KiCad/kicad-library/template/1593K_Enclosure/meta/1593K3B.jpg

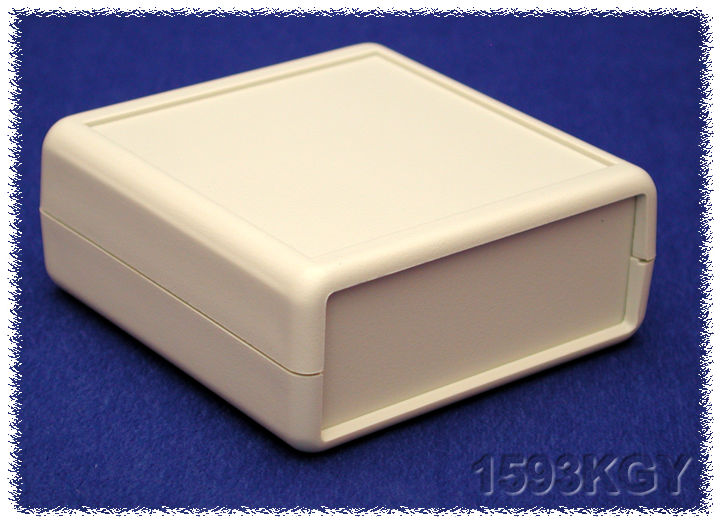
template/1593K_Enclosure/meta/1593K3B.jpg
