KiCad/kicad-library/template/raspberrrypi_hat/meta/brd.png

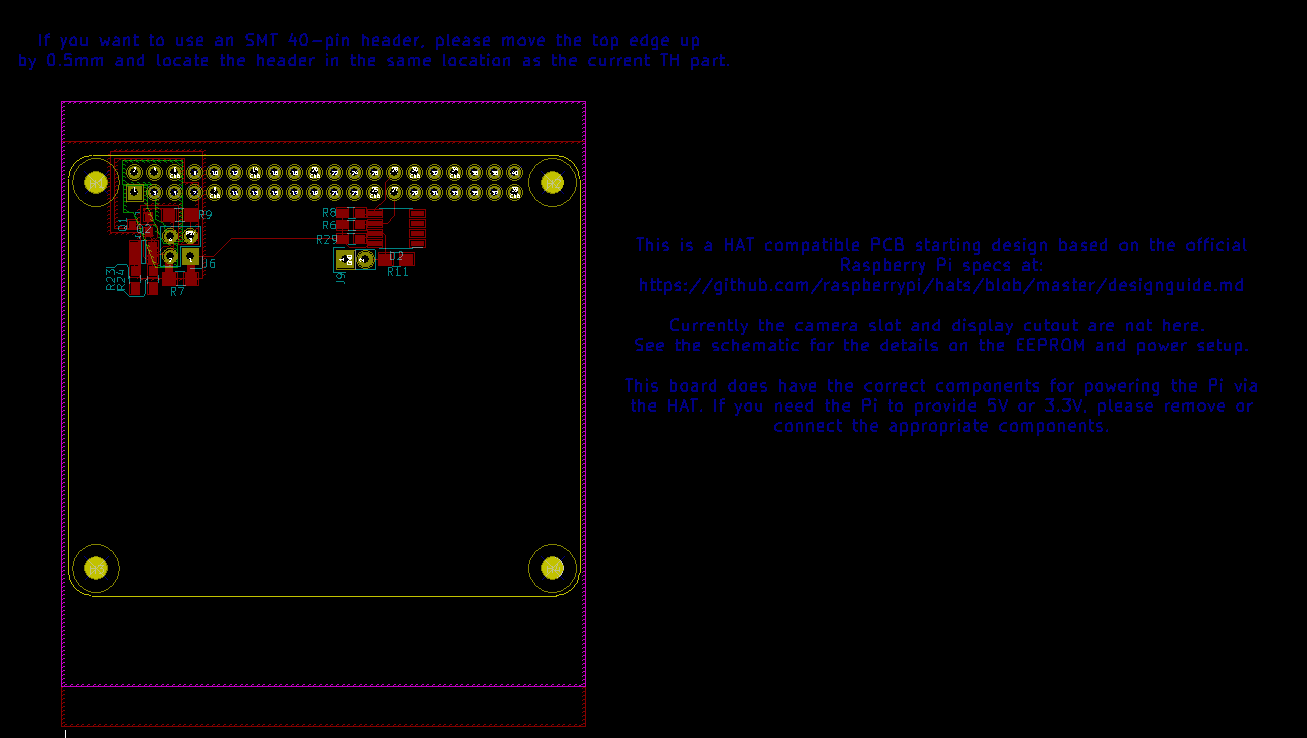
template/raspberrrypi_hat/meta/brd.png
