KiCad/kicad-library/(threads)

Thread 97 (2015-01-10):

Swap CP and CP2 symbol in device.lib

samdolt, 2015-01-10:
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
Currently, default symbol for polarized capacitor is the first symbol on the picture.

- This symbol don't have a "plus" sign and can mislead users.
- IEC60617 standard use the last symbol.

If accepted, I can make the change

reportingsjr, 2015-01-11:
I definitely agree that the first one "CP" should be swapped or even removed. I haven't ever seen that symbol for a polarized capacitor except in KiCad. I have definitely seen the second two quite a lot.

nickoe, 2015-01-11:
Indeed the CP one has always been strange to me, but who cares the others are there.

But in regard to these two pin symbols, they are way too big I think, not to forget that resistors and capacitors are not he same size. Resistors are 500 mil, whilst caps and diodes are 400 mil.

I did make some smaller ones that I used on some project, I can try to dig them up as examples.

samdolt, 2015-01-11:
Is someone uses the first version? If not, maybe it would be better to remove it.

And we can add smaller versions of common symbols such as Rsmall, Csmall, CPsmall.

michal777, 2015-01-11:
If I understood correctly rules 3.1, 3.2 and 3.3 minimum length of capacitor symbol is 400 mils !!!
So big symbols are useless :-(

nickoe, 2015-01-11:
Mmm, where do you see that? Maybe I am looing on the wrong wiki page, but I don't see the bullets numbered with the dot seperator.

https://github.com/KiCad/kicad-library/wiki/Kicad-Library-Convention

michal777, 2015-01-11:
https://github.com/KiCad/kicad-library/blob/master/KiCad_Library_Convention.txt
(3) General Rules for Symbols: 1, 2, 3.

nickoe, 2015-01-11:
Carl, can you comment on this? Could it be time to add an exception for "small" components?

reportingsjr, 2015-01-12:
I will have to say that I have my own library of capacitors, resistors, etc that are far smaller. The default ones are absolutely massive. I would like to hear Carl's opinion on this as well.

CarlPoirier, 2015-01-12:
I too would vote for removing CP.

As for the size of symbols, they indeed can't be smaller than 400mils if we follow the rules, as Michal found out. Maybe we could specify that some rule applies only to black-box components, and have another rule for discrete components?

michal777, 2015-01-12:
I totally agree. The rules 3.1 and 3.2 are good for most of integred circuits, but for resistors, capacitors, transistors etc 50 mil grid is much better.

nickoe, 2015-01-12:
Indeed, the question should then be what size. One should also consider
transistors and double diodes.
Den 12/01/2015 19.24 skrev "CarlPoirier" <notifications@github.com>:

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

samdolt, 2015-01-12:
I think 200 mils for resistances, capacitors and diode would be nice.

@nickoe and @reportingsjr  : What size do you use in your library?

@CarlPoirier : What the rules to ensure compatibility with old design? Can we just resize and commit the symbol with the same name?

CarlPoirier, 2015-01-12:
There is a cache created for the project, containing the parts used. There
is no obligation about resizing.

I like the size of csmall. I'll think about some rule formulation for it.

On Mon, Jan 12, 2015 at 2:14 PM, Samuel Dolt <notifications@github.com>
wrote:

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

CarlPoirier, 2015-01-13:
Here is my suggestion. (Taking care of #101 as well)

3.2. For black-box symbols, pins have a length of 100mil. Large pin numbers can be accomodated by incrementing the width in steps of 50mil.

This way, components with a distinctive shape are not included and might have various pin lengths, but they still have to follow rule 3.1. Resistors and capacitors can thus be 200mil long, such as "csmall".

samdolt, 2015-01-13:
I have made a pull request with some small symbole: https://github.com/KiCad/kicad-library/pull/104

inkblotter, 2015-01-16:
In the real world of kicad schematics parts are whatever size they need to be within that schematic, which may include schematics that have dozens of pages.   Depending on how ones setting for the schematic are, I have used capacitors as small as 40 mils.  Therefore it is silly to create libraries for any of these two pin devices.   A parts wizard should meadiate between those parts that can easily be generated and those fixed size parts that get pulled from libraries, standard or custom.   Ideally, kicad schematics and parts would be in svg and with adaptive pin pitches.  As for the immeadiate issue,  I would never use CP, as it looks like a charge pump to me.  Like others, I have seen CP1 and CP2  used frequently. I would depricate CP and remove it by and by.  I have a slight preference for CP1, being in the US. I associate CP2 with European usage. But either form should be in the 'standard' library, not withstanding my previous comments.

shaneburrell, 2015-03-05:
CP1 is likely the most used, at least in the US. I have only ever seen CP in KICAD and its been a long term annoyance.  CP2 is understandable as well but not what I've seen typically.

CarlPoirier, 2015-03-07:
CP has been eradicated now. Pick whichever of the two symbols left you prefer for your schematics!

Closed 2015-03-07.

Thread 109 (2015-01-24):

move 3d model from unused to relay through hole

andres53016, 2015-01-24:
This 3d models are in the folder unused_3d:
./Relay_ThroughHole_Packages.relay_Finder_34Point51Point7.wings
./Relay_ThroughHole_Packages.Relay_SPDS_OMRON-G6E.wrl
./Relay_ThroughHole_Packages.RELAY_SANYOU_SRD_Series_Form_C.wings
./Relay_ThroughHole_Packages.relay_Finder_34Point51.wrl
./Relay_ThroughHole_Packages.RELAY_SANYOU_SRD_Series_Form_C.wrl
./Relay_ThroughHole_Packages.Relay_SPDS_OMRON-G6E.wings
./Relay_ThroughHole_Packages.relay_Finder_34Point51.wings
./Relay_ThroughHole_Packages.relay_Finder_34Point51Point7.wrl
and the respective footprint are in https://github.com/KiCad/Relays_ThroughHole.pretty, how I can fix this.

michal777, 2015-01-24:
There was some broken links, eg. Relay_SANYOU_SRD_Series_Form_C.kicad_mod lost its 3d model with commit: https://github.com/KiCad/Relays_ThroughHole.pretty/commit/25d6fb88be865b4e6ba77ea21eaaa3cbeeb7eb7f

If you want to fix it, please move the 3d models to kicad-library/modules/packages3d/Relays_ThroughHole/ then rename these .wings/.wrl files to match names of footprints and add relative links to footprints in footprint editor (set proper scale, offset, rotation if necessary).

Before renaming 3d models it would be good to rename footprints (name and reference):
Relays->Relay; Relais->Relay; bistabil->bistable

andres53016, 2015-01-28:
thanks, I create the pull requests

CarlPoirier, 2015-02-15:
Corresponding pull request is #110

CarlPoirier, 2015-02-23:
This got fixed.

Closed 2015-02-23.

Thread 115 (2015-02-03):

3D Module Scaling Errors

stambaughw, 2015-02-03:
The following 3D models require scaling to fit properly on the board:

SMD_Packages/SOT-23-6.wrl
SMD_Packages/SOT-23-5.wrl
SMD_Packages/SOIC-14_N.wrl
Diodes_SMD/Diode-SMA_Standard.wrl

I'm sure there are others as well.  I think it's important for our user's that they not have to rescale the 3D models to fit their boards.

Thanks,

Wayne

CarlPoirier, 2015-02-03:
There is a similar issue on Github. I flagge these as well. No one had
gotten to it, but I'll try soon.

On Tue, Feb 3, 2015 at 5:00 PM, Wayne Stambaugh <notifications@github.com>
wrote:

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

stambaughw, 2015-02-03:
No hurry.  I just would like to have this cleaned up by the next stable
release which hopefully will be around the June/July time frame.

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

CarlPoirier, 2015-02-23:
Can someone double check SMD_Packages/SOIC-14_N and Diodes_SMD/Diode-SMA_Standard? Both seem fine on my end. I did fix the SOT-23*.

stambaughw, 2015-02-24:
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
Attached are screen shots of the attached 3d model.  One is scaled to
1/2.54cm and on is unscaled (1).  Both are incorrect AFAICT.  I just did
a git pull and reinstall yesterday unless I did something wrong.

keruseykaryu, 2015-02-24:
I didn't check that recently, but does this issue is still up to date for SOIC-14_N?
https://github.com/KiCad/kicad-library/issues/49

CarlPoirier, 2015-02-25:
I'm sorry Wayne but everything seems fine here. Github plugin activated, kicad-library on master. I don't see your screenshots, so let me upload one.

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

SOIC-14_N is alright as well.

stambaughw, 2015-02-25:
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
I just did a fresh clone using:

git clone https://github.com/KiCad/kicad-library.git

Then I changed the 3D package absolute path to point directly at
SMD_Packages/SOIC-14_N.wrl rather than using CMake to install and I
still get the same thing.  You haven't done a local checkout on your
branch and forgot to merge the changes into the master branch have you?
 Please send me a copy of your SOIC-14_N.wrl file so I can do a diff.

CarlPoirier, 2015-02-26:
No, I did a fresh clone as well! I don't understand either what's
happening. I'll send you the ,wrl and .kicad_mod files for the SOIC-14_N on
your personal email.

On Wed, Feb 25, 2015 at 11:58 AM, Wayne Stambaugh <notifications@github.com>
wrote:

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

CarlPoirier, 2015-03-02:
The issue has been confirmed to not exist anymore with the most recent revision of kicad-library and the latest footprints.

Closed 2015-03-02.

Thread 128 (2015-02-24):

Housing_DFN_QFN silkscreen looks strange

madworm, 2015-02-24:
Were these footprints machine created?

Especially with the smaller devices (e.g. DFN-10), the silkscreen looks really strange, pretty ugly, asymmetric...

madworm, 2015-02-24:
Wrong repo --> invalid.

Closed 2015-02-24.

Thread 135 (2015-03-05):

Author agrees to use his work

timofonic, 2015-03-05:
Hello.

I'm not sure if this is the best way to point to this, probably not.

The author of these libraries agreed to be merged to the official ones if there's license compatibility.

http://smisioto.no-ip.org/elettronica/kicad/kicad-en.htm

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

There's lots of KiCad libraries, but they are on different firms. I would love that KiCad can have a very complete library, but I know managing a big library and make people to merge can be a very difficult task.

Regards.

shaneburrell, 2015-03-05:
Is this going to happen? Anyone working on it?

michal777, 2015-03-05:
Some of the libraries are in official KiCad libraries (but 3d models could be upgraded), some of them can be added and others may conflict with our libraries (we don't want duplicates). It's a lot of work to add this content without creating much bigger mess than we have. If somebody will work on it probably the libraries or their parts will be added one by one, not all. Then they will require some corrections according to kicad library convention and to link 3d models properly.
I don't know if there is somebody working on it, probably not.

SchrodingersGat, 2015-11-09:
I have adapted a few of the footprints and models from his website to match KLC and such.

Terminal Blocks
A number of the terminal blocks have been added here:
https://github.com/KiCad/Terminal_Blocks.pretty
Pheonix PT
Pheonix MPT
Pheonix MKDS

Socket strips:
The 2.00mm pitch socket strips have been added to the Socket_Strips.pretty repo (pull request currently open)
https://github.com/KiCad/Socket_Strips.pretty/pull/4

Pin Headers:
Same as above:
https://github.com/KiCad/Pin_Headers.pretty/pull/10

Hirose DF13 connectors
https://github.com/SchrodingersGat/Connectors_Hirose.pretty
Note: This is at the moment just in my personal repo. I am happy for this to be used by github.com/KiCad/ freely

SchrodingersGat, 2015-11-09:
Oh and also, my JST library

https://github.com/SchrodingersGat/Connectors_JST.pretty

Same as above. Very happy for this to be integrated into master repo. Also happy to assist with KLC compliance as required.

pointhi, 2015-11-24:
For JST I want to say there is already a pull request for all JST PH and JST SH connectors, made by me: #296

SchrodingersGat, 2016-12-06:
Closing due to inactivity

Closed 2016-12-06.

Thread 155 (2015-03-18):

Diodes symbols

ricardocrudo, 2015-03-18:
I started to working in changing the diode symbols, as it was said here: https://github.com/KiCad/Diodes_SMD.pretty/pull/6
Now I have a doubt about the D_Schottky_x2_KCom and D_Schottky_x2_Serial diodes.
The current pinout for those symbols are, respectively:
A1,K,A2 <-> 1,2,3
A,AK,K <-> 1,2,3
But, I've used parts which have the following pinout:
A1,K,A2 <-> 1,3,2
A,AK,K <-> 1,3,2
My question is how to manage this, create new symbols with this alternative pinout? If so, how to name them?

Now talking about all diodes, i.e. regular diode, schottky, zener..., would be better use letters in the pin number field instead of numbers? In this way I think is possible to solve the pinout variations and prevent possible mistakes.

michal777, 2015-03-18:
Letters in pin numbers would break rule 6.8. AFAIK for general symbols there should be more symbols with different pin numbering. Look at transistors in device.lib ("Q_..."). 3-pin packages have their standard pin numbering so don't care about schematic symbols for them. 2-pin diodes should have pin 1 assigned to cathode. Then they will match standard numbering of DO-... packages and two pin TO-... packages (it seems that most of / all manufacturers use pin 1 of these packages as cathode).

CarlPoirier, 2015-03-22:
Exactly.

CarlPoirier, 2015-04-24:
Everything has been merged. @keruseykaryu, can you announce the change on the users group?

keruseykaryu, 2015-04-24:
Done.
https://groups.yahoo.com/neo/groups/kicad-users/conversations/messages/19990

CarlPoirier, 2015-04-24:
Thanks! I'm closing this issue now.

Closed 2015-04-24.

Thread 162 (2015-03-25):

Move 3D packages into .pretty repos

alexforencich, 2015-03-25:
Having the 3D packages and footprints in separate repos is a recipe for Bad Things.  It would be much easier to manage footprints and 3D packages if the footprints and corresponding packages are managed in the same repo.  Note that this will require modifications to how Kicad locates 3D packages - it must me modified to also search for the 3D package relative to the footprint file first.  This will also enable 'self-contained' footprint libraries with 3d packages to be used without being forced to use absolute paths or install them with the system kicad library.

CarlPoirier, 2015-03-26:
Hi,

There was a conversation about this subject a while ago. Have a read here:

https://lists.launchpad.net/kicad-developers/msg14793.html

Fat-Zer, 2015-05-17:
What about moving it out from the kicad-library repo?
IMO It doesn't make a lot of sense to store them nearby the schematic...

Bitbored, 2016-01-05:
I agree with this. I think it makes some sense to keep footprints and 3d packages together, since they are related most of the time (apart from some strange parts with a common footprint but a weird 3D shape).

I understand there might be good reasons to keep the 3D files and foortprints separate, but having the 3D files and symbols together in the same repo doesn't make a lot of sense.

Can we continue this discussion here, or is the mailing list or launchpad the preferred channel?

alexforencich, 2016-01-05:
There are a whole bunch of architectural issues in kicad that need to be fixed, and this is one of them.  Or at least related to it.  There is no search path for 3D packages right now, or at least the last time I checked.  Kicad only looks in one spot for the packages, this needs to be extended so that several locations are tried (e.g. same folder as the footprint in question).  Until this is fixed, the 3D packages cannot be moved.

reportingsjr, 2016-01-05:
I believe Cirilo Bernardo's work (
https://code.launchpad.net/~cirilo-bernardo/kicad/3d_initial_merge ) should
solve that issue Alex. Hopefully it will be merged in the next month or two.

On Tue, Jan 5, 2016 at 5:51 PM Alex Forencich <notifications@github.com>
wrote:

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

alexforencich, 2016-01-05:
Looking forward to it.  Kicad has a lot of promise, but also a lot of issues.

Shackmeister, 2017-06-13:
@alexforencich Hi Alex, a seperate packages3D repo has now been made and is on it's way to be supported in kicad directly. According to KLC $kisysmod3D is now being added to all footprints.
Can you please close this issue if its not relevant any more?

Shackmeister, 2017-07-01:
@alexforencich ill close this now, please let me know if you think it shouldn't be

seppestas, 2017-07-04:
Mmh, this issue states "move 3D packages into .pretty repos", not "move 3D packages in separate repo", so IMO the discussion is still open...

I understand moving the 3D packages in the .pretty repos requires a big architectural overhaul of KiCad's 3D model system and probably of the footprint system, but I think it still makes sense since the footprints reference the 3D models and typically footprints and 3D models are pretty related.

There are a lot of benefits in having the 3D models in a separate repo though. This could make it easier to override the 3D model for a footprint in different projects.

An example case: I have a design that uses [Neutrik NMJ4HCD2](http://www.neutrik.com/en/audio/plugs-and-jacks/m-series/nmj4hcd2) connectors. This connectors has the same footprint as the [Neutrik NMJ4HFD2](http://www.neutrik.com/en/audio/plugs-and-jacks/m-series/nmj4hfd2) connector but a different 3D model. It would be nice if KiCad would easily allow changing the 3D model without changing the 3D model so I can easily switch to using the NMJ4HFD2.

I have a few ideas on how this use-case could be supported:

- Enumerate compatible 3D files in the footprint and make the project/layout file store wich one should be used. Currently it is possible to list multiple 3D files per footprint, but KiCad combines them instead of giving the option to select one.
- Use a more generic name for the 3D file and change the path(s) to the location of the 3D files on a per-project basis (e.g by using an environmental variable in the 3D file path that can be set in the project). This is where having the 3D models in a separate repo makes sense.

poeschlr, 2017-07-04:
As far as i understand it, in future the number of repos will be reduced drastically. We will (hopefully) move away from the one repo per lib nonesense.
In such a case including the 3d files in the same repo as the footprints only makes sense if we also include the symbols and basically everything else into the same repo. (everything else would confuse users because they do not know how to find stuff.)
My vote would be on: One repo for symbols, one for footprints, one for 3d models, one for templates, ...

Issue https://github.com/KiCad/kicad-library/issues/1360 evolved into discussing exactly that.

seppestas, 2017-07-04:
Personally I prefer the multi-repo approach, I just think it misses some kind of automatic way to download / version pin the repositories. The current implementation of the Github downloader is fairly inconsistent and doesn't really work when using anything but the official KiCad libraries.

Having multiple smaller repo's allows to more easily fork the repo's you want to add custom stuff to while allowing you to keep using the original repos for other footprints.

I don't see why having the symbols in the same repo is a requirement for having the 3D files in the footprint repos. For my personal projects I typically don't even use the symbols anymore thanks to [SKiDL](https://github.com/xesscorp/skidl).

alexforencich, 2017-07-04:
Honestly, I don't really care where the 3D packages go.  It just makes no sense to keep them in the same repo as the symbols when the footprints are in their own repo, considering the 3D packages are referenced by the footprints and not the symbols.

And in terms of version pinning, that should be avoided entirely by switching to an Eagle like library format where the symbols and footprints are physically stored in the same file, eliminating the potential for any discrepancies between the footprints and symbols.

SchrodingersGat, 2017-07-04:
> And in terms of version pinning, that should be avoided entirely by switching to an Eagle like library format where the symbols and footprints are physically stored in the same file, eliminating the potential for any discrepancies between the footprints and symbols.

Whether or not this would be a good idea, this is not the way that the KiCad libraries work now or will work in the future. I don't think there's much sense trying to debate this in a post here.

> Mmh, this issue states "move 3D packages into .pretty repos", not "move 3D packages in separate repo", so IMO the discussion is still open...

The 3D models will only (in future) be located in the `packages3d` repository. This issue is definitely closed :)

poeschlr, 2017-07-05:
@seppestas wrote:
> Personally I prefer the multi-repo approach, I just think it misses some kind of automatic way to download / version pin the repositories.

Be a librarian for a week and tell us if you still like it ;)

shaise, 2017-07-29:
I really think seppestas request is extremely useful and reasonable. As others, I maintain a library of my own with footprints not available in the default library. Having the 3D models inside the pretty folder, makes it much easier when I want to share my library with others, or when I edit my project on a different PC.

Closed 2017-07-04.

Thread 163 (2015-03-25):

Library arduino

pouic13, 2015-03-25:
Hello evryone,<br> I made a library who contain most popular arduino board. It's contain .mod, .pretty, 3D views and shematics. It must be corrected but it exit.<br>You can download the full library on kicad forum URL: https://forum.kicad.info/t/library-for-shield-arduino/482 <br> Or on my blog URL: http://meta-blog.eklablog.com/kicad-librairie-arduino-pretty-p930786 <br> On my blog you have a prewiew that contain the library.<br>This is the first time i use github and i don't understan how it workd and to cap it all i'm french. So be indulgent :)

michal777, 2015-03-25:
In this thread:
https://forum.kicad.info/t/library-for-shield-arduino/482/8
I suggested creating issue because I don't know much about arduino and templates in kicad but I guess that it would be better to make templates based on this library and it should be discussed here.

keruseykaryu, 2015-03-26:
> (...) it would be better to make templates based on this library (...)
Exactly. Templates were designed just for that.
KiCad Manager manual gives the guidelines how to prepare complete template.

pouic13, 2015-03-26:
ok i'will watch how to creat a template.

keruseykaryu, 2015-03-26:
> But where i found " KiCad Manager manual " ?

Open KiCad and call Help -> Contents. Page 6.

pouic13, 2015-03-26:
I don't have file in Help. I use arch linux and i install paquet kicad-bzr and kicad-library-bzr. But in /usr/share/kicad/ i have only /demos, /library, /modules, /template and not /help or looks like help directory. Can I find it at an another place?

nickoe, 2015-03-26:
http://www.kicad-pcb.org/display/KICAD/KiCad+Documentation

pouic13, 2015-03-26:
Thank nickoe. <br>But just to be sure, i do made one template per one shield ?<br> so for my library: 7 for shield with no contour + 7 for shield with contour ?

michal777, 2015-03-26:
I'd suggest to create 7 templates, one for each shield. Contour should be drawn on Edge.Cuts layer as it is in template of shield for raspberry.

pouic13, 2015-03-26:
ok rooo f**k (sorry)

pouic13, 2015-03-30:
Hello, i start to redraw my library and i want to know, how i do orginise my project for summit a pullrequest? My lybrairie Template have got this structure: in file Template you have 7 directorys who each contain 1 complete board. i create a directory for modules who i use in template and i have an other directory for 3D view in relation whith modules. I keep this structure? or do I place directory "module" and "3D" in directory of "Template of each board" ?  An other question what size "edge.cuts" an "Dwgs.user" do have?

michal777, 2015-03-30:
> An other question what size "edge.cuts" an "Dwgs.user" do have?
There are no rules but I think 0.15 mm will be ok (the same as silkscreen).

You don't need to attach *.pretty footprints because they can be extracted from *.kicad_pcb (board).
You don't need to attach schematic library but there should be correct -cache.lib in project directory.
It's possible to use ${KIPRJMOD} to use 3d models existing in project directory. Example of path in *.kicad_pcb file:
```
    (model ${KIPRJMOD}/Socket_Arduino.3dshapes/Socket_header_Arduino_1x08.wrl

pouic13, 2015-03-30:
Thank micha777 it's work great for 3D views.
I place anyway *.pretty. I think it's good to keep a directory in template where you can change/place other footprint if they are propose do not correspond.
Ok know my first board is ready! i have correct edge cuts and meta are ok i'will try to summit a pull request...

CarlPoirier, 2015-04-24:
The templates for the Arduino boards made by @pouic13 have been merged.

giogziro95, 2017-05-25:
Hi, everyone.

Which library has this been added to? I can't find one. It's not available in my KiCad install either.

@jonathan-iap Thanks for your awesome work.

giogziro95, 2017-05-25:
Oh, [here they are](https://github.com/KiCad/kicad-library/tree/master/template).

Closed 2015-04-24.

Thread 169 (2015-04-01):

Missing SMD diode footprints

cb88, 2015-04-01:
Currently 1206, 1210, 805, 603, parts etc... are missing. Currently on my boards I just use a resistor footprint however this lacks polarity indication for manufacturing.

samdolt, 2015-04-01:
In SMD_Packages.pretty, you can find
* SMD-1206_Pol.kicad_mod
* SMD-1210_Pol.kicad_mod
* SMD-2010_Pol.kicad_mod
* SMD-2112_Pol.kicad_mod
* SMD-2512_Pol.kicad_mod
* SMD-4032.kicad_mod

0403, 0805 and 0603 seems to be missing.

samdolt, 2015-04-01:
@keruseykaryu I propose to delete these file and to put a copy in to Diodes_SMD and Capacitors_SMD with CP_* and D_* name. I think footprint filter in device.lib should be already correct, but it's better to verify.

I can handle that later this week if you're ok.

keruseykaryu, 2015-04-03:
> I propose to delete these file and to put a copy in to Diodes_SMD and Capacitors_SMD with CP_* and D_* name.

I think you should ask Carl or Michal. Footprint libraries isn't my major interest here.

samdolt, 2015-04-03:
@CarlPoirier What do you think?

michal777, 2015-04-03:
The SMD-****_Pol.kicad_mod can be moved if these polarised diodes and capacitors really exist.
Polarised tantalum capacitors are in separate library and they have different naming standard.
Diodes in this kind of packages are not popular (I found in some shop: 0603, 0805 and 1206, bigger diodes are usually SOD..., DO..., SM* etc).
What's more, they should be improved to meet kicad library convention and IPC-7351C.

cb88, 2015-04-03:
Diodes like this are useful for small boards and are always polar... Think Arduíno nano etc.....

Also on my boards I just standardized on 805 and 603 partes where i could as these are about as small of a discret component as I care to solder.

All my caps this size are ceramic so wouldn't matter.

michal777, 2015-04-03:
Are you sure the diodes aren't minimelf, micromelf or SOD...?

cb88, 2015-04-03:
Sure .... But that doesn't mean you can't get them in standard sizes. Plenty non melf or sod parts on digikey or Newark etc...

CarlPoirier, 2015-04-08:
A quick look on Digikey reveals zener diodes in 402, 503, 603, 805, 1005, 1206.

The packages can be moved and eliminated from SMD_Packages.pretty. One step closer to remove this to vague library!

Shackmeister, 2017-06-12:
@cb88 I believe this has been solved since, could you close this issue if you agree?

cb88, 2017-06-12:
Yes it appears that it has been resolved thought I am currently using a resistor + silkscreen polarity indication manually (tisk tisk) . As the standard sized SMD components now exist in Diodes_SMD.

Closed 2017-06-12.

Thread 172 (2015-04-09):

Part 74LS51 in 74xx.lib has wrong symbol and wrong pin assignment

onitake, 2015-04-09:
The circuit library 74xx.lib shipped with KiCAD contains an entry for the 74LS51 logic gate part. According to the respective data sheet, this part is wrong. Neither the gate symbol nor the pin assignment reflect the actual part.

74xx.lib shows the part as a dual 2x2 input AND/OR combined gate, while the 74LS51 contains one 3x2 and one 2x2 gate. Only the 7451 and 74S51 parts do not have the additional inputs. Also, the output pin of part B is number 8, not 9 as in the library.

Strictly speaking, part A and part B also swapped, but this has no functional relevance.

Texas Instruments offers a data sheet for this part here: http://www.ti.com/lit/ds/symlink/sn74ls51.pdf

I'm attaching a new version I just made for myself. Copyright notice: Anyone may use it under the same terms as the KiCAD libraries. Credit is not required. See the gist here: https://gist.github.com/onitake/a9a597a250e2ec580945

onitake, 2015-04-09:
EESchema-LIBRARY Version 2.3  Date: Thu 09 Apr 2015 02:01:50 CEST
#encoding utf-8
#
# 74LS51
#
DEF 74LS51 U 0 10 Y Y 2 F N
F0 "U" 200 250 60 H V C CNN
F1 "74LS51" 300 -250 60 H V C CNN
F2 "~" 0 0 60 H V C CNN
F3 "~" 0 0 60 H V C CNN
$FPLIST
 DIP-14*
$ENDFPLIST
DRAW
X GND 7 -50 -275 0 U 60 60 0 0 W N
X VCC 14 -50 275 0 D 60 60 0 0 W N
A -50 -150 125 -899 899 0 1 0 N -50 -275 -50 -25
A -50 150 125 -899 899 0 1 0 N -50 25 -50 275
A 75 0 146 -590 590 0 1 0 N 150 -125 150 125
A 170 -148 274 941 327 0 1 0 N 150 125 400 0
A 170 148 274 -941 -327 0 1 0 N 150 -125 400 0
P 4 0 1 0  -50 -25  -150 -25  -150 -275  -50 -275 N
P 4 0 1 0  -50 25  -150 25  -150 275  -50 275 N
P 4 0 1 0  75 -150  125 -150  125 -75  200 -75 N
P 4 0 1 0  75 150  125 150  125 75  200 75 N
X ~ 1 -450 250 300 R 50 50 1 1 I
X ~ 8 700 0 300 L 60 60 1 1 O I
X ~ 9 -450 -50 300 R 60 60 1 1 I
X ~ 10 -450 -150 300 R 60 60 1 1 I
X ~ 11 -450 -250 300 R 60 60 1 1 I
X ~ 12 -450 150 300 R 60 60 1 1 I
X ~ 13 -450 50 300 R 60 60 1 1 I
X ~ 2 -450 250 300 R 50 50 2 1 I
X ~ 3 -450 50 300 R 60 60 2 1 I
X ~ 4 -450 -50 300 R 60 60 2 1 I
X ~ 5 -450 -250 300 R 60 60 2 1 I
X ~ 6 700 0 300 L 60 60 2 1 O I
ENDDRAW
ENDDEF
#
#End Library

ricardocrudo, 2015-04-29:
@onitake I just commit a fix using your symbol plus small adjusts. Thanks for reporting.

The symbol is violating the KLC but I did commit because it's bug.

onitake, 2015-04-30:
I did not know about the [KLC](https://github.com/KiCad/kicad-library/wiki/Kicad-Library-Convention).

Thanks for pointing that out, I will try to follow it in the future.

felipesanches, 2016-06-28:
I also noticed this bug when looking for the 74LS50 which is missing in KiCAD. Should I report an issue about it separately?

Also, I'm using the stable debian kicad package in Trisquel GNU/Linux. In order to make my work easily accessible to users, I'm not willing to make my schematics only viewable with a git build of Kicad. To acchieve that, should I add the missing symbol as a custom library in my project's git repo?

felipesanches, 2016-06-28:
oh! I just noticed that the part I need is actually the 7451 instead of the 74LS51. The difference is that the 7451 does not have the third AND-input in the first combination of gates. The 7451 is still lacking in kicad libraries.

felipesanches, 2016-06-28:
My drawing of the 7451 is available at: https://gitlab.com/fsanches/PatinhoFeio_KICAD/tree/master/libs

diggit, 2016-07-06:
>Also, I'm using the stable debian kicad package in Trisquel GNU/Linux. In order to make my work easily accessible to users, I'm not willing to make my schematics only viewable with a git build of Kicad. To acchieve that, should I add the missing symbol as a custom library in my project's git repo?

Hi @felipesanches, once you add symbol to schematic, symbol is saved in cache. When symbol from source library becomes unavailable, KiCad tells you about it and switches to cached par AFAIKt. You can ship source library with project too...

Closed 2015-04-29.

Thread 173 (2015-04-09):

wrong 3d model

andres53016, 2015-04-09:
The 3d models Diode_LED_3mm_round_vertical and Diode_LED_5mm_round_vertical In kicad-library/modules/packages3d/Diodes_ThroughHole.3dshapes/ are DO-35 and the LED have own directory.
Can I delete this?
And replace the current 3d model for the mentioned in issue #135

CarlPoirier, 2015-04-19:
The 3d model path should be placed in a folder named the same as the pretty library. What do you mean by "the LED have own directory" ?

michal777, 2015-04-19:
@CarlPoirier
The 3d models assigned to the footprints are wrong (DO-35 instead of 5mm led) and the LEDs in Diodes_ThroughHole.pretty are duplicates of the leds that are in LEDs.pretty.
So I think it's good idea to remove the duplicates with wrong models.

CarlPoirier, 2015-04-19:
Aah I wasn't sure what he meant with the directory issue. Indeed, @andres53016, go ahead and we'll approve your pull request.

andres53016, 2015-04-20:
Hi I created #178 https://github.com/KiCad/LEDs.pretty/pull/4 https://github.com/KiCad/Diodes_ThroughHole.pretty/pull/7

CarlPoirier, 2015-05-02:
This issue is fixed. Thanks @andres53016.

Closed 2015-05-02.

Thread 176 (2015-04-15):

Discret:TO92DGS has pins ordered SGD

strykeroz, 2015-04-15:
Hi,

Please correct me if I'm wrong, but this appears to have D & S pins swapped.
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

Geoff

ricardocrudo, 2015-04-15:
Where does this footprint come from? Which .pretty directory?

strykeroz, 2015-04-15:
According to my library table, ${KIGITHUB}/Discret.pretty should be the source.
This is from a recent launchpad build, 2015-04-09 BZR5589

ricardocrudo, 2015-04-15:
It's named as DGS, since the square pin is the first, it seems right, though, it's violating some KLC rules.

michal777, 2015-04-15:
TO-92 packages that meet KiCad Library Convention rules are in: Housings_TO-92.pretty
This one is going to be removed (when somebody will find some time to sort out Discret.pretty).

strykeroz, 2015-04-15:
The schematic symbol for the BS170 MOSFET in the transistors library has pads D-G-S however all TO-92 packages in Housings_TO-92.pretty currently have pads 1-2-3.  Choosing any of those footprints results in no ratsnest to the BS170 footprint.

michal777, 2015-04-15:
This is because schematic symbol is also bad and should be improved to use standard numbering.

ricardocrudo, 2015-04-15:
The BS170 that I have here, from transistors lib, is numbered from 1 to 3. Did you install your libraries manually or from your distro repo (in the case that you are using linux)?

strykeroz, 2015-04-15:
Interesting.  This was a version made last week using the repo through kicad-winbuilder.  I'll update and report here if it changes.

ricardocrudo, 2015-04-15:
Is that kicad-winbuilder for libraries or the KiCad program?

strykeroz, 2015-04-15:
It downloads everything.  A search for transistors.lib only shows the instances in the source files it has downloaded and the KiCad directory tree it creates.  There are no other copies on this PC.  I will archive the KiCad build I used for the above, and rebuild.

strykeroz, 2015-04-15:
I archived the existing build to a 7z, deleted the directory and rebuilt.  No errors but the version number curiously remains the same.  As does the component in eeschema:
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

strykeroz, 2015-04-15:
Further, as expected, when importing .cmp into Pcbnew, the following errors:
*** Error: Component 'Q1' pad 'D' not found in footprint 'Housings_TO-92:TO-92_Molded_Wide_Oval' ***
*** Error: Component 'Q1' pad 'G' not found in footprint 'Housings_TO-92:TO-92_Molded_Wide_Oval' ***
*** Error: Component 'Q1' pad 'S' not found in footprint 'Housings_TO-92:TO-92_Molded_Wide_Oval' ***

ricardocrudo, 2015-04-15:
That's odd. Could you paste your netlist and cmp files at pastebin?

keruseykaryu, 2015-04-16:
@strykeroz: Please remove project library cache, reopen schematic, recreate netlist and pass through CvPcb again.

strykeroz, 2015-04-16:
@keruseykaryu you are correct.  This is now solved as being my project library cache issue.

Closed 2015-04-16.

Thread 179 (2015-04-22):

SOT-23 footprints in Diodes_SMD appear to have incorrect spacing.

stambaughw, 2015-04-22:
I was reviewing a board layout that I just did and noticed that the spacing between pins 1 and 2 is too narrow for footprints Diode_SOT23 and Diode_SOT23_handsoldering in the Diodes_SMD library.  The current spacing is 1.6mm but every document I could find specifies 1.9mm.  Both footprints should be reviewed for accuracy.

ricardocrudo, 2015-04-22:
Indeed. I can fix this in the pull request: KiCad/Diodes_SMD.pretty#6

ricardocrudo, 2015-04-22:
I just remember that SOT-23 is duplicated in KiCad/Housings_SOT-23_SOT-143_TSOT-6.pretty. This last one contain has the footprint with the correct values.

ricardocrudo, 2015-04-22:
@michal777 @CarlPoirier, which one should be removed?

stambaughw, 2015-04-22:
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

That's fine but we should probably remove the incorrect footprints for
the Diodes_SMD library.

stambaughw, 2015-04-22:
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

Diode_SOT23 and Diode_SOT23_Handsoldering should both be removed from
the Diodes_SMD library.

CarlPoirier, 2015-04-22:
Thanks Wayne for reporting this. Let's remove the footprints from
Diodes_SMD and keep the ones from Housings_SOT-23_SOT-143_TSOT-6.pretty.

On Wed, Apr 22, 2015 at 11:49 AM, Wayne Stambaugh <notifications@github.com>
wrote:

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

CarlPoirier, 2015-04-22:
Creating a _HandSoldering version from the correct footprint would be great
however. Else we lose that footprint.

Ricardo, I will approve your pull requests tonight.

On Wed, Apr 22, 2015 at 12:05 PM, Carl Poirier <carl.poirier.2@gmail.com>
wrote:

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

ricardocrudo, 2015-04-22:
@CarlPoirier Housings_SOT-23_SOT-143_TSOT-6.pretty has a _HandSoldering version to SOT-23 as well.

CarlPoirier, 2015-04-22:
Indeed, haha! All is well, then.

On Wed, Apr 22, 2015 at 12:12 PM, Ricardo Crudo <notifications@github.com>
wrote:

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

CarlPoirier, 2015-04-24:
The duplicates have been removed.

Closed 2015-04-24.

Thread 182 (2015-04-28):

Kicad schematic symbols for Pspice simulation

astroelectronica, 2015-04-28:
Hi team.

It's possible to perform pspice simulations with netlist file exported from Kicad and tools like LTspice for models and subcircuit, and Qucs just for models.

Conditions for simulation:
- Symbol is named like is labeled in simulation model file.

Sometimes label doesn't match with part number of manufacturer.

DI_DFLS230LH: Label in simulation model
DFLS230LH-7: Part number
- Pinout distribution matches with simulation model file.

Sometimes distribution doesn't match with package.

.SUBCKT MCP6001 1 2 3 4 5
               | | | | |
5               | | | | Output
4                | | | Negative Supply
3                | | Positive Supply
2                | Inverting Input
1                Non-inverting Input

MCP6001 (SC70-5, SOT-23-5)
1               | | | | Output
2               | | | Negative Supply
5               | | Positive Supply
4               | Inverting Input
3               Non-inverting Input

MCP6001U (SOT-23-5)
4               | | | | Output
2               | | | Negative Supply
5               | | Positive Supply
3               | Inverting Input
1               Non-inverting Input

Also, electrical parameters can be lost. In example, capacitor model doesn't show capacitance value.
- TDK P/N: C2012JB2A104M125AA (Multilayer Ceramic Chip Capacitor)
- Property: C=100nF
- Size(LxWxT): 2x1.25x1.25mm, 0.079x0.049x0.049inches
- Model Type: Simple Model
- Model Generated on Feb. 28, 2014

.SUBCKT C2012JB2A104M125AA_s 1 2

Other way to include electrical parameters to schematic symbols is writing directly in value field. In example of an inductor, these parameters are compatible with LTspice.

68u IPK=1.82 RSER=0.18318 RPAR=6405.6 CPAR=0 PN="MSS1038-683"

Conclusion:

It's necessary to have two schematic symbols for same part. One of them for simulation and other for pcb. For simulation, symbol name and pinout distribution must match with simulation model file.

Symbol name rules in Kicad Library Convention doesn't allow labeling schematic symbols like indicates simulation model.

Thanks.

Shackmeister, 2017-12-04:
@astroelectronica is this issue still relevant? Especially with the NGspice coming in V5

astroelectronica, 2018-01-09:
Hi.
I think this topic is still relevant because the distribution of pins in the package does not coincide with the distribution in the simulation model.
This is independent of the simulation tool used.
The components that have a subcircuit associated with it as a simulation model (.subckt), in the diagram corresponds the reference U ?.
Thus, all passives and semiconductors with complex models receive the same reference.
This is a problem to generate the bill of materials.
The solution is to create two schematic symbols for the same reference, and use one or the other if you are simulating or designing a PCB.
It could be interessting to make a topic on the forum.kicad.info because I think it's very important issue.
Thanks.

poeschlr, 2018-01-09:
Just a heads up, this repo will soon be declared legacy and it will therefore be archived. (This means all issues will be closed.)

So it might be a good idea to make a detailed writeup of the exact problem over at the new repo: https://github.com/KiCad/kicad-symbols

For me it does not seem like this does describe an issue of the library. So maybe this is more suited for the  documentation repo. Or for the FAQ over at the kicad forum.

astroelectronica, 2018-01-10:
Hi.

The pin distribution of the package does not match that of the simulation model.

Components with complex simulation models (.subckt) must have the U reference. This includes passives and semiconductors.

It is not possible to use the same symbol in a scheme for PCB and in another for simulation.

Take a look at my personal work. Specifically, the following repositories:

https://github.com/astroelectronica/AE003S002
https://github.com/astroelectronica/AE003F002

Thanks.

jkriege2, 2018-01-10:
So you propose to double those symbol with different pin-numberings and values?

Wouldn't it be better to (somehow) check in the models with the symbols, modified so it matches the symbols? Otherwise I fear people will get really confused ...

Also What about the symbols in https://github.com/KiCad/kicad-library/blob/master/library/pspice.lib? Are they more in line with what you want to do?

astroelectronica, 2018-01-10:
Hi.

Personally I do not recommend modifying the simulation models since they have been created and verified by the manufacturer.

The modification of the simulation model is not possible in those that are encrypted by the manufacturer.

If you use a symbol for simulation in a schema for PCB, this will be wrong.

If you use a symbol for PCB in a scheme for simulation, it will generate an error.

If you use a complex model (.sbckt) for a capacitor, in the diagram the capacitor has U as a reference, not C. In the same way as an inductor L, a mosfet Q, ... everything has reference U.

In a PCB a capacitor is C, an inductor is L and a mosfet is Q. In a scheme for simulation, every symbol with complex model or subcircuit (.subckt) has reference U. The list of materials created from this scheme does not It would be correct.

The solution may be to create those components that have discrepancies between the pin distribution in the package and in the simulation model.

Thanks.

poeschlr, 2018-01-10:
One thing is for sure. The symbols intended for pcb creation will keep the pin numbers as used in the manufacturers datasheets! (Or in the case of capacitors, diodes and other simple components: As suggested by IPC.)

I don't care if this means more work for guys who want to also simulate using kicad. But at this point in time the most important usecase for kicad is pcb design not simulation.

I don't have a problem if there is a separate lib just for simulating. But the symbols intended for the simulation stuff should not be mixed in to the other symbols.

astroelectronica, 2018-01-10:
I agree that PCB symbols should not be mixed with symbols for simulation. That is why I emphasize that it is not possible to use the same symbols for both simulation and PCB.

However, a component may have different encapsulations, with different pin distributions. The MCP6001 is a good example of this. A symbol is required for each version, MCP6001, MCP6001R, MCP6001U, .... and one more for simulation, if desired.

I do not think it's a problem to create and verify symbols for simulation schematics. It is necessary to specify that the symbol can not be used in schematics for PCBs.

The simulation allows to dimension the components that will be inserted in the PCB, select encapsulations of passive components, generate a previous list of materials, calculate track widths ...

evanshultz, 2018-01-12:
@astroelectronica
I'm not sure if any of the other librarians are familiar with SPICE, but I am. I've used it for a long time and I know intimately the issue you're bringing up.

However, as @poeschlr rightly points out above, KiCad is focused on PCB design and there is too much work on the PCB libraries right now to focus on this. I'd like to respectfully ask you to delay work on this until after version 5 of KiCad is released. At that time I'm quite interested into digging into this issue as well and finding out a good solution to propose to rest of the KiCad team. Are you OK with that?

pointhi, 2018-01-12:
@evanshultz I agree with delaying that work after release. It would be cool to have the normal symbols with simulation models attached (I don't see much sense in splitting that up). Probably a improvement to the data model needs to be proposed for the symbol file format change for KiCad 6 to support this use-case properly.

antoniovazquezblanco, 2018-01-12:
It would be lovely to have another repo with simulation models linked to symbols in the same way as footprints.
Mapping between physical pins and simulation model pins could be done in files in that repo.

astroelectronica, 2018-01-12:
The comments I have made here are not to immediately modify the library systems already established. But it should be clear that with a large number of components it is not possible to use the same symbol to design PCBs and also for simulation.

pointhi, 2018-01-12:
@astroelectronica I do not understand why both in one symbol should not be possible? There are EDA Packages out there (like [Proteus](https://www.labcenter.com/))which combine pcb and simulation symbol into once. This looks like a logical approach, and is also the type of support which has the lowest barrier for users.

With KiCad 6, the [kicad-symbols](https://github.com/KiCad/kicad-symbols) will be completly converted to a new file format. And I think that's the right time to build a file format which allows symbols with all features we likely need.

evanshultz, 2018-01-12:
@pointhi
Again, let's hold off until after v5. I know what what @astroelectronica is talking about it sounds like nobody else above does.

Briefly, it is because the external nodes of the SPICE model (symbol pins) are given in a fixed order in the SPICE model and cannot be redefined; the symbol may or may not pass the pins (and their nets) to the SPICE model in the required order. Different SPICE models may have a different external node order.

Other tools use their own simulation models or have another layer of abstraction between the symbol itself and the SPICE model. But this issue will best be shown once the librarian work for v5 is done and there's more time for a proper explanation and test case.

astroelectronica, 2018-01-13:
A component has associated one or more footprints, with one or several different distributions for the pins.

The simulation model file can have the same distribution of pins as the footprints or not. The file can have all the pins or not.

It may be that the footprints or the simulation model do not match. In that case, it is not possible to use the same symbol for PCB and for simulation.

poeschlr, 2018-01-13:
We try to limit symbols to only one footprint. (Even if the pin numbers would be the same.) This means we prefer fully specified symbols.

The reason for this is to remove one failure source.
There are exceptions to this rule. But these (generic) symbols will be limited to a few libs (device, connector_*, switch)

astroelectronica, 2018-01-13:
In my case I work directly with the manufacturer's serial number to avoid errors with components with several associated packages. Never with generics. But this is a personal way of working.

poeschlr, 2018-01-20:
I transferred this discussion over to the new repo to be able to archive this repo.
https://github.com/KiCad/kicad-symbols/issues/189

Closed 2018-01-20.

Thread 186 (2015-04-30):

Do you accept 3d model files other than wings and wrl?

hyOzd, 2015-04-30:
Do you accept Freecad or Blender as source format for 3d models? I have a couple models that I would like to contribute.

Also do you accept X3D instead of wrl? Asking this, because blender cannot export to wrl format and it seems kicad works fine with X3D.

michal777, 2015-04-30:
Some .wrl exported from blender can crash KiCad (older builds are less robust) so I think it's safer to import 3ds or obj from blender to wings and export to wrl.

hyOzd, 2015-04-30:
What about freecad? Since freecad is a parametric modeler, it can be useful to have a freecad source file around, I think.

Though, I must add; freecad's exporter features seems to be unstable. A couple days ago, I wasn't able to export a simple cylindrical shape to wrl. Maybe to play it safe, I should contribute Freecad+wings+wrl? But there is no clear path from freecad to wings. Only method I could find atm is this: Freecad export WRL -> Blender import WRL -> Blender export 3DS/OBJ -> Wings import 3DS/OBJ. Maybe I should forget about freecad :)

michal777, 2015-04-30:
Doesn't freecad export 3ds/obj that can be opened in wings? If it doesn't exporting freecad->blender->wing worked ok for me.

hyOzd, 2015-04-30:
Freecad can export OBJ. But color information is lost and some normals are wrong. Not really useful.

cbernardo, 2015-05-01:
Not to mention you may not have colors, and you definitely
won't have colors if you go from FreeCAD to wings then VRML.
There are my old VRML modeling tools which can be scripted:

http://kicad3dmodels.sourceforge.net/

 For very complex models it can take a lot of time to make
a good script, but I think for most models it's much quicker
than Wings3D (and much better) and maybe about the same as
FreeCAD in the time it takes to make a model.

- Cirilo
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

hyOzd, 2015-05-01:
Here is another method I use to move from freecad to wings.

- freecad: Export different colored parts as different mesh files (STL)
- blender: import mesh files
- blender: apply colors to different parts
- blender: export to X3D/3DS
- wings: import from 3DS

I use this method when freecad wrl exporter messes up. I think blender can be skipped if you know how to use wings.

But my original question was if I should add freecad files to repository?

s-light, 2015-05-03:
Thanks for asking this question hyOzd!
i also do most of my part-3D modells in Blender and or FreeCad.
i have written down a [workflow at the kicad.info forum] (https://forum.kicad.info/t/my-1st-3d-model-for-kicad/547/2?u=s_light) - this was written some time ago - so eventually with newer KiCad / FreeCad / Blender Versions things can be different...

i would like to see other source files in the KiCad repository..

hyOzd, 2015-05-03:
I think best part of using freecad is to be able to create parametric/scripted parts very easily.

[Here](https://dl.dropboxusercontent.com/u/62663835/smd_pin_header.fcstd) I have created a SMD Pin header model. And I have created a very simple macro-python script to change the number of pins. As you can see below; script will find array objects that I have labeled with a specific keyword and update the "repeat number". That's it. It's just a couple more lines to be able to generate whole range of 1-40 pin headers.

```python
import FreeCAD

doc = FreeCAD.activeDocument()

arrays = [a for a in doc.Objects if "paramX" in a.Label]

# change paramater
pX = 12

for a in arrays:
    a.NumberX = pX

# finalize
doc.recompute()
```

This version of the script should be run when FreeCAD document is open, from the macro dialog. It's also possible to code this as a standalone script, that will open the document, make the changes then save or export to a mesh format. But this may limit some functionality, such as accessing the color/material information of the object. Also there are some other non-destructive problems, such as object colors are not displayed correctly and visibility status of some the objects changes.

Currently I'm trying to figure out a way to reliably export FreeCAD objects to X3D. FreeCAD's VRML export is really messed up. It's exporting same shape multiple times including edges and points as separate objects. Don't know why.

s-light, 2015-05-04:
>  It's exporting same shape multiple times including edges and points as separate objects. Don't know why.

i noticed this behavior when i imported the FreeCad-exported files in blender..
if i remember correctly it consists of:
for every object:
--> as 'PointCloud'
--> as 'EdgeCloud'
--> as 'Surface'
and all three variants two times... (with no visible differences in Blender)
i have asked in the FreeCAD forum about this: http://forum.freecadweb.org/viewtopic.php?f=3&t=10815 next would be to ask also in the blender forum but i think one thing after the other..

Fat-Zer, 2015-05-17:
> Currently I'm trying to figure out a way to reliably export FreeCAD objects to X3D. FreeCAD's VRML export is really messed up. It's exporting same shape multiple times including edges and points as separate objects. Don't know why.

I've also run into that just yesterday making a [led display model](https://github.com/Fat-Zer/kicad-library/raw/CX56-12-3d/modules/packages3d/Displays_7-Segment.3dshapes/Cx56-12.fcstd) and advice on the FreeCAD forum seems to work: then copying everything to another document you get the clean wrl which is being read and displayed fine by the recent bzr kicad build.

CarlPoirier, 2015-05-17:
Would any of you volunteer for writing a simple step by step tutorial about
the process? We could put in in the wiki on Github.

On Sun, May 17, 2015 at 5:38 AM, Golubev Alexander <notifications@github.com
> wrote:

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

Fat-Zer, 2015-05-17:
They just commited a fix to FreeCAD vrml export module so now it works more straight forward... So now it seems it's enough just to export to wrl.

I've tried to produce some broken output that kicad won't handle correctly but I couldn't =) ...
On the other hand I'm not a vrml guru so I can't evaluate how much the output confirms to standards (or the kicad implementation either)...

CarlPoirier, 2015-05-25:
Woah that's nice to know!

michal777, 2015-06-03:
I don't know if wrl from freecad can be accepted, I think it will be better to ask developers
https://answers.launchpad.net/kicad

easyw, 2015-07-15:
Hi to all,

I've seen you model your 3D components in FreeCAD... That's great! :)
With the new daily build version of kicad it is possible to use directly VRML modules generated by FreeCAD and that would be available also in the up-coming new stable release.
I have done a script that takes the FreeCAD ability to export VRML and STEP formats to build a STEP version of the board with models, perfectly identical in displaying in kicad 3d-viewer and in FreeCAD or MCAD software. This should make enclosure design easier...
I called the script 'kicad StepUp' and it is available at sourceforge.net and launchpad.
Here it is possible to see the script in action:
http://youtu.be/Ukd47VXYzQU
a demo board with some models is also downloadable
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

I would like to make a repository of models created in FreeCAD with the corresponding STEP and VRML model...
If you would like to share your models, I'll be happy to add these to the 3D repo!!! :)

thank you for any suggestion and feedback,
Maurice

ricardocrudo, 2015-08-02:
Quote from @easyw

> Hi, would be possible to add also the STEP model exported from FreeCAD file Cx56-12.fcstd?
https://github.com/easyw/kicad-3d-models-in-freecad/raw/master/misc/Cx56-12.step
the STEP model is useful to be used with kicad stepup script
This script is aimed to give kicad the ability to have an identical view of board and modules in kicad 3d-viewer and in FreeCAD or MCAD software
it can be found from http://www.kicad-pcb.org/display/KICAD/External+Tools, kicadstepup
https://sourceforge.net/projects/kicadstepup/

Does someone comment on this? Maybe @CarlPoirier

easyw, 2015-08-03:
@ricardocrudo  thank you for posting it
@CarlPoirier
just few words to explain why I've done the kicad stepup script and why I'm asking to add FreeCAD model to the repo:
When you need to give your 3d artwork to MCAD people you have to use step as interchange format.
Any other format would not be accepted.
Before the script the only way I know to export the pcb with models was to export vrml and then convert it to step; but any model converted from vrml would be very un-optimal and not very useful for mechanical design... the conversion, using whatever sw you find, will generate a bunch of triangles.
If you search in the mailing list the problem is quite heavily discussed.
That's why I developed the script; you can design your pcb and check everything in kicad 3d-viewer and then export the model in step to use and share your mechanical design with the same appearance/dimensions in both environments.
To test the script in real world, I used hackrf-one board and I generated all 3d vrml modules to be used in kicad, directly from step modules downloaded from the manufacturers or from 3dcontent central library. All the modules were converted to wrl with freecad and displayed in kicad without any error or crash; so I would say that FreeCAD could be used as second source to model 3D object to kicad, side by side with wings3d. Moreover FreeCAD can create parametric model, with real dimensions as per the physical objects.
here there is a part of the discussion at the developers mailing list where the script has been posted:
http://www.mail-archive.com/kicad-developers@lists.launchpad.net/msg14131.html
the screenshots of the hackrf-one have been included at the kicad home page
http://www.kicad-pcb.org/display/KICAD/KiCad+EDA+Software+Suite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
http://www.kicad-pcb.org/display/KICAD/KiCad+EDA+Software+Suite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
Adding FreeCAD models (and eventually also STEP models) to the repo will help users to make enclosure design easier.
Regards
Maurice

CarlPoirier, 2015-08-04:
Hi,

This is very interesting. Would there be a way (some script?) to migrate all existing 3D models from KiCad to STEP automatically? I haven't played around with 3D modeling and KiCad so I'm not sure what is doable.

easyw, 2015-08-05:
Hi Carl,
unfortunately it is not possible to convert from Vrml to STEP nor from wings3D to STEP to obtain a usable MCAD model.
I know there is a huge amount of 3d models done with wings3d, but I would suggest to accept also model done in FreeCAD.
FreeCAD can export to VRML in a fully compatible format to be read by kicad.
FreeCAD can import STEP models and export to VRML.
FreeCAD can create parametric MCAD models to be fully aligned to the component datasheet

thank you
Maurice

CarlPoirier, 2015-08-05:
Do you think we can populate at least most component 3D models easily by hand?

cbernardo, 2015-08-06:
I think 3D models will remain a challenge; no doubt there are manypetabytes of models out there. There are many companies who willsell you access to their collection. However, more recently a numberof manufacturers have been providing 3D models in a number offormats which almost always include IGES and STEP.
Due to the huge number of models I think individual users should beresponsible for their own IGES or STEP models. We can provide a fewof the more common models though such as a variety of SMT resistors,SOT-xx DPAK-xx SOIC, QFN, DFN, TQFP. Since FreeCAD has fixed itsVRML export enough to be useful to KiCad, I think Maurice's sugestionto create VRML models from STEP or FreeCAD models is a good idea.
- Cirilo

      From: CarlPoirier <notifications@github.com>
 To: KiCad/kicad-library <kicad-library@noreply.github.com>
Cc: cbernardo <cirilo_bernardo@yahoo.com>
 Sent: Thursday, August 6, 2015 9:35 AM
 Subject: Re: [kicad-library] Do you accept 3d model files other than wings and wrl? (#186)

Do you think we can populate at least most component 3D models easily by hand?—
Reply to this email directly or view it on GitHub.

easyw, 2015-08-06:
@CarlPoirier
Hi, I'm not very used to FreeCAD, but I think that modeling 3D components in kicad would be easier than in Wings3D. I see there is sketcher, extruder, chamfer, fillet etc...
Moreover I see that @hyOzd has done some script to create parametric/scripted parts
here there is one of his models
https://dl.dropboxusercontent.com/u/62663835/smd_pin_header.fcstd
may be if he could be involved in the process, we could have a scripted/parametric library of 3D models.
I think that parametric way to produce models would be the answer to have a fully populated lib in short time...
Maybe if @hyOzd would model e.g. a SOIC8 model, with a parametric script it could be possible to have all the SOIC SSOP QFP SOT (Gullwings in general) 3D models in a flash!
That process would be replicated for Chip resistors, Chip capacitors, QFN, Tantalum capacitors etc.
Thank you
Maurice

hyOzd, 2015-08-06:
@easyw I was going to talk about this soon. Thanks for calling me out :)

Creating parametric files in FreeCAD, at least the way I did has some problems. First let me describe you my method:

1. I draw a part using FreeCAD, I use parametric features as much as possible. Such as 'array' tool from "Draft" workbench
2. I label some of those features (such as array tool) with a special syntax
3. Using a small script, I change the parameters of those specifically labelled features to my needs. For example I draw a 4 pin header leveraging the array tool, then I use a script to change all '4's to '8', and now I have a 8 pin header.

What's the problem? Well, FreeCAD is not smart enough. For example if I try to apply fillet to the top face of a cube, after I updated the size of cube, fillet may be broken. When the shape changes, FreeCAD cannot determine the correct face to apply the fillet. It doesn't have all the features to be a truly parametric modeller.

I see a couple solutions to this;

1. use only the tools that can be altered without side effects, avoid tools such as fillet
2. use FreeCAD's Python API to draw the shape from scratch. Can be hard to design a model this way, and it's harder to maintain
3. do the first option first, draw without problematic tools, then use pyhon APIs to add extra detail. I just don't like this idea. It's too complicated.

----

But I would like to present to you another alternative: [cadquery](https://github.com/dcowden/cadquery/)

> CadQuery is an intuitive, easy-to-use python based language for building parametric 3D CAD models

If you have heard of OpenSCAD, this is a similar tool. It's just that this one is a python library and has a syntax inspired by jQuery. At the moment, cadquery uses FreeCAD as its underlying 3D modelling engine. "In theory" it can do anything that FreeCAD is capable of.

I must say, designing a detailed part using cadquery is not very easy compared to a visual tool. But if you compare it to FreeCAD's python API it's a much saner option.

[Here](https://bitbucket.org/hyOzd/freecad-macros/src/e85defa66322bad7f2ef5df6fac17b5e94268eb8/make_pinheaders.py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) is a cadquery script that I have created to model all the pin headers ranging from 1 to 40 pins. You want 80 pins? No problem. It even uses parallel processes to reduce build time. Note that my script generates X3D mesh files. Cadquery supports STEP export, but I haven't tried that yet. I will try that as soon as possible.

I have more examples; [a qfp part generator](https://bitbucket.org/hyOzd/freecad-macros/src/e85defa66322bad7f2ef5df6fac17b5e94268eb8/make_qfp.py?at=master), [a DIP part generator](https://bitbucket.org/hyOzd/freecad-macros/src/e85defa66322bad7f2ef5df6fac17b5e94268eb8/make_dip.py?at=master) .

If you want to see the end results of these scripts right now, you can look at these blender files. Note that some of them are modified by hand just a little bit;

* [pinheaders.blend](https://bitbucket.org/hyOzd/pcb2blender-models/src/6f11d961ec0006f09d925a60d02bbf74aeb5093a/pinheaders.blend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)
* [dip.blend](https://bitbucket.org/hyOzd/pcb2blender-models/src/6f11d961ec0006f09d925a60d02bbf74aeb5093a/dip.blend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)
* [qfp.blend](https://bitbucket.org/hyOzd/pcb2blender-models/src/6f11d961ec0006f09d925a60d02bbf74aeb5093a/qfp.blend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)

Some notes/disclaimers:
* Although creating cadquery scripts can be hard at first, reuse rate can be really high. Especially in the case of plastic IC packages. For example the code that I've used to draw the plastic part of the DIP and QFP models is almost the same. It's not the same, just because I was lazy.
* cadquery is an experimental/under development software. It uses FreeCAD as its engine which is also under heavy development itself. But then again, KiCAD is not very stable either :)
* I haven't tested the STEP export. I'm not sure if it can handle multicolored parts.
* Cadquery doesn't have capability to export X3D. I use [my own X3D export script](https://bitbucket.org/hyOzd/freecad-macros/src/e85defa66322bad7f2ef5df6fac17b5e94268eb8/export_x3d.py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). This scripts generates a very pure output but it's not accepted by KiCAD although its valid X3D file. Can be easily fixed though.

I'm already on my way to creating more generator scripts. But I could use some help. Gathering the parameters for different variations, testing and making sure that all works without problems takes most of the time. I could use some help in that regards.

easyw, 2015-08-06:
@hyOzd Hi!
I see the problem in parametric modeling starting from a Draft manually made...

I think use FreeCAD's Python API to draw the shape from scratch would be very promising ...
adding parametric values to the script will build all the models
I know that could be quite complex at the begin, but it has strong potentials...
and also to see the macro in action, building the model should be nice :)
May be starting with chip capacitors would be the easiest...

I consider very promising also the cadquery option, providing you can export your model in STEP with colors...
then the model can be fused in single part and converted by FC to vrml, to be used in kicad, just with a simple external script
Unfortunately any other model (X3D or VRML) would not be useful for our mechanical purposes

Please let me know when you have exported some model to STEP, I will be happy to test them with the script
thank you
Maurice

easyw, 2015-08-06:
@hyOzd Hi again...
I've tried some scripting with cadquery and I think it would be the right choice...
If you can model e.g. chip capacitors (and I don't doubt as I've seen your qfp cadquery script) there are no problem in adding some trick to color parts and export them to STEP and to VRML (after scaling)

I've done a little cadquery script to test it ...
I modeled just a chip with body (no pins) following cadquery example and I add some code to add color and export the result in STEP and VRML
here the script
https://github.com/easyw/kicad-3d-models-in-freecad/raw/master/cadquery/cq-ex2.FCMacro
FreeCAD 0.15 and 'cadquery-freecad-module' v0.18 is required
(https://github.com/jmwright/cadquery-freecad-module/archive/v0.1.8.zip)
to run the script in Linux:
freecad cq-ex2.FCMacro
in windows:
C:\FreeCAD\bin\freecad cq-ex2.FCMacro
the 3D models obtained are aligned correctly to be used with the kicad stepup script, so to be used for MCAD exchange format / modeling and in kicad 3d-viewer
thank you
Maurice

easyw, 2015-08-09:
Hi @hyOzd @cbernardo @CarlPoirier
when I have been able to test the parametric script done by hyOzd, I see that the generating and conversion to STEP was just a step ahead ... :)
I discovered that to test the script I had to download also the CadQuery fork from hyOzd
Then I realized that the models where already generated with colors...
So I developed a script to fuse with colors, convert to STEP and scale and convert to VRML so to be ready to be used in kicad and with kicad StepUp script...
Now we have a start ... a repository of all QFP chips, generated with a parametric script!
Please have a try at:
https://github.com/easyw/kicad-3d-models-in-freecad/tree/master/cadquery/FCAD_script_generator
and at the first model generated:
https://github.com/easyw/kicad-3d-models-in-freecad/blob/master/cadquery/FCAD_script_generator/generated_qfp/qfp64_10x10_p05.step
https://github.com/easyw/kicad-3d-models-in-freecad/blob/master/cadquery/FCAD_script_generator/generated_qfp/qfp64_10x10_p05.wrl
https://github.com/easyw/kicad-3d-models-in-freecad/blob/master/cadquery/FCAD_script_generator/generated_qfp/qfp64_10x10_p05.FCStd

thank you a lot @hyOzd for your great work!
Maurice

easyw, 2015-08-11:
Hi @hyOzd again! :)
I've worked a bit on the qfp script and now it is possible to generate all Gull Wings ICs by the parametric script!
Your qfp script was done so well that adding the SSOP, TSSOP, SOIC etc models has been easy ...
I'm still using my libs to export to STEP wth colors and to VRML for kicad, but I'll keep an eye on your cadquery work, to switch to fully cadquery philosophy.
I adapted also the DIP an pinheader scripts to obtain all the models in STEP with colors.
I had to change slightly something with some models to avoiding malformed geometries generated sometimes by FC fusion ...
I would suggest you to add yourself (if you are not already) to the kicad developers mailing list
https://lists.launchpad.net/kicad-developers/
https://launchpad.net/~kicad-developers
you can get the edge of kicad trends from there ...
I'm going to post these comments also there, to ask if they may consider to add FreeCAD wrl models to the official repo.
Anyway, I would say that CadQuery is a GREAT tool for modeling 3D objects for kicad!
Thanx again and keep in touch
Maurice
here a TSSOP model recently generated
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

easyw, 2015-11-29:
@CarlPoirier @ricardocrudo
I have done a first 'STEP' in building a **3D MCAD repo** for kicad
The repo will contain 3D models designed preferably in FreeCAD, with STEP 1:1 and VRML 1:1/2.54  many of them will come from the parametric generator for FreeCAD that @hyOzd and me have done.
**Contributors are very welcome!**
The first 3D models are
       *Capacitors_Tantalum_SMD.3dshapes*
those **models have been done and named to be fully compatible with the kicad module library**
       *Capacitors_Tantalum_SMD.pretty*
I'm going to add more 3D models to help kicad users with a MCAD library to be able to export pcb and parts to mechanical environment, for ECAD/MCAD collaboration and enclosure design.
see the topic in the forum
https://forum.kicad.info/t/3d-new-library-for-mechanical-cad-exporting-and-enclosure-design/1763/
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

hyOzd, 2017-06-24:
I see that freecad files are accepted in this repository: https://github.com/KiCad/packages3D-source .

Closed 2017-06-24.

Thread 194 (2015-05-04):

DO-214AB 3D model scaling and orientation issue.

stambaughw, 2015-05-04:
The 3D model Diodes_SMD.3dshapes/Diode-DO-214AB.wrl is not scaled or oriented correctly (see image).  The scaling is off by 1/2.54 and the cathode band is rotated 80 degrees.

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

ricardocrudo, 2015-05-05:
It's ok to me.
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

stambaughw, 2015-05-05:
Do you have the 3D model scaling set to 1 in the footprint 3D model
settings?  I had to set it to 1/2.54 and rotate the Z axis 180 degrees
to get the model to fit the footprint.  I just did a git pull yesterday
so I'm assuming I have the latest version of the 3D model.

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

ricardocrudo, 2015-05-05:
No. scale set to 0.39 and z zaxis set to 180. Like here: https://github.com/KiCad/Diodes_SMD.pretty/blob/master/Diode-DO-214AB.kicad_mod

stambaughw, 2015-05-05:
I guess this is OK in the short term.  My preference is to have our
models scaled and oriented to our footprints.  I'm sure there are other
users with legacy DO-214AB footprints who will get surprised like I did.

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

michal777, 2015-05-05:
There are much more 3d models drawn in mm and scaled in kicad_mod file and it's not easy to scale all the wings and wrl.

stambaughw, 2015-05-05:
It would be nice if all of the 3D models had the proper scaling and
orientation but I guess we can live with it as long as the footprint 3D
settings are correct.

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

cbernardo, 2015-05-05:
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

In those cases there's a simple tool in my 3D model toolkit that can scale
a VRML model. However, the tool may need to be updated to handle VRML1.0
models which are still the most common VRML format created by MCADs. The
tool is also very primitive and designed to work with models accepted by
KiCad's VRML engine ~2 years ago, so it will work with Wings3D output but
it hasn't been tested with many models from other sources. Of course there
is the nuisance that the model maintainers have to set up another tool
and run a script to adjust some models.

- Cirilo

michal777, 2015-05-05:
Approximate scale of the problem (libraries sorted by number of footprints with "scale (xyz 0.39"):

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

michal777, 2015-05-05:
BTW why do we use inches? Will the scaling 0.1mils/unit stay forever?

cbernardo, 2015-05-05:
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

This is just history, but unfortunately changing this will break
everything. The real problem is that VRML has a "unit" and officially
it is meant to be 1m. What really happens is that different people/
software use data ranges convenient for their specific application -
this means that models in the wild have many scale factors and (a)
we have no control of this and (b) there is nothing in the VRML
specification which can tell us what scale is used. Even the VRML
exporter will produce output in 3 different scales and unfortunately
I didn't include a scale equal to the scale used by KiCad. (This
is not a problem though - I can eliminate the '1m' scale and use
'0.1in' instead.)

Anyway, I think 100mil/unit will indeed stay forever. These are just
numbers after all and as I said we need to scale models differently
depending on their source, so there is no good technical reason to
change so much code and change all existing VRML models just to
change the model unit.

- Cirilo

Shackmeister, 2017-06-12:
@stambaughw a properly scaled and aligned wrl file (with material properties) has been added in the repo, could you please consider closing this issue?

Shackmeister, 2017-07-01:
In case anybody is interested you can find the new model (step and WRL 2.0) PR here https://github.com/KiCad/packages3D/pull/49
Ill close this issue now, let me know if it should be reopened

Closed 2017-07-01.

Thread 196 (2015-05-08):

Resitor and capacitor symbols changed?

ondra6ak, 2015-05-08:
I've opend KiCad after a while of not using it and i've discovered, that symbols for resistor and capacitor are 1.27 mm shorter, therefore my schematic is borken...
Is there any explanation to that?

keruseykaryu, 2015-05-08:
=> https://github.com/KiCad/kicad-library/pull/104

ondra6ak, 2015-05-12:
OK
Why are there shorted symbols (compared to the rest of regular sized symbols) for resistor and unpolarized capacitor and at the same time R_small and C_small?

CarlPoirier, 2015-05-16:
Can you be more clear? Which parts are you talking about?

On Tue, May 12, 2015 at 3:29 PM, Ondra Sestak <notifications@github.com>
wrote:

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

ondra6ak, 2015-05-20:
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

This screenshot shows it clearly, i think.
C11 is shorter then the rest of regular sized symbols.
It is the same with regular R symbol.

samdolt, 2015-05-20:
Currently, we have two set of basic symbol, with two different length:

- Normal size ( R / CP / C / D )

- Small size ( R_Small / CP_Small / C_Small / D_Small )

This was a choice made in https://github.com/KiCad/kicad-library/pull/104 <https://github.com/KiCad/kicad-library/pull/104>

I think it’s useful to have this two size, because if you start a small project, bigger looks better. But in a project with
a lot of symbol in one sheet, smaller could be better.

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

ondra6ak, 2015-05-23:
Oh, it's problem with KiCad loading symbols from cache.
I agree that the symbols are now better.
Thank you.

CarlPoirier, 2015-05-25:
Glad to know you found the issue.

On Sat, May 23, 2015 at 4:40 AM, Ondra Sestak <notifications@github.com>
wrote:

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

Fat-Zer, 2015-05-26:
By the word, potentiometer symbol is left unchanged...

CarlPoirier, 2015-06-06:
Indeed! I do think it could be made to match the normal size resistor.

Closed 2015-07-25.

Thread 200 (2015-05-14):

Some common schematics for OpAmps

Fat-Zer, 2015-05-14:
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

Now the library contains a handful of different OpAmps images, some of them are not conform to current conventions. I understand that most of them exist by historical reasons, but IMHO now it looks like a huge mess...

I don't know what will be the best solution, but the most straightforward way I can think of is the slightly update the library format, some my ideas on it was listed [on the maillist on january](https://lists.launchpad.net/kicad-developers/msg16325.html). On the other hand this is the most tough way and it can break compatibility of older versions of kicad with newer libraries.

So I at least propose a minimum solution: to choose a "best" OpAmp image that conforms to the current conventions (may be include it as some generic device) and recommend to use it for new devices and may be update some older devices to new image.

How does it sounds for you?

ricardocrudo, 2015-05-14:
I think would be great have, always that possible, the same shape. But, I like of the idea to make it at once, and to minimize the troubles that this could raise, make an announcement to the users, as was done to diodes A/K change, could be a way. In this, any symbol that someone pick to start a new OpAmp would be OK. In short, I'm in favor to make the KiCad library KLC compliant as fast as possible.

CarlPoirier, 2015-05-16:
I vote for uniforming this as well.

On Thu, May 14, 2015 at 6:09 AM, Ricardo Crudo <notifications@github.com>
wrote:

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

Fat-Zer, 2015-05-21:
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
Here is schematic I propose. can be vied here: https://github.com/Fat-Zer/kicad-opAmp-test
Please review it before I start convert the library (unless there will be some other volunteers).
 - OpAmp — a general OpAmp. (pin numbers are random)
 - Comp — a single power only OpAmp with V- as Gnd.
 - OpAmp-x2 — a dual opAmp
 - OpAmp-x2-v2 — a second variant of dual OpAmp, I like it more. if there will be no objections I'll use it.
 - LM158 — a preview of real schematic of a dual OpAmp (nothing special in that case)
 - CA3130 ­— a preview of another real opAmp with additional outputs.
 - CA3130-v2 ­— the second version of the same. pros: have place for output names. cons: looks a bit worser IMO.

So... I'm looking forward to hear your opinion at least on the complicated opAmps schematic...

ricardocrudo, 2015-06-14:
I like them, except CA3130-v2.

tahiro86j, 2016-01-02:
So, it looks like I'm asking the (essentially) same question at #354 with hesitations of being a beginner in GitHub.

I would vote for this be done.

Now, most modern OpAmps/Dual-OpAmps/Quad-OpAmps indeed have near-identical pin-layouts, but I feel that the common-symbol to be created should mention "which type it follows". I cannot really name the very first OpAmp to have pin-layout of, say NE5532, but that product indeed was the rule-setter for this (I think it was one of the Raytheon products).

Like mentioned, avoiding confusions could be a challenge, I agree.

tahiro86j, 2016-01-02:
The commonly-known layout for dual-OpAmp in DIP-8 seems to have been introduced by Raytheon's RC4558 in 1970s'. Successors just copied the same pin-layout. (see: http://www.electronics.dit.ie/staff/mtully/741%20tutorial/741%20Op-Amp%20Tutorial.htm)
So, why not name it something like RC4558-style?

tahiro86j, 2016-01-03:
Also, to be addressed is the treatment of power-input pins for multi-OpAmp ICs. This, I am saying on behalf of this user who felt the same about this issue.
(Expressed and translated in https://twitter.com/tahiro86j/status/683504602059177984 ).

I once tried to use "TL072" in Eeschema and there I placed both A-unit and B-unit on the schematic. Because I didn't know they both had to be connected to the same power-line (instead of marking one of them as NC), there was no way but for me to also strongly feel that this should be fixed someday.

Could this also be considered. please?

CarlPoirier, 2016-01-17:
@Fat-Zer How is this going? Are you still planning on finishing this?

Fat-Zer, 2016-02-20:
Sorry, I haven't showed up for a while it reveals that most of work was done a while ago by Oliver Walters long time ago. Great thanks to him. =)
Currently there are only four slightly different images: CA3130, AD620, LM733CH and LM386.
Others got some smaller variations too like text field positions and outline width.

I'd like to fix the four currently different now... Don't know if I should touch others.

Closed 2017-09-15.

Thread 204 (2015-05-15):

Problem with pin name and numbers in some components of regul library

Calu85, 2015-05-15:
Using component 78L05 from regul library and footprint Housings_TO-92:TO-92_Inline_Narrow_Oval produces an error when pcbnew reads netlist. The error message is:

```
Error: Component 'U1' pad 'GND' not found in footprint 'Housings_TO-92:TO-92 Inline Narrow Oval
Error: Component 'U1' pad 'VI' not found in footprint 'Housings_TO-92:TO-92 Inline Narrow Oval
Error: Component 'U1' pad 'VO' not found in footprint 'Housings_TO-92:TO-92 Inline Narrow Oval
```

I think the problem is in the schematic component. For example, pin table of 78L05 shows both number and name fields have the same value, namely [VI, VI], [VO,VO] ,[GND,GND], instead of [1,VO],[2,GND],[3,VI].
I modified the schematic component to have number 1,2,3 in the numbers fields and it solved the problem.
Is this a problem in the library? I have searched a little and I have found some people with the same problem in older versions of kicad.
I could fix it and make a pull request, but first I'd prefer to be sure that this is a problem and not something I am doing wrong in pcbnew.
Many thanks.

keruseykaryu, 2015-05-15:
Yes, this is an issue that should be fixed. However I see the two different ways to solve this issue:

1. We fix the pin numbers for generic symbols of these linear regulators and leave them in `regul` library for _quite backward compatibility_. Of course this will not be the full compatibility, because we need to apply __KiCad Lib Convention__ (KLC) rules. So pin endings might/will be not at the same positions anymore.
2. We remove all these generic symbols, because we have many counterparts of 78L05 series regulators in this library: LM78L05ACZ, MC78L05AACP, which have correct pinning, link to datasheet, housing and are correct in terms of KLC, and might be used as template symbols for others.

I'm rather for this __second option__, even if this smash a few schematics (_We did already worse things_ :) ).

That is my position on this issue. Now I'm waiting for Yours, and other key librarians: Carl, Ricardo, Michał (_Sorry if I skipped someone_).

CarlPoirier, 2015-05-16:
I'd go for deleting them as well.

On Fri, May 15, 2015 at 11:08 AM, Kerusey Karyu <notifications@github.com>
wrote:

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

keruseykaryu, 2015-06-25:
The pins names issues will be fixed when https://github.com/KiCad/kicad-library/pull/223 pull request will be merged. The question about remove generic symbols still remains...

ricardocrudo, 2015-06-25:
I can take advantage and remove this symbols too. They are: 7805, 78L05, 7805MS, 7905, 79L05.
Any other else?

Removing them I'll have to convert some LM7*** alias to real symbols.

Shackmeister, 2017-07-01:
@Calu85 Hi can you please consider closing this issue if its not relevant any more?

Calu85, 2017-07-02:
OK. I hadn't noticed it was still opened.

gechxx, 2017-09-19:
Hi so what the resolution.Im still getting stuck on check not accepting the 7805

poeschlr, 2017-09-19:
You might want to give more details here. I have no clue what you are talking about.

jkriege2, 2017-09-20:
Please also note that regul.lib received a complete workover (see  https://github.com/KiCad/kicad-library/pull/948) Maybe that fixes your problems (i.e. update your libs and try to exchange your symbols for new ones ...)

Best,
JAN

Closed 2017-07-02.

Thread 206 (2015-05-17):

Encoder

Fat-Zer, 2015-05-17:
I want to add encoder to the component library. And I have some questions:
- What image to use?
  I've prepared some variants in the test project: https://github.com/Fat-Zer/kicad-encoder-test
  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
  Notes about the variants:
  5 — from walter's library, see #135. Got some problems: pins are placed on 50mil and have uncommon sizes
  3 — an attempt to fix 5 according to the KLC
  4 — have pins ends placed on a 50mil grid nodes along X axis.
- What should be the pin order? ABC or ACB?
  The ABC is more straightforward in the schematic sense, but most of real encoders have ACB pin order.

Watching forward to hear your opinion on this issue...

ricardocrudo, 2015-05-17:
These days I did an encoder too. This one: https://www.bourns.com/data/global/pdfs/PEC11R.pdf
I did the version with switch, it looks like this:
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

ricardocrudo, 2015-05-19:
> What should be the pin order? ABC or ACB?
The C stands for common and it is the pin 2 in the encoders devices, thus the right is ACB.

ricardocrudo, 2015-05-19:
Taking advantage of this question, which library sounds better to save the this rotary encoders? sensors? And what about the pretty repo, I think there aren't one which fits good to them. What do you think?

Fat-Zer, 2015-05-19:
>The C stands for common and it is the pin 2 in the encoders devices, thus the right is ACB.

Mostly but not always. e.g. [PEC16 encoder](http://www.bourns.com/data/global/pdfs/pec16.pdf) have ABC pin layout. So as a generic device I think we should have both variants in the schematic lib (as for transistors) and pins in footprints should be numbered as usual...

>Taking advantage of this question, which library sounds better to save the this rotary encoders? sensors? And what about the pretty repo, I think there aren't one which fits good to them. What do you think?
I was gonna to add schematic to device library as a quite generic input device... I'm not sure what footprint lib to use... If we could create at least 5 footprints on staging level it make sense to create a separate library.

ricardocrudo, 2015-05-20:
> Mostly but not always. e.g. PEC16 encoder have ABC pin layout. So as a generic device I think we should have both variants in the schematic lib (as for transistors) and pins in footprints should be numbered as usual...

hmm, I see, so, yes, the variants sounds a good way.

@Fat-Zer will you create symbols to encoders with switch as well? If so, how would you represent it in your symbols? I think would be great if we had an unique style, avoiding mutations as happened with OpAmps (#200).

Fat-Zer, 2015-05-21:
>@Fat-Zer will you create symbols to encoders with switch as well?
Sure... but I want to determine what will be the general schematic first, to not draw a key for every variant that will be dropped anyway.

Also there will be also an option: to draw the key as a separate elements like in multi part component or as a part of an object.

SchrodingersGat, 2016-04-28:
@Fat-Zer did you end up making a symbol for the encoder? I was going to make one but did a quick search and found this discussion. Was there any conclusion here? I really like the symbol that @ricardocrudo  drew as above.

Fat-Zer, 2016-04-28:
nope, I haven't done anything about that since the time of discussion... you may continue this yourself if you wish...

SchrodingersGat, 2016-05-22:
for reference https://github.com/KiCad/kicad-library/pull/541

Fat-Zer, 2016-06-20:
Due to the PR is merged, I suppose the bug may be closed...

SchrodingersGat, 2016-06-20:
Check out https://github.com/KiCad/kicad-library/pull/575

The original PR (now closed ) had some issues so I've opened a new one.

Fat-Zer, 2016-06-20:
By the word, do you have in plans add a footprint for at least one encoder model?
/No pressure/ just wondering...

SchrodingersGat, 2016-06-20:
Just the symbol for the moment.

diggit, 2016-07-09:
#575 merged, only ACB variant with and without switch for now. Anyone can open PR with others.

SchrodingersGat, 2017-01-21:
Closing as this has been addressed.

Closed 2017-01-21.

Thread 219 (2015-06-11):

Issue in Gnd component

GauravSupal, 2015-06-11:
In new kicad version(2014 build), after creating netlist using net numbers, the gnd component is not assigning 0 node, it is considering any random value. Due to this I am facing problem in ngspice simulation. Can you please help me out.

astroelectronica, 2015-06-11:
Hi!

For simulation you must include pspice.lib and use 0 symbol for ground reference.

I think 0 symbol must be removed from pspice.lib and relocated to power.lib, but it just a personal opinion.

Remember to connect 0 line to pwr_flag symbol.

Cheers!

fahim-oscad, 2015-06-12:
Hi,

I think there is change in kicad algorithm for ground component  as earlier ground was automatically taken as 0 but now the ground is taking random number.

Is there any way to fix the ground to 0 in current stable version ?

Shackmeister, 2017-07-19:
@gauravSupal is this still relevant? If not can you please consider closing this issue? :)

Closed 2017-08-23.

Thread 257 (2015-07-26):

pretty repositories reorganization

ricardocrudo, 2015-07-26:
Michal's proposal extension to all pretty repositories, check: KiCad/TO_SOT_Packages_SMD.pretty#1

Check suggestions in this [google doc spreadsheet](https://docs.google.com/spreadsheets/d/1TyG5NIXKp4mAiopfSrS0jej7GOXvJdE5Fq5kQdaQh74/edit?usp=sharing)

michal777, 2015-07-26:
I like it! If everybody agree that it's time to make big changes I'm ready to help. I think that the first thing to do is to remove whatever can be removed.

I've also some suggestions/questions/ideas about the table:

Air_Coils_SML_NEOSID.pretty - ok, alternatively may be moved to Inductors_NEOSID.pretty (if will be left)

Capacitors_Elko_ThroughHole.pretty - action 1 is done, this library can be removed (maybe "universal" footprints should be saved).

All Chokes and Inductors - it may be hard to sort them in a wise way because often the same element may be used as choke or not-choke. Inductors is more general name. "Toroids" may be chokes, inductors or transformers.

All four libraries with crystals and oscillators - I'd suggest creating: Crystals.pretty and Oscillators.pretty (without SMD/THT because there is not much content yet)

Displays LCD and LED - I like it but if somebody will add some different type of display there will be problem to classify them. Graphics/7-segm is also bad. Maybe this needs to be discussed. Simplest solution: Displays.pretty

EuroBoard_Outline.pretty - if nobody can prove it's really useful I'm for removing.

Hall-Effect_Transducers_LEM.pretty and PFF_PSF_PSS_Leadforms.pretty - go to new Hall-Effect_Transducers.pretty, it seems to be the same type of current sensing devices

Resistors_Universal.pretty - as was discussed: rename to Universal.pretty and put here more different universal footprints

Oddities.pretty, Wire_Pads.pretty, Wire_Connections_Bridges.pretty - maybe put them into one library, then remove some of footprints or maybe remove at least one library.

Opto-Devices.pretty - I think it should be left

Sockets_BNC.pretty - rename to RF_Connectors to be more general or maybe even "signal_connectors" (maybe needs better name) to include also audio connectors, or "coaxial_connectors" (quite wide class of "analog" connectors)?

Sockets_PGA.pretty - this footprint is in another library so this one should be deleted

Transistors_SMD.pretty - same as Transistors_TO-220.pretty and others (move to TO_SOT_Packages_*)

Socket_Strips.pretty and Pin_Headers.pretty has different 3d models and (in some cases) different pin numbering. I think they can be left as is or put into one library. I'm not sure if adding _THT is necessary. We haven't even smd footprints of this type.

Transistors_OldSowjetAera.pretty,  - some new library for rarely used, hard to classify footprints would be usefull but I've no idea how to name it.

Power_Packages_* - to be removed if all my pull requests will be merged.

ricardocrudo, 2015-08-08:
I moved the table to google doc to keep easy to update. @michal777 I applied some changes you suggested and left some to solve/to discuss.

They are:

* all choke repos

move all to chokes.pretty or inductors.pretty ?

* Converters_DCDC_ACDC.pretty

left as is?

* Filters_HF_Coils_NEOSID.pretty

move to inductors.pretty?

* Housings_ROHM.pretty

move to ...?

* IR-DirectFETs.pretty

left as is?

* Labels.pretty, Symbols.pretty

left as is or or move to only one repo?

* Measurement_Points.pretty, Measurement_Scales.pretty

left as is or or move to only one repo?

* Socket_Strips.pretty, Sockets.pretty, Sockets_BNC.pretty, Sockets_Mini-Universal.pretty, Sockets_WAGO734.pretty

move all to sockets.pretty ? move to connectors?

* Terminal_Blocks.pretty

move to sockets.pretty ? move to connectors? left as is?

* Transistors_OldSowjetAera.pretty

move to ...?

* Oddities.pretty, Wire_Connections_Bridges.pretty, Wire_Connections_Bridges.pretty

left as is or or move to only one repo? if one, which name?

michal777, 2015-08-15:
Next post to discussion:

- all choke repos
I'd start with creating Inductors_SMD and Inductors_THT and sorting Inductors, Inductors_NEOSID Choke_SMD.pretty;
Choke_Toroid_ThroughHole - there are inductors and transformers inside so should be either renamed or sorted into inductors, chokes (if will exist) and some transformers library;
Choke_Common-Mode_Wurth.pretty - I'd remove _Wurth from name - Wurth is in footprints names
Air_Coils_SML_NEOSID - I'd remove _SML_NEOSID from name - SML and NEOSID are in footprints names
Choke_Axial_ThroughHole, Choke_Radial_ThroughHole, some of Choke_SMD - I've no idea, it's hard to decide which inductors are chokes, it depends of application

- Converters_DCDC_ACDC.pretty
I'd leave it

- Filters_HF_Coils_NEOSID.pretty
filters can't go to inductors, if they all are variable maybe can be renamed to filters_inductors_variable

- Housings_ROHM.pretty
it's in SMD_Packages, waits for removing

- IR-DirectFETs.pretty
I'd leave it or rename to power_mosfets_smd to cover more types of these special high power packages

- Labels.pretty, Symbols.pretty
I'd add Measurement_Scales.pretty and put everything in one repo for the graphics items

- Measurement_Points.pretty, Measurement_Scales.pretty
to other libraries

- Socket_Strips.pretty, Sockets.pretty, Sockets_BNC.pretty, Sockets_Mini-Universal.pretty, Sockets_WAGO734.pretty
If you mix everything the library will be very large;
the Socket_Strips.pretty and Pin_Headers may be together,
Sockets.pretty may be left (maybe renamed) for IC and memory sockets (not cables)
Sockets_BNC.pretty - as I mentioned before - make library for rf or rf+audio connectors

- Terminal_Blocks.pretty
I'd leave it

- Transistors_OldSowjetAera.pretty
some new library for packages that are not easy to classify - I don't know how to name it

- Oddities.pretty, Wire_Connections_Bridges.pretty, Wire_Connections_Bridges.pretty (Wire_Pads?)
I'd add Measurement_Points.pretty and put everything into one repo for pads and bridges

michal777, 2015-08-16:
I've looked into the mess in connectors and sockets. There are following libraries:
- Connect - includes many types of connectors
- Connectors_Molex - two types of connectors (wire to board)
- Mechanical_Sockets - two or three DIN and two non-electrical components
- Socket_Strips - mostly 2.54 mm
- Pin_Headers - mostly 2.54 mm
- Sockets - IC and memory sockets
- Sockets_BNC - only two BNC
- Sockets_Mini-Universal - one type of connectors (wire to board)
- Sockets_MOLEX_KK-System - one type of connectors (wire to board)
- Sockets_WAGO734 - one type of connectors (wire to board)
- Terminal_Blocks - two types of terminal blocks

So maybe:
- Connect -> Connectors - needs cleanup, sockets and terminal blocks to proper libraries
- Connectors_Molex - leave as is
- Mechanical_Sockets - move to Connectors, non-electrical parts should be put somewhere else
- Socket_Strips -> Connectors_Pin_Socket_Strips - allow only these simple 2.54, 2.00 mm
- Pin_Headers - to Connectors_Pin_Socket_Strips, allow only these simple 2.54, 2.00 mm
- Sockets - it's ok, needs small cleanup
- Sockets_BNC - move to Connectors or make library for rf or rf/audio or sth like that
- Sockets_Mini-Universal -> Connectors_Mini-Universal
- Sockets_MOLEX_KK-System -> Connectors_MOLEX_KK-System
- Sockets_WAGO734 - > Connectors_WAGO734
- Terminal_Blocks -> Connectors_Terminal_Blocks

This way all libraries, apart from Sockets, will start with "Connectors_" and will be together on a alphabetically sorted list of footprints.

aewallin, 2015-12-28:
It seems the libraries have been reorganized on github, but the fp-lib-table.for-github file has not been updated!?
This is causing a LOT of confusion as seen now on multiple kicad forums/help-channels. Please could you update fp-lib-table so that it doesn't point to non-existing libraries.
AFAIK this affects the 4.0.0 and 4.0.1 releases and is not a pleasant surprise for non-expert users!
thanks!

michal777, 2015-12-28:
The problem is that bleeding edge users uses fp-lib-table installed with some unstable release instead of their own libraries (off-line or personal github).

ricardocrudo, 2016-01-04:
I'd like to start doing some changes. Renaming the following repositories:

Buttons_Switches_ThroughHole.pretty -> Buttons_Switches_THT.pretty
Capacitors_ThroughHole.pretty -> Capacitors_THT.pretty
Connect.pretty	 -> Connectors.pretty
Diodes_ThroughHole.pretty  ->  Diodes_THT.pretty
Display.pretty -> Displays.pretty
Relays_ThroughHole.pretty -> Relays_THT.pretty
Resistors_ThroughHole.pretty -> Resistors_THT.pretty
Sockets_Mini-Universal.pretty	-> Connectors_Mini-Universal.pretty
Sockets_WAGO734.pretty -> Connectors_WAGO734.pretty
Terminal_Blocks.pretty -> Connectors_Terminal_Blocks.pretty

@michal777 and @CarlPoirier can I do this changes now?

michal777, 2016-01-06:
Because of the f#^&@!* kicad github online libraries, removing libraries will cause error messages which are confusing for beginners who suffer from the github fp-lib-table installed by default with some packages/installers of the kicad.
To avoid the problems the old libraries probably must be kept but they may be filled with some placeholder like footprint with a message: "empty library, please remove it from your fp-lib-table" or something like that.

pointhi, 2016-02-19:
I would link my proposal for connectors cleanup: https://github.com/KiCad/kicad-library/issues/368#issuecomment-185922616

In a nutshell, moving some ```Sockets_xxx.pretty``` to vendor specific ```Connectors_xxx.pretty``` and renaming the footprints in a scheme like ```Manufacture_Series_xxx.kicad_mod```. So we have only one connector library per manufacture, and the connectors are sorted by series inside it.

CarlPoirier, 2016-02-20:
OK so to put it all together:

Buttons_Switches_ThroughHole.pretty -> Buttons_Switches_THT.pretty
Capacitors_ThroughHole.pretty -> Capacitors_THT.pretty
Connect.pretty -> Connectors.pretty
Diodes_ThroughHole.pretty -> Diodes_THT.pretty
Display.pretty -> Displays.pretty
Relays_ThroughHole.pretty -> Relays_THT.pretty
Resistors_ThroughHole.pretty -> Resistors_THT.pretty
Sockets_Mini-Universal.pretty -> Connectors_Mini-Universal.pretty
Terminal_Blocks.pretty -> Connectors_Terminal_Blocks.pretty
Sockets_BNC.pretty -> Connectors_TE-Connectivity.pretty (KiCad/Sockets_BNC.pretty#1)
Sockets_WAGO734.pretty -> Connectors_WAGO.pretty (KiCad/Sockets_WAGO734.pretty#1)
Sockets_MOLEX_KK-System.pretty -> Connectors_Molex.pretty (KiCad/Sockets_MOLEX_KK-System.pretty#1)
part of Terminal_Blocks.pretty -> Connectors_WAGO.pretty (KiCad/Terminal_Blocks.pretty#6)
part of Terminal_Blocks.pretty -> Connectors_Phoenix.pretty (KiCad/Terminal_Blocks.pretty#6)

A copy of the libraries to be renamed need to be kept in their original state as well for people using fp-lib-table.for-github but not knowing how it works.

pointhi, 2016-02-20:
@CarlPoirier

* Terminal_Blocks.pretty -> Connectors_Terminal_Blocks.pretty is not required

CarlPoirier, 2016-02-20:
Indeed, no more Terminal_Blocks. As for the TO-SOT, I don't see any benefit of renaming them. Furthermore they are new libraries. SMD_Packages is meant to disappear but we never got to it completely yet! I'm not sure about Wire_Pads.

anpaza, 2016-05-03:
One more thing to do is to sort out the path to .3dshapes somehow.

Currently the only place where .3dshapes are found is /usr/share/kicad/modules/packages3d.

It would be good to have something like ${KIPRJMOD} (KIPRJ3DMOD?) but for 3D files, so that projects can use their private .3dshape files. Currently I have to make a link to them to /usr/share/... and this is horrible.

And in general, the .wings files should be excluded from the KiCad distribution. They should be available from the kicad-library repo, just like the .kicad_pcb files with footprints. This Wings3D software is cumbersome and there are little people that can use it, so why copy it to every KiCad user's HDD?

SchrodingersGat, 2016-05-22:
@anpaza  et al, I think that the 3D files should each have their own repository (e.g. Housings_SSOP.3dshapes becomes a repository). Each .pretty repo gets a matching .3dshapes repo. I think this is a good solution for a few reasons:

* It does not clutter up the .pretty repositories with mixed file types
* It gets the 3D models out of the schematic library (strange that they were ever there...)
* It allows users to pick-and-choose which 3D models they want. Unlike .lib and .kicad_mod files which are tiny, the 3D shapes repository could grow to be very large, and users may want greater fidelity in deciding which 3D files they download
* The user can download whichever .3dshapes repos they require into a common directory and it would behave just as it would currently.
* This should all be compatible with the ongoing changes to the way that 3D paths are managed.

diggit, 2016-05-24:
@anpaza @SchrodingersGat
There were changes in 3D path management. In older versions, path was defined by KISYS3DMOD environment variable which you could easily change. You can set it in KiCAD in Preferences -> Configure Paths, but you have to undefine it in your environment.

In current build ([since build 6697, patch here](https://lists.launchpad.net/kicad-developers/msg24232.html)), 3D path is defined separately. AFAIK it is accessible only through footprint 3D settings. There is Configure path button, where you define aliases and paths to directories where are \*.3dshapes/ directories located. Then you can use *alias:library.3dshapes/model.wrl* as filename of model. Unfortunately it is global and if you define some non global alias like *${KIPRJMOD}/3D* kicad will inform you about wrong path at projects without 3D subdir.
If you set only 1 alias, it is like substitution of *KISYS3DMOD* and you don't have to use *alias:library.3dshapes/model.wrl*, but just *library.3dshapes/model.wrl* which is current format of all 3d names.

Wings file and even wrl file will be abandoned in future after switching to STEP file format IIRC.

More questions about this topic could be answered through bugreport, here it is OffTopic.

SchrodingersGat, 2016-06-06:
Bumping this thread, specifically relating to the inductor / choke repositories.

I currently have a number of PRs outstanding @ https://github.com/KiCad/Inductors.pretty

@anpaza has a very large PR outstanding @ https://github.com/KiCad/Choke_SMD.pretty

Plus, there are the other choke related repositories:

* https://github.com/KiCad/Choke_Toroid_ThroughHole.pretty
* https://github.com/KiCad/Choke_Radial_ThroughHole.pretty
* https://github.com/KiCad/Choke_Common-Mode_Wurth.pretty
* https://github.com/KiCad/Choke_Axial_ThroughHole.pretty

Before these PRs are addressed, I think some action needs to be taken here.

Personally, I would like to see two libraries:

* Inductors_SMD.pretty
* Inductors_THT.pretty

and the existing footprints can be migrated to there as required.

What do we all think of this? @CarlPoirier as the man with the power to raise and cull repos, I'm hoping you will weigh in :)

SchrodingersGat, 2016-07-13:
If no one has any strong opinions, I would settle for a moderately interested one, even.

What do people think of having two consolidated repositories:

1. Chokes_Inductors_SMD.pretty
2. Chokes_Inductors_THT.pretty

anpaza, 2016-07-14:
That does sound like "oily oil".
I'd say go with "inductors".
The word "inductor" has one and only meaning.
The word "choke" has a completely different primary meaning, and lots of secondary meanings, and it's kind of slang.

wolfgangbremen, 2016-07-15:
I agree with anpaza, that also conforms to michal777.
Another thing that I dislike is the addtion *_.THT to a library name. I assume about 90 % of our elektronic parts are "Through Hole"-parts, so this can be seen as the normal case, whereas SMD-parts are something special. According to michal777: Leave everything not necessary, drop that suspicious THT. Ending up that a library lib1.pretty contains "Through Hole"-parts, and lib1_SMD.pretty is the special one having the analogues parts as SMD-parts.
Above that: Evereyone who knows what kicad is does also know what SMD means, correct? But what is THT? Even an eletronic specialist not knowing kicad will have to guess what that might be. As I work with kicad since years, I know that you mean "Through Hole". But what stands the last "T" for?

diggit, 2016-07-15:
I'd go with Inductors*.lib(s) only. Chokes are special case of inductors.

I made common mistake, it should be _SMT and _THT suffixes.

I agree with @anpaza.

some explanation...
- __SM\*__ - Surface Mount
 - __T__ - technology
 - __D__ - device
- __TH\*__ - Through hole
 - __T__ - technology
 - __D__ - device (never seen used, probably default)

@wolfgangbremen
> I assume about 90 % of our elektronic parts are "Through Hole"-parts, so this can be seen as the normal case, whereas SMD-parts are something special.

Umm, what? I don't know what do you mean by *our*, but eg. 90% of parts on my PCBs are SMD and as THT remains connectors and high power parts only.

SchrodingersGat, 2016-07-16:
SMT is by no means "rare" or "special", agreed.

I think the additional "_SMT" suffix adds specificity at the cost of only
four characters and that's a bargain.

/2c

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

CarlPoirier, 2016-07-16:
Since changes in libraries cause problems to user who don't know how the fp-lib-table works, we have to keep changes to a minimum. I agree for splitting the Inductors in SMD and THT repos while marking the old one as deprecated. Furthermore, chokes being specific a specific use for inductors, I see no problem in them having their own repository. That being said, the existing choke repositories exist for historical reasons (the easy excuse haha) but indeed could be replaced.

All in all, Inductors_SM*.pretty and Chokes_SM*.pretty would fit the bill.

anpaza, 2016-07-17:
If chokes is split into a separate library, I expect appearing people opting for splitting power inductors, high-freq inductors etc into separate libraries.
I'd prefer a single library, with KiCad being added a feature (in perspective) to group components in a library by first part(-s?) of the name (delimited by '-') under a [+] expandable subgroup. Thus, if you have something like "Choke-0402", "Choke-0805", "Choke-1206" in "Inductors", they could be all hidden behind a single [+] and they won't interfere if you don't need them. This should allow to split parts into libraries by families and avoid splitting numerous libraries, often with just a few parts.

CarlPoirier, 2016-07-17:
The difference with chokes is that they are already split. Also, one thing to keep in mind is that the bigger the .pretty is, the longer it takes to load it from Github.

SchrodingersGat, 2016-08-08:
@CarlPoirier have we reached somewhat of an accord on this? If you want to make the appropriate new repositories we can start reassigning parts etc etc :)

pointhi, 2016-10-01:
@CarlPoirier, @SchrodingersGat , ... It would be cool to get to a conclusion and then start reordering the footprints.

CarlPoirier, 2016-10-01:
Hi @pointhi,

That's where we were at. Indeed, lets's go ahead. I'll start by merging the pull requests you have already open later this weekend.

Buttons_Switches_ThroughHole.pretty -> Buttons_Switches_THT.pretty
Capacitors_ThroughHole.pretty -> Capacitors_THT.pretty
Connect.pretty -> Connectors.pretty
Diodes_ThroughHole.pretty -> Diodes_THT.pretty
Display.pretty -> Displays.pretty
Relays_ThroughHole.pretty -> Relays_THT.pretty
Resistors_ThroughHole.pretty -> Resistors_THT.pretty
Sockets_Mini-Universal.pretty -> Connectors_Mini-Universal.pretty
Terminal_Blocks.pretty -> Connectors_Terminal_Blocks.pretty
Sockets_BNC.pretty -> Connectors_TE-Connectivity.pretty (KiCad/Sockets_BNC.pretty#1)
Sockets_WAGO734.pretty -> Connectors_WAGO.pretty (KiCad/Sockets_WAGO734.pretty#1)
Sockets_MOLEX_KK-System.pretty -> Connectors_Molex.pretty (KiCad/Sockets_MOLEX_KK-System.pretty#1)
part of Terminal_Blocks.pretty -> Connectors_WAGO.pretty (KiCad/Terminal_Blocks.pretty#6)
part of Terminal_Blocks.pretty -> Connectors_Phoenix.pretty (KiCad/Terminal_Blocks.pretty#6)

Also all of those into Chokes_SMD.pretty and Chokes_SMT.pretty:
Choke_Common-Mode_Wurth.pretty
Choke_Toroid_ThroughHole.pretty
Choke_SMD.pretty
Choke_Radial_ThroughHole.pretty
Choke_Axial_ThroughHole.pretty

And those into Inductors_SMD.pretty and Inductors_SMT.pretty:
Inductors_NEOSID.pretty
Inductors.pretty

pointhi, 2016-10-01:
For chokes, there are another repositories which also needs to be merged:
* https://github.com/KiCad/Choke_Common-Mode_Wurth.pretty
* https://github.com/KiCad/Air_Coils_SML_NEOSID.pretty

CarlPoirier, 2016-10-01:
Indeed I had not mentioned the Air_Coils_SML_NEOSID.pretty. Also I just noticed that for simple renames, we need not keep the old repo since Github offers repository redirection!

CarlPoirier, 2016-10-02:
I thought the links in the summary were pull requests. You can go ahead and add symbols into the new repos.  I will take care of the renaming.

SchrodingersGat, 2016-10-02:
> And those into Inductors_SMD.pretty and Inductors_SMT.pretty:
> Inductors_NEOSID.pretty
> Inductors.pretty

You mean *Inductors_SMT* and *Inductors_THT*, yes?

CarlPoirier, 2016-10-02:
woops, indeed! I will edit the summary.

CarlPoirier, 2016-10-11:
I completed the simple renames with pull #743.

What is left to do, which all require leaving the old repositories online:

Sockets_MOLEX_KK-System.pretty -> Connectors_Molex.pretty (KiCad/Sockets_MOLEX_KK-System.pretty#1)
part of Terminal_Blocks.pretty -> Connectors_WAGO.pretty (KiCad/Terminal_Blocks.pretty#6)
part of Terminal_Blocks.pretty -> Connectors_Phoenix.pretty (KiCad/Terminal_Blocks.pretty#6)

Also all of those into Chokes_SMT.pretty and Chokes_THT.pretty:
Choke_Common-Mode_Wurth.pretty
Choke_Toroid_ThroughHole.pretty
Choke_SMD.pretty (rename to Chokes_SMT.pretty first and add content into it)
Choke_Radial_ThroughHole.pretty
Choke_Axial_ThroughHole.pretty
Air_Coils_SML_NEOSID.pretty

And those into Inductors_SMT.pretty and Inductors_THT.pretty:
Inductors_NEOSID.pretty
Inductors.pretty

SchrodingersGat, 2017-02-17:
Sweeping changes have now been made addressing most (all?) of these issues. I am going to mark this one as closed

Closed 2017-02-17.

Thread 291 (2015-09-01):

LED pin numbering disagreement

alexforencich, 2015-09-01:
The PCB footprints for LEDs have pin 1 = cathode.  The symbols have pin 1 = anode.  What gives?!?

ricardocrudo, 2015-09-02:
Do you have the last version of kicad-library?

alexforencich, 2015-09-03:
The damage has already been done.  I had to manually rebuild a handful of LED light towers as a workaround as the library was inconsistent when I laid out the boards.

alexforencich, 2015-09-03:
Yes, the library is still inconsistent.

ricardocrudo, 2015-09-03:
@alexforencich please let me know what exactly LED symbol and footprint you are talking about.

alexforencich, 2015-09-03:
Symbols: LED, LED2, LED_Small (library 'device)
Footprints: LED-10MM, LED-3MM, LED-5MM, LED-8MM, LED-0603, LED-0805, LED-1206 (library 'LEDs')

I suggest changing the pin numbers to A and K or A1, K1, A2, K2, etc. for both the symbols and the footprints for LEDs and diodes to remove any ambiguity.

ricardocrudo, 2015-09-09:
> I just updated to the latest git version and the library is still inconsistent.

@alexforencich the led pin out is correct in device's library. pin 1 -> K, pin 2 -> A.

alexforencich, 2015-09-10:
Symbol pin 1 is the anode, not the cathode.  The problem is not that the footprint is incorrect, the problem is that the symbol and the footprint disagree with each other.  If I connect a wire to the anode pin of the symbol, I expect a net to be connected to the anode pin of the footprint when I add it to a board.  This is not the case as symbol pin 1 = anode while footprint pin 1 = cathode.

ricardocrudo, 2015-09-10:
@alexforencich checking here https://github.com/KiCad/kicad-library/blob/master/library/device.lib#L1063 led symbol has cathode on pin 1 and anode on pin 2. Can you point me where are you seeing this issue?

alexforencich, 2015-09-10:
Alright, so it seems that I have stumbled into a serious hole in the kicad library architecture.  It appears you swapped the pins on both the footprints and the symbols in commits https://github.com/KiCad/kicad-library/commit/9372e0c2706f78ecf2b104849f0cb703330b5385 and https://github.com/KiCad/LEDs.pretty/commit/c88801830f7701755de6ca48e3088b451b5ef703 .  This was a very bad idea due to the fact that kicad caches the symbols in the schematic.  It is also a bad idea in the case that somebody made a copy of the symbol library to make some modifications, which appears is what happened to me (I needed a 2 LED stack and a ferrite bead).  A schematic made with the pre-change symbols and then used with the post-change footprint will cause all of the devices to be hooked up backwards, without any sort of error messages or warnings.  The correct fix is an architectural one, moving to integrated footprint and symbol libraries like Eagle.  However, as much as that change should be made, it will unfortunately never be made.  So, the alternative would have to be convention and policy.  Policy would have to be no changes to pin ordering.  Convention would be to not use numbers for pins at all, but to name them with variations of A and C  - A and C; A1, C1, A2, C2; A1, A2, A3, C; etc.  With this change, if there is a version disagreement between the schematic and board, the pins will not be connected at all - i.e. there will be something obviously wrong.  Now, the footprint library may also get polluted with various similar footprints (RGB common anode and RGB common cathode), but without an independent mapping layer (like in eagle) you're either going to have duplicated footprints or duplicated symbols, both of which are less than ideal.

michal777, 2015-09-13:
Developers plan refactoring eeschema after the stable release so that the symbols will be embedded into schematic files.
According to the kicad library convention schematic symbols can be duplicated, footprints not.
Please always verify libraries, these are neither stable nor reliable, useful as starting point for your own. Be careful with kicad-library updates and "online libraries" (it's better to keep libraries on hdd or your own github account).
K=1, A=2 is common standard that we should follow.

alexforencich, 2015-09-13:
Excellent.  If that is on the roadmap, then I will hold off on any kicad library development work (namely the comprehensive Xilinx library that I have been working on) until that feature is implemented in the development version.

Closed 2015-09-13.

Thread 313 (2015-09-30):

Resistor thru-hole vertical 3D model

imarin2, 2015-09-30:
Is there a reason why there is not such a wrl? I am doing one for myself, so I thinking if I should contribute it. Let me know.

cbernardo, 2015-09-30:
You mean like these?
http://sourceforge.net/projects/kicad3dmodels/files/models_v0.5/model_thru_resv_20121126.tar.bz2

      From: imarin2 <notifications@github.com>
 To: KiCad/kicad-library <kicad-library@noreply.github.com>
 Sent: Thursday, October 1, 2015 3:44 AM
 Subject: [kicad-library] Resistor thru-hole vertical 3D model (#313)

Is there a reason why there is not such a wrl? I am doing one for myself, so I thinking if I should contribute it. Let me know.—
Reply to this email directly or view it on GitHub.

imarin2, 2015-10-01:
Yes, precisely. I was not intending to have one model for each value (colour code), but definitely not complaining :). Thanks for pointing me to the source.

The question however still stands: Why are these not included in the repo? Are they being integrated or something like that?

cbernardo, 2015-10-01:
The devs didn't believe the VRML modeling tools belonged with KiCad
so they were never merged. Although old generated models are on SF,
the code is now hosted on github instead. I think the code should
just be packaged (though that would need volunteers) and people who
want to use the tools to generate models can simply install a
package and generate the models. The models aren't in the kicad
libraries on github simply because there are so many of them. Some

models have been put into the kicad libraries though such as the
qfp/qfn/soic models and I think the DIL models.

- Cirilo

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

imarin2, 2015-10-02:
Thank you very much for taking the time to reply.

I now see my problem. I thought this GitHub repository was a space unlimited single source of libraries (symbol, footprint, 3D model) for KiCAD.

KiCAD is a great tool. However a tool is always as great as it takes you to get the job done. Libraries of electronic components (symbol, footprint, 3D model) have been such an important contributing factor in every EDA I have ever used, as they tend to suck an important part of the time one dedicates to a project. It is also a leading reason why a company using EDA A is reticent to switching to EDA B. Having an extensive library support plays quite a role in the switch.

I think that KiCAD, standing for what it is, opensource (and a great one), has an incredible potential in its community to get to an out-of-the-box vast library access (symbol, footprint, 3D model). However, in order to unleash that potential, storage space should not be a limiting factor in such an endeavour.

As many others, I also think WRML is not the most appropriate format for 3D modelling of PCBs as you usually run into problems when you want to integrate the end result into your (mechanical) CAD software (I use FreeCAD myself). I can refer to the tons of efforts in place and for example issue #186. I think that the most accepted format in CAD is STEP and that it should be supported in KiCAD. Unfortunately KiCAD only supports WRML as 3D format.

In any case, if KiCAD is not going to support (there are not short-term plans to support) other format than WRML, then I think it would be great to actually have **a single place** with all the WRML models and clear guides on how to generate them, so that a person needing a non-available component and wanting to make it (e.g. with FreeCAD) could then contribute it to this single place and be used by others (in my dream, electronic component manufacturers contribute libraries for their products to KiCAD, but that is way ahead). I could even agree in uploading a STEP version and the original "CAD" file towards a future STEP support and allow easy modification of the model. I know this is not a new thing, as I am aware that I am repeating what others have said (and even started doing).

The local generation of files, while it has merit and can be a way to go if we **can not** do better, I think it belongs to the "pre-cloud" era. I could imagine doing this in the 80s in my computer when I had no Internet access. Nowadays, it should be enough "cloud-space" to have everything, complete, in one place. **I want to reuse the work of others and that others reuse mine**.

Now that I have explained where I stand. I regret that there is a constraint in space limiting the inclusion of those 3D models left behind. Yes, I think it would be great to have a **single source** where everybody could use and contribute. **Yes, I can help by contributing part of my time to such an effort**.

Please forgive my rather long post and feel free to "tag it" as "usual EDA libraries rant". In any case **I am very grateful for your models** and for all you have done for the community and for everybody using KiCAD out there.

cbernardo, 2015-10-02:
For a few months now you have the option of creating a STEP model of the
PCB using some scripts + FreeCAD (http://sourceforge.net/projects/kicadstepup)
and there has been some work on an IGES exporter for almost 1 year now

(https://github.com/cbernardo/libIGES). Unfortunately I need to do some
refactoring of the KiCad code before I can introduce the IGES exporter
and at the moment I'm guessing I won't have that ready until at least
the end of this year. IGES has been unmaintained since the last approved
specification in 1996 (and officially abandoned in 2006) but it is still a
widely supported format and much simpler to implement than STEP. So there
will be some proper MCAD support within a year. The work currently being
done with KiCad will also make it possible to provide STEP export via OCE
without the use of FreeCAD, but someone has to write that code. My plan
in the long term would be to provide native STEP support as well but since
I only work on code in my free time I estimate that would be a 2-year task;
the only advantage over support via OCE being that the library would not be
500MB since it will not contain specialized routines which are only required
for interactive mechanical design.

Although you can put as many models as you wish on github I just don't
believe it makes sense. Given the tens of millions of common electronic and
mechanical items used to design and manufacture PCB assemblies, you'd need
very specialized software to help you search a repository and not waste
time downloading too many models. Parts also change with time so you need
to verify the dimensions of any MCAD model you use; with a single site for
all models you can easily waste all your time just searching - it's probably
better to just use google to search for existing models and quickly check
that they are what you want. After all the manufacturer websites have a lot
more information on each model they provide - for the current kicad library
there is no record of provenance for the models.

- Cirilo

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

imarin2, 2015-10-02:
I see your point. I will have to wait until all manufacturers agree to provide symbol, footprint and 3d model in a standardized way... :)

As for the IGES/STEP support I can only say: **Thank you.**

Closed 2015-10-02.

Thread 322 (2015-10-26):

Kicad Github Repo Conventions

SchrodingersGat, 2015-10-26:
Hi everyone,

As someone who is trying to contribute to the kicad schematic/footprint/3d libraries, I have some thoughts on the github repository conventions. Maybe these have already been addressed and perhaps they're inappropriate, but here goes!

1. I believe that the .pretty libraries should be tracked in a single repo as with the schematic symbols. Keeping track of multiple repositories is a pain (and each time I want to pull-request a new footprint in a repo that I don't fork, I need to go through that whole process rather than just making a new branch). It would also be easier for general (non-contributing users) who want to keep up to date with the most up-to-date footprints and only have to do a pull on the master branch of ONE repository.

2. 3d model management - I know that this has been discussed both here and in the kicad forums, and there are mixed opinions on whether they should be with the schematic symbols or the footprints. I personally think that these should be in their own repo - it seems messy having them mixed in with the schematic symbols.

This would keep everything nicely separated and easy to manage. The kicad-library repo works well and covers multiple libraries.

What do others think on this? Managing two logically separate libraries in one repo and then having separate small repositories for the .pretty folders seems disjointed.

CarlPoirier, 2015-11-22:
Hi Oliver,

For number 1, we need it because of the way the KiCad Github plugin works. In the library manager, you indicate the library repository. You can even indicate your own repository, that's what we do to verify libraries before approving the merge request.

For number 2, I would personally like to see the 3D models directly in the .pretties but KiCad developers would need to put lots of efforts into that. Furthermore, it's been discussed many times on the mailing list and it did not seem to lead to some consensus if I remember correctly.

Carl

CarlPoirier, 2015-11-22:
Hi Oliver,

The courtyard clearance for connectors should be 0.5mm as per rule 6.7. Besides that, the silkscreen does not allow one to determine the pin one position once the connector has been soldered on it. That would be great to fix as well. Besides that, it looks great!

timofonic, 2015-12-08:
@CarlPoirier

Why not change KiCad GitHub plugin to work differently? And even better, make it compatible with other Git providers (even your own Git server).

This change could be extended to make Git usable for storing storage and schematic projects, making collaboration easier.

keruseykaryu, 2015-12-08:
@timofonic: "This change could be extended to make Git usable for storing storage and schematic projects, making collaboration easier."

I have some bad experiences with Altium's CurcuitMaker, and IMHO "clouding" projects is sucks.
Besides, KiCad has no graphical CVS, which is a minimum to start thinking about that.

Closed 2016-08-19.

Thread 354 (2015-12-30):

Introducing generic component-symbols for common devices?

tahiro86j, 2015-12-30:
As the repetitive process of adding unlisted BJTs to the component-library seems like a never-ending task, introducing some "generic" symbols described as "Type-Footprint-Pinout" (e.g NPN-TO220-BCE, PNP-TO247-BCE) seems like a decent idea.
Pushing this further (but gradually), it'd be great if all models of BJTs except the generic symbol are the aliases of the generic symbol. This way, adding a new model would be far less confusing...
And, well, the very same idea - I imagine - would be applied to some other types of components, too.
Any thoughts?

keruseykaryu, 2015-12-30:
FYI. I have collected so many "repetitive" transistors in `transistors.lib` because I wanted this library was regarded not just as an ordinary source of schematic symbols, but also as a catalog where symbols, footprints, key parameters in fields and PDF links establish a coherent whole.

tahiro86j, 2015-12-31:
Ah, okay. The "transistors.lib" does indeed show traces of your effort, and that should be respected.
Aside from that though, it'd be still useful to leave "independently existing" generic symbols like "NPN-TO220-BCE", "PNP-TO247-BCE" and at the same time, encourage users community to keep adding the PNPs and NPNs not yet listed in "transistors.lib"...how does this sound?
Just saying this because despite the effort you have put into "transistors.lib", those models starting with 2SA, 2SB, 2SC, 2SD (mainly those from Japanese semicon manufacturers) are hardly plentiful in the current status. Of course I'll be doing my best to keep adding as many as I can, but that does not mean all demands would be fulfilled.

keruseykaryu, 2015-12-31:
@tahiro86j: "Ah, okay. The "transistors.lib" does indeed show traces of your effort, and that should be respected."
Considering current situation - I'm not a lib maintainer anymore - I don't care. This was an information "why do so" only.

@tahiro86j: "Just saying this because despite the effort you have put into "transistors.lib", those models starting with 2SA, 2SB, 2SC, 2SD (mainly those from Japanese semicon manufacturers) are hardly plentiful in the current status."
The Japanese ones isn't very popular in Europe, where am I come from. This small set I need to draw schematic for a power amp stage modeled on ROTEL RA-935BX.

tahiro86j, 2016-01-02:
@keruseykaryu First, sorry for the long-response below, and my apologies for any troubles I may be causing to you due to the lack of experience in software development. (I'm an EE student and the this was never the everyday-thing until I decided play with KiCad.)

So, I'm not yet exactly sure of the phrase "coherent whole" you used in the first response to the issue. But what I feared the most now was, there could potentially be multiple symbols with different dimensions defined for different BJTs sharing the same package, pin-layout, and the polarity (NPN,PNP). IMO, this could be quite troublesome because when those using Eeschema attempt to swap a BJT with another type/model, that model simply may not fit into the already-drawn schematic - simply because that model (with the same dimension-physical feature) may have a symbol made by a different person, with a slightly different rule-set, ending up with slightly different dimensions. And I sense that such case is most likely caused by avoiding the use of aliasing across entries of BJTs with the same package, pin-layout, and the polarity (NPN,PNP).

The sole purpose of first opening this issue (well, once closed and then reopened) was so that - at very least - maybe, most BJT-entries to be added in the future could use one of several pre-defined symbols as an alias, peacefully avoiding the above trouble.

Now, I wasn't exactly sure of how aliasing worked when I opened this issue, so I spent the whole afternoon looking at "transistors.dcm" and "transistors.lib" and there I found that aliasing still allows you to specify different descriptions, keywords, datasheet-URL and e.t.c...for each entry defined within "transistors.dcm".
Well, here I was looking at the example of "TIP120" which has;
a.)Two aliases ("TIP121" and  "TIP121") defined in "transistors.lib"
b.)three separate entries for "TIP120", "TIP121" and "TIP122" in "transistors.dcm"

Now, given all above, defining the suggested "generic symbol" (Let's just say in "Footprint_Pinout-Type" this time, for styles like "TO-220_BCE-NPN") now seems like even more of a decent idea.

But even supposing so, I am nowhere near saying "existing entries should also be set to use one of the generic symbols" - no, this is very dangerous and confusing. (The symbol-dimensions should be maintained for already-existing entries, at least for a while.)

Some insightful responses would be quite helpful and very appreciated, since I am now planning on adding to the library, some 30-40 new BJT entries  - those commonly used in Japan and by audiophiles across the globe.

CarlPoirier, 2016-01-02:
Hi Tahiro,

If I understand correctly, you suggest to have all transistors as aliases of generic symbols so that they have more uniform drawings and thus can be more easily swapped in a schematic. Is this right?

tahiro86j, 2016-01-02:
Wow, very nicely summarized!
That indeed is the point!

CarlPoirier, 2016-01-02:
I think it is a great idea but not necessarily all transistors have to work this way at first.

I suggest you start off by creating your generic symbols and have them match the already existing transistors as much as you can. Next, you can create your BJT entries using these. Then, create a pull request and show your work. We'll discuss it further, then.

tahiro86j, 2016-01-02:
@CarlPoirier For existing entries, progress should be made gradually since any quick transition in this kind of situation may cause nothing but confusion and chaos. Thanks for your advice, anyway.

michal777, 2016-01-02:
Some generic transistors symbols are in devices.lib (Q_...)

CarlPoirier, 2016-01-02:
Indeed, but if I am not mistaken we cannot have inter-lib aliases. Putting them in transistors.lib would allow using them. They also seem to nicely match the symbols in transistors.lib, so maybe they could be aliased directly?

tahiro86j, 2016-01-02:
@michal777 @CarlPoirier I shall look into that then!

tahiro86j, 2016-01-02:
@CarlPoirier Alright, #355 should now be ready. Since #355 does not contain any symbols newly added, the real test for me is coming up in coming days when I, as you advised, add those generic symbols and some thirty new entries for Japanese PNPs and NPNs.

tahiro86j, 2016-01-03:
@michal777 @CarlPoirier Alright, made a wrong post here last night. Apologies.
Are there any ways to print the list of symbols within a library file?
I am trying to compare the size of existing symbols for below reasons.
Here, as the base for the generic symbol to be created, I'm thinking of using ones that satisfy;
a.)Symbols for NPN and PNP (Nch, Pch for FETs) are basically identical - except for the position and the angle of arrow.
b.)The outer circle is large enough that it can accommodate the darlington-structure inside.

ricardocrudo, 2016-01-05:
> Are there any ways to print the list of symbols within a library file?

@tahiro86j if you are using linux or mac:

    cat ./library/transistors.lib | grep "DEF " | cut -d' ' -f2

tahiro86j, 2016-01-17:
Well, I was thinking of getting visual images of them, instead of the strings...

CarlPoirier, 2016-01-17:
AFAIK the best you can do is browse for them in KiCad :-(

On Sun, Jan 17, 2016 at 10:29 AM, Tahiro Hashizume <notifications@github.com
> wrote:

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

ricardocrudo, 2016-01-19:
@tahiro86j I wish this feature as well.

tahiro86j, 2016-01-20:
@CarlPoirier As you pointed out, I could browse through symbols just fine, but when trying to compare the actual dimensions of each component, the method you mentioned becomes somewhat useless. Being able to compare them all at once requires symbols be printed on one page (either on screen, or on paper) with unvarying scaling for each entry. The reason I need to do this is described in the 5th post of this thread.

CarlPoirier, 2016-01-31:
Hi @tahiro86j,

The best you can do is place them all on a schematic.

tahiro86j, 2016-02-05:
Ha, why didn't I think of that?

SchrodingersGat, 2017-11-21:
@tahiro86j I am closing this issue due to long period of inactivity. Thanks.

Closed 2017-11-21.

Thread 357 (2016-01-03):

KLC footprint anchor rule problem

g200kg, 2016-01-03:
Hi all,
KLC says footprint anchor should set on pad 1. But I think it had better to allow some exceptions for  mechanical related parts (e.g. potentiometers, switches..).

In these parts, the shaft or button should be placed to accurate position but the pad 1 anchor makes that difficult.For example,

'Button_Switches_ThroughHole' - 'SW_Tactile_SPST_Angled' has pad 1 anchor but the center of the button is not on the grid.

CarlPoirier, 2016-01-16:
Hi,

How is this an issue? Just place your part with an offset of the desired amount. The anchor is set on pad 1 for physical reasons, namely pick and place.

g200kg, 2016-01-17:
Yes, it is possible. But it is so bothering because the correct positions should be calculated part by part mixing mm and inches, also considering part direction.

Though I am not sure which should take priority, this issue or the physical reasons, the pad 1 anchored mechanical parts are cumbersome for me in my experience.

ricardocrudo, 2016-01-19:
@g200kg maybe this could be solved by Graphical Interface, as a feature. Something like yEd software does when moving blocks.

g200kg, 2016-01-20:
I hope so :)
anyway I think that need some mechanical reference point info.

Though I know this is not the best solution, is this KLC compliant?
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

DavidMenting, 2016-02-26:
Obeying this rule is very annoying in board layout. It is also very counter-intuitive to have components rotate all over the place, especially when surface mounted devices behave differently. Being able to rotate pots or switches in order to help routing without them shifting with respect to plunger or shaft is very convenient.

I understand this rule helps pick and place, but in the end KiCAD is an application for use by humans, not by machines, right?

My solution now is to duplicate the part, rotate it, drag it on top of the old part and then delete the old part.

anpaza, 2016-05-03:
I think anchor should be just another property of the footprint.
If it's not defined, let's default to (0,0).
But if it is, in the output files that matters the anchor should be used, if it's defined.
This way, the footprint can be defined and used in most convenient way.
Some SMD footprints, for example, aren't symmetric and are defined in drafts wrt some other axes. For example, MicroSD card slot drafts are defined wrt card symmetry line, but card is slightly shifted om the slot.
The anchor could be displayed as a small cross on the footprint.

jkriege2, 2016-10-27:
I also think that for mechanical parts we need some kind of solution that allows to have axes at easily defineable positions ... For the pic and place ... couldn't that be done automatically on export? Just move each component's origin to a pin numbered 1 when exporting?

Best,
JAN

SchrodingersGat, 2017-11-21:
This is now detailed on the KLC pages:

* http://kicad-pcb.org/libraries/klc/F6.2/
* http://kicad-pcb.org/libraries/klc/F7.2/

Closed 2017-11-21.

Thread 368 (2016-01-09):

JST XH Connectors

BenediktSeidl, 2016-01-09:
I've created footprints and 3d views for JST XH THT connectors: https://github.com/BenediktSeidl/kicad-jst-xh
1. Do you want to include footprints and 3D-Models for JST XH connectors?
2. What do I have to rework? (`check_kicad_mod.py` seems to be satisfied)

Would it be possible to include the scripts? I've already seen that `.wing` files are checked in beside the `.wrl` files. Otherwise it will be pretty time consuming to fix a little bug.

pointhi, 2016-01-16:
kicad_mod gives me a tracepath, but I haven't  figured out yet what causes it. I think some error inside your footprint generator script:

```
Traceback (most recent call last):
  File "./check_kicad_mod.py", line 32, in <module>
    if rule.check():
  File "/home/thomas/Dokumente/Projekte/kicad/kicad-library-utils/pcb/rules/rule6_5.py", line 50, in check
    endComplex=complex(graph['end']['x'],graph['end']['y'])
TypeError: complex() can't take second arg if first is a string
```

There are already JST connectors, made by me ([JST_SH](https://github.com/KiCad/Connectors_JST_SH.pretty), [JST_PH](https://github.com/KiCad/Connectors_JST_PH.pretty)) . Probably we should merge them to 1. Repository, and changing the filenames to something like ```JST_PH_***```. Then you could create a pull-request onto it. I will contact @CarlPoirier to discuss that.

The other way would be adding another new repository, but this could get out of control when adding more and more JST footprints.

About the 3D files, I'm not sure if generated models are allowed yet (without wings3d generating it)

BenediktSeidl, 2016-01-16:
>  I think some error inside your footprint generator script

The problem is that the generated kicad_mod-files contain numbers prefixed with `+`. I could remove them, but kicad seems to allow them, so I've created [pull request #13](https://github.com/KiCad/kicad-library-utils/pull/13) for that. Should have mentioned it, sorry.

Merging all the JST repositories sounds good to me. But I think it would be useful to include the scripts which were used to create the kicad-mod files. Otherwise someone will have to write another script to fix bugs. It took some time to find your scripts for the JST_[SH|PH] connectors.

CarlPoirier, 2016-01-16:
Hi guys,

I also thinkg having one pretty library for all JST connectors would be fine. I'm creating the library.

pointhi, 2016-01-16:
Thx

I think we should think about a generic naming schema of the jst footprins.

I would suggest a prefix like ```JST_PH_02x05_Straight_``` which would help finding the correct footprint while not beeing to long (like the ```Connectors_JST_...```.

For example, a footprint would be named like: ```JST_PH_02x05_Straight_B10B-PH-K.kicad_mod```

I will create the required pull request for SH, and PH in the next days.

BenediktSeidl, 2016-01-17:
Sounds good to me, will also create a pull request for [Connectors_JST](https://github.com/KiCad/Connectors_JST.pretty) in the next days.

[Molex](https://github.com/KiCad/Connectors_Molex.pretty) and the upcoming [Multicomp](https://github.com/KiCad/Connectors_Multicomp.pretty/pull/1) seems to include the whole `Connectors_` prefix so I think we should do the same.

* What about including the scripts to generate the files?
* What about the created 3D files, that are not created by wings3d?

pointhi, 2016-01-17:
Jep, I will change the Multicomp pull request soon, to have more compact names.

Including the scripts would be a good idea, or at least a clear reference where you can find it (In the README.md for example)

The problem is, most people write their own script engines which could result in a big mess of very different scripts.

For example, currently I'm writing a whole new script engine which works similar to a scene tree and should allow very efficient and flexible footprint generators: [pointhi/kicad-footprint-generator](https://github.com/pointhi/kicad-footprint-generator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).

SchrodingersGat, 2016-01-18:
Hi all!

I've been putting together some connector libs too:

https://github.com/SchrodingersGat/Connectors_JST.pretty
https://github.com/SchrodingersGat/Connectors_Hirose.pretty
https://github.com/SchrodingersGat/Connectors_Omnetics.pretty
https://github.com/SchrodingersGat/Connectors_Harwin.pretty

I'll try to incorporate my JST footprints into the new one.

SchrodingersGat, 2016-01-18:
https://github.com/KiCad/Connectors_JST.pretty/pulls

I have made a few pull requests here to start the ball rolling :)

pointhi, 2016-01-18:
Here are my PR:

https://github.com/KiCad/Connectors_JST.pretty/pull/11
https://github.com/KiCad/Connectors_JST.pretty/pull/12

@SchrodingersGat I would recommend you to remove the ```Connectors_``` from the footprint names, because it only extend the name without beein useful.

For example, I named my footprints like ```JST_SH_02x1.00mm_Angled_SM02B-SRSS-TB.kicad_mod``` which contain all important informations on the left side of the name, and the exact footprint name on the right side.

BenediktSeidl, 2016-01-18:
##### `Connectors_` Prefix
[KLC 9.2](https://github.com/KiCad/kicad-library/blob/f41e0370c5dac376f1096984a43f9c70190791e9/KiCad_Library_Convention.txt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) says the footprint name starts with the name of the part. I think we should wait for an official statement of the librarian team.

##### Scripts
I really would like to include the scripts directly into the repository as in some years the links could be invalid or at least have to be maintained. An official librarian has to decide and perhaps add a rule to the KLC.

I will hold off on my pull request until all issues are resolved.

SchrodingersGat, 2016-01-18:
Hi @BenediktSeidl  @pointhi  - some good points here and I agree that we need to establish a single naming convention, both for the Connector_ prefix and for the straight/angled/vertical/etc. I agree we should wait for some clarification on this and I am happy to rename all of my parts accordingly.

ricardocrudo, 2016-01-31:
@BenediktSeidl please pull request your scripts to https://github.com/KiCad/kicad-library-utils. Place them in the directory that better fits them functionality.

As suggested by @pointhi  is preferable to let new footprints without the prefix `Connectors_`.

BTW, the bug fix for support `+` signal is already merged.

CarlPoirier, 2016-01-31:
Hi folks,

There's a catch at removing the Connector_ at the beginning of the footprint name. We won't be able to search for "connector" *by name*. It's true it would be great not to have this repetitive keyword at the start. What I suggest is we start by removing the one in the Molex library and make sure every footprint has the keyword "connector" in its properties instead. We then do the same for the JST and others. Then, we'll be able to search for "connector" *by keyword*. This is when you use the "Add footprints" button in Pcbnew.

As for the orientation, most current footprints use Angled vs. Straight. I say we keep this for a matter of uniformization.

CarlPoirier, 2016-01-31:
As such, the JST pull requests by @pointhi are correct since they have the keyword connector in each of their footprints.

ricardocrudo, 2016-01-31:
@CarlPoirier the new PR's of @pointhi already has tge connector word in the descriptions, so I think is safe remove the prefix.

@CarlPoirier @pointhi  I'm not sure about have the generic naming for specific part number devices. I mean the `02x1.00mm_Angled`. In this case would be the part number enough? Or maybe move generic info to the end of the name, like this: `JST_SH_SM02B-SRSS-TB_02x1.00mm_Angled.kicad_mod` that's because the part number of device would be more immediately to read.

CarlPoirier, 2016-01-31:
I like the generic info at the end such as in the example you gave: JST_SH_SM02B-SRSS-TB_02x1.00mm_Angled.kicad_mod.

pointhi, 2016-01-31:
@ricardocrudo I proposed the generic info at the beginning to allow easy lookup and logical grouping of the connectors (for example: have all connectors with 15 pins in smd as well as tht in succession)

SchrodingersGat, 2016-02-01:
I've updated my pull requests to match these new naming conventions.

SchrodingersGat, 2016-02-03:
In addition to the conventions above, what about SMT/THRU notation for the connectors? Should we add this as another suffic?

e.g.

JST_SH_SM02B-SRSS-TB_02x1.00mm_Angled_SMT.kicad_mod

pointhi, 2016-02-18:
Ok, here is a proposal for connectors cleanup:

* **Sockets_BNC.pretty** -> **Connectors_TE-Connectivity.pretty** (https://github.com/KiCad/Sockets_BNC.pretty/issues/1)
* **Sockets_WAGO734.pretty** -> **Connectors_WAGO.pretty** (https://github.com/KiCad/Sockets_WAGO734.pretty/issues/1)
* **Sockets_MOLEX_KK-System.pretty** -> **Connectors_Molex.pretty** (https://github.com/KiCad/Sockets_MOLEX_KK-System.pretty/issues/1)
* part of **Terminal_Blocks.pretty** -> **Connectors_WAGO.pretty** (https://github.com/KiCad/Terminal_Blocks.pretty/issues/6)
* part of **Terminal_Blocks.pretty** -> **Connectors_Phoenix.pretty** (https://github.com/KiCad/Terminal_Blocks.pretty/issues/6)

Furthermore, I have done the suggested cleanup for the molex connectors: https://github.com/KiCad/Connectors_Molex.pretty/pull/10

@CarlPoirier @ricardocrudo when you say go, I can do the required rework.

CarlPoirier, 2016-02-19:
@SchrodingersGat Are there SMT and PTH versions of the same connectors?

@pointhi This cleanup sounds reasonable to me. Let's wait for @ricardocrudo's input however. Also one thing you have to keep in mind is we have to keep original repositories untouched so that people using old fp-lib-tables.for-github will not get errors. So the way to go is to create the new library, fill it, adjust the fp-lib-table to add the new pretty and remove the old one, but keep the latter's repository online!

This

SchrodingersGat, 2016-02-19:
@CarlPoirier no generally the part number represents whether a connector is PTH or SMT - however my thoughts were it's nice to be able to tell from looking at the footprint name when you're in CvPcb. Open to suggestion on this though. I've been running with a _PTH and _SMT suffix thus far.

ricardocrudo, 2016-02-19:
@pointhi there is a discussion going on about pretty repos reorganization, please check it https://github.com/KiCad/kicad-library/issues/257 and feed it up with your suggestions (some of them is already there). Michal is also participating with his suggestions.

I gonna start to merge JST connectors.

ricardocrudo, 2016-02-19:
@CarlPoirier I guess the  permissions of KiCad/Connectors_JST.pretty repo need to adjusted, I can't merge on it.

CarlPoirier, 2016-02-20:
@ricardocrudo Fixed. As for the other new repositories, we'll see what we do first with the renaming.

anpaza, 2016-05-03:
So, where are the 3dshapes? I can't find them neither in kicad-library nor Connectors_JST.
I'd say scratch the "uniformity of scripts", give some flexibility to people, everyone uses what it's most used to.

Virtex7, 2017-01-16:
Hi!

i've added your JST 3d shapes, they're working nice.
just wanted to say thanks!

CarlPoirier, 2017-01-21:
All pull requests have been merged, I'm closing the issue.

Closed 2017-01-21.

Thread 391 (2016-02-11):

How to include base board for shields/modules?

NerdyProjects, 2016-02-11:
Dear all,

I want to use a Core51822 board (http://www.waveshare.com/core51822.htm) in my design.

In my opinion, it would make sense to have a footprint and **not** a template because there could be multiple of this (or other shields) on one board. But anyway, an arduino shield could theoretically also be stacked additionally on something else.
But how would I create an arduino shield with a Core51822? Stacking two templates would not work.

If I create a footprint for that board, that basically is two 2*9 pin 2.00mm pin header with a specific distance and the outline on silk, would that be accepted?

Thanks!

El3ctr0nic, 2016-02-14:
Hi i have same problem with Nucleo64 board. I created development_boards.lib it is in pull reauest queue now. Pin headers aren't good i think. Will be problem with pin numbers. Two pin headers have same numeration and it will be confusing during shematic drawing. Footprint with board dimension silkscreen should be enough. Evryone can draw board outline, and can create various shield dimensions refer to silkscreen.
Soeey for my poor english ;)

Regards,
Marcin

yaqwsx, 2016-02-14:
I have a related question. I switched (or I'm switching) from Eagle to KiCAD. I've been used to special layer in eagle for component footprints. This layer contained drawing of the package. I find it very useful - it was easy to imagine the orientation of the components, PCB modules shape was there etc. However I haven't found any similar layer in KiCAD. Is there? Or is there just a silkscreen and 3D view?

El3ctr0nic, 2016-02-14:
I'm maybe poor expert but its only silkscreen i think. All footpints have
pin numer one in top left corner on default orientation.
 Pin should be marked in some way (check libs and chose some mark way). f.g
in this way. Read KLC for details
[image: Obraz w treści 1]

[image: Obraz w treści 2]

Ten e-mail został wysłany z komputera wolnego od wirusów chronionego przez
Avast.
www.avast.com <https://www.avast.com/sig-email>
<#DDB4FAA8-2DD7-40BB-A1B8-4E2AA1F9FDF2>

2016-02-14 18:32 GMT+01:00 Jan Mrázek <notifications@github.com>:

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

molavy, 2017-10-08:
i need develop custom arduino sheild, i found lots of libs and guide about eagle but none about kicad,
how can i find  arduino shield libs and guides in kicad

poeschlr, 2017-10-09:
Either make a footprint + symbol or make a template project. (The later has the benefit that you have all connectors documented. The former because it is easy.)

molavy, 2017-10-09:
@poeschlr did you answered me?

poeschlr, 2017-10-09:
Yes @molavy  the above is the short version of how this is done. I would advice you ask over at the [forum](https://forum.kicad.info/) if you need a more detailed descriptions.
(This is the repository for the official library. Issues should target the official lib. They are not here for general questions about how to work with kicad.)

molavy, 2017-10-09:
thanks

SchrodingersGat, 2017-11-21:
Closing, I think this is resolved, @molavy ?

Closed 2017-11-21.

Thread 403 (2016-02-22):

3D model for a 7mm resistor

Fat-Zer, 2016-02-22:
Currently there is no model for a 7mm resistor in the library. IMHO this is a quite major loss...

If nobody is going to fix it in a couple of days, I'm going to pull-request one, but I will make it with FreeCAD rather than wings.

Any comments / any good ready-to-use models / other volunteers?

Fat-Zer, 2016-02-23:
Ok, I've done a model... I was a bit confused what resistor is suitable for the "Resistors_ThroughHole:Resistor_Horizontal_RM7mm" footprint. I've decided to use dimensions for SFR16S from this datasheet: http://www.vishay.com/docs/28722/sfr16s25.pdf.

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

It differs from other resistors, by obvious reasons, but IMHO It looks a bit better.

Shackmeister, 2017-07-01:
@Fat-Zer hi, im case this is not relevant any more could you please consider closing this issue? :)

Fat-Zer, 2017-07-03:
Closing due to outdated as mentioned on https://github.com/KiCad/kicad-library/pull/408.

Closed 2017-07-03.

Thread 409 (2016-02-25):

KLC : Inclusion of Fab layer

CarlPoirier, 2016-02-25:
So let's discuss what to do with this layer.

Quote from J-P Louis on the ML: So to summarize, [Fab] layer should have RefDes (Reference Designator) and an outline of the part.
Quote from @michal777 : The rules to convention may be eg: max line width (smaller if necessary), max text size (smaller if necessary), drawing reflects components dimensions, no graphics inside.

I think this is ready to go into the KLC. Any comments?

michal777, 2016-02-26:
%R can't be plotted if set as invisible regardless of setting "Force plotting of invisible values/references" so shouldn't be hidden (or maybe it's a bug). Then there will be both value and reference on F.Fab and only the value can be disabled (uncheck "Plot footprint values"), %R will always be plotted and it will also be displayed even if References are unchecked (to disable %R all texts or the F.Fab layer must be disabled).
Values are still present on F.Fab. If they can't be plotted without RefDes they can't go to silkscreen (some people may want to print values on PCB), if they will be part of F.Fab as documentation layer they are too big.
Maybe it would be easier if %R were displayed and plotted such as real footprint reference - what about filling a bug report about that (is it really a bug?).

Having components outlines may be helpful for making simplified IDF models (only height is missing).

What about marking a pin 1?

pointhi, 2016-02-26:
> no graphics inside.

To clearify, so something like this is then not allowed:

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

CarlPoirier, 2016-10-01:
KLC 1.1: Fab layer contains value, reference designator and an outline of the part.

Closed 2016-10-01.

Thread 417 (2016-02-28):

wrong pad numbering for SolderWirePad... footprints in modules/Wire_Pads.kicad_pcb

mumme74, 2016-02-28:
There seems to be a error with SolderWirePad footprints where there are multiple pads in the footprint, all pads are number 1, should probably be in sequence like all other footprints

modules/Wire_Pads.kicad_pcb

keruseykaryu, 2016-02-29:
This question was discussed (I couldn't find it now). This kind of numeration is intended by the author.
These footprints are used for soldering multiple wires connected to a single point (net) on the board. This solution is widely used eg. in PC power units.

mumme74, 2016-02-29:
ok I thought it was a error.
No problem, I can choose another footprint

Closed 2016-02-29.

Thread 582 (2016-06-16):

KLC Rule 6.4: Anchor placement clarification

Telemin, 2016-06-16:
Technically a footprint question but asking here as this repo contains KiCad_Library_Convention.txt

> 6.4.  For surface-mount devices, footprint anchor is placed in the middle with respect to device lead ends. (IPC-7351)

I want to clarify what this means.  "Lead ends" makes sense for most parts but can be ambiguous in the case of  parts that don't have symmetry in both X and Y dimensions, for example flex connectors designed to be soldered directly to board, or some (usually side entry) surface mount connectors. (See below for an example of flex lead designed to be soldered and secured via mounting holes)
In this case `check_kicad_mod.py` wants to put the component anchor in the middle of the footprint, but that doesn't feel like a fit with the wording of KLC 6.4,and my initial instinct was to place the anchor at the centre of the pad array.  I'm also not sure how much this actually matters, but it's something that has come up for a couple of footprints I have made recently and intend to submit soon.

tl;dr In cases like this does the anchor go at the centre of the entire footprint, or at the centre of the pad array?

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

SchrodingersGat, 2017-11-21:
See new KLC here - http://kicad-pcb.org/libraries/klc/F6.2/

Sorry that you never received an answer to this.

Closed 2017-11-21.

Thread 605 (2016-07-06):

74xx and 74xgxx forced power pins

diggit, 2016-07-06:
All symbols from 74xx and 74xgxx libraries has power pins connected to GND/VCC and set invisible. This is OK in most cases, but I designed several devices with isolated parts and it was problem.
When there are 74\* chips on both sides of isolation barrier, you have to modify symbols to stay isolated.

Single part symbols are easy to modify (CNT, REG, MUX,...).
Multi part symbols are problem, there is not space, where you could place power pins (AND, OR, INV, NAND,...).

Does anybody else solved this problem?

SchrodingersGat, 2016-07-07:
I'd really like to see this fixed too. The way I see it there are three options:

a) Leave it as it is, people struggle along with invisible pins.
b) Change all the parts and make the Vcc / Gnd pins visible and give them a non-zero length
c) Create a duplicate of each part with visible pins (as in b) above) so that user have "options"

What do you think we should do @diggit ? I am happy to help with this, I can see it taking some time as there are a lot of parts.

At the same time we should try to improve the general quality of these symbols.

diggit, 2016-07-08:
I'd go b) way, but do you have any idea where to place power pins for multipart symbols like AND,OR,.. ?
- Maybe we can leave power pins where they are and set visible. I am surprised, that same pin name with power symbol is enough to connect it to same called power pin (net). Or is it something else? Is there any documentation about this behavior?

Once this is solved, we can discuss what improvements to do and start working on it.

jkriege2, 2016-10-04:
Hi!

yes, that is a huge pain for me too ... and I've seen this is e.g. also done for the NE555 (even worse). I would suggest a third option though, which I've seen in Target3001!:

d) add an additional part to the component, which contains only the power pins and which can be placed somewhere else on the sheet ...
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

Also this way, we can maybe write a script that removes the existing power pins and adds the new part to the component with defined distances and all ...

What do you think?

Best,
JAN

jkriege2, 2016-10-04:
Eagle also does it wioth option d):
http://dangerousprototypes.com/blog/2013/02/12/eagle-tip-gateswap-and-pinswap-tool/

jkriege2, 2016-10-04:
Just to clarify the problem I made a short test:
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

This leads to the following connections:
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

i.e. only if pins are invisble, they are automatically connected (555-GND is not tied to the GND net!

Hope that helps,
JAN

diggit, 2016-10-05:
I like **d)** way, but I thought KiCAD is not capable of drawing different graphics for each part of symbol. It is possible! I can't find how to do it in editor, but after direct editing of library file, I was able to do this.

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
*I tweaked design too, not important for now, resistor for size comparison*

What do you think about **d)** @SchrodingersGat @pointhi  @CarlPoirier

jkriege2, 2016-10-05:
As far as I saw by now, the only way is this: When drawing a multi-component Symbol, you can choose for each elemnt whether it is visible for all components, or only for the current component. THat's available in the properties Dialog for lines, Pins, ... (shortcut E)

cu
JAN

jkriege2, 2016-10-05:
I can try and make a quick test-comp (e.g. 7400+maybe 7490 to have one multi-comp and one single-comp device) in a branch sometime this week (or on the Weekend) and post the branch-link here ;-)

OK?

cu
JAN

jkriege2, 2016-10-05:
OK,
so I tried to do it for the 74LS00 and 74LS90. Here's the result (as I would like to have it):

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

You can look at the lib here:
https://github.com/jkriege2/kicad-library/tree/logic_symbols_with_separate_powercomponent
There is also a test project:
https://github.com/jkriege2/kicad-library/tree/logic_symbols_with_separate_powercomponent/library/doc/test_74xx_separate_power
that demonstrates the parts (then you can easily clone the repo and simply load that .pro-file!)

Doing this I noted several thinks (T), problems (P), KiCAD-problems (KP):
- T1: KiCAD has limited support for different units in one part, i.e. we can draw a different symbol for each unit and have the pins shared or not ... all fine
- T2: The components do not have to be all the same ...
- P1: ... BUT: The REF and Component-NAME are ALWAYS and in all units at the same position. So we either have to make very large parts, so both info fit into the middle (at least with my layout for the power pins), or we need a different layout for power (e.g. as above), or we give up on the requirement that the part is centered (I did it that way for the 74LS90 ... but that's a bit ugly then when moving the parts... all not nice
- P2: KiCAD does not seem to support unit-swapping, right? Otherwise: How can we say that the first 4 can be swapped, but not the last? => IMHO that would mean changes to KiCAD itself, e.g. by allowing us to say all are exchangeable, but Unit E is a Power-Symbol ... and then not exchangeable by default!
- KP1: It's a bit annoying that we cannot set the label-pin-distance for each pin separately, especially since then for clock-pins the text may collide with the clock-Symbol (collision is also for inverted pins and two-digit pin numbers)
- KP2: It would be helpfull, if one could also rotate the pin-label, e.g. for VCC and GND for the power-pin, or at least set the text beside-label/next-to-label property for each label separately. I worked a lot with Target3001! and there you can simply move+rotate the labels freely and while doing so it shows a line connecting the two for reference (like the label/REF on a PCB in KiCAD)
- P3: The whole lib is a mess (really ugly symbols, often not on 100mil grid etc. etc. and don't make me start on KLC
- P4: It would be a hell of a lot of work to go over the whole lib ... does anybody know whether there is a database or something available on the internet that specifies all 74xx/40xx ICs and from which we could generate the lib with minimal manual effort automatically?

Best,
JAN

SchrodingersGat, 2016-10-05:
Jan,

Regarding `P4`, I have considered this before, and perhaps something like [this](https://en.wikipedia.org/wiki/List_of_7400_series_integrated_circuits) would be a good starting point?

SchrodingersGat, 2016-10-05:
@diggit further to what @jkriege2  has said, here's how you specify which sub-part a graphics item is related to:

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

jkriege2, 2016-10-06:
Hhmmmm (about WP-page): Yes that could be a simple start. I searched a bit yesterday, but didn't find anything that could be converted automatedly. So I was thinking about starting with a script for the single gates, as they usually have a default layout (pin-compatibility!!!). The script should do the following:

- Say we want to alter the symbol for 7400, 74HC00, ... (i.e. first input a list of aliases)
- Then search for the record in the lib and replace it by the new record. The new record will be created by a simplified dataset as follows:
    1. name + aliases
    2. description+keywords+PDF-link (can maybe be generated automatically from WP & Texas Instruments ...)
    3. list of gates, e.g. ["NAND2", "NAND2", "NAND2", NAND2"]
    4. pins, either default-layout, e.g. when giving 4 2-input-gates, or giving 6 1-input-gates, or list of gates in a layout like this [I1.1, I1.2, O1.1, I2.1,I2.2,O2.1,...] ->[1,2,3,4,5,6,9,10,8,12,13,11]
    5. VCC+GND pins
- Then the script has hard-coded instructions of how to code the standard-gates (+power symbols) and we can at least generate update the gates.

For the other devices we would need more effort, either do them by hand, or do something like this: Have a file with entries in the format `# PIN NAME TYPE [LRBT]` for the single pins. Then one could have special record --- for a horizontal line and say === for typical separation of the indention form (see e.g. my 7490 between top and bottom half), e.g.:

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

I used `?UNIT` to start a new subunit and `?PWR` to start the power symbol. I'm not yet clear, how one could may the inside `&`-gates ... either we leave them out, ior alter them by hand later, or something like that (the & is a free TEXT that will be place within the innner compartment):
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
The `~~~ TEXT` would start a left inner box with all pins in it, until the next `~~~`. Then one would maybe have `+++` for an inner box from the right...

This way we could at least easily define the parts by hand once and the regenerate the library by only changing the script (i.e. the script defines the style). Also the script would not delete parts that were drawn by hand and for which there is no definition available in the script- ... does this seem good to you? But ... there are still a lot of things to clear up, e.g. where to store the script etc.

Best,
JAN

davidsrsb, 2016-11-23:
Why do we waste effort on the DeMorgan equivalents? I have never seen them used outside a lecture theatre.
I would be more interested in offering the octal parts as both full block and 8 sub-modules

lichau, 2016-11-23:
Jan, thanks for pointing me here.  My previous experience is with option d)--a separate symbol for power and ground.  While I understand the reason for hidden pins, I personally don't like them.  I screw up enough without stuff happening that I didn't do.  Or, do explicitly.
 I typically put the power/gnd blocks on a separate schematic sheet--usually with associated bypass capacitors.  That unclutters the main schematic sheet.

For large parts with many Vcc/GND pins, it seems that either hidden pins or a separate block are about the only way to go.

One of my reasons for considering KiCad is the schematic level error checking.  I really don't mind getting  a bunch of error flags, as long as I can turn them off.  In fact, I like it--makes me affirmatively turn them off.

Thanks for the help.

Rich, the NOOBie

koder68, 2017-01-14:
I was missing some circuits in the 74xx library and wrote a request to update it but now when I have read through this thread I realize things are moving in another direction. This is my opinion:

While I like the hidden power pins alternative d) is very reasonable. But going for a generationation strategy there is no need to choose. And the alternative symbols of library 74xx and ttl_ieee can be done at the same time.
If we create a file that describe the circuits functions it should be possible to create generators that create the libraries we want. One with the kind of symbols used by most parts in 74xx library. An alternative with separate power components, and the libraries with the more complex symbols of ttl_ieee can be generated from the same source file in variants with separate power pins and with hidden ones.

The tricky will be to create the description file so that it does not contain any presentation details while having enough information about function to generate the libraries. And of cource the de-morgan variants should stay.

I expect that the same strategy an be used for at least the 4000 library and likely for other components as well.

In a future the generation of the separate libraries should be replaced with direct generation within the schematic editor. Perhaps I would like to have unit A of a 74HC00 shown as the "old" style and unit B as the "new" style.

Regarding file formats I highly dislike making up new "flat file" formats as described above. An XML based format should be used to enable use of lots of premade code for specifying, parsing and checking.

jkriege2, 2017-01-14:
Hi!

please make a proposal for a fileformat then ... generally using XML is a god idea from the viewpoint of the tool (you don't need to implement the parser ...), but especially XML (but also JSON) has a VERY large overhead (especially when few info is stored, thing e.g. of a tag:
> <pin id="15" name="Q1" type="O" oreintation="R"/>
instead of a simple line:
> 15 Q1 O R
and is really pittysome to write by hand ... therefore I proposed such a kind of flat format!

Best,
JAN

bobc, 2017-06-21:
I thought I would have a go at writing a generator script as suggested by @jkriege2

For an input file

```
#
COMP 74xx574 IC
UNIT
2 D1 I L
3 D2 I L
4 D3 I L
5 D4 I L
6 D5 I L
7 D6 I L
8 D7 I L
9 D8 I L
SPC L
11 CLK CI L
1 ~OC I L
19 Q1 O R
18 Q2 O R
17 Q3 O R
16 Q4 O R
15 Q5 O R
14 Q6 O R
13 Q7 O R
12 Q8 O R
END
UNIT PWR
20 VCC P T
10 GND P B
END
#
COMP 74xx595N IC
UNIT
14 SER I L
SPC
11 SCK CI
10 ~SCL I
SPC
12 RCK CI
SPC
SPC
SPC
13 ~G
15 QA I R
1 QB
2 QC
3 QD
4 QE
5 QF
6 QG
7 QH
SPC
9 QH*
END
UNIT PWR
16 VCC P T
8 GND P B
END
````
The pin type and direction will default to the previous definition, or Input, Left if none. Pins are assigned in a top down fashion independently for left and right in the order they appear in the file.

The script generates a new library (for now) containing the components.

These look like this , Unit A
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

Unit B
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

This only handles simple box elements, and there are things like origin point to tidy up, etc. I will put the scripts in a github repo later.

bobc, 2017-06-23:
I've added code to handle NOR/OR, NAND/AND and a few other changes. The code is at https://github.com/bobc/kicad-symgen
Sample output
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

poeschlr, 2017-06-23:
Very nice.
Is it possible to fill the gate shapes as well?

bobc, 2017-06-23:
Sure, no problem. With 10 mil border?

poeschlr, 2017-06-23:
Might be a good idea. (I have not noticed that the border is thinner then the other units.)

bobc, 2017-06-23:
> Is it possible to fill the gate shapes as well?

Actually, maybe not so easy. OR gates do not fill properly
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
I would have to replace the arcs with a polyline.

jkriege2, 2017-06-26:
possibly one has to put a filled polygon BEHIND the lhs of the gate ...

In genertal: Exactly what I proposed :-))) GREAT WORK!

As you're currently designing the gates: I think in general they should be significantly smaller ... I tried to get that done within the KLC (see my screenshots above, post from Oct 5th) ... maybe we could even make a KLC exception for gates that it is OK to place pins on a 50mil raster (as we do for small devices, such as R,C,diodes,transistors, ...) @SchrodingersGat What do you think on a KLC-exceptio for that?
Best,
JAN

bobc, 2017-06-26:
I couldn't find any way to fill OR gates without using a polyline to trace the complete outline. I am reluctant to do that, because I don't want to add extra drawing overhead to eeschema, which can be quite slow on moving large chunks of schematic.

It's very difficult to make the gates smaller and keep to KLC, so a waiver would be very useful. 74xGxx lib has small symbols, which for consistency would be nice to re-use, but the 74xGxx symbols fail KLC check in many ways.

I have a logic symbol set that is about 70% smaller than the current symbols, which is KLC compliant but probably still not as small as some would like.

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

diggit, 2017-07-04:
Here is my entry to gate design contest!
Pins are on 100mil grid. Pins could be smaller without numbers. Sorry for noodle aspect ratio. Ignore pin numbers and pin types.
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
Some passive components for scale.

evanshultz, 2017-07-04:
Personally, a dislike having a box for the power pins. I prefer them to be two floating pins. Yay or nay?

diggit, 2017-07-04:
Pins with intelligent spacing (distance like capacitor or so) should be OK. I am ok with or without box.

bobc, 2017-07-05:
Well, someone objected to the "floating pin" format, so I changed to box. If you like, I can create an alternative (de morgan) which has no box.

(It's a pity there is not more than two alternatives, otherwise we could create a complete set of alternative symbols and the user could scroll through until they find one they like).

@diggit Those look great, I will try to adopt them. Even better if you could post a .lib file with those shapes in :)

SchrodingersGat, 2017-07-05:
> (It's a pity there is not more than two alternatives, otherwise we could create a complete set of alternative symbols and the user could scroll through until they find one they like).

It's a good start, and IIRC the "new" lib format allows for `N >= 1` symbol display versions.

diggit, 2017-07-05:
@bobc sure, here it is [gates.zip](https://github.com/KiCad/kicad-library/files/1126017/gates.zip), it was just concept, so it is all one symbol. Most of time, I was tweaking OR gate size and pin lengths. Pin and lines are there on purpose to align pin numbers properly for normal and inverted outputs...

Closed 2017-09-21.

Thread 633 (2016-07-30):

Helping the library maintainers

yaqwsx, 2016-07-30:
Hello,

when KiCAD 4 came out and brought centralised library, which is community-developed, I immediately switched from Eagle to KiCAD, as the libraries are the biggest pain in PCB CADs and I think community-developed library is the right way to go (at least for open source project).

I watch the library and I also tried to contribute multiple times. I think the contribution process is really, really slow and it degrades the wonderful idea of community based library. There is also a ton of months old PRs with no reply! I think all of this may be harmful to the whole project because it can discourage people from further contributions and also leads to duplicates:
- many opened PR are mess, people do a lot of duplicate work (because they didn't noticed already existing PR) and it can discourage potential contributors
- the changes are merged slowly, the upgrade process of local library in KiCAD is unclear. I think almost every user wants fast deliver of the library!
- when there is no response to the PR, contributor might feel unwanted and will never contribute again...

Don't get me wrong, I don't want to complain or blame you. I understand that there is a lot of work with such a huge library maintenance and there are not enough people and time. I just want to point the obvious problem and ask (and discuss):
## What can we (the contributors) do to help you (maintainers)?

I really like the library idea. I want to help it happen (and I think I am not alone who wants to help). What should I do (when contributing or when I have a free time I want to invest in KiCAD) to help you the most?
## My notes
- I noticed there are screenshots of footprints/symbols attached to some of the PR. I find it useful, does it help you, when reviewing the PR? Or is it useless (and I should not do it)?
- Do you like having PR commented/reviewed by the community? Many maintainers hate it my experience (they probably think somebody tries to to their job) and it discourages me from PR commenting (like "This PR seems OK to me and if I was the maintainer I would merge it", "This PR seems dead to me, shouldn't it be closed", etc)

PS: I am not sure if issue is the right place for asking this/opening the question, however I haven't found a better alternative (enough readers, permanent/history, etc)

SchrodingersGat, 2016-07-31:
Thanks for the input :)

**Screenshots**
Where appropriate, screenshots can be *very* helpful, especially to demonstrate a simple change.

**Adding notes**
Many PR are submitted without any description (or without a *good* description). A succinct note describing what you have added or changed is an amazing help and assists in directing the focus of the librarians.

**Commenting on open PRs**
I don't think any librarian will complain that someone is trying to assist - there's a lot of open PRs and only few librarians. As long as the comments are helpful or drawing attention to an old PR for example, I don't see a problem. Any long tangential discussions should take place elsewhere. If someone is commenting too much, one of us will certainly mention it.

**Know the KLC**
The biggest help is knowing good practice for submitting PRs that fall within the library convention.

* Look at the KLC rules
* Look at other similar parts / footprints
* Be consistent as far as reasonable
* Ask if unsure

I hope this helps. Anything that makes the lives of both the contributors and the maintainers is only a good thing.

jacobrosenthal, 2016-08-19:
We could use [github templates](https://github.com/blog/2111-issue-and-pull-request-templates) to list your bullet points to check. But for something like screenshots instead of forcing the user, lets automate that with a bot that can screenshot and run whatever python scripts are already run against them.

SchrodingersGat, 2016-08-19:
The github template looks like a cool feature - was not aware of that. I agree that the screenshots should not be the work of the user, it's something that should be automated.

jacobrosenthal, 2016-08-19:
Does anyone have a good idea on grabbing a screenshot programmatically? I saw cpavlina might have done something in https://github.com/cpavlina/kicad-schlib-preview/issues/1

What scripts should be run against the incoming libraries?

SchrodingersGat, 2016-08-19:
The work that @cpavlina has done there looks great! (I wish I had known about this earlier as I started to write such a script myself! There's a few hours I'll never get back)

This looks like it would be the tool to use. An interesting idea would be to add a graphical-diff feature, highlighting changes between the images!

KLC scripts (as they currently stand) are here https://github.com/KiCad/kicad-library-utils - they have a description with them also

SchrodingersGat, 2016-08-19:
If we can find / make / co-opt a library to make image previews of the symbols and the footprints, this should be included into kicad-library-utils.

jacobrosenthal, 2016-08-19:
@SchrodingersGat Response from cpavlina

> https://github.com/cpavlina/kicad-schlib/blob/master/Makefile
https://github.com/cpavlina/kicad-schlib/blob/master/scripts/schlib-render.py

Ill take a look at that eventually if you don't, but I'm still taking a look at ci options and how the hell to tell which files have changed. Were an odd case here because were not testing the entirety of the code base like normal ci would, I just want to know which files were touched in all commits to be merged, and run those python scripts on them..

SchrodingersGat, 2016-08-19:
It's even worse than that - for the case of the .lib and .dcm files, we only want to look at the individual components that have changed (within those files!)

The .pretty repositories are easier as the footprints are stores as individual files.

ricardocrudo, 2016-08-19:
> Does anyone have a good idea on grabbing a screenshot programmatically? I saw cpavlina might have done something in cpavlina/kicad-schlib-preview#1
>
> What scripts should be run against the incoming libraries?

Yes, I did. Check it here: https://lists.launchpad.net/kicad-developers/msg23836.html

Unfortunately, I didn't have time to go ahead with the development and make a proper implementation. Ideally, a tool like this would be integrate with the, already working, checking scripts on the Jenkins.

Another idea I have, and I'm sure it is very helpful, is to attach the pins information (e.g.: the pin type) along with the PR image or (probably easier) in the PR comments. Like following.

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

In general, make more information available in the PR, surely will make the evaluation process faster. By "make more information available" I mean automatically. However, while such integration is not working yet, I agree with @jacobrosenthal, a template might help.

jacobrosenthal, 2016-08-19:
I see the current tasks as
- [ ]  Get the files affected via the PR object or via the github pull api https://developer.github.com/v3/pulls/ so also need to find a ci provider that actually passes through the github pull request json from the web hook (drone.io doesn't it seems..)
- [ ]  Find out if either of the existing screenshot scripts will work headless on a server or docker container
- [ ]  Figure out how to isolate the .lib and .dcm components affected by the change

jacobrosenthal, 2016-08-20:
Pretty first because thats way easier. Was hoping to do this as a one liner but python script was a pain to alter to take std in file list, are we up for altering that? Also it should be altered to give an exit code.
```
#!/usr/bin/env bash
FILES="$(curl https://api.github.com/repos/KiCad/Shielding_Cabinets.pretty/pulls/6/files | jq -r '.[] .filename')"
python check_kicad_mod.py $FILES
```

jacobrosenthal, 2016-08-20:
blah, forget argparse
```
./check_kicad_mod.py `curl -s https://api.github.com/repos/KiCad/Shielding_Cabinets.pretty/pulls/6/files | jq -r '.[] .filename'`
```

SchrodingersGat, 2016-08-21:
Sweet :) I'm making some good progress on integrating script-based rendering into the KLC scripts also!

jacobrosenthal, 2016-08-21:
@SchrodingersGat you wanna add exit codes to check_kicad_mod.py. Im presuming any violation at all is a non zero exit?

jacobrosenthal, 2016-08-21:
Seems like no reason not to test the entired changed library files, even if they didnt touch all of them. If anything the unrelated violations could be ignored or better yet, we can ask the submitter to clean that file up for us?
A similar one liner that just throws dcm and lib at checklib.py dcm seems to just bounce off it so probably ok.
```./checklib.py `curl -s https://api.github.com/repos/KiCad/kicad-library/pulls/616/files | jq -r '.[] .filename'````

Which file is supposed to check dcm?

Im working on figure out the line number changes so we can only make screenshots of the appropriate components still.

jacobrosenthal, 2016-08-21:
I cant find a good rule of thumb for how many context lines are included in order to remove them from the result, might have to just count them (best way would seem to be lines that start with a space

Heres a one liner for getting line numbers from the patch...Still has the comma in it, but i guess well split on that in the next step
```curl -s https://api.github.com/repos/KiCad/kicad-library/pulls/616/files | jq -r ".[]  | select(.filename == \"library/dc-dc.dcm\") | .patch" | grep -Po '\+\K[0-9]+\,[0-9]+'```
```
1,11
208,12
670,12
784,64
854,47
1021,12
1063,12
1098,16
1306,4
```

SchrodingersGat, 2016-08-22:
My *nix-fu skills are somewhat lacking, so I might not be much help with your scripts above.

However I did have an idea for working out which components have been changed within a library.

We already have a set of python scripts that can parse a .lib file and extract symbols. If we add a line to the Component object that calculates a simple checksum, then you can run the old file and the new file through the script, and only throw up output messages for components where the checksums have changed, or if they are new components?

Would this be easier or harder than looking at the raw file information? I'm not sure how the script would access the "master" version of the file (does it pull it down from github?)

jacobrosenthal, 2016-08-22:
Sounds simpler... except for getting the original file.. Most ci will pull and merge the pr, but yeah git clone or something

jacobrosenthal, 2016-08-23:
clone a bit heavy, looks like you can wget or curl https://github.com/KiCad/kicad-library/archive/master.zip

jacobrosenthal, 2016-08-25:
I note the Kicad project uses Jenkins, but Im not familiar and thats pretty heavy to get started on so I just put it up on circleciI for no. Heres what what Ive posted so far for kicad_mod's
so you can see what Commit Status API result looks like:
https://github.com/jacobrosenthal/Shielding_Cabinets.pretty/pull/1

You can PR into my fork to see the results there or just grab the test.sh script out of master and run it locally, you just need to provide it the environment variables the ci server would be giving it like
```CIRCLE_PROJECT_USERNAME="jacobrosenthal" CIRCLE_PROJECT_REPONAME="Shielding_Cabinets.pretty" CI_PULL_REQUEST="https://github.com/jacobrosenthal/Shielding_Cabinets.pretty/pull/2" ./test.sh```

CarlPoirier, 2016-08-28:
Hi @jacobrosenthal,

Your input on the matter is greatly appreciated!

I do like the part checksum idea. Is it possible to store somewhere the checksums of the master branch and simply update them when needed instead of downloading the whole repo?

SchrodingersGat, 2016-08-29:
Have a look at how I've implemented the checksum here - https://github.com/KiCad/kicad-library-utils/issues/47

You only need to look at the .lib files that have actually changed, and the checksum doesn't need to be stored anywhere

SchrodingersGat, 2016-08-29:
Sorry, here's the actual code. https://github.com/KiCad/kicad-library-utils/pull/48

CarlPoirier, 2016-08-31:
And it's merged!

jacobrosenthal, 2016-09-01:
Since we already have a nice list of files, we can just wget them individually from raw.githubusercontent.com rather than the entire kicad-library since its so big

Anyone have a preference on screenshot methodology?

Who needs help with what.

jacobrosenthal, 2016-09-01:
Seems like youll want to probably do more of this in python yet, but Ill still keep problem solving in bash

Playing with this script https://github.com/jacobrosenthal/kicad-library/blob/master/test.sh to wget changed files and throw them at the new comparelibs.py

I posted here https://github.com/KiCad/kicad-library-utils/pull/48#issuecomment-243970675 but I think we could make comparelibs.py more parseable for the next step with + and - signs for components changed.

SchrodingersGat, 2017-10-06:
Closing this issue due to age.

Closed 2017-10-06.

Thread 687 (2016-09-11):

KLC update 1.1

CarlPoirier, 2016-09-11:
Rules to be added:

3.9: For components with a single default footprint, footprint field is filled with valid footprint filename of the format "Footprint_Library:Footprint_Name" and is set to invisible.
6.10: Fabrication layer contains the reference designator having height 2.0mm or smaller if needed and an outline of the part using a 0.10mm line width.

Rules to be modified:

6.5: Silkscreen is not superposed to pads, its outline is completely visible after board assembly, uses 0.12mm line width and provides a reference mark for pin 1 (IPC-7351C).
6.6: Courtyard line has a width 0.05mm. This line is placed so that its clearance is measured from its center to the edges of pads and body, and its position is rounded on a grid of 0.01mm.

Rules to be removed:

6.9

CarlPoirier, 2016-09-14:
After discussion on the mailing list, 10.4 will stay as is, meaning values are left on the fab layer.

CarlPoirier, 2016-10-01:
It's online in the Wiki.

Closed 2016-10-01.

Thread 726 (2016-09-27):

TO-18 model pin 1 tab orientation is incorrect.

stambaughw, 2016-09-27:
I was working on a board and discovered that the pin 1 indicator tab on the TO-18 3D model does not match the footprint silk screen.  According to the documentation that I have seen, it appears that the footprint silkscreen orientation is correct.

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

diggit, 2016-10-01:
Thanks, confirmed, model has tab on incorrect position.

If you have some 3D modelling skills, we are open for fixes. Current 3D model looks bad anyway.
Otherwise, I can take a look on it, not sure when.

jkriege2, 2016-10-01:
I made a small fix:
https://github.com/KiCad/kicad-library/pull/734

stambaughw, 2016-10-02:
Look great!  Thank you for the quick response.

Cheers,

Wayne

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

jkriege2, 2016-10-28:
new 3D models are available now (https://github.com/KiCad/kicad-library/pull/734 merged), footprints still need to be merged (https://github.com/KiCad/TO_SOT_Packages_THT.pretty/pull/12)!

Best,
JAN

SchrodingersGat, 2017-02-23:
Ok to close this one @stambaughw ?

SchrodingersGat, 2017-02-23:
New footprint and 3D model have been merged

jkriege2, 2017-02-26:
This should be fixed now also with the new footprints https://github.com/KiCad/TO_SOT_Packages_THT.pretty/pull/14

Closed 2017-02-26.

Thread 799 (2016-11-20):

Some libraries have at end of lines the CL+RF symbols

michalkona, 2016-11-20:
These libraries have at end of lines the CL+RF symbols: Worldsemi, device, mechanical, motors, silabs, stm32, switches and texas

It might cause of big conflict.

SchrodingersGat, 2016-12-06:
I see CL+RF at the end of lines of all libraries - can you show an example?

michalkona, 2016-12-08:
Because you are using windows:
https://git-scm.com/book/tr/v2/Customizing-Git-Git-Configuration#Formatting-and-Whitespace
https://help.github.com/articles/dealing-with-line-endings/#platform-windows

bradfa, 2017-02-09:
This is quite widespread actually, it seems to affect .lib, .dcm, and .wrl files.  As of my counting right now (commit 1643c5ced7183a32e251f229ad58ba5849db5629) there are 915 files in the kicad-library repo which have DOS line endings.  This should be able to be fixed by using a .gitattributes file to specify a line ending to always use and making one big cutover commit to change all files in the entire repo at once.

bradfa, 2017-02-09:
I need to do some quick testing to make sure I haven't' broken anything but if that goes well then I'll submit a pull request.  Testing may take me a few days to find time to load KiCad on a Windows machine and to make sure the Windows git isn't messing with the repos (when installing git on Windows, it asks you how you want to handle line endings and the default is to commit Unix style but checkout locally DOS style).  But if anyone else wants to have a look and make any comments or corrections before I submit a pull request I'd be very excited to receive them.

SchrodingersGat, 2017-02-09:
@bradfa thanks for pointing this out.

I have submitted a PR to address this here: https://github.com/KiCad/kicad-library/pull/988

This is my first time using a .gitattributes file and you seem to have knowledge on them - can you check over the .gitattributes file there?

SchrodingersGat, 2017-02-09:
I have processed the .lib and .dcm files. The .wrl files are taking a long time.

jkriege2, 2017-02-09:
I merged https://github.com/KiCad/kicad-library/pull/988. Maybe we should also add these line-ending requirements to the new KLCs? SHould we do the same for the .pretties?

JAN

SchrodingersGat, 2017-02-09:
Yes I was thinking we need to add this as KLC.

Same for the pretties. It'll be annoying to do this for all the pretty repos (I may have to write a script for that).

(As a side note, I am trying to work on a document to convince the dev team that it's a MUST that all .pretty repos are merged!)

bradfa, 2017-02-09:
@SchrodingersGat if you have a look at https://git-scm.com/docs/gitattributes it gives a good overview of .gitattributes.

@jkriege2 I think it would be good to convert over the .pretties as well, but that's a bit more manual work due to so many repos.  It may not be needed to be added to the KLC as people won't understand because git will just do the right thing if the .gitattributes file is made correctly.

bradfa, 2017-02-09:
@SchrodingersGat there's some nice exact steps at the bottom of https://git-scm.com/docs/gitattributes on how to do the changeover for line endings.  My commit has about 8 million lines changed and 888 files, while yours has a bit less... I worry there's a lot still missing.

SchrodingersGat, 2017-02-09:
I am still working on the other files types, only done .dcm and .lib so far

SchrodingersGat, 2017-02-09:
Here we go https://github.com/KiCad/kicad-library/pull/990

bradfa, 2017-02-09:
@SchrodingersGat you may want to just do

```
*       text=auto
```

And then just call out the binary file name extensions which git gets confused by (like .png and .wings, as they seem to have ASCII data in them near the beginning).  I believe this would do what you want, I just haven't had time to check this on Windows, yet.

SchrodingersGat, 2017-02-09:
hmm good point. I started calling them out individually then the number of file types kept increasing...

MrMartinZockt, 2017-02-12:
> I have processed the .lib and .dcm files. The .wrl files are taking a long time.

If I'm not mistaken, then "library/motor_drivers.dcm" and "library/motor_drivers.lib" are still with CR+LF.

SchrodingersGat, 2017-02-12:
Looks like subsequent PRs have changed line endings back to CR+LF.

I have changed the .gitattributes to enforce LF in https://github.com/KiCad/kicad-library/pull/998

SchrodingersGat, 2017-03-03:
@michalkona was this addressed to your satisfaction? Please close if so :)

Closed 2017-03-17.

Thread 808 (2016-11-29):

Add metadata to libraries

kuro68k, 2016-11-29:
Libraries should have consistent metadata added to each component, to make BOM generate easier and more consistent.

Apologies for not submitting a pull request, but it seems that you can't for wiki entries.

There is some discussion here: https://forum.kicad.info/t/default-manufacturers-part-number-field-in-kicad-libraries

I propose adding the following to the wiki page on library conventions. This will allow BOM generation plug-ins to be much more compatible and uniform, and save users time editing metadata manually. The goal would be to have the BOM generated directly from the schematic with minimal editing afterwards, and to facilitate tools like automatic order generation at suppliers.

To this end, metadata must be consistent and predictable. Normalization is key.

### 5. Symbol metadata

1. Value should be ~blank~ R/C/D/etc. for passives like resistors and capacitors, or the primary differentiating factor for ICs (e.g. 32k for a 32k variant of a microcontroller).
1. Add an ~"MFP"~ "ManufacturerPart" hidden field with the manufacturer's part number.
1. Add an ~"MFN"~ "ManufacturerName" hidden field with the manufacturer's name.
1. Add a "fit" hidden field, set to "true" for things that require parts and "false" for things like jumpers, solder pads, markings, edge connectors etc. that don't generate any items on the BOM.
1. Add an optional "data" hidden field with relevant data on precision, voltages/current limits etc. Should be omitted for generic parts.
1. Add an optional "notes" hidden field with any relevant textual notes, e.g. why pins were swapped.
1. Empty fields should have a single underscore ( _ ) to prevent them being stripped out.

keruseykaryu, 2016-11-29:
@kuro68k: "Value should be blank for passives (...)"
If you left Value field blank, it won't be possible fast editing with just a double click on schematic. You will not see then where there a field is!

As regards to the demands in 2, 3. Such an approach requires a change in thinking and the transition from universal symbols for specific symbols. At the moment, it is not rather possible to push through. (I've tried).

TotalKrill, 2016-11-29:
Good initiative!

Might just suggest that a default value for MFP and MFN is decided upon. Maybe just leave blank or something for components where this is not as important or for people who do not wish to use them. (Resistors, capacitors etc). So that people who contribute is not forced to fill these fields, but they are there to be filled correctly by somebody else at a later time.

Also, do not leave passives value empty.
(shortcut key V is a quick acccess to the value field)

kuro68k, 2016-11-29:
@keruseykaryu: Good point. Okay, revise values for passives to be as they are now, e.g. just R for resistors, C for capacitors etc.

@TotalKrill: I think blank for generic parts would be a good idea. You could go with "generic" or something but I don't see much benefit to that. Being blank would allow BOM generators to fill in with, say, "none" as required.

Generally speaking I think it's best to avoid language specific terms where possible. Again, BOM generators can handle that, e.g. translating the fit flag into "fit/no fit" for English, 「ある・なし」 for Japanese etc.

kuro68k, 2016-11-29:
Joan_Sparky suggested filling blank fields with a single underscore ( _ ) to prevent the component editor from stripping them out.

jkriege2, 2016-11-29:
Hhmmm ... I'm not so sure how good an idea this proposal is ... Please consider the following points:
1. Who is supposed to provide the data? And if it is there ... who is supposed to check it?
2. Who tracks changes?
3. Which part numbers/manufacturers should be put in? E.g. LM741 is available from TI, Intersil, ...
4. How do you guarantee consistency of the manufacturer names? Say someone write "TI" someone else "Texas Instrument", a third person write "Texas Instruments Incorporated"? This calls for a relational database scheme, which seems a bit out of the scope of KiCAD and its libs (currently I would say there are more pressing things in the libs to do).
...

Just a first set of thoughts on that ...

Best,
JAN

jkriege2, 2016-11-29:
One more thing: IMHO, the names should be more readable, not just an abbreviation, but full words, which makes it easier for newbies and people not using this system to identify what these fields are, e.g. ManufacturerName instead of the rather cryptic MFN.

JAN

SchrodingersGat, 2016-11-29:
While I appreciate the desire to have these extra data present in the default libraries, I see some potential issues.

## Consistency
In addition to the good points made in the forum and above, there are some further concerns regarding part consistency. e.g. many ICs have dozens of part-name variants (within a single manufacturer, and many more if you consider alternative parts from other manufacturers). Some variants are functional, some are ratings (e.g. Automotive Temperature) and some are non-functional such as PbF, packaging options, etc. So for a single IC you either specify **exact** MPN values *or* you specify a somewhat generic version which is essentially what the libs have now.

Further, point 4) that @jkriege2  made above is a good one.

Many companies keep track of internal part numbers instead of MPN values, and so would this be of any benefit to them?

## Aliases
The current ALIAS functionality of the libraries would not work with this scheme, as the part fields are stored in the SYMBOL (.lib file) and not the PART (.dcm file). Any ALIASed parts would take on the extra fields of their master symbol, and so many of the existing library components would break.

## Library Format Upgrade
The symbol libraries are going to be updated to the .sweet file format *soon^*. From what I have seen, this will provide much greater flexibility in terms of the ability to decouple the graphical symbol from the part description. This is a must-have feature for adding custom part fields. Perhaps this idea should be held until that is implemented?

*^For certain values of "soon"*

## DNF Field
I like the idea of a DNF field but I think it should be extended beyond True/False, and allow configuration management by specifying the board configs in which a part should be marked as fit/dnf. This is how I manage this problem in my [BoM Tool](https://github.com/SchrodingersGat/KiBoM).
The DNF field should really be a default field in KiCAD software rather than an "extra" field in the part lib.  Hopefully this is addressed in the upcoming .sweet file format.

## Data Field
To start, I think that the "Data" identifier is very generic, it would be better labelled as "Rating" or similar. However, the purpose of this field is still pretty opaque given it has to cover all parts. A "simple" capacitor has voltage rating, temperature coefficient, ESR, etc. FETs have various voltage ratings, capacitance values, etc, etc. How do the librarians decide which params are important enough to go here?

Ideally, I would like to see the (new) library format contain a "Ratings" section which is a list of key-value pairs, each of which could then be searchable within KiCAD. They could be compressed together into a single field for the purpose of BOM generation. However this is a "wishlist" item and outside the scope of this issue.

SchrodingersGat, 2016-11-29:
Check out the final page of this document (https://lists.launchpad.net/kicad-developers/binkLP4zB3dYN.bin) for a peer into the future, which looks like it should be much more suited to these data.

(I had to rename this to a .odt to open it, YMMV)

kuro68k, 2016-11-30:
@SchrodingersGat, I would suggest generic part names. The user can fill out the specifics themselves. The goal isn't to have the defaults produce a working BOM first time, it's just to a) establish a standard that both libraries and users can make use of and b) lessen the workload a little.

More over, I think the way the libraries are arranged now with aliases isn't optimal. For example, you have a random microcontroller that comes in five more or less identical variants, the only difference being the memory size. At the moment there are five different schematic symbols, but really it should be one symbol and just put the memory size in the metadata. Aside from anything else, then you don't have to delete the whole symbol just to switch to a different variant, in the same way you wouldn't delete and replace a resistor just to change it's value.

You are right about the data field, but it's not actually all that important I think. Libraries won't really make much use of it, it's more for users. They can put what matters to them and their BOM in there. For example I tend to have a default capacitor rating of "ceramic X5R/X7R 16V", and only bother to add metadata to parts that are different. The BOM then has a note says "all ceramic X5R/X7R unless otherwise stated".

jkriege2, 2016-11-30:
@kuro68k : Your point on aliases I don't really understand: Currently Aliases do just that (except the fields, but that's due to the Implementation in KiCAD): You have one symbol, but define several ALIASES that only consist of an entry in the ALIASES and their specific description+keywords+datasheet (in the DCM-file) ... Deleteing an alias is therefore lightweight.

About the data field: I see the problem in "They can put what matters to them" ... The question there is: so what should we put in in the libs? Should it be left blank? How should we check bew symbols that are proposed for the lib? Which data should we require and which reject? Should we enforce any format, or just accept anything? In the latter case: What is the use to other users?

About names: Could you provide an example (take e.g. the 741 or 555, which are available from many sources and in many packages, or a simple 74LS00 ...) of how you think the names should be?

Best,
JAN

kuro68k, 2016-11-30:
@jkriege2: What I mean is, say I have a schematic with a resistor and an MCU. I want to change the resistor's value, I just edit the value. I run out of code space and want to change to a larger memory MCU, I have to delete the symbol, replace it, copy the old reference if assigned, set any metadata and hidden/shown stuff, re-do any field moves etc.

They should work the same way. The alias system doesn't let you swap aliases easily as far as I can see, and seems kinda pointless where the only difference is some numeric value that can be written in.

As for the "data" field, the libs would mostly be blank. They are there for the user to fill in. In fact I'm struggling to think of an example where a library would use it.

I'm not sure we need a specific format for it. It's there for BOM generation, so the two use cases are 1) the user wants relevant information on the BOM (e.g. use 1% resistor) and 2) the BOM generator wants to auto-select a part from a supplier in which case just matching space separated strings should be enough (e.g. "X7R 16V" could search Mouser for the value and the keywords "X7R" and "16V"). The latter might benefit from a simple "/ for logical OR" rule so that "X5R/X7R" will be interpreted are "X5R or X7R" when searching.

Names: The current scheme of using 7400 or 555 is fine, the same as the part names in the libraries. Such parts are more like generic passives than manufacturer specific ICs. If the user wants a particular variant they can fill that in themselves. BOM generators that also order parts will need to have some intelligence to handle those special cases.

jkriege2, 2016-11-30:
@kuro68k : So what you want are mostly default-empty fields (data, ...), or stuff that is not currently doable with the KiCAD features (value, swap). So all of this seems to be more of a KiCAD and less of a library topic. Wouldn't it be better to ask the KiCAD developers to add some default fields to KiCAD that simply appear there also when not explicitly defined in the lib. Should somebody define them in the lib, that case will be covered automatically and we should then decide how to fill these fields, when we know which system is implemented in KiCAD.

Also the question of who checks these info (if supplied) atc. are still open ... Please keep in mind that there is currently only a small team of lib maintainers and progress is sometimes relatively slow ... so adding even more work will not really help to improve the general libs ... at the moment.

Best,
JAN

kuro68k, 2016-11-30:
@jkriege2: No, I'm not saying that. I'm saying let's come up with a standard and stick to it.

For libraries, the main change would be the way the "value" field works, and the way that some parts have many aliases for what are essentially different values.

The reason it needs to be done here is because the library conventions page on the Wiki is the only documentation and would need to change in any event. You do have a point, there is a need for a global standard on metadata that BOM plugins can rely on, but I'm working with what we have.

I don't think there is any need for Kicad to generate these fields. If they are not there then the BOM generator can easily ignore them. The empty fields was simply to save the user effort - it's relatively easy to add them to the libraries ready to be filled in.

I'll for the project and see if I can bulk update some libraries as an example.

jkriege2, 2016-11-30:
Hi!

I'm really confused by now ... Could you please - very simply with a few easy examples, say on typical discrete like R and one more IC like 741/555/7400/... - write down what you proposal would mean! Also e.g. consider a microcontroller family such as ATmega88P and varaints (see http://www.atmel.com/images/Atmel-8271-8-bit-AVR-Microcontroller-ATmega48A-48PA-88A-88PA-168A-168PA-328-328P_datasheet_Complete.pdf).

If you say there is no need for empty fields pre-generated by KiCAD, but also say that mostly the fields should be empty in the lib, I don't see what you really want!

The KLC-page defines Standards that symbols for this lib have to (mostly) follow, in order to be accepted. So if you set up these rules, you require people to stick to them and generate those fields (as otherwise symbols without the fields won't be accepted anymore), unless you say they are strictly optional (then that should be in your proposal). Still, even if they are optional, the questions of checking and formatting (also of the different ManufacturerNames) remains, if somebody supplies the data!

> For libraries, the main change would be the way the "value" field works,
OK, I think here some examples would really help (see above)

> and the way that some parts have many aliases for what are essentially different values.
What would you propose here? A change in KiCAD, or a change how we use the current structure (no ALIASES anymore, as currently they only have the one provided functionality)?

Best,
JAN

SchrodingersGat, 2016-11-30:
I am also a bit confused. Isn't this functionality already available to the user? In eeschema, under *Schematic Editor Options*:

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

If you want blank default fields for all components...

kuro68k, 2016-12-01:
Okay, for R:

```
Library:
Name = R
Value = R

User:
Data = 1% 0.125W
```

For the MEGA:

```
Library:
Name = ATMEGA48A-A
Value = 8K
ManufacturerPart = ATMEGA48A-A
ManufacturerName = Atmel
```

Aliases can be used with the Atmel MCU to generate the other parts in the range, but all they need is metadata changes and the user can easily switch. Ideally they would all be normalized into a generic `ATMEGA48-88-168-328A-A` part but it's not critical.

For the 555, currently we have an LM555N. Well, the original was the NE555 so IMHO it would make sense to list it under that name, but whatever...

```
Library:
Name = NE555
Value = [none]
ManufacturerPart = NE555
```

I omitted the manufacturer name here because so many people make it these days. If you go to Farnell or Mouser and search for NE555 it will bring up compatible variants like the LM555 from Texas.

It's not complicated. All we need is enough metadata in an agreed format to allow BOM generators to do their work.

kuro68k, 2016-12-01:
I just made a new part for work:

```
Value = MCP1640
Datasheet = www.microchip.com/datasheet/MCP1640
ManufacturerName = Microchip
ManufacturerPart = MCP1640T-I/CHY
```

If I want to use a variant all I need to do is edit the ManufacturerPart field, and maybe the value just to make it clear on the schematic. This way the value isn't overly specific; the part name contains the temperature range and package, things which are irrelevant to the schematic (which explains the function of the circuit) but important for the BOM.

jkriege2, 2016-12-01:
OK, slowly I see where you want to go with this ... atill I'm not so sure about some things (from the practical POV of a lib maintainer):
1. If we do that, the fields should be there by default in KiCAD ... otherwise most contributors won't add them (IMHO), or we get a mess of differently named fields (case, typos, ...)
2. Today we don't even use the datasheet field, as it is also in the DCM-files
3. This means we will mostly have to abandon the current ALIAS mechanism, as it does not allow to alter the fields (except the special fields description, keyworkds, datasheet, i.e. F1-3), which I really dislike as it makes a mess of many libs (e.g, transistors ...) ... although I would love to have an alias mechanism that covers fields properly, so we can have ALIASes e.g. with different packages.
4. Still you didn't answer to the question  of **how to maintain consistency** (e.g. ManufacturerName) and **who should enforce/check these rules** ... I think this will really create a lot of work (already now there is really a lot of work included in reviewing parts)! SO library maintenance and improvement will slow down even more ...
5. Should these rules be optional or required?

best,
JAN

kuro68k, 2016-12-02:
In reply to your questions:

1, 2, 4, 5: These issues can be solved by creating a really table based editor for libraries. I'll look into doing it if I can find the time. Basically if we can bulk edit parts in a table format, perhaps in a CSV file via a spreadsheet app, all these problems become easy to fix. Just agree on some trivial standards for things like manufacturer names etc. and batch changes become easy and quick.

Thinking more generally, such a tool would make library maintenance a lot easier. There are still many inconsistencies with libraries, even down to things like the placement and size of text. It seems like creating a tool to tidy all that up might be quite useful.

3: The current ALIAS system is not ideal, I agree... I don't know if it would be easier to fix it or just to ignore it. This certainly needs some thought.

Parts libraries are one of the hardest things for EDA packages to get right, but also provide huge gains if they can be done well.

jkriege2, 2016-12-02:
So we are back in KiCAD-country ... as I said above: It would make much more sense to first create the required tools/features in the software and then see how we go on here ...

BTW: Having such a table-based tool would be really helpful ... I suggested some such changes here (https://forum.kicad.info/t/improvement-to-kicad-schematic-library-editor/) ... but didn't come anywhere ...

Best,
JAN

kevinb456, 2016-12-10:
I'm also very much in favour of this! Coming from other more mature tools this is a striking omission.
However, KiCAD needs to support two main userbases;

1. Hobbyist / casual user - only really cares that the tool has the correct symbol to draw the schematic, correct footprint for the PCB, and an identifying name/value. The rest of the nuances e.g. Part number / Supplier etc will probably be in an external excel file, on a scrap paper in their project box, or just in their head! They will only look at occasionally and work out what each part should be when they order.
2. Larger OSHW projects / companies - want a system more akin to industry standard practices - the schematic contains the full design information. So a full and accurate BOM can be exported including part numbers, tolerances, voltages etc.

The tool already does everything for 1), but not for 2). There needs to be a way of allowing 2) but without removing the ability to work 'quick n dirty' for 1).

To me it seems an _agreed convention for part fields_ is the way to go. **Blank** by default (or '_' if needed), so they would not interrupt any stage of the workflow for 1) and do not require extra effort to maintain the official libraries (other than running a script over them once to add the empty fields).

People would see these fields when they edit a part but if they dont want to use them that would be the sum total of their impact, it wouldn't change their workflow. They may even decide that writing the info in the part fields is better than in their external excel sheel / head / scrap of paper!

Personally, I would like to see added by default;
**Description
ManufacturerName
ManufacturerPart
SupplierName
SupplierPart
Fit**

ManufacturerName and ManufacturerPart (same for SupplierPart) could be combined into one field with an agreed separator e.g. ManufacturerPart as"Linear:LTC4359" (Idea by https://github.com/kasbah from the 1-click-BOM tool and https://kitnic.it/). If no separator is used it would default to understanding as just a part number. There could then be any number of extra ManufacturerPart's added by the user (the problem with separate fields is you have to start naming them ManufacturerName1, 2, 3... and ManufacturerPart1 , 2 , 3... etc to make sure one lines up with the other. Keeping as a single field with agreed delimiter would solve this.

Fit is true or false and specifies if the component is to be fitted.
Description - To balance features with simplicity, I would not create separate fields for "Voltage" "Tolerance" "Dielectric" etc as this is probably overkill. The user can put these in the Description field.

This is akin to the system I implemented at my companies library. A part can be dropped on the schematic and left with whatever basic fields are in the library, i.e. simply Value "1k" and footprint "1206" if the user doesn't care. Or if the user does care they can go nuts and set the description as "1% 0.5W Pulse-proof Thick-Film Chip Resistor" and the Manufacturer/Part/supplier fields for an exact part (if crucial to the design).

The point with the system is it doesn't have any extra overhead for people that don't want to use it, but a bit benefit for users/tools by having one set of practices and conventions to work to for those that do want to use it.

kasbah, 2016-12-20:
I made an RFC on the KiCad dev mailing list to and a standard field: https://lists.launchpad.net/kicad-developers/msg27021.html

SchrodingersGat, 2016-12-20:
Thanks @kasbah - it will be interesting to see what the other devs think. The new format offers a lot of improvements, hopefully it is implemented soon.

kuro68k, 2016-12-21:
I think this really needs to be broken down into two separate issues.

1. Standardized names for things like MPN and other metadata, for BOM generators. The goal should be to have exactly one place where an attribute needs to be changed, which will be the schematic, rather than having to edit multiple files just to change a part. That will ensure consistency (BOM always matches schematic) and efficiency.

2. Consider adding some of those fields to the standard part libraries. This is much lower priority.

kasbah, 2017-01-12:
After not much success in convincing people it's a good idea to set some defaults in KiCAD I have made prepared a draft of a community standard on the forums: https://forum.kicad.info/t/standard-symbol-field-names-initiative/4870

bobc, 2017-06-06:
No one seems to have mentioned i18n. I am sure many users will want to use their own language names. rather than english names or abbreviations.

kasbah, 2017-06-06:
It's a fair point @bobc, and I will need to consider it when I actually get around to writing up the document for the community standard.

My initial thoughts are that internationalization is an interface issue that would be aided by using standard names. I.e. the KiCAD user interface can better translate the field names if it knows what names to expect.

poeschlr, 2018-01-20:
If this discussion is still relevant please reopen it over at the new repo https://github.com/KiCad/kicad-symbols. This repo is now declared legacy and will no longer receive updates. (v5 will use the new repo, there is no new v4 release planned)

Closed 2018-01-20.

Thread 820 (2016-12-05):

Trouble with KLC Rule 6.9

evanshultz, 2016-12-05:
Here is my SOT-363 footprint based off of the existing SOT-353:
[SOT-363.kicad_mod.txt](https://github.com/KiCad/kicad-library/files/631649/SOT-363.kicad_mod.txt)

A simple change but the old one wasn't KLC compliant so I need to make a few updates. I can't figure out the violation of rule 6.6, though, which appeared after changing the text width to 0.12mm. Both text fields are clearly 1mm in height:
  (fp_text reference REF** (at 0 -1.8) (layer F.SilkS)
    (effects (font (size 1 1) (thickness 0.12)))
  )
  (fp_text value SOT-363 (at 0 2.2) (layer F.Fab)
    (effects (font (size 1 1) (thickness 0.12)))
  )

What am I missing?

(By the way, it seems odd to have SOT-353 in the library and not SOT-363, but that's what I found. Please correct me if SOT-363 exists and I just missed it. Thank you.)

CarlPoirier, 2016-12-06:
Hi,

The script checks for 0.15mm thickness. It has not been specified in the KLC.

It's great to know you are adding the SOT-363, but make sure you base your work on the latest SOT-353. It has been recently updated [here](https://github.com/KiCad/TO_SOT_Packages_SMD.pretty/pull/15).

I will close this issue since it's not in the right repository. I suggest you open up your pull request and ask the questions there if you have any. We will also be able to witness your work and it will help us give you advice.

Closed 2016-12-06.

Thread 825 (2016-12-07):

MOSFET drivers

SchrodingersGat, 2016-12-07:
Currently we have a number of FET driver ICs floating around in various libraries, e.g.

transistors.lib
power_management.lib

and also in manufacturer specific libs.

Does anyone see any advantage in adding a new library (e.g. *mosfet_drivers.lib* for storing these?)

If we can get a quorum on this I will start a PR and try to consolidate the existing symbols.

keruseykaryu, 2016-12-07:
If I could put one's two pennyworth in, you **should** consider **once and for all** how to sort libraries: by function (`passives.lib`, `transistors.lib`, `microcontrollers.lib`, etc.), by manufacturer (`atmel.lib`, `lineartech.lib` `texasinstruments.lib`, etc.) or other key. At present day you have not much libraries to make such a decision and reorganize those which are already present.

IMHO both options generate big and messy libraries which will be a huge problem when Eeschema will support remote libraries like Pcbnew. So it's necessary to find the key which will become the golden mean.

El3ctr0nic, 2016-12-25:
We need fast lib. reorganize..I think. One schema must be approved.

We have fiev manufacturer libs need to rename. (To  keep  "up to date" names)
IR is part of Infineon, Atmel is part of Microchip....
I think that one massive reorganization is needed. We should use function or manufacturer lib name.
Any mix give Us a mess.

Device.lib should be limited to general purpose symbols so
Aruduino, Nucleo, RaspPI headers should have separate library. (lot of my prototype projects have nucleo64/144 as plug in module for easy testing input/output circuits without early drawing uP coo-system drawing).
Template isn't too good for this...it's only my subjective opinion.

Regards,
Marcin

keruseykaryu, 2016-12-25:
@El3ctr0nic: I think that one massive reorganization is needed. We should use function or manufacturer lib name. Any mix give Us a mess.

Maybe it's worth to consider an option to use folders in `share/library`. For example, main folder called according to manufacturer: `Microchip` and several functional libs inside: `Microcontrollers.lib`, `Memory.lib`; `Micron` and `Memory.lib`; etc.

Closed 2017-02-27.

Thread 860 (2016-12-24):

KLC does not specify logical vs physical symbol design

evanshultz, 2016-12-24:
There are two approaches to symbol design with respect to multiple pins of the same net/functionality: logical vs physical.

For a physical symbol, each pin on the package gets a pin in the symbol.

For a logical symbol, there is one pin on the symbol which then connects to multiple package pins.

KLC is mum on this topic. @jkriege2 mentioned a few ways to handle it in response to my question at https://github.com/KiCad/kicad-library/issues/849, and I think it would be an excellent point of clarification for those designing symbols and footprints. I could make an argument for both methods above, and if a logical symbol is selected I could further argue regarding implementation methods, so perhaps a consensus can be reached and KLC updated to give clarity to librarians and contributors?

jkriege2, 2017-01-07:
see discussion and draft here:

https://github.com/KiCad/kicad-library/issues/879
https://github.com/SchrodingersGat/kicad-library/wiki/KLC

Best,
JAN

evanshultz, 2017-01-07:
Thanks @jkriege2. All pins should be shown so that the pin number filter in CvPcb works. That's clear.

But what about stacking the pins on top of each other so the schematic symbol _appears_ to have just a single pin. That's the root of my question. Is there a rule or suggestion for this situation?

JoanTheSpark, 2017-01-29:
stacking depends on the piece of software that accepts pins over each other as being connected. You really want to bet the library on that?
I'd rather push for some organized way within eeschema/KiCAD that would allow to have one symbol pin stand for several physical pins.
Like the way when you print pages out of a large document were you can say print page(s) [1,3-5,11-16,34,98], you know?

SchrodingersGat, 2017-01-29:
@JoanTheSpark I would love to see this too.

Check out the [proposed specification](https://lists.launchpad.net/kicad-developers/msg23302.html) for the *.sweet* file format - this functionality exists! Well, it exists in the future. And isn't that just as good?

For now, I do not like stacking pins. There are a few symbols in the libs that rely on this "functionality" (hack, really) but I would advise against adding *new* symbols that rely on this.

I think this needs to be specified in the [updated KLC](https://github.com/SchrodingersGat/kicad-library/wiki/KLC).

Regarding the suggestions in https://github.com/KiCad/kicad-library/issues/879

1. Having *specialized* footprints for connecting multiple physical pins to a single logical pin is a bad idea. The footprints are designed to be separated from the schematic and *agnostic* to the intended function.
1. Overlaying multiple pins is *feasible* (it works, at least for now), but I would not recommend it.
1. The best bet (for now) is to add each individual pin to the schematic.
1. This will be "fixed" when the .sweet format is released (oh what a day that will be)

jkriege2, 2017-02-26:
If you stack all the NC-pins, they get all connected to each other in the current KiCAD-versions!
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

SchrodingersGat, 2017-02-26:
And it looks like this behaviour is here to stay. I pushed a patch to fix this but there was no love.

In general the KiCad libs should heavily discourage pin stacking as it is non obvious to the user and in the worst case can cause failures such as your example here.

poeschlr, 2017-02-26:
@SchrodingersGat
Is it a good idea to have invisible pins at all?
They get connected if you either have a junction or a device placed at the wrong place.
Yes one gets an erc error if this happens.
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

SchrodingersGat, 2017-02-27:
Personally, I do not think they are a good idea. The only purpose they serve is to match the pin count of a symbol with the pad count of a footprint.

If we can think of a better way to associate pin count then we can outlaw invisible and NC pins in the KLC completely.

SchrodingersGat, 2017-03-03:
@evanshultz @jkriege2 @poeschlr ok we are on the home stretch for KLC 2.0

Time to make a decision about invisible pins! Do we:

a) Allow them for NC pins only
b) Don't allow any invisible pins (NC must be visible)
c) Disallow NC pins entirely (breaking associate-by-pin-count)

evanshultz, 2017-03-03:
Well, I suppose the issue should be driven by what's best for KiCad rather than what's easiest.

a) CvPcb does its thing and matches up symbol and footprint by pin count. We only see connectable pins.
b) Sounds ugly and cluttered on the schematic canvas to me.
c) To match up footprints we'd need to replace virtually all F3 and FPFilter fields with the exact footprint name. And for small variations `_Handsoldering` we'd have to list each variation individually.

The first option seems the best to me. It continues to use the existing infrastructure of CvPcb and the libraries while giving great flexibility for variations in footprints. I could make a minor argument for the last option so that footprints are explicitly assigned, but that goes away once all symbols have appropriate FPFilters (which may never happen...). For the user I think it works well, and also a bonus that it's similar to the existing library design, I vote for only allowing NC pins to be invisible.

And what about pin stacking? Never allowed?

SchrodingersGat, 2017-03-03:
Perhaps we should allow pin stacking but only if:

* Pins are not of type "No Connect"
* Pin names are all the same
* All but one of the pins is set to invisible

This stays in line with all current requirements (and functionality of Kicad code)

jkriege2, 2017-03-03:
I vote also for NC visible.

About stacking: I would allow stacking, if
- pins are not NC
- pins are connected internally
- if pins are stacked: they have to have the same name

Best,
JAN

SchrodingersGat, 2017-03-03:
KLC 3.3 -> https://github.com/SchrodingersGat/kicad-library/wiki/KLC

evanshultz, 2017-04-10:
@poeschlr @jkriege2 @SchrodingersGat I think this issue can be closed, right? This is settled by KLC 2.0, I believe.

SchrodingersGat, 2017-04-10:
Yes, please close :)

Closed 2017-08-23.

Thread 879 (2017-01-02):

KLC Addition - PWR and GND pins

SchrodingersGat, 2017-01-02:
Nominally we suggest PWR pins are located at the top of a symbol, and GND pins at the bottom. However this is not stated in the [KLC rules](https://github.com/KiCad/kicad-library/wiki/Kicad-Library-Convention).

I suggest that rule 3.5 be updated as follows:

###Old Rule 3.5
`Whenever possible, inputs are on the left and outputs are on the right.`

###New Rule 3.5
```
Wherever possible, pins should be arranged by function:
* Power pins should be placed at the top of the symbol
* Ground pins should be placed at the bottom of the symbol
* Inputs should be placed on the left of the symbol
* Outputs should be placed on the right of the symbol
```

CarlPoirier, 2017-01-03:
Sounds good, can't we put that in one short sentence?

`Whenever possible, power pins are placed at the top, ground at the bottom, inputs on the left and outputs on the right.

SchrodingersGat, 2017-01-03:
I would lean towards bullets for clarity, especially as many users are English as a second language. Thoughts?

CarlPoirier, 2017-01-03:
Then we better split most rules into bullets!

SchrodingersGat, 2017-01-03:
I can tackle this.

diggit, 2017-01-04:
I agree on bullets.

There are negative and positive power pins. Ground is power pin too. I'd mention control/controlled pins too.
Wee can add examples...

Wherever possible, pins should be arranged by function:
* **Positive power** pins should be placed at the **top** of the symbol
   (VCC, VIN, VDD,...)
* **Ground and negative power** pins should be placed at the **bottom** of the symbol
   (GND, VSS, ...)
* **Input or control** pins should be placed on the **left** of the symbol
   (OP-AMP +-, SPI, I2C, UART,...)
* **Output or controlled** pins should be placed on the **right** of the symbol
   (Vout, RS-485, Ethernet, ADC in, DAC out,...)

jkriege2, 2017-01-04:
Hi!

I only see obne (special case) problem with these rules: What happens if you try to design a 7905 or comparable neg. regulator ... is the GND pin now at the bottom or at the top?

Otherwise: That would be a great addition!

Best,
JAN

Best,
JAN

SchrodingersGat, 2017-01-04:
Great suggestions @diggit

I have mocked up some changes here: https://github.com/SchrodingersGat/kicad-library/wiki/KLC

Let me know what you think - @CarlPoirier if you're happy with this I'll transfer it to the KiCad page

SchrodingersGat, 2017-01-04:
@jkriege2 regarding the exception above - I have added a section in the text specifically relating to exceptions. There are always going to be exceptions to every rule!

SchrodingersGat, 2017-01-04:
I have also added a draft for `3.10` as requested in https://github.com/KiCad/kicad-library/issues/884

diggit, 2017-01-04:
As agreed in #869, 3.2 2. bullet should be improved. There were ideas, but not exact formulation.
maybe sth like this...

* Length can be increased in steps of 50mils to accommodate long pin numbers and graphic pin styles.

SchrodingersGat, 2017-01-04:
@diggit  I have updated 3.2.2 as requested

CarlPoirier, 2017-01-05:
It's great. In 4.4 I'd put the examples on the same line such as in 3.10.4. Rule 3.10 is nice as well. Once it goes live, don't forget to put your name at the top besides mine!

SchrodingersGat, 2017-01-05:
[Updated](https://github.com/SchrodingersGat/kicad-library/wiki/KLC)

@CarlPoirier  @diggit @jkriege2 let me know if there is anything else that needs changing, otherwise I'll transfer it across :)

jkriege2, 2017-01-05:
Hi!

just some comments:
1. in 3.2.bullet2, also add `(1.27mm)` after 50mil for consistency with the first line
2. Do we have a rule for the filled background and 0.01" line-thickness of box symbols now? I didn't spot it ...
3.  What about the line-width issue I raised here: https://github.com/KiCad/kicad-library/issues/885
4. 10.6 should maybe be reformulated ... don't really know what it should tell me. Maybe this:
> For SMD components (mostyl SMD pads) the attribute is set to SMD, for THT components to THT ...

Best,
JAN

keruseykaryu, 2017-01-05:
BTW. In the KLC Wiki page https://github.com/KiCad/kicad-library/wiki/Kicad-Library-Convention you could include some graphical examples of some rules for better understanding.

jkriege2, 2017-01-05:
@keruseykaryu I also had that idea ... but no time so far to prepare some ... I can see if I find some images in the next days/weeks and we discuss them as a new issue? Then we can go forward with the changes above and add the images in a second discussion. OK?

Best,
JAN

jkriege2, 2017-01-05:
Please note that I updated my post above (reformulated new rule)!
JAN

SchrodingersGat, 2017-01-05:
@keruseykaryu yes this is a fantastic idea - visual examples would be very helpful.

@jkriege2 good suggestions:

* I have added `(1.27mm`) to 3.2
* I have included background fill and 0.01" width into 3.3 (Now called `Symbol visual style`)
* Regarding line width for text in footprints, I have added this to rules 6.5 and 6.8
* 10.6 has been fixed - this was super vague previously, good catch. I have updated this.

SchrodingersGat, 2017-01-05:
I have also spotted an inconsistency in the rules.

3.5 -> Refdes must be placed on Silkscreen layer, size=1.0mm

10.5 -> Refdes must be placed on the Fabrication layer, size = 2.0mm

This is one that has been the cause of much debate, but we *must* have the refdes on the silkscreen layer, surely? How should we resolve this?

I would suggest removing rules 10.4 and 10.5 as they are covered in 3.5 and 3.6. Further, these are not really "properties" of the footprint more than graphical elements.

jkriege2, 2017-01-07:
Hi!

1. about the REFDES: Currently we have it with size 1mm on SilkScreen. I think it would be great to have it with this size on both layers, but as I understand that cannot be done automatically. So *for now* I would set size to 1mm for both and say SHOULD for FabLayer ... Maybe we can even tell in one sentence hoe to achieve the second label on f.fab (as user-text `%R` on F.Fab).
2. We are still missing a rule for pin-numbering (I suggested a draft there: https://github.com/KiCad/kicad-library/issues/884):

> 3.11 Symbols must have all pins of the package explicitly available. If they are not connected, they should be marked as such, named NC and set to be invisible. This is required to allow for the use of KiCAD's pin count filter.

> 3.12 Exposed pads of a device must have their own pin, typically number max. pintcount+1, e.g. pin 9 for a SOIC-8 with exposed pad. The name of this pin is often set to PAD or or a name indicating its function, e.g. GND/PAD

Best,
JAN

jkriege2, 2017-01-07:
Hi!

I'm also opening an issue to discuss possible images:
https://github.com/KiCad/kicad-library/issues/891
If you like some, just copy them from there into your draft!

Best,
JAN

CarlPoirier, 2017-01-08:
Just to clarify:

Both the value and refdes need to be on the fabrication layer. This has been discussed [on the mailing list](https://lists.launchpad.net/kicad-lib-committers/msg00428.html) and in the forum thread I linked. Rule 10.5 and right, 3.5 should have been removed.

jkriege2, 2017-01-08:
Then to comply with the current usage in the lib, I would suggest this altered rule:

> 10.5 Reference designator has a height of **1.0mm** is placed **on both** the fabrication **and the silkscreen** layer. **_With current KiCAD versions, this can be achieved by placing the default REFDES label on fabrication layer and a user-defined text label with the contents `%R` on the silkscreen layer._**

What do you think? I formated the changes in a bold font and the instructions in an italic font.

best,
JAN

jkriege2, 2017-01-12:
Hi!

due to a comment on a bug in my images´, I started pondering a bit with the counter-clockwise-rule for pins ... and I'm not so sure about it. I would see the following example as a logical pin-ordering (and would expect it  like that):
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
Here all IO-ports are on the right and are ordered top-to-bottom, the way we read (top-to-bottom), which seems to me to be the direction to expect.

In this example, there is also a clock-wise ordering, which is a bit strange as it is different from how we read (it is top-right -> bottom-right -> bottom-left -> top-left):
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
Here maybe having PA/PB/PC on the left (to->bottom) and the rest on the right (bttom->top) might be better, which would conform to the CCW-rule.

In all I would maybe suggest to alter that rule:
> Ports should be ordered as follows:
>  - when all ports are on the right, they should be ordered top-to-bottom,
>  - if they are distributed over more edges, they should be ordered in a counter-clockwise-fashion, starting at the tope-left.

What do you think on that topic?

best,
JAN

SchrodingersGat, 2017-01-12:
What about simplifying:

`Port pins should be ordered from top to bottom`

SchrodingersGat, 2017-01-12:
I have now expanded "General Rules for Footprints" and added "Rules for SMD Footprints" and "Rules for THT footprints".

Additionally, there were previously three rule groups governing naming of footprints - these have been consolidated into a single group. There are no auto-checks for these  groups currently.

SchrodingersGat, 2017-01-12:
Also, I find rule 7.2 very hard to parse:

`Pad 1 is on the left first, then at the top, except at the top for PLCC (IPC-7351).`

@CarlPoirier as you are the one who wrote this, is there a better way of expressing this?

CarlPoirier, 2017-01-15:
I can't remember a case where placing the pad 1 on the left would not result in it being at the top at the same time. So I'd say:

`Pad 1 should be placed at the top left. If impossible, it should be placed closest to the top (IPC-7351).`

SchrodingersGat, 2017-01-15:
I have made a further update to https://github.com/SchrodingersGat/kicad-library/wiki/KLC addressing these latest issues

evanshultz, 2017-01-16:
@jkriege2 I really like your idea above. It makes sense to me. 2 quick notes:
- Typo of "address" in the blue bubble
- Maybe change "stuff" to something more concrete if you'd submit this screenshot for inclusion in KLC

jkriege2, 2017-01-17:
Hi1

I would also suggest an adition to rules 6.x:
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

What do you think?
JAN

jkriege2, 2017-02-05:
Hi!

we should really move forward on this! I just went through it again. In addition to my comments above, I spotted these:
1. KLC 3.11 We should emphasise that the FPFilters need to be there and set correctly EVEN IF the footprint field is filles
2. Maybe extend KLC 3.6 by examples (not really sure if it's necessary, but it might help newbies):
    - pins on devices such as resistors, caps, transistors, diodes, ... are usually PASSIVE
    - power supply pins such as VCC,V+,Vdd,... (also GND!) should be set to POWER_INPUT
    - IC I/O/BIDI/OpenCollector/OpenDrain/...-pins should be set as their function dictates
    - power-outputs (e.g. the output of a voltage regulator) should be POWER_OUTPUT
3. last point in KLC 3.12 change to (I've seen people adding geo-info to match a simple `SOT-23`, which will then never match):
    `Filters should match as much dimension information as possible to be as specific as possible, if that is available in the appropriate footprint names. E.g.`
4. Should we have a screenshot of some simple components (resistors, diodes, ...) as examples? Especially concerning the IEC-style of diodes ...? If so I could prepare some!
5. KLC 3.3 should also contain a reference to IEC-style (diodes, resistors...!):
    `Use the IEC-style for electric/electronic symbols for this library.`
6. KLC 6.1 change `Capacitor` to `C_`?
7. KLC 6.7 add example ", or `_ThermalPad` in combination with `1EP` for bottom pads with thermal vias."

best,
JAN

jkriege2, 2017-02-11:
Hi!

one more extension request:
Should we reformulate 10.2 from
> Doc property contains a full description of footprint.
to
> Footprint meta-data is filled in as appropriate.
>   - **Documentation** field contains comma-separated device information. You may add a URL to an appropriate datasheet here.
>   - **Keywords** field contains space-separated keyword values

Best,
JAN

jkriege2, 2017-02-12:
as discussed elsewhere we should also have

> 1.8 Library- and footprint-files use UNIX-sytle line-endings (i.e. `\n` = LF = 0x0A).

Best,
JAN

jkriege2, 2017-02-12:
I just played around with that last rule (and write check-code to check and fix it: https://github.com/KiCad/kicad-library-utils/pull/77). It turns out that KiCAD footprint editor on Windows reverts the line-endings to Widnows! I submitted a bugreport asking for a change of that behaviour: https://bugs.launchpad.net/kicad/+bug/1663990

Best,
JAN

SchrodingersGat, 2017-02-13:
Jan - updates here - https://github.com/SchrodingersGat/kicad-library/wiki/KLC

I am hoping to get this completed and include your images very soon.

Thanks for filing the bug report, that would be very handy.

Do you know if the symbol editor (eeschema) has the same behaviour on windows?

jkriege2, 2017-02-14:
Hi!

nice work!

I just saw one thing: Aren't we missing now how to calculate the courtyard clearance in KLC 7.5 (i.e. from pad-outline or/and package outline)?

JAN

jophut, 2017-02-20:
Not sure if this issue is the right place to post the following:
I've written a piece of python code to identify pins on the same coordinate.
Currently I've put it into KLC rule3_1.py, but maybe a new rule would be better?
Would you be interested in a PR?

jkriege2, 2017-02-20:
Hi!

yes, that might help in some cases ... please submit a PR, so we can discuss this issue/suggestion there!

Best & thanks,
JAN

jophut, 2017-02-20:
@jkriege2:

> please submit a PR, so we can discuss this issue/suggestion there!

PR submitted: https://github.com/KiCad/kicad-library-utils/pull/85

jkriege2, 2017-02-26:
@SchrodingersGat : I think we should clarify in 3.1 that these rules do not apply to devices such as diodes, resistors, ... any idea how we can make that into a concise statement?

bobc, 2017-02-27:
> as discussed elsewhere we should also have
>
>    1.8 Library- and footprint-files use UNIX-sytle line-endings (i.e. \n = LF = 0x0A).

I think you need to drop that rule, as the code change to KiCad is not likely to happen.

bobc, 2017-02-27:
Given that this new KLC is a major change since the previous one (basically a rewrite), and also many of the rules have been renumbered, it should be versioned 2.0.

SchrodingersGat, 2017-02-27:
@bobc thanks, 1.8 has been removed

jkriege2, 2017-02-28:
Can we have the images inlined again? I liked that muhc more ... because the links are really non-obvious and somehow get lost in the text ...

JAN

SchrodingersGat, 2017-03-01:
Hi all,

I think that [KLC 2.0](https://github.com/SchrodingersGat/kicad-library/wiki/KLC) is ready to go. Can you please have a read through to see if I have missed anything?

There is an update to the KLC scripts waiting too - https://github.com/KiCad/kicad-library-utils/pull/81

poeschlr, 2017-03-01:
All in all i really like the new klc. It is really detailed and i think there is a lot less ambiguity.

I have a question about the rule for courtyard clearance
> Clearance is measured from package, pads, and silkscreen

Should the courtyard distance really be measured from silkscreen not from component body?
The Silkscreen is by definition outside of the body outline.
(Rule: Silkscreen is completely visible after board assembly)

About the silkscreen:
In my pull request https://github.com/KiCad/Connectors_Phoenix.pretty/pull/44
You stated the following:
>I agree that detail for connectors like this should be on Silk not Fab. Perhaps this needs to be clearly specified in KLC.

Did you change your mind or did you forget about that?
I think details on silk would violate the current rule: Silkscreen is completely visible after board assembly
Maybe make an "exception" similar to:
Silkscreen underneath the footprint is allowed if it makes hand populating the component easier.
Or maybe change the first rule to:
Component outline, pin 1 mark and reference on Silkscreen are completely visible after board assembly.

SchrodingersGat, 2017-03-01:
Hmmm good point I did forget about that @poeschlr

Perhaps `Silkscreen is allowed for hand-loading of THT components`. The rule is really to prevent issues with SMT design.

The `Clearance is measured from...` description is the one I'm having most trouble with....

jkriege2, 2017-03-02:
About courtyard: The question is IMHO what the courtyard is used for: I presume it's for e.g. an autoplace or DRC to prevent components from overlapping. I would say: Measure from pads and outline, because usually teh Silkscreen will be inside, i.e. non-overlapping, only in some cases it may be outside and then it's more a problem of look, not function. Also if we measure from silkscreen we would also have to include the freely movable REFDES, which makes all courtyards ver large.

Abozt the KLC-images: Why are the now there only as links? I think those are easily overlooked ...

JAN

SchrodingersGat, 2017-03-02:
I'm happy to measure from pads and outline - is this what the checker does currently?

Re: Images - I thought it looked messy with inline images, we can make the link text larger to make it more visible?

jkriege2, 2017-03-02:
ad 1) yes, that's what the checker does at the moment (although silkscreen can easily be added ;-)

ad 2) ... mmmhhh ... preview images are not possible I pressume?

SchrodingersGat, 2017-03-02:
I've managed to get inline images looking pretty nice now actually - what do you think?

jkriege2, 2017-03-02:
awesome ... just the way I imagined it ;-)

jkriege2, 2017-03-02:
I'm thinking that maybe over time, we should assemble a gallery of good footprint-images. AT least, where t makes sense (i.e. IC-packages), so people can have a look when designing a new one ... but that's for future work. Maybe this evening I can have a look at your updated scripts ...

JAN

jkriege2, 2017-03-02:
A suggestion. Now we have:
> 7.3.x Silkscreen is completely visible after board assembly (should not be under component)
Maybe change to:
> 7.3.x For SMT components, silkscreen is completely visible after board assembly (should not be under component)
> 7.3.y For through-hole (THT) components, silkscreen should not be completely covered after assembly, i.e. usually a circumference should stay visible. Silkscreen may also be put under the components to make assembly easier.
> 7.3.z REFDES on silkscreen must be visible after assembly in all cases.

What do yout hink?

jkriege2, 2017-03-02:
Also maybe change:
> 7.5.x Clearance is measured from package, pads, and silkscreen

To:

> 7.5.x Clearance is measured from package- and/or pad-circumpherence (i.e. circumphere these elements with the given clearance)

SchrodingersGat, 2017-03-02:
Thanks :)

poeschlr, 2017-03-02:
I would also clarify that the silkscreen pin 1 marker is always visible after assembly.

Otherwise great work

SchrodingersGat, 2017-03-02:
Thanks @poeschlr , added

evanshultz, 2017-03-02:
Sorry if I'm being too pedantic, but a few comments. I haven't looked at this for a while so sorry to drop in so many comments at the 11th hour.

First, I see some bullets with a period at the end and some without. Is there a standard followed in this regard for KLC?

And also, bullets are much harder to mention in particular than a named/numbered scheme. Would it be better to avoid them? If all numbers are used, a specific rule could be "6.4.3.1" instead of "6.4 bullet 3 first sentence", for example.

1.4 Not showing units will affect a lot of current footprints that have `mm` in them for dimensions. Capacitors_THT, Connectors_*, Pin_Headers, Sockets, Symbols, Wire_*, etc. Is there a plan for updating the footprints in this case?

1.6 Is there a better way to word this? I feel it's unclear. Or perhaps it's covered by 4.5?

3 If mm is the standard dimensional unit in KiCad, why not dispense with mil and only use mm? All footprint info is only in mm.

3.1 In the last bullet, diodes are arguably not a passive part since they're semiconductors.

3.2 I feel it reads better as `IEC-style symbols are used _whenever_ possible`.

3.4 UART and RS232 are both bidirectional, so it seems odd to include one as an example of input pins and another as an example of output pins. Am I misunderstanding?

3.6 Should it mention not to stack NC pins?

3.9 For parts with a single package or package type that is broadly compatible (like a part that comes in DIP8, SOIC8, TSSOP8, etc.) should it be mentioned that package is listed in the Description field?

3.10 It mentions itself, but should instead mention `3.11`.

3.11 The third bullet should show possession, `KiCad's`.

3.11 Can the first and fourth bullets be combined?

3 I don't see anything about Reference and Value placement or justification. Such as center justified if placed on the y-axis, left justified if placed right of the origin, etc.

4.3 Should `1N4001` be in tick marks?

4.5 Perhaps this is better written as an imperative sentence, such as `Indicate quantity of elements for symbol arrays. Ex: resistor array: Resistor_x8.`. Also, this uses "ex" whereas other examples I saw used "e.g.".

5 Perhaps this reads better if changed to `..where _multiple elements_ (if present) _are_ separated..`?

6 No tick marks around `.kicad_mod` and `.pretty`. And consider `_within_ the .pretty _directory_`.

6.1 Perhaps `Specify package type first`. And also isn't the "_" in the example a separator?

6.2 Suggest `Package name and number of pins are separated using a hyphen`.

6.3 The second example seems to use an underscore to append the unique package variation. Should it end in `-1EP` instead of `_1EP`?

6.4 The last comma is unneeded.

6.2/6.3/6.4 These items list separator characters explicitly, but others don't. Should each step show this? Or one item could be added in 6 to cover an underscore separator between the elements below, and these few items show a hyphen separator within each element? So we end up with `element1_element2_element-3_element-4_element5`.

6.5/6.6 These use a comma before `e.g.` while elsewhere is a period.

7.2 Uses `pad 1` while 7.3 and 7.4 use `pin-1`. Let's be uniform. Is this somewhere to unify?

7.3 Should any guidelines or examples for the pin 1 mark be given? Also 7.4.

7.4 Perhaps add `(footprint name)` after `Component value` in first bullet for clarity?

7.3/7.4 Any text placement rules/requirements? Like ref des silk above, ref des fab at the origin, and value (footprint name) below?

7.5 Should the 5th through 8th bullets be indented another level?

7 As the rules are clearly meant to have the component body lie on the front layer of the board (see the copper layers in section 8), the sub-parts of section 7 can specify `F.SilkS`, `F.Fab`, and `F.CrtYd`.

9 Any need to specify a minimum drill size for the lead diameter or minimum annular ring? Sometimes this is clear in the datasheet but not always. We could require Level A of IPC-2221 and IPC-2222.

10.2 As datasheet URL is a separate field from description and keywords, why not give it a bullet point all to itself? And is this a duplication of 3.8 where we're best off to only have one place for each topic?

10.4 Perhaps specify this should be added even if the 3D model doesn't currently exist? That will ease maintenance later if/when the model is created.

And finally, how about rules for PR submissions? New symbols show an image including the pin table with pin types visible, etc. It could also mention automatic rule checking by Travis-CI, etc.

jkriege2, 2017-03-02:
- more levels of numbering would really improve!
- ad 1.4) ... also didn't see that so far ... I would vote strongly in favour of units: We are not limited by filename size, so I would put any information that is there EXPLICIT and not expect people to know what L5 means IMPLICITLY ... There are a lot of components with inch-sizes ... so this will most certainly lead to confusion. ... actually just discussed that for a programming problem with my boss today ;-)
- ad 3.6) yes please, mention non-stacking of (NC) pins ... actually maybe we should even discourage stacking of ANY pins, again because this is IMPLICIT information, which is then no longer EXPLICIT in the schematic
- ad 7) IMHO we should leave `F`/`B` open, as there are components that are on both or explicitly on the LS (see e.g. https://github.com/KiCad/Potentiometers.pretty/blob/master/Potentiometer_Piher_T16L_Single_Horizontal_MountLS.kicad_mod )
- ad 10.2) there is no separate datasheet-field in the footprint (it's only there in the symbol!!!) ... DS is just additional info in DOC
- ad 10.4) may be good ... but then I would expect KiCAD to do that in software: If nothing is specified, look for a symbol with the standard name in the standard location, using offset 0,0,0, rotation 0,0,0 and scaling 1,1,1 ... if a file is specified: use that one ... but I don't know whether we could get that behaviour in the near future ;-)

JAN

SchrodingersGat, 2017-03-03:
Thanks for the great feedback guys.

Check out updates to https://github.com/SchrodingersGat/kicad-library/wiki/KLC

I have also adjusted new KLC scripts to add new rules:
1. 3.3
1. 9.5
1. 9.6

https://github.com/KiCad/kicad-library-utils/pull/81

jkriege2, 2017-03-03:
What about the unit-issue?

Also one addition: We should mention somewhere (especially in 10.4) the license of this lib and that 3D models that have been copied from a manufacturer site need to clarify that their license allows redistribution on this page!

JAN

evanshultz, 2017-03-03:
Great work! Thanks for so much effort and letting us all collaborate!

1.4 Agree with Jan. Still no units?

3.2.iv Remove the "as" and is some text supposed to be bold?

3.5.iv UART and RS232 are both bidirectional, so it seems odd to include one as an example of input pins and another as an example of output pins. Am I misunderstanding?

3.8 I don't see anything about Reference and Value placement or justification. Such as center justified if placed on the y-axis, left justified if placed right of the origin, etc. See #848.

3.9.iii Mentions `3.10` but I believe it's now `3.11`.

3.12.i Still one bullet here which is probably unnecessary and can be part of the rule.

4.5 "Indication" should be "Indicate".

6 Is the bold text intentional? Seems normal format would be fine here.

6 Is the use of an underscore to separate the section called out? I'm not seeing it.

6.3.i In the library I see a hyphen before `1EP`, not an underscore.

7.3.viii Change "as far as" to "where".

7.5.v This should be indented one more since it, and the following three elements, and details for 7.5.iv. Also change the bullets here.

9 Should be specify the diameter of the drill over the lead diameter, at least for round leads? IPC also specifies this for various manufacturing levels.

SchrodingersGat, 2017-03-03:
@evanshultz thanks for the feedback - most of that has now been implemented:

### UART / RS232
My thinking is that UART is interior to the PCB, whilst RS232 is "outside" (to another board). Such chips are level-shifters and functionally separate the UART and RS232 sides

### 9
I'm not sure what you mean by drill over the lead diameter? Can you provide some more info here?

poeschlr, 2017-03-03:
@jkriege2
> We should mention somewhere (especially in 10.4) the license of this lib and that 3D models that have been copied from a manufacturer site need to clarify that their license allows redistribution on this page!

For 3d Models (In the new repo) we have a separate wiki page about licensing:
https://github.com/KiCad/packages3D/wiki/Model-Licencing
I don't think that there are any manufacturers who's models are under a compatible license.

We also have an extensive how to contribute page:
https://github.com/KiCad/packages3D/wiki/Contributing

Maybe something similar would make sense for the symbol and footprint libraries.

SchrodingersGat, 2017-03-03:
@jkriege2 @poeschlr @evanshultz do you three mind if I add you as contributors to the KLC? You have all made valuable contributions

evanshultz, 2017-03-03:
@SchrodingersGat Of course!

In general, there are inconsistencies with period use. For example, 7.6 does not have a period in the second sentence. Most of section 1 does but the
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

Thread 910 (2017-01-15):

SOT23 single diodes do not work with the SOT-23 KiCad footprint

evanshultz, 2017-01-15:
I think I found a notable problem where KiCad is 'wrong'. See these parts:
- BZX84 series: http://www.nxp.com/documents/data_sheet/BZX84_SER.pdf
- BAS19/20/21: http://www.diodes.com/_files/datasheets/ds12004.pdf
- IMBD4148: http://www.vishay.com/docs/85731/imbd4148.pdf

(Below I'll stick with the SOT-23 pinout in KiCad, where pins 1 and 2 are along the same side and pin 3 is all by its lonesome.)

You'll notice that all of them would physically fit on the `TO_SOT_Packages_SMD:SOT-23` footprint and have electrical connections to pins 1 and 3. However, the symbol connects to pins 1 and 2. Currently when selecting the SOT-23 package, if the user wants this diode, the cathode is going to the wrong package pin!

You can see that this is a common package for many diodes from many manufacturers.

Since making alternate schematic symbols seems to be more work for the librarians, and makes the user think more before they get to CvPcb, I propose an alternate SOT-23 footprint named `TO_SOT_Packages_SMD:D_SOT-23`. This footprint would swap the locations of pins 2 and 3 from the existing SOT-23 footprint and have a clear naming scheme with the `D_` prefix. A `_Handsoldering` version should be created as well.

If this is all good, I'll get right on it. :)

jkriege2, 2017-01-15:
Hi!

hhmmm ... somehow both, the current state and the suggested solution are not perfect:
- currently you'll have to derive for every diode anew
- with the proposed change we have a SOT-23 that does not matche the pin-numbers usually used in the datasheets (which is a constraint I understand we want to impose).

Therefore I would suggest a different solution: To match the different variants of the diodes we already have I would therefore suggest to make variants `D_Schottky_ANK` and `D_ANK` ... which would have the pin 1=A, pin2=NC+hidden and pin3=K ... + possibly some rotations of needed ...

What does everybody else think?

JAN

SchrodingersGat, 2017-01-16:
For my 2c I think that a good approach would be to add a SOT-23_ANK to the https://github.com/KiCad/Diodes_SMD.pretty as this is a common, diode-related problem. This way, we can   also conform to the existing diode-related footprint filters, and users won't be presented with weird packages in the more-generic TO-SOT library.

evanshultz, 2017-01-16:
What I don't like about that is that there will need to be a unique diode schematic symbol for this package. From a user's perspective, I'd like to pick a diode and then have free reign to choose any package later. This is a big thing that differentiates KiCad since a symbol and footprint aren't locked together.

To do that, however, we need to tie pins 1 and 2 of the existing diode symbol to pins 1 and 2 on the footprint while also having a dummy pin. Is there a way to do that? I tried naming a footprint pin `N`, `~`, and a few other things but CvPcb always knows I'm trying to match a 2-pin symbol with a 3-pin footprint.

Is there a way to make this (in my opinion) clever and smooth method work?

SchrodingersGat, 2017-01-16:
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

It looks like it works if you just leave the pad blank - the footprint then  comes up in CvPcb when you click "filter by pin count"

evanshultz, 2017-01-16:
Oh. Yeah. Indeed it does. Not sure what I was doing wrong...

So would it be acceptable to add `Diodes_SMD:D_SOT-23` as follows:
```
(module D_SOT-23 (layer F.Cu) (tedit 587C4E18)
  (descr "SOT-23, Single Diode")
  (tags SOT-23)
  (attr smd)
  (fp_text reference REF** (at 0 -2.25) (layer F.SilkS)
    (effects (font (size 1 1) (thickness 0.15)))
  )
  (fp_text value D_SOT-23 (at 0 2.3) (layer F.Fab)
    (effects (font (size 1 1) (thickness 0.15)))
  )
  (fp_line (start -1.65 -1.6) (end 1.65 -1.6) (layer F.CrtYd) (width 0.05))
  (fp_line (start 1.65 -1.6) (end 1.65 1.6) (layer F.CrtYd) (width 0.05))
  (fp_line (start 1.65 1.6) (end -1.65 1.6) (layer F.CrtYd) (width 0.05))
  (fp_line (start -1.65 1.6) (end -1.65 -1.6) (layer F.CrtYd) (width 0.05))
  (fp_line (start 1.29916 -0.65024) (end 1.2509 -0.65024) (layer F.SilkS) (width 0.15))
  (fp_line (start -1.49982 0.0508) (end -1.49982 -0.65024) (layer F.SilkS) (width 0.15))
  (fp_line (start -1.49982 -0.65024) (end -1.2509 -0.65024) (layer F.SilkS) (width 0.15))
  (fp_line (start 1.29916 -0.65024) (end 1.49982 -0.65024) (layer F.SilkS) (width 0.15))
  (fp_line (start 1.49982 -0.65024) (end 1.49982 0.0508) (layer F.SilkS) (width 0.15))
  (pad 1 smd rect (at -0.95 1.00076) (size 0.8001 0.8001) (layers F.Cu F.Paste F.Mask))
  (pad "" smd rect (at 0.95 1.00076) (size 0.8001 0.8001) (layers F.Cu F.Paste F.Mask))
  (pad 2 smd rect (at 0 -0.99822) (size 0.8001 0.8001) (layers F.Cu F.Paste F.Mask))
  (model TO_SOT_Packages_SMD.3dshapes/SOT-23.wrl
    (at (xyz 0 0 0))
    (scale (xyz 1 1 1))
    (rotate (xyz 0 0 0))
  )
)
```

That seems easiest for users since the existing diode symbols don't need changed (I tried `D`, `D_Schottky`, and `ZENERsmall`), but using the aforementioned symbols their footprint filters may need updated to avoid blocking otherwise valid diode footprints.

SchrodingersGat, 2017-01-16:
Almost, with a few caveats:

1. I think it would need a suffix showing which pins are being used e.g. D_SOT-32_CNA (if pin-1 is indeed Cathode)
2. Copy the 3D shape into Diodes_SMD.3dshapes (in the future, I hope that the 3D models will be packaged with the footprints)

Submit this as a PR (to https://github.com/KiCad/Diodes_SMD.pretty) and we'll go from there :)

evanshultz, 2017-01-16:
Will do. Closing this now...

Closed 2017-01-16.

Thread 946 (2017-01-21):

Issue with PWR_FLAG and recently added MALE and FEMALE connectors

cvgaviao, 2017-01-21:
Today I was drawing a schematic with the nightly kicad and found the CONN_01X04_MALE.
I found this new item interesting and used it.
The problem is that those new item uses BIDIRECTIONAL ports instead PASSIVE (from others),
so I can't use GND or power into those pins.
If I don't add aPWR_FLAG I receive a non driven error, but if I add the PWR_FLAG I receive a conflict error.

jkriege2, 2017-01-22:
I adressed this in this PR: https://github.com/KiCad/kicad-library/pull/949

cvgaviao, 2017-01-25:
ok, thanks

Closed 2017-01-25.

Thread 1026 (2017-02-20):

Where to put shield footprints?

svheymann, 2017-02-20:
Is there a footprint lib for stuff like this i am just working on:
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

or eg Arduino/Raspi shields?

Thanks!

jkriege2, 2017-02-20:
I would say there are two options:
1. You add a project template:
2. You add the actual (micro)controller board as a part that can be mounted on the lowe-side or upper-side of the PCB, see my current PR for Arduino: https://github.com/KiCad/Modules.pretty/pull/3

Best,
JAN

svheymann, 2017-02-21:
Hmm. What i try to have in the end is a symbol with multiple parts (for each pin header) like this:
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

Where all the signal names are already in place like this in eagle:

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

And when you add one of the connectors the footprint (or part of it, or you can delete the parts you dont need?) for this shield appears in the netlist/pcbnew.

I would find it more intuitive if a shield would be a "part" in the kicad-lib that you can simply add like a normal connector but with multiple sub-parts?

That would have the advantage if you like to add one of the connectorparts later in the design process you could do that using the lib symbol or am i wrong?

jkriege2, 2017-02-21:
Then, what I proposed in 2) is what you want to do ... whether the Symbol is split or not is a different Story (and I think Splitting should be OK here).

Best,
JAN

svheymann, 2017-02-21:
Do i understand that correctly, i should add the positive footprint (upper side of the board)?
So that someone can move the needed connectors (provided by the symbol) to the correct position on the lower side of the (negative) shield and then delete the board footprint?

jkriege2, 2017-02-21:
The footprint should contain all connectors ... If you want variants where only 2 of 5 connectors are present you should make several varying footprints with names describing that ... but I don't really see the sense in that ...

svheymann, 2017-02-22:
Ok. The PR i referenced adds the board with all connectors on which the shield can be mounted.

svheymann, 2017-03-22:
I splitted the 5 connectors to 5 different symbols in one lib. Now you can choose which connectors you use on the shield board and move it to the correct position using the board template in the PR. The symbols look like this:

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

In which lib would this fit in or should i create a new olimex lib?

jkriege2, 2017-04-26:
Maybe `modules.lib`... but I'm not sure about that ...

svheymann, 2017-05-02:
I put the new symbols into a PR.

Closed 2017-10-06.

Thread 1082 (2017-03-02):

Schematic library organization improvements

evanshultz, 2017-03-02:
With the massive KLC update winding down, there are a couple topics that stand out to me with may be worth discussing and resolving as a team. Certainly the below items are non-inclusive, but they're the one that jump out at me right now.

Below I've made a lot of observations but not always suggested solutions. I'm imagining a discussion where we gather ideas and identify problems that lead to a good solution rather than start with a proposed solution.

Since Eeschema is so powerful with regards to searching, some of this is less important. It seems quite easy to find the parts I want regardless of library. But there are some cases in which I may need to hunt in multiple libraries and I can only see the contents of one library at a time. And when it comes to librarians, it will mostly be behind-the-scenes for the users but improvements for us will have a ripple effect to KiCad users.

1 Libraries are divided in a variety of ways, some by type, some by vendor, some by... another method. It feels to me haphazard and without a clear structure.

There are Maxim parts in linear.lib and maxim.lib, for example.

PIC micros are in microchip_picXX.lib, but MSP430 micros are in msp430.lib and not texas_msp430.lib.

There are logic devices in 74xgxx.lib, 74xx.lib and cmos4000.lib. They could be grouped into logic_74xgxx.lib, 74xx.lib, logic_c4000.lib, etc.

**Can we set up a set of rules for library names?**

2 Some library names seem nondescriptive and, in my opinion, do not properly describe the library contents. If I consider all the possibilities, it would seem fewer libraries that were more specific would be better for KiCad users.

For example, what would I expect to find in dc-dc.lib? Is it DC-DC modules that form a complete voltage conversion solution? A DC-DC controller IC without the power and magnetic components? A DC-DC converter IC that does include switches and/or diodes in the package? ac-dc.lib suffers from a similar problem. It's very unclear to me what I should expect to be in that lib using the same logic as above. And consider that a flyback controller or TL494, for example, could be used for low-voltage DC-DC conversion and also an offline AC-DC converter. One option would be putting these symbols into smps_controller.lib, smps_converter.lib, smps_module.lib, etc.

digital_audio.lib has ADCs, DACs, SRCs, DIRs, and other audio parts. adc_dac.lib has, it appears, (typically) non-audio ADCs and DACs. While these names are reasonably descriptive, is there still a better way?

In a somewhat different but also related way, device.lib is also so huge that it's overwhelming. This is another library with a very generic name that would likely be better off broken down into multiple libraries. Move the transformers, and possibly the other magnetic parts, to an appropriate library. The rest break into passive.lib, diode.lib, passive_network.lib, meter.lib, etc.

Also on the topic if library names, some are capitalized and some aren't. This is minor but inconsistent.

**Can we revisit the constituent symbols in the KiCad libraries to make sure the symbols are divided/grouped most usefully for KiCad users?**

SchrodingersGat, 2017-03-02:
I like the idea, and thanks for raising the topic. There are certainly some large improvements that can be made here.

One thing to consider is that some symbols are generic (e.g. `R` in device.lib) and  some are specific to a manufacturer.

Perhaps the libraries could  be separated into subdirectories for each manufacturer, with a naming scheme for function. Then generic libs stay in the top-level directory and follow the same function-specific naming scheme

e.g.

* device.lib
* switches.lib
* Microchip/PIC18.lib
* Microchip/PIC24.lib
* Texas/MSP430.lib

The trouble with that is that many of the libraries currently sort by function e.g. "interface.lib"

Some of these make sense e.g. "transistors.lib" where there are many parts with generic names that don't necessarily match a particular manufacturer.

The way that aliases work (in the current library scheme) mean that you cannot alias parts across multiple libraries (e.g. share symbols).

Perhaps someone should go through the libraries and determine if that library is best represented by manufacturer or by function?

SchrodingersGat, 2017-03-02:
We could also have a directory structure that sorts by function:

* device.lib
* micro/Microchip/PIC18.lib
* micro/Texas/MSP430.lib
* micro/ST/STM32.lib
* audio/digital.lib
* audio/amp.lib
* interface/can.lib
* interface/rs232.lib

etc

SchrodingersGat, 2017-03-04:
One requirement should be that each library has a unique name even within the directory structure

e.g.

* TEXAS/TEXAS_OpAmps.lib
* LINEAR/LINEAR_OpAmps.lib

This might also be a good reference - https://www.cskl.de/fileadmin/downloads/PCBLIBRARIES/Documentation/IPC-7351C-Land-Pattern-Naming-Convention_.pdf

keruseykaryu, 2017-03-05:
Few thougts before you start fundamental changes. The Eeschema library management is in change into **Symbol Library Table**. If the code will be "borrowed" from Pcbnew library table it will support remote GitHub libraries. And here is the whole heart of the problem: In current state of that code, where paritcular repositories are downloaded as "ZIP blobs", IMO there is no way to support subfolder structure.
So, if you force folders idea - Very good for local library storage - it will be so changed anyway.

SchrodingersGat, 2017-03-05:
@keruseykaryu fair point - I am trying to get the pretty libs into a single repo (with subfolders). Hopefully the devs agree.

Wayne (lead dev) has said that he does *not* want the new symbol libs divided into multiple repositories...

mifi2909, 2017-05-23:
I noticed a similar, erhmm, choice when I decided it was a good idea to submit a new component. I tried to raise the issue in the forum (https://forum.kicad.info/t/how-to-choose-which-library-a-new-component-goes-into/6523), but it seems good if I add my observations here as well. Note that the LM4810 and LM4811 I am talking about here are both dual headphone amplifiers, essentially beefed up opamps, sort of, but linear devices. I can think of at least three libraries to store them into, but not the one currently used for the LM4811.

This raises the question for newbie contributors how to decide where to submit a new component to. I do not like to add to confusion, so I want to do this right. I have not found much detail in the KiCAD library convention (https://github.com/KiCad/kicad-library/wiki/Kicad-Library-Convention), but perhaps I overlooked it.

My explanation in the forum:

I am creating a new component that I want to contribute: the LM4810 by TI.
I noticed there is a very similar component already in the libraries that I have used as a starting point, namely the LM4811. The LM4810 is a variant of the LM4811.

Both are dual headphone amplifiers and linear components. I noticed, however, that the LM4811 is in a library called 'digital-audio'. I can understand that LM4811 being used in that context, but the only thing digital that the LM4811 has is its touch button volume control. The LM4810 does not.

(datasheet: http://www.ti.com/lit/gpn/lm48101)

What shall I do? Put the LM4810 in the 'digital-audio' library next to its little sister, break the family ties and put the LM4810 on its own into the 'audio' library, or would it be better to move both somewhere else (I propose into the 'audio' library)?
The 'linear' library seems to be a possible alternative location for these two.
The 'texas' library could be another option, but it does not contain linear IC's as far as I have seen.

What do you all think?

m

jkriege2, 2017-05-23:
Usually when I'm faced with such a decision I go along these pathes:
1. Is it a generic (i.e. no specific part) small device (R, Pot, D, ...) then it should go to `device.lib`
2. Switches, buttons, ... go to `switches.lib`
3. specific transistors,MOSFETs,Triacs (i.e. with part-number ...) go to `transistors.lib`
4. Specific diodes, ... go to `diodes.lib` or sometimes if they are special ESD-protection devices to the `ESD_protection.lib`
5. For ICs:
  - DC-DC converters and maybe switched-cap-converters to `dc-dc.lib`
  - AC-DC converters to `ac-dc-lib`
  - normal voltage regulators go to `regul.lib`
  - your typical linear ICs go to `linear.lib`
  - Audio-related linear ICs to `audio.lib` and audio-related digitial ICs (special DACs, maybe D-class amps ...) go to `digital-audio.lib`
   - opto-ICs, LEDs, photo-diodes, ... to `opto.lib`
   - most mixed-signal and special-function stuff goes to the lib of the manufacturer, also if it's not so simple to decide that's usually not a wrong place and might be accepted ;-)
   - µCs ... go to the respective lib for their family
   - interface-ICs (RS-485 bus-drivers, RS232 converters and the like) go to `interface.lib`
   - ...

Basically there is no clear ruling (at least on my side) ... Usually I look at the proposed lib and decide: If it feels OK, I leave it, otherwise I suggest another lib and we can discuss it in the PR ... I would say a good starting point is:
  a) Where would you LOOK for such a device
  b) Where are similar device today
... as suggested above, todays sorting is sometimes not correct/non-ideal, so if you feel something is in the wrong lib, you can always raise an issue or post a PR that moves the part ... and we discuss it ...

So not really a clear answer from me ... anybody else?

cu
JAN

mifi2909, 2017-05-24:
I can work with your anwers @jkriege2.
Following your "algorithm" I came to the conclusion both the LM4810 and the LM4811 should go into `audio.lib`, since they are lineair devices for audio use.
Thanks.
So I need to report an issue about the LM4811 being in the `digital-audio.lib` (i.e. there is a better place for it) and a pull request to merge my LM4810. I will do that when ready.
Thanks again.
m

jkriege2, 2017-05-24:
If you want, just include the move from digital-audio to audio in your PR and comment on that in the PR comment ... then it should be fine (you can also ref this discussion and if I have some time I might simply review that PR ;-)

cu
JAN

mifi2909, 2017-05-24:
I have done that @jkriege2 (the move I mean). It's up for review as we speak.

poeschlr, 2018-01-20:
@evanshultz i assume this has been addressed in some of the newer discussions about library reorganization. If not please reopen over at the new symbol repo

Closed 2018-01-20.

Thread 1083 (2017-03-02):

pin header 3d shapes 1.27mm and 2mm

lostwithouthope, 2017-03-02:
hello,

wanted to say that the kicad project is awesome :)
I'm just wandering if there is a script for the generation of the pin header 3d packages and if it would be possible to extend for 1.27mm and 2mm  pitch pin headers.

cheers :)

poeschlr, 2017-03-02:
I fear that these models are generated with the old non step compatible scripts. We try to convert the 3d model library towards being more compatible with mechanical cad software. That's why we really would like to have 3d models in step file format.
The old 3d model creator lives under: http://cbernardo.github.io/kicad3Dmodels/

I would suggest you look into the scripts by @easyw. I think creating a script for the pin headers could be a good starting project for someone interested in this. These scripts create a 3d model in step and wrl format. (Which is what is preferred for new models.)
https://github.com/easyw/kicad-3d-models-in-freecad/tree/master/cadquery/FCAD_script_generator

easyw, 2017-03-03:
Hi @lostwithouthope ,
@SchrodingersGat Oliver already created the scripts to build pin-headers and box-headers for 2.54, 1.27, 2.00 pitch
I recently updated those scripts to match the generation of optimized 3d models both in STEP and WRL with material properties
requirements:
- FC 0.15 (best to create optimized STEP model)
- FreeCAD CadQuery 0.52 plugin

easyw, 2017-03-03:
fixed an issue on building models

lostwithouthope, 2017-03-03:
THX for the informations. @easyw does this mean you are going to open a pull request for those headers or should I take a look into it?

poeschlr, 2017-03-03:
@easyw  doesn't need to open a pull request. He is the owner of the repo. He can simply push to it. ;)
The latest commit seems to have fixed some problems with the box_header generator.

Shackmeister, 2017-06-14:
@poeschlr @lostwithouthope @easyw a small update on this is that I have made a lot of changes to these scripts meaning it can now generate angled connectors too. Ill push it as soon as Im done with fixing the footprints.. SMD models are also incoming :)  (btw I think the current status of the script is broken, ill add nu changes very soon)

Shackmeister, 2017-07-07:
In case you want to follow you can see the status of the new footprints and 3d models here:
https://github.com/KiCad/Pin_Headers.pretty/pull/24

Shackmeister, 2017-08-23:
All these models have been added to the official repo, Im closing this now :)

Closed 2017-08-23.

Thread 1100 (2017-03-12):

Plan for naming convention

Gasman2014, 2017-03-12:
Is there an ultimate plan for the final naming convention for the modules? This does not seem to be discussed in the KLC.

I notice that there have been some sensible name changes made to various components e.g. Resistors, Capacitors and Inductors to xx_SMD.shapes & xx_THT.3dshapes - but this does not yet apply to the Diodes - which are still Diodes _SMD.3dshapes and Diodes_ThroughHole.3dshapes. Similarly for Chokes which are Chokes_SMD or Chokes_Toroid_ThroughHole.3dshapes.

There is some further inconsistency in the naming of some of the other libraries too - especially with regard to use of manufacturer names. e.g. Transformers and NF_Transformers_ETAL

An agreed final naming convention target would be helpful as part of the KLC. I think quite a few people find it difficult to find the appropriate footprint in the current naming structure. Perhaps a tree structure of the ultimate goal would be helpful?

poeschlr, 2017-03-12:
Look at the current klc draft.
https://github.com/SchrodingersGat/kicad-library/wiki/KLC
Especially the first paragraph
And the first paragraphs of the symbol and footprint sections.

What would you add to make it more clear.

jkriege2, 2017-03-12:
Hi!

a few comments:
1. I think `_ThroughHole` will be removed eventually. The problem is, we cannot simply delete a repository, as KiCAD will crash when it doesn't find a repo explicitly listed in a project-file (as far as I understood that)
2. nevertheless we're in the process of reorganizing and the effort is quite far by now. Note please that several Repos have been labeled deprecated (see https://github.com/KiCad/kicad-library/blob/master/template/fp-lib-table.for-github for a list, just search for "deprecated"). Also I hope that we put that note into the Readme.md displayed when opening any Repo on GitHub, see e.g. https://github.com/KiCad/Air_Coils_SML_NEOSID.pretty
3. That said: The coild have been reorganized into 4 new repos:
  - https://github.com/KiCad/Inductors_SMD.pretty
  - https://github.com/KiCad/Inductors_THT.pretty
  - https://github.com/KiCad/Transformers_SMD.pretty
  - https://github.com/KiCad/Transformers_THT.pretty
In that process all old symbols were merged into the new repos and partly renamed in the process!
4. We're slowly converting the 3D repos to that naming convention too ... but that takes time, as it also requires changing the links in the footprints!

If there's anything left after these 3 points, please let us know, so we can fix it ;-)

Best,
JAN

Gasman2014, 2017-03-12:
Thank you both, Rene & Jan. That is very comprehensive. The link that Rene provides is particularly helpful and the workflow explanation from Jan is very clear.

I would point out that the link to the KLC on this Github repo takes you to a page which is less comprehensive (https://github.com/KiCad/kicad-library/wiki/Kicad-Library-Convention) which is why I raised the issue. Perhaps the new, proposed KLC summary could be linked as an additional document to this repo?

jkriege2, 2017-03-12:
the new KLCs are currently still discussed (although mostly complete) and should go live (i.e. replace the old version) in the next days (hopefully). You can follow the discussion here: https://github.com/KiCad/kicad-library/issues/879

Can this issues be closed then?

Gasman2014, 2017-03-12:
Yes, please. My only comment is that the final KLC roadmap might have been made clearer ahead of the start of implementation but understand that things evolve! I appreciate that the current implementation is somewhat 'sub-optimal' ;) and that further changes will devolve from the move to .sweet / .richio .

Closed 2017-03-12.

Thread 1131 (2017-03-30):

Incompatible requirements for symbol conventions?

SteveevetS, 2017-03-30:
KiCAD Library Convention
3. General Rules for Symbols
1) Using a 100mil grid, pin ends and origin must lie on grid nodes (IEC-60617).
2) For black-box symbols, pins have a length of 100mils. Large pin numbers can be accomodated by incrementing the length in steps of 50mils.
3) Origin is placed in the middle of symbol.

It is not possible to always meet "1)" and "3)" simultaneously while maintaining symmetry and minimum size for a symbol.  Consider a simple 8 pin symbol, with 4 pins arranged on each vertical edge of the symbol outline.  In this case it is necessary to use the 50mil grid to maintain symmetry, unless one is willing to leave a blank pin position in the middle of each set of four pins.  Note that a symbol drawn on the 50mil grid will be consistent with the default 50mil grid recommendation for EEschema, and pin ends can still be multiples of 100mils apart.  The symbol origin will still be at the origin of the editor.  To fix this issue, I suggest that "1)" read as follows:
1) There must exist a 100mil grid, such that all pin ends lie on grid nodes (IEC-60617).  The symbol may be shifted by 50 mils in any direction to line up with said 100mil grid in the Part Library Editor.

SchrodingersGat, 2017-03-30:
@SteveevetS the [new KLC version](https://github.com/SchrodingersGat/kicad-library/wiki/KLC) is almost out - and this wording has been cleaned up there.

SteveevetS, 2017-03-30:
Great - Thanks!

SteveevetS, 2017-04-03:
I think the issue still remains.  Please see the items with an "*" below from the newly released KCL, and my original post above.  In practice, symbols are being drawn with a 50mil grid with their origins on the 50mil grid,  even though the pin origins are on "a" (not "the") 100mil grid.  This was personally a source of confusion for me, so I think others will find the same issue.  I think it should be clear that the 50mil grid must be used for symbols, with pin origins on _**A**_ 100mil grid, not necessarily _the_ 100mil grid.

4. General Rules for Symbols
    Pin placement
        *Using a 100mil grid, pin origin must lie on grid nodes (IEC-60617)
        Pins should have a length of at least 100mils (2.54mm)
        Pin length should not be more than 300mils (7.62mm)
        Pin length can be incremented in steps of 50mils (1.27mm) if required e.g. for long pin numbers
        Shorter pins may be allowed for simple symbols such as resistors, capacitors, diodes, etc
    Symbol visual style
        *Origin is placed in the middle of symbol

evanshultz, 2017-04-03:
@SteveevetS Can you explain the issue in more detail? If the pins are an even number, and spaced equally, then the symbol will have empty area at the top or bottom. But that doesn't violate KLC in any way. The origin can still be in the middle with all pins on a 100mil grid.

50mil grid isn't required for symbols. Only pin origin (end) must be on a 100mil grid. Otherwise, there are no requirements for the placement location of elements.

I believe I see what you're saying, and it is true that many symbols in the existing libraries are not KLC-compliant, but I don't see why "the" or "a" has any bearing on the KLC requirements. Certainly there is a barrier to entry for any sufficiently complex set of rules, like KLC, but I would like your help to better understand your perspective since I'm not seeing it.

hackscribble, 2017-04-03:
In this example, pins are on the 100mil grid and the symbol centre is at (0,0).  The symbol is taller than it needs to be.

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

In this example, pins are on the 100mil grid but the symbol centre is not at (0,0).  Looks better but breaks KLC.

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

Finally, here the pins and symbol are on 50mil grid, the symbol centre is at (0,0) and the pins are spaced 100mil apart.  I think this is what @SteveevetS is suggesting, and I agree.  But it needs a change to the KLC.

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

jkriege2, 2017-04-03:
Please note that there can also be exceptions to certain rules of the KLC, if there is a reason. Usually the center-rule is seen as less important than the 100mil grid. So usually we place the center a bot off from the symbol center to get the pins on THE 100mil grid.

Best,
JAN

hackscribble, 2017-04-03:
Thanks, @jkriege2

So the second of the three examples is the preferred style.

jkriege2, 2017-04-03:
I would say that's what we've done most of the time ...

evanshultz, 2017-04-03:
It's situation-dependent. The first example is fine too, IMO. Perhaps the pins are spaced apart at +100mil and -100mil above and below the x-axis. Or if there are 3 pins on the side, then all is balanced. I've seen a number of styles in the library that all meet KLC and are acceptable?

Has this question been answered?

SteveevetS, 2017-04-03:
Hackscribble hit the nail on the head.  I much prefer the third figure for its symmetry, and I've seen examples of this in the Libraries.  This does violate KLC, though, as written (or at least it's unclear), so this is why I'm advocating a change or clarification in KLC.  The pin origins of the 3rd symbol are not on **_THE_** 100mil grid, but they are on _**A**_ 100mil grid.  Is there any disadvantage to using a 50mil grid for symbols with the added constraint that pin-origins must be on "A" 100mil grid?

In my library, I have even less constraint.  I allow pin origins to be on a 50mil grid (no 100mil grid exists to coincide with all pin-origins), but I don't allow any two pin origins to be less than 100mils apart.  This results in the smallest possible, symmetrical symbol, and it works fine as long as you use a 50mil grid in Eeschema (the default and recommended grid).  I think it also achieves the intent of "100mil grid" for pin-origins.  In the example attached , only pins 4, 1, and 8 are on THE 100mil grid.  Is there any reason that this symbol would be objectionable?

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

bobc, 2017-04-04:
It depends how you interpret "middle" in "Origin is placed in the middle of symbol". To engineers, middle can mean the exact center to 1 micron, but they might also ask "centroid or circumcenter?". In layman's use, "middle" just means somewhere near the center.

We just need a middle point which is somewhere around the visual center of the symbol, the origin has no electrical, mechanical or other technical significance. It's purely for aesthetic and consistency reasons.

If you like, the rule could be clarified -

    Origin is placed in the middle of symbol (to nearest grid node)

And there is no incompatibility or functional change.

SteveevetS, 2017-04-04:
Yes, I (an engineer) agree that indicating that "middle" is just to the nearest 100mil grid node would clarify the rule.  Is the intent to allow symbols to work with a 100mil Eeschema grid?  If so, then I'm satisfied that simply clarifying the definition of "middle" will suffice.  The reason that I ask the question is that the default and recommended grid for Eeschema is 50mils.  I'm not advocating that pins have 50mil spacing, but asking that symbols constructed on a 50mil grid with 100mil pin spacing be considered. - Thanks.

Misca1234, 2017-10-22:
> Using a 100mil grid, pin ends and origin must lie on grid nodes (IEC-60617).

I find it amazing that KiCad community even thinking of adhering to to this rule, well if the rule is even in there.
This mil (milli-inch) thing is the worst and most stupid "invention" within the engineering community since the introduction of the metric system.

Now, there was time when metric and imperial system was competing a little (a couple hundreds years ago, 1 or 2 month right after the French revolution) but that battle was over long time ago.
We all also find the story about the standard yard in wood that burned up a little amusing but today none is using imperial/USCS/English units except for some people in backwater communities or children that suffer from an upbringing under harsh conditions by parents that dreamed of the good old days when youth knew their place.

Since the last 50 years or more the yard (and therefore the inch) is defined as a scale factor of the meter, so the relation ship between meter and inch is not even an irrational number any more, just a scale factor, which diminish the need for inch even less.

Now, those of us that rememberer TTL logic and the DIL capsules understand why and where this mil crap comes from but it does not automatically justify the usage of this and without any doubt it shows that the stubborn old backwater engineers are active within the IEC community.

Even countries that used to use imperial/USCS/English units don't even use the term mil, because they get an internal mess in the documentation them-self because its similarity to the short from of millimetres, they use the word "thou".

So justify or argue for the usage of mils by pointing on IEC-60617 means that the same goes for all other rules stated in IEC-60617. It also means that any work within KiCad community which touch an IEC XXXX must follow that IEC XXXX.

This means that either the mil crap is accepted which also means that any work, action or contribution that violates any IEC XXXX can not be accepted.

But if KiCad community accepts any deviations from any IEC XXXX it means that KiCad community does not need to adhere to the mil crap in IEC-60617.

poeschlr, 2017-10-22:
We only need this 100mil stuff until eeschema can snap wires to pins. Currently if a pin is not on grid you can not connect to it.
100mil is the highest grid in eeschema. (Or most coarse grid? No clue how to communicate this in english.) This means if the symbol has it's pins on this grid then it works on any grid that is available in eeschema.
Another possibility would be the 50mil grid. (next step down.) We allow this for small symbols. (Of course this means this symbols can not be used with eeschema set to 100mil grid.)

bobc, 2017-10-22:
AFAIK from an old copy of IEC-60617 is that it says "All of the symbols are designed so that their connection points fall on a modular grid" which is eminently sensible. It does not seem to prescribe a specific grid size.

As @poeschlr describes, 100 mil grid is chosen for practical reasons. We could I suppose specify a 2.54mm grid in the KLC, would that help?

Either way, for Sunday morning relaxation I recommend Frank Sinatra on the music player, jam on toast and a nice cup of tea :) There are lots of things about the modern world to stress about, but a legacy use of imperial measurements is not one of them...

jkriege2, 2017-10-22:
+10 for the jam&tea ;-)

SchrodingersGat, 2017-11-21:
@SteveevetS please refer to the new KLC at http://kicad-pcb.org/libraries/klc/

If you feel that this issue has been resolved to your liking, please close this issue. Thanks :)

poeschlr, 2018-01-20:
I assume this has been addressed here and in the new KLC. If not please reopen this over at the new repo https://github.com/KiCad/kicad-symbols

Closed 2018-01-20.

Thread 1137 (2017-04-03):

SMD Footprints: Should not be different for Res and Cap of the same size

kaitrek, 2017-04-03:
From the looks of it, the SMD footprints do not follow IPC specifications, nor are they consistent between libraries.
For example, Capacitors_SMD:C_0603 and Resistors_SMD:R_0603 do not have the same footprint, but they should based on IPC 7351.

I think there should be just 1 library called "SMD_Chip". (There's room for debate over whether SMD_Chip_LevelA, SMD_Chip_LevelB, SMD_Chip_LevelC libraries would be more appropriate, but I think having just 1 library is easier for the user). Each footprint name would indicate density level it's following, for example "0603A", "0603B", "0603C" and hand soldering versions should also be available "0603B_HandSoldering", given that a script would generate the land patterns, I don't see the need to restrict a specific density level whether or not it is allowed to have hand soldering footprints or not.

Whether you refer to the 2005 IPC document or the proposed new C version, both do not distinguish between resistor nor capacitor footprints:
http://pcbget.ru/Files/Standarts/IPC_7351.pdf or http://www.cskl.de/fileadmin/downloads/PCBLIBRARIES/Documentation/What-is-New-in-IPC-7351C_.pdf
http://i.imgur.com/9gDuQQ5.png
http://i.imgur.com/JmZIkZ4.png

metacollin, 2017-04-03:
@kaitrek, I agree with most of what you've said, except for having a single "SMD_Chip" library.  We cannot use a unified set of 0603/0402/0805 etc. footprints because the resistor SMD footprints have different 3D models than the capacitor footprints.  If we were to use a single 0603 footprint, then boards would not have the correct appearance in the 3D view, and incorrect models would get outputted when exporting a 3D model of the board.

So we need separate R and C SMD footprints, but the actual footprint in pcbnew should indeed be identical.

SchrodingersGat, 2017-04-03:
The R and C footprints should be consistent, and we should also provide A/B/C densities.

However as @metacollin says they should still be kept in separate libraries.

kaitrek, 2017-04-03:
I forgot that 3D models are associated with footprints, then let's keep the 2 libraries, but the densities, consistent footprints and rounded pads should be implemented.

pointhi, 2017-04-03:
@kaitrek

There is already some work going on. I wrote a script which can create such footprints, but it's missing actual values: https://github.com/KiCad/Resistors_SMD.pretty/issues/16#issuecomment-282728822

If you are interested, you can improve/complete the table, and we are finally able to create ipc compliant footprints: https://github.com/pointhi/kicad-footprint-generator/blob/master/scripts/Resistors_SMD/smd_chip_resistors_smd.csv

timsu100, 2017-04-09:
I would like to help to create the footprints, but I'm not sure how to interpret the tables in:
http://www.cskl.de/fileadmin/downloads/PCBLIBRARIES/Documentation/What-is-New-in-IPC-7351C_.pdf

On page 41 are the three densitiy levels (A,B,C) described.
The next page lists the different sizes with dimensions for toe, heel and side related to package height. Do I have to add them to the densitiy level table to get the final toe heel and side?

Page 44 shows how to calculate pad length and pad distance. To do this "Nominal L" is required. Where do I get this from?

Maybe SMD fuses, inductors and diodes could also be based on this.

kaitrek, 2017-04-09:
There is no defined Nominal L, it is given by the manufacturer.
However I've been looking at all the manufacturer datasheets, and most of them have a median number that can be used without the min/max tolerance.

I suggest KLC builds a table of Nominal L for internal consumption to generate these footprints.

For example, after looking at the below datasheets, I decided that the 0603 footprint should have 0.35mm Nominal L, since that is the average/median number that kept popping up.
In no particular order:
http://www.yageo.com/documents/recent/UPY-GPHC_X7R_6.3V-to-50V_17.pdf
http://datasheets.avx.com/X7RDielectric.pdf
http://www.kemet.com/Lists/ProductCatalog/Attachments/53/KEM_C1002_X7R_SMD.pdf
http://www.yuden.co.jp/productdata/catalog/en/mlcc_all_e.pdf
https://www.johansondielectrics.com/downloads/jdi-product-catalog.pdf
http://www.vishay.com/docs/45199/vjcommercialseries.pdf
http://www.samsungsem.com/kr/support/library/product-catalog/__icsFiles/afieldfile/2016/09/27/MLCC.pdf

kaitrek, 2017-04-09:
A rule for the size of hand soldering should also be defined for KLC. I think 0.7mm seemed like overkill and 0.4mm was better.

Also FYI, pads should have rounded corners 25% width.

poeschlr, 2017-04-09:
> Also FYI, pads should have rounded corners 25% width.

The library should always be compatible with the current stable version of kicad.
The problem is that the current stable version does not support rounded rectangles. This means if you want to achieve this you need to combine multiple pads of different shapes. This will change when version 5 is released. (The development version already supports rounded rectangles.)

timsu100, 2017-04-10:
So is this Calculation for 0603 Level B correct?

Length = 1.60
Width = 0.80

Toe = 0.275 + 0.35 = 0.625 ~ 0.63
Heel = 0.055 + 0.00 = 0.055 ~ 0.06
Side = 0.083 + 0.00 = 0.083 ~ 0.08
Courtyard = 0.20 + 0.25 = 0.45 ~ 0.5

Pad Length = Nominal L + Heel + Toe = 0.35 + 0.06 + 0.63 = 1.04
Pad Centers = Length + 2\*Toe - Pad Length = 1.60 + 2\*0.63 - 1.04 = 1.82
Pad Width = Width + 2\*Side = 0.80 + 2*0.08 = 0.96

kaitrek, 2017-04-10:
Where did 0.275 come from for the toe? If it's from the "New Solder Joint Goal Recommendations" slide page, I'm not quite sure what that page means. Based on the older IPC-7351 document the table on the page before that one is the right one.

Toe is defined in the table as 0.35mm for 0603.
Heel and Side are 0.0mm.
Courtyard is 0.25mm.
FYI, the round off is to 2nd decimal place, so 0.45mm is 0.45mm, not 0.5mm.

Pad Length = Nominal L + Heel + Toe = 0.35 + 0.0 + 0.35 = 0.70mm
Pad Centers = Length + 2*Toe - Pad Length = 1.60 + 2*0.35 - 0.70 = 1.60mm
Pad Width = Width + 2*Side = 0.80 + 2*0.00 = 0.80mm

timsu100, 2017-04-10:
Yes it is from that page.
I thought you have to take the "New Solder Joint Goal Recommendations" and add the Level A/B/C to it.
But this seems to make the footprints a little bit big.

timsu100, 2017-04-13:
Small Update:
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
These are generated from the above formula.
Should the reference designator be in the footprint in the fab layer? The font would be really small on the smaller footprints.

It seems to be hard to find the nominal l sizes, they seem to differ quite a bit.
Some are here:
http://www.kemet.com/Lists/TechnicalArticles/Attachments/29/f2100e.pdf (Table 1,2,8,9 - Dimension T)
https://media.digikey.com/pdf/Data%20Sheets/Samsung%20PDFs/RC_Series_ds.pdf (Page 2 - Dimension B)

SchrodingersGat, 2017-11-21:
@poeschlr has regenerated all these new chip devices at the new https://github.com/kicad-footprints repository. Closing this issue as "solved" :)

Closed 2017-11-21.

Thread 1143 (2017-04-04):

KLC 2.1 discussion

evanshultz, 2017-04-04:
@SchrodingersGat @jkriege2 @poeschlr Why wait?

Stemming from KLC 2.0: https://github.com/KiCad/kicad-library/wiki/Kicad-Library-Convention
And the FAQ: https://github.com/KiCad/kicad-library/wiki/Frequently-asked-questions

evanshultz, 2017-04-04:
**KLC**

3.12 Should the FPFilters be prepended with an asterisk too? Imagine the FPFilter is DPAK or TO-252 and that footprint name is TO-252_DPAK. In this case, we'd need an asterisk to catch the DPAK. There are several footprints which have multiple footprint names concatenated together with underscores and we need a leading asterisk to catch them. I don't see a disadvantage to using a leading asterisk on all FPFilters.

4 The use of alias isn't mentioned at all. Perhaps a quick description and example. And there is an ALIAS rule I'd like to clarify also. Should minor differences  (like temp ratings of LM319/LM219/LM119) be an ALIAS or only add one part and let the user modify the part number by hand after symbol placement?

4 Ref des and value placement. Such as center justified if placed on the y-axis, left justified if placed right of the origin, both above or ref des above while value is below, etc. See #848. I'm not sure the logic in KiCad 5.x, but if the libraries should be set up in any specific way to guide 5.x then we should do it now.

4.2 Markings for pin style or input type that aren't part of setting the Pin Type. Like adding a Schmitt trigger symbol on an appropriate logic gate, adding a bubble to show logic low or inverting input, etc. I vote yes on Schmitt trigger but no otherwise (leave it up to KiCad by Pin Type selection).

4.2 Some symbols, especially ADCs and DACs, have intricate inner circuit "summarized" in the symbol. Do we encourage or discourage this? Don't care?

6.6.i/6.6.ii Remove initial "e.g." since this isn't connected to a preceding statement.

10.4.ii Is this rule only a recommendation or a requirement?

The notes in section 5, 6, and the KLC Helper Script have different font/style but all seem to be notes of equal importance. Why aren't all notes using a consistent font/style?

**FAQ**

I think the FAQ should be enumerated so it's easier to refer to a specific item.

https://github.com/KiCad/kicad-library/wiki/Frequently-asked-questions#run-klc-scripts-locally: Broken link to library utils.

https://github.com/KiCad/kicad-library/wiki/Frequently-asked-questions#footprint-association: The footprint naming shows asterisks before each footprint name, as I suggested above. Is this going to be standard practice to use a leading and trailing asterisk? FAQ and KLC need to conform.

https://github.com/KiCad/kicad-library/wiki/Frequently-asked-questions#symbol-variants: Missing underscores in symbol names. Also, why aren't these using the most generic package name instead of the LTC-specific names. Combing these two, the examples could be `LTC4357_DFN` and `LTC4357_MSOP`.

https://github.com/KiCad/kicad-library/wiki/Frequently-asked-questions#multi-unit-symbols: It shows MCP6004 power pin names as 'Vdd' and 'Vss', but the datasheet clearly is using small capital letters. How to handle this? All capital?

hackscribble, 2017-04-04:
KLC section 4 is silent on pin numbering, while `checklib.py` calls `EC01.py` to check for duplicate pin numbers and no pin numbers without a numeral.  Should the EC01 checks be formally included in KLC, either as mandatory or recommended?

evanshultz, 2017-04-10:
**KLC**

3.6 We're not covering when a part has different package types in the same package style. See [L272](http://www.st.com/content/ccc/resource/technical/document/datasheet/02/9c/bc/75/59/9c/47/bd/CD00000054.pdf/files/CD00000054.pdf/jcr:content/translations/en.CD0000005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). It comes in 8 pin DIP and 16 pin DIP. Perhaps give this as an example with `L272_DIP8` and `L272_DIP16`?

3.6 Also, what about if the same part with a different manufacturer suffix is available in the same package? See [MCP6566](http://ww1.microchip.com/downloads/en/DeviceDoc/DS20002143E.pdf
). Most of the time using the simplified package name seems to work well but here it's unpleasant.

4 Does not specify text must not overlap with other elements of the schematic symbol. I assume text definitely should not overlap, but perhaps other elements should be specified as non-overlapping too?

poeschlr, 2017-04-15:
From issue #1159

Rule 4.3.iv (pin stacking: stacked pins have the same electrical type) creates erc errors if these pins are power output pins. Not sure if we should solve this problems by creating an exception for power output pins or if the erc checker should be changed. (I think the later would be the better long term solution. But well we would need somebody who does it. In the meantime i think we should "fix" it from the library side.)

If we want to "solve" the problem via avoiding stacked power output pins maybe either add a new rule:
> If a component has multiple power output pins that are interconnected, these pins are stacked and only one pin is set as visible with electrical type power output. All other pins are invisible and electrical type passive.

Or make an exception to 4.3.iv:
> Pins must have the same electrical type (Exception: If the pins are of type power output only the visible pin has the type power output all other stacked pins are of type passive.)

The problem here is that the symbol editor does not like this. It changes all stacked pins to be equal if one changes any pin while they are stacked. This means if one wants to edit something in the pin properties one needs to move them apart, do the changes and move them back on top of each other.

maqifrnswa, 2017-05-04:
Something new consider, based on https://github.com/KiCad/kicad-library/pull/1207#issuecomment-299075457

For consistency in style: "When drawing symbols follow, the symbols should try to follow that used on the datasheet, except when the datasheet style conflicts with other components of KLC"

This is to avoid situations in the audio library where some devices look like op amps and some look like ICs. It just helps clear up some ambiguity and allows kicad to defer style decisions to the manufacturer  This may be hard because different manufacturers may use different styles, and the same datasheet may use different styles.

bobc, 2017-06-28:
**Keywords**

Keywords seem to be a bit random and not very consistent. perhaps we could have a list of suggested/recommended keywords, maybe on per library basis.
I have a script to extract keywords, here is a snippet for 74xx.lib

```
3
3State
ADD
ALU
and2
And3
And4
ANDNOR
Arith
BIDI
buffer
BUS
CNT
CNT4
COMP
DECOD
DECOD10
DECOD16
DECOD4
DECOD7
DECOD8
DEMUX
DEMUX4
DEMUX8
DFF
DFF4
DFF6
DFF8
```
"3" is not a very useful search term. A lot of the "codes" are not very guessable, unless you already know what you are looking for.

SchrodingersGat, 2017-06-30:
@bobc I think suggesting a "style" for keywords is a good idea. It would be good to give some long-form description of what constitutes a good keyword (and what doesn't).

A lot of it is "common sense" but sometimes does need to be explained.

matthijskooijman, 2017-07-05:
I just read through the KLC and the FAQ for the first time, and thought to write down things that I noted. I'm not quite familiar with the footprint standards (and only moderately familiar with KiCad), so take my suggestions with a grain of salt :-)

> 1.4: When dimensions are used in part name, they are in millimeters, decimal places separated by a dot e.g. C_Rect_L13mm_W4mm_P10mm

Having a decimal in the example might be helpful.

> 3.3: Manufacturer Part Number (MPN) should be used given preference

I think this sentence has extra words or is missing them, but I'm not sure.

> 4.6.i: Power and Ground pins should be set to either POWER INPUT or POWER OUTPUT

I believe ground pins are always POWER INPUT? If so, this should be stated. If not, some additional guidance could be given. In general, some additional guidance about electrical types wouldn't hurt.

> 4.10.i.a: For symbols with a default footprint, the human-readable footprint name should be appended to the description e.g. SOIC-8
> 4.10.iii: For parts with different symbols associated with different footprints, shortform footprint name should be specified in the description field (e.g. DIP8)

These rules look redundant to me.

> 4.11.ii: For components with a single default footprint, the Footprint field is filled with a valid entry of the format Footprint_Library:Footprint_Name
> 4.11.iii: For components with multiple possible footprints, the Footprint field should be left blank

When does a part have "a single footprint" exactly? The FAQ states that parts which are supplied with different footprints should become separate symbols, so the part a symbol refers to is only available with one footprint. It could also mean there is only a single appropriate footprint in the footprint libraries, but isn't this something that can change over time when alternative versions (e.g. handsoldering versions) are added. My hunch is that parts should pretty much *always* use wildcard filters (or at least by default).

In fact, the FAQ already contains a confusing example:

> For example, the INA19x operational amplifier is available in a SOT-23-5 footprint, and so the corresponding footprint field should be set to (for example) TO_SOT_Packages_SMD:SOT-23-5

However, there's two relevant footprints ([SOT-23-5](https://github.com/KiCad/TO_SOT_Packages_SMD.pretty/blob/master/SOT-23-5.kicad_mod) and [SOT-23-5_HandSoldering](https://github.com/KiCad/TO_SOT_Packages_SMD.pretty/blob/master/SOT-23-5_HandSoldering.kicad_mod) already, so a filter would be more appropriate.

The next example is also contridactory:

> Footprint filters use the asterisk (*) symbol as a wildcard to allow matching various footprint names. This allows matches for variants of the same footprint e.g. SOIC-8* will match SOIC-8 and SOIC-8_HandSoldering.

Firstly, the mentioned "SOIC-8" and "SOIC-8_HandSoldering" do not exist (anymore?), only "SMD_Packages:SOIC-8-N", "SOIC:SOIC-8-1EP_3.9x4.9mm_Pitch1.27mm" and "Housings_SOIC:SOIC-8_3.9x4.9mm_Pitch1.27mm".

Secondly, it contradicts with the KLC:

> 4.12.iii: Filters should not match the pin count - this is performed by KiCad's internal footprint association
> 4.12.iv: Filters should match dimension information (where required) to be as specific as possible, e.g.
    b. SOIC*3.9x8.7mm*Pitch1.27mm* to match SOIC-14_3.9x8.7mm_Pitch1.27mm

On a related note: Noting the "multiple footprints" -> "multiple symbols" rule in the KLC might be useful and help interpreting some of the other rules?

> 6.2: Package name and number of pins are separated using a hyphen. e.g. SOT-89, SOT-23-5.

This sort of implies that SOT-89 has 89 pins. What's the point of this example?

> 8.1: Footprint Placement type should be set to Surface mount
> 9.1: Footprint Placement type should be set to Through hole

Perhaps this should note that older KiCad versions call this "Attributes":  "Normal+Insert" and "Normal" respectively?

> FAQ: Generic vs Atomic parts

Are parts like "2N7000", which are manufactured by multiple manufacturers atomic or generic parts? I suspect generic, but this might need an example.

suzizecat, 2017-07-06:
> When does a part have "a single footprint" exactly? The FAQ states that parts which are supplied with different footprints should become separate symbols, so the part a symbol refers to is only available with one footprint. It could also mean there is only a single appropriate footprint in the footprint libraries, but isn't this something that can change over time when alternative versions (e.g. handsoldering versions) are added. My hunch is that parts should pretty much always use wildcard filters (or at least by default).

Sometimes, you can have a single component with multiple footprints and almost the same part number (see http://www.ti.com/lit/ds/symlink/cd74hc08.pdf for an example). In this case, you just let the user chose which one he wants. If you only got one FP possible, you'll add it in the component field.

In any case, you should fill the FP filtering fields, even if there is only one choice possible. With that, if someone wants to add a variant to the footprint (handsoldering for example) then it's possible and the user can easily change it.

matthijskooijman, 2017-07-06:
> Sometimes, you can have a single component with multiple footprints and almost the same part number (see http://www.ti.com/lit/ds/symlink/cd74hc08.pdf for an example). In this case, you just let the user chose which one he wants. If you only got one FP possible, you'll add it in the component field.

This is not how I interpret [the FAQ](https://github.com/KiCad/kicad-library/wiki/Frequently-asked-questions#symbol-variants):

> Where components have multiple footprint options, a separate symbol should be drawn for each footprint option. Each symbol should have the appropriate aliases added if required.

In your example, I would think this would need multiple symbols (not aliases), e.g.
 - CD74HC08E for the PDIP package
 - CD74HC08Mx for the SOIC package
 - CD74HC08Px for the TSSOP package

>In any case, you should fill the FP filtering fields, even if there is only one choice possible. With that, if someone wants to add a variant to the footprint (handsoldering for example) then it's possible and the user can easily change it.

That would also make sense to me, yes. But that's not how I interpret the current rules:

> 4.11.ii: For components with a single default footprint, the Footprint field is filled with a valid entry of the format Footprint_Library:Footprint_Name
> 4.11.iii: For components with multiple possible footprints, the Footprint field should be left blank

To me, it looks like 4.11.ii and 4.11.iii are mutually exclusive, but perhaps I'm misinterpreting and they are expected to both apply in a lot of cases (so a component has a "single default footprint" in the Footprint field, but also "multiple possible footprints" in the alias field).

bobc, 2017-07-06:
My understanding is that parts with multiple footprints that nevertheless
have identical pin out can be a single component.
For parts that have different pin out in different footprints, then these
must be separate components.

4.11 ii and iii seem more like "recommended" rather than "mandatory".

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

poeschlr, 2017-07-06:
> To me, it looks like 4.11.ii and 4.11.iii are mutually exclusive, but perhaps I'm misinterpreting and they are expected to both apply in a lot of cases (so a component has a "single default footprint" in the Footprint field, but also "multiple possible footprints" in the alias field).

It does talk about different use cases. One applies where you have one specialized symbol per footprint. (Most ICs fall into this category.) The other rule talks about cases where this does not make sense. (Example: Resistors, Capacitors, Diodes, Connectors, ...)

hackscribble, 2017-07-06:
> 4.11.ii: For components with a single default footprint, the Footprint field is filled with a valid entry of the format Footprint_Library:Footprint_Name
4.11.iii: For components with multiple possible footprints, the Footprint field should be left blank

> To me, it looks like 4.11.ii and 4.11.iii are mutually exclusive, but perhaps I'm misinterpreting and they are expected to both apply in a lot of cases (so a component has a "single default footprint" in the Footprint field, but also "multiple possible footprints" in the alias field).

> It does talk about different use cases. One applies where you have one specialized symbol per footprint. (Most ICs fall into this category.) The other rule talks about cases where this does not make sense. (Example: Resistors, Capacitors, Diodes, Connectors, ...)

We should remove the word `default` from 4.11.ii.

With it, it can be read as meaning " a preferred footprint but others are possible".   Without it, the two bullet points align with the use cases that @poeschlr described.

jkriege2, 2017-07-06:
Those rules were designed for the case where you have a component that is available in multiple packages (if there is only one package: all is clear). In such case we have several sub-cases:
1. all variants have the same pin-number and share the same pinout. Then you can have one symbol, which does not have a definite footprint (i.e. footprint field empyt), but has a list of FPFilters that maches (together with the pin-count filter) each available package ... this is often the case for TTL logic devices that are e.g. available in SO-14, TSOP-14, DIL-14, ... all with the same pinout
2. some variants have a different pinout: Then you need a separate symbol AT LEAST for those variants. The others can be summarized in a single symbol using the FPFilter strategy. The other variants can either have set footprint fields or also give several options by FPFilters.

This approach has several advantages: We don't need one symbol per package, i.e. we don't have 3 or for 7414, but only one. The symbol then represents the function of the device and the footprint is associated when the schematic is complete and you decide which variant to place on the board. Otherwise you will have to go back to the schematic delete all sub-symbols of that IC13, which you now want in DIP14, not TSOP-14 and add them all again. Also this makes it easier to manage the lib, as we need to fix only one 7414 symbol and not 3 if there should be a bug.

So yes, we should remove the word `default`.

JAN

matthijskooijman, 2017-07-07:
> all variants have the same pin-number and share the same pinout. Then you can have one symbol, (...)

This sounds reasonable to me, but perhaps the FAQ should be clarified. It gives two examples that need different symbols (different packages with different numbers of pins, and same package with different pinout), but it lacks an example where different footprints have the same pinout and can thus share a symbol.

Here's the two current examples I mentioned:

> As a first example, consider LTC4357 which is available in a 6-pin DFN package and an 8-pin MSOP. This requires two symbols to be added,
> (...)
> The last example is when a part has different pinouts in the same package. MCP6566 is available with 3 different pinouts all in the same SOT-23-5 package. Three symbols should be created,

In hindsight, I think I originally read the first example as "Multiple footprints with the same pinout should still have multiple symbols", but re-reading I now see this talks about 6-pin vs 8-pin, which are by definition not compatible, so it's probably just a matter of adding an example, and perhaps improving this part of the FAQ:

> For parts that are available in different footprints, a unique part should be created for each variant. These variants should be named according to the manufacturer datasheet.

Also, I was thinking that the rules stated that FP filters should only be used when the Footprint field is empty, but re-reading the rules that understanding was completely wrong. The rules are even explicit about this:

> 4.11.v: Filters should be used even if a default footprint is given

I'm not quite sure where my confusion came from, so sorry for the noise :-S

I did notice a new issue:

> 4.11.iii: Footprint filters should be added as appropriate to match all possible footprints (see KLC 4.13 below)

This refers to 4.13, but that doesn't seem appropriate. Perhaps it should reference 4.12 instead? Same for:

> 4.9.3: The Footprint field is filled according to rule 4.12 (below) and is invisible

I think that should reference 4.11 instead.

bobc, 2017-08-31:
From #1580

> we also don't fill transistor-circles with yellow ...

That might be our practice, but is not reflected by the KLC!

> 4.2 iii Fill style of symbol body is set to Fill background

Clearly according to the KLC transistors should be filled. There is no exemption allowed for transistor or other symbols. If we want to exempt transistors etc, that needs to be written in and not applied on an _ad hoc_ basis.

We probably don't want "basic" symbols resistors and capacitors with filled body, but there are currently some symbols which I would not expect to be filled, e.g. opamps and crystals.

The question is where do you draw the line, and do you define it? I would propose that an exception is made for symbols with a "distinctive shape" (term used by IEC). Only symbols with a rectangular shape should be filled, but we need to make a special case for the box resistor symbol. There is also a practical problem in KiCad for unusual shapes, they are impossible to fill unless part or all of the outline is decomposed to polylines (e.g. OR gate, valve symbol).

Some proposed wording:

4.2(iii)(a) Symbols primarily comprising of rectangular outline MUST be filled with background color (excluding 'box' resistor symbol)

4.2(iii)(b) Symbols with a non-rectangular outline MAY be filled with background color

4.2(iii)(c) Discrete components (i.e. not ICs) MUST NOT be filled with background color

I think that covers all of the current and intended practice. Op-amps and traditional logic gates would fall under 4.2(iii)(b). If we wanted to remove the optional 4.2(iii)(b), we could write 4.2(iii)(a) as "Symbols representing an integrated circuit MUST be filled..."

There are quite likely some exceptions that cannot be handled with generic rules and need to be written in explicitly.

jkriege2, 2017-09-01:
I second the proposal by @bobc above!
JAN

SchrodingersGat, 2017-09-17:
KLC 2.1 becomes KLC 3.0!

I've been reading back through this as a reference, here's my suggestion for the "background fill" issue.

(Note that this is now on the KiCad website :) )

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

bobc, 2017-09-17:
I think that covers two cases that everyone agrees on, but leaves the other cases open. I still don't understand how "hidden functionality" can be objectively applied, whether the function is "obvious" or "hidden" seems to depend on the knowledge of the user.

Some border cases:
1. op-amps, these are currently filled (should not be?)
2. crystals, some have a filled body (should not)
3. 'traditional' logic gates, they have a distinctive shape so should not be?
4. 'box' style IEC logic gates, not discrete, but not really hidden functions. Which fill?
5. flip-flops, do they have hidden functionality?

I would also encourage the consistent use of "must/may" for mandatory/optional qualifiers. Other words such as "should" can be ambiguous.

SchrodingersGat, 2017-11-21:
Closing this issue as [KLC 3](http://kicad-pcb.org/libraries/klc/) is now released.

Closed 2017-11-21.

Thread 1159 (2017-04-07):

Pin type for multiple power output pins

hackscribble, 2017-04-07:
For devices with multiple power output pins that are intended to be joined together to increase current capacity, what is the preferred way of setting the pin type in the symbol to avoid ERC errors?

I've seen examples with:
- all power output pins set to `PASSIVE`
- one power output pin set to `POWER OUTPUT` and the rest to `PASSIVE`

Thanks.

PhirePhly, 2017-04-15:
I just tripped on this trying to use an 1117 voltage regulator in as SOT-223 package. How should this be resolved?
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

poeschlr, 2017-04-15:
@hackscribble i would go with option 2:
> one power output pin set to POWER OUTPUT and the rest to PASSIVE

I would specify it as:
If a component has multiple power output pins, these pins are stacked and only one pin is set as visible with electrical type power output. All other pins are invisible and electrical type passive.

But i found a problem with that. If you put two pins on top of each other, the symbol editor gives them the same electrical type. (At least if you change anything in one of the stacked pins. A workaround would be to make the pins non stacked, and move them in place as the last step.)

hackscribble, 2017-04-15:
Thanks @poeschlr

Closed 2017-04-15.

Thread 1211 (2017-05-01):

many files have a CRLF DOS line ending

jonasstein, 2017-05-01:
a quick
find kicad-lib* -not -type d -exec file '{}' ';' | grep CRLF
on the kicad-library tree revealed that many files have a CRLF DOS line ending.

Mixing the file endings in large projects can cause trouble and most likely you want the unix line ending standard for all files.

```
$ find kicad-lib* -not -type d -exec file '{}' ';' | grep CRLF
kicad-library/modules/packages3d/Valves.3dshapes/VALVE-MINI_PENTODE_LINEAR.step: ASCII text, with CRLF line terminators
kicad-library/modules/packages3d/TO_SOT_Packages_THT.3dshapes/TO-8-3.stp: ASCII text, with CRLF line terminators
kicad-library/modules/packages3d/TO_SOT_Packages_THT.3dshapes/TO-8-2.stp: ASCII text, with CRLF line terminators
[..]
```

bobc, 2017-05-02:
Exactly what trouble? Given the fact there are lots of mixed line endings with no reported problems suggests that it is actually not a problem.
I get that some people obsess over details but the line ending "issue" is really not important. As soon as you "fix it" it will happen again, but it still won't matter.

jonasstein, 2017-05-02:
inconsistent file format can cause bugs, which consume time. Just a question of time. The gitclient is prepared to handle this automatically. https://help.github.com/articles/dealing-with-line-endings/
So it is just a misconfigured git client on a Win machine.

bobc, 2017-05-02:
> inconsistent file format can cause bugs,

Do you have proof for that statement? Programs processing text files are designed to expect different line endings and process them correctly.

I think there is no "question of time", we would have seen issues already if it was a significant problem. I fit hasn't causes a problem so far, it likely never will.

jkriege2, 2017-05-03:
This was already discussed and yes, line-ending SHOULD be UNIX on the GitHUB-Servers. I think there should be `.gitattributes`-files that give the rules for text-files. But this only works when the files are checked in (once) as Unix, then Git converts them to you local settings and converts them back when pushing.

But for now I would say we should have all the .lib and .kicad_mod-files consistent. About all the 3D models I'm not so sure ...

If you want/have time, you could make a PR to fix this problem ... (maybe start with the .lib/.dcm-files) ... and we go on discussing there.

Best,
JAN

BsAtHome, 2017-05-15:
The problem files are in the attached text file of .pretty libraries (simple clone and a git status).
[kicad_pretty_nl_crnl.txt](https://github.com/KiCad/kicad-library/files/1002259/kicad_pretty_nl_crnl.txt)

The list could be easily scripted and run through dos2unix. All files are identified by something like this:
`$ for i in *.pretty; do ( cd $i; git status | grep 'modified:' | THEDIR=$i awk '{printf("%s/%s\n", ENVIRON["THEDIR"], $(NF))}' ); done`

Run it in the directory where all the pretty repos are. You can easily modify it to run dos2unix on the identified files.

gauravjuvekar, 2017-07-09:
/me may have spammed a lot of people with pull requests just now.
Anyways, should we add this as one of the tests to Travis CI (if it isn't already)?

poeschlr, 2017-07-09:
A travis testcase might be a good idea.

bobc, 2017-07-09:
I see a good reason for not changing line endings is that it really messes up git diff!

A test like

```
""" return True if all line endings valid for current OS """
def test_line_term (filename):
    f = open (filename, 'U')
    s = f.readline()
    while s:
        s = f.readline()
    if f.newlines != os.linesep:
        return False
    return True
```

would ensure the line endings are valid for the user's current OS (or the Python environment).

SchrodingersGat, 2017-07-09:
Currently the [.gitattributes file](https://github.com/KiCad/kicad-library/blob/master/.gitattributes) is set to:

`* text = auto`

Which according to the [documentation](https://help.github.com/articles/dealing-with-line-endings/) is a "good option" (whatever that means).

From the above link it appears that this should be set instead to:

`text eol=lf` to **force unix line endings**

Would you all agree?

bobc, 2017-07-09:
Nope! That sets working files to LF on checkout, which is OK for Unix but not Windows.
I believe

> * text = auto
or
> *.kicad_mod text=auto

is correct for us.

Note that if files already in git have CRLF endings when .gitattributes is changed, those files get "stuck" with CRLF, which may explain why we ended up with some bad files in git, even though we now have text=auto set in .gitattributes. There is a procedure described in git manual for "normalizing" files and the setting [.gitattributes](https://git-scm.com/docs/gitattributes).

SchrodingersGat, 2017-07-09:
Thanks for the clarification @bobc . So after a purge of offending lines, git should take care of the rest?

poeschlr, 2017-07-09:
If nobody is using a buggy git client then yes.
I'm also not sure if the gitattribute file is supported in older git clients so we have to see what the future brings.
A travis check might help us catch future problems before they enter the lib.

poeschlr, 2017-07-09:
Other problems might exist with very old pull requests where the gitattributes file is non existent in the branch of the contributor.

SchrodingersGat, 2017-07-09:
> Other problems might exist with very old pull requests where the gitattributes file is non existent in the branch of the contributor.

Good point

gauravjuvekar, 2017-07-09:
> Other problems might exist with very old pull requests where the gitattributes file is non existent in the branch of the contributor.

Can't we just rebase / merge master before?

poeschlr, 2017-07-09:
That would need to be done by the contributor. (We librarians don't have control over the contributors branch.)
Rebasing can be quite dangerous if not done right. (Data might get lost.)
Merging is more likely to be done correctly.
(Just remember that a lot of our contributors don't come from an informatics background but from an electronics background and therefore might make their first steps with git by contributing here.)

Also the changed files section explodes if you merge the master into an old pull request. (Makes it hard to see what the contributor changed.)
For this reason i would only suggest to merge the current master into the contributors branch if there is a conflict.

gauravjuvekar, 2017-07-31:
https://github.com/KiCad/Battery_Holders.pretty/pull/13

gauravjuvekar, 2017-07-31:
Added the .gitattributes file to remaining .pretty repos. Can we close this now? @SchrodingersGat @hackscribble @poeschlr @jkriege2

SchrodingersGat, 2017-08-01:
Thanks @gauravjuvekar , happy to close.

Closed 2017-08-01.

Thread 1222 (2017-05-06):

Wrong symbol for optocoupler / standard key/value pair as solution?

jonasstein, 2017-05-06:
Most optocouplers in the library have two zigzag arrows between the light emitter and light sensor:
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

IEC 60617-2: 05-06-08 looks like
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

The KiCad library symbols do not claim to follow any standard.
Perhaps the only clean solution to get a schematic in one standard is to add a new tag:

```
standard=xkcd # symbols as painted in xkcd comics
standard=peters-symbols # symbols as my boss peter wants them
standard=IEC 60617-2 # symbols as defined in some proprietary standard
```
A standard can include various symbols for the same object like
```
diode-EU
diode-US
or
transformer-detailed
transformer-minimal
```
Thus a second tag might be handy in the long term. The user could then switch between the standards.

evanshultz, 2017-05-06:
Hi @jonasstein

KLC (https://github.com/KiCad/kicad-library/wiki/Kicad-Library-Convention) is the standard governing KiCad's symbols. While you're quite correct that there's a lot of work to do in order to refine the library and get everything in compliance, you can see that rule 4.2.iv specifies that IEC symbols are to be used unless some deviation is requested. So there is a standard, but admittedly the exact IEC doc isn't shown.

While any user can use KiCad to create symbols any way they like, integrating into the main library should be done in a consistent, unified way so the library supports KiCad users well. As noted above, improvements to the existing libraries, updated KLC standards, and limited librarian time mean the current libraries are not being met in many cases.

That being said, thanks for pointing out a place where the libraries can be improved. If you would be so kind as to create a PR with the symbol changes, they can be formally reviewed and considered for merging into the library. I may take some time to look at this more and others may also discuss here before a PR.

jonasstein, 2017-05-06:
Hi @evanshultz , thank you for the quick response. I still have to learn KiCad more and will not be able to make a PR for this soon. Perhaps it can be fixed with a script by someone who is a library expert. There are too many false optocoupler symbols for manual repair.

bobc, 2017-05-14:
I have written a script which changes most of the zigzags, I will submit a PR.

poeschlr, 2017-08-23:
I looked at the current symbols in the opto lib. None of them seem to have zig zag arrows any more. I assume this can be closed.

Closed 2017-08-23.

Thread 1225 (2017-05-08):

DB25MC mechanical holes

christakahashi, 2017-05-08:
DB25MC has mechanical holes at Y= -2.54,  They should actually be between the rows of pins and Y= -1.27,  At least this is the case for all the connectors I have (2 brands)

evanshultz, 2017-05-09:
@christakahashi Hi! Thanks for this report.

I assume the footprint you're talking about is Connectors/DB25MC:
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

And the issue you're reporting is captured here (note that the origin is the blue "+"):
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

If that's right, you're looking at a right-angle, 25-pin, male, DB-style connector.

Can you provide any datasheet links against which we can check the footprint?

Here are some I found and their dimension:
- [TE 5747238-4](http://www.te.com/commerce/DocumentDelivery/DDEController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): 1.42mm
- [Amphenol/FCI D25P33E4GV00LF](http://portal.fciconnect.com/Comergent//fci/drawing/c01-8646-0151.pdf): 1.42mm
- [Amphenol D25P13A4GL00LF](http://portal.fciconnect.com/Comergent//fci/drawing/c01-8646-0164.pdf): 1.27mm
- [HARTING 09653626812](https://b2b.harting.com/files/download/PRD/PDF_TS/0965362X81X_BL05_R31892_100078415DRW002A.pdf): 1.27mm
- [Assmann ADS25A-KG-TASB5](http://www.assmann-wsw.com/fileadmin/datasheets/ADSxxA-KG-TASB5-R.pdf): Not given but looks like 1.42mm
- [Amphenol FCE17-B25PA-450](https://www.amphenolcanada.com/ProductSearch/drawings/AC/FCE17XXXXAXX0X.pdf): 1.42mm
- [Omron XM3-L/XM2-L/XM4K/XM4L](http://www.omron.com/ecb/products/pdf/en-xm3_l_xm2_l_xm4k_xm4l.pdf): 1.42mm

So what I see is that 1.42mm is most common, but there is plenty of variation. And none of the above match the footprint in the library. Perhaps we need to have a couple footprints that cover all the parts in the field?

I'd appreciate if you can add more parts into the mix so we have a better overview of the components that KiCad users might want to put on their boards.

In the future, it's best if you can file this type of issue with the relevant footprint library. For this item, it is at https://github.com/KiCad/Connectors.pretty.

christakahashi, 2017-05-09:
Ah! sorry i got the repo wrong.  Thanks for the correct pointer.  I know where to look now.  You are correct in your assumptions; I am referring to Connectors/DB25MC:.  I have the assmann part.  The other part I have is just in a bin so I don't have part numbers.  I used calipers and rounded to 50mil to verify but I couldn't really distinguish between 1.27 and 1.42.

Looking at the datasheets it looks like the pin pitch is always 2.77 give or take 10 microns, which makes since because the D-sub connectors have specified pin spacing but the rows can be anything and vary.  I suspect a part with 2.54 spaced rows and 2.84 spaced rows will probably work in the same footprint.  I think the key commonality though is that the mechanical hole is evenly spaced between rows.

In the case of the kicad footprint the row spacing is 2.54 (which fits my Assmann part with 2.84 row spacing fine i have working PCBs with cutoff mechanical tabs)  so I think the most correct thing to do is to put the tabs at y=-1.27.

There is the question of 1 or 2 foot prints.  Given the similarity my opinion is to side with simplicity over absolute correctness and keep just one footprint with the row spacing as is, but perhaps the development community has guidelines or ideas on how to resolve that.

evanshultz, 2017-05-09:
Looking at the comments inside the [DB25MC.kicad_mod file](https://github.com/KiCad/Connectors.pretty/blob/master/DB25MC.kicad_mod), it's in French and Google tells me "Connecteur DB25 MALE couche" translates as "Connector DB25 MALE Layer".

There is also a DB25MD which has a comment that translates to "Connector DB25 MALE right".

I assume that "couche" and "droit" are the "C" and "D" in these footprint names, which needs to be corrected to English and better described by the footprint name, so thanks for incidentally pointing this out. It would only make sense that there is a part matching this footprint, but unfortunately the footprint description doesn't help us with that, so the best bet may be to create footprint(s) to support the parts identified above. If you can do some more searching online it would be helpful.

bobc, 2017-05-13:
This has been noted before https://github.com/KiCad/Connectors.pretty/issues/44. I was never able to find a part matching the DB25MC footprint.

The terminology "couche" = right-angle, and "droit" = straight (vertical) is used on several other connectors in Connectors.lib. There is also "CMS" meaning SMD in French.

SchrodingersGat, 2017-10-06:
I am closing this issue for now - any further issues with the DSUB footprints should be directed to https://github.com/kicad/connectors_dsub.pretty

jkriege2, 2017-10-18:
just a note: I'm currently working on a script-based rework of the DSUBs

Best,
JAN

evanshultz, 2017-10-18:
Great! That was on my list to do eventually. I had also marked https://github.com/KiCad/Connectors.pretty/issues/44 as something to be reviewed when these connectors were updated. Looking forward to your rework!

jkriege2, 2017-10-19:
Have a look at the results: https://github.com/pointhi/kicad-footprint-generator/pull/69

gnbl, 2017-11-09:
Nitpicking, but note it should be _D-Sub_ and not _Sub-D_: https://en.wikipedia.org/wiki/D-subminiature
It would be better to adhere to some standard in order to avoid confusion/duplicates/having to check two places.

I'm here because I can't seem to find any DB25 footprints in 4.0.6., but it seems it's outdated, so:
1. Footprint Editor
2. Footprint Libraries Manager
3. add GitHub library `${KIGITHUB}/Connectors_DSub.pretty`

Closed 2017-10-06.

Thread 1243 (2017-05-15):

extension of KLC 4.3 (pin stacks)

jkriege2, 2017-05-15:
To complement the discussion about an extension of the kicad library check scripts (https://github.com/KiCad/kicad-library-utils/pull/116) I'm proposing a change to KLC:

We were discussing how to deal with power-I/O and output pin stacks. There are several problems with these:
1. power-pins should always be visible, as invisible power-pins are reserved to power-flags (+12V, +5V, GND, ...)
2. no two output or power-output pins may be tied together as this causes an ERC violation (two outputs driving one signal).

Therefore I propose an additional rule in KLC 4.3:
> 4.3.vi stacks of output-, power-output- or power-input-pins are a special case for which the following strategy is required: One pin of the stack has the required type (power-I/O, output) and is visible. All other pins in the stack have the electircal type PASSIVE and are invisible.

The script mentioned above checks for such stacks and provides auto-fixing for violations.

Best,
JAN

PS: A PR that already conforms to this rule (but is not yet merged, i.e. may serve as an example/basis for discussions) is: https://github.com/KiCad/kicad-library/pull/948

SchrodingersGat, 2017-06-04:
Hi Jan if you look at the KLC I have just now updated to add this rule. I have also added a brief note to the FAQ page

jkriege2, 2017-06-05:
Thanks,
JAN

Closed 2017-06-05.

Thread 1259 (2017-05-25):

Licensing of symbols and footprints (and current 3d models in this repo)

poeschlr, 2017-05-25:
Currently the libraries seem to be under normal gpl library.
Should we add a symbol exception similar to what we did with the new 3d models library to these repos as well?

bobc, 2017-05-25:
The license is Lesser GPL, which already has a "linking" exception.

I don't think engineering data can be covered by copyright, and LGPL is designed for software, so "linking" may not be relevant. But as far as there is any legal application, the user is allowed to incorporate symbols from the official library into his/her design without incurring any GPL obligations.

poeschlr, 2017-09-18:
I just checked. No it seems the libs are under normal GPL not LGPL.

So the question still stands. Should we make the symbol exception clear in the lib?

SchrodingersGat, 2017-09-18:
What serendipity - this just popped up on the forums - https://forum.kicad.info/t/default-libraries-gpl-licencing-vs-proprietary-designs/140/8

We *definitely* need to come up with a clear exception for all the libraries. I would make this a required task for the KiCad v5 / KLC v3 reboot.

Additionally, I'm not sure if we need to include a statement to the effect that "users contributing to the libraries implicitly agree to license their contributions under the above agreement". Otherwise each little touch-up of a file will require attribution and that'll become very hard to manage.

poeschlr, 2017-09-18:
That's why i posted here-

I also found this discussion you had with the developers:
https://www.mail-archive.com/kicad-developers@lists.launchpad.net/msg24570.html

It basically states we should use CC-BY-SA 4.0 with some weird exception that i do not really understand.

SchrodingersGat, 2017-09-18:
Yeah I just reignited that flame again.  However I just found this much older thread - https://lists.launchpad.net/kicad-developers/msg21732.html

Here Wayne sent the gEDA license to the FSF for input. I would prefer to use that. I have emailed him to see if he ever got a response. I'm hoping to short circuit the too-many-cooks of the developers mailing list :)

poeschlr, 2017-09-18:
I think this is what @easyw also mentioned some time back on the forum https://forum.kicad.info/t/3d-new-library-for-mechanical-cad-exporting-and-enclosure-design/1763/27

And this might be the reason we have exactly this license for the 3d model lib.

poeschlr, 2017-09-18:
I found something else:
https://www.mail-archive.com/kicad-developers@lists.launchpad.net/msg16268.html

SchrodingersGat, 2017-09-18:
Good find!

bobc, 2017-09-19:
@poeschlr "I just checked. No it seems the libs are under normal GPL not LGPL.

So the question still stands. Should we make the symbol exception clear in the lib?"

Where exactly did you check? It's quite clearly LGPL here  https://github.com/KiCad/kicad-library/blob/master/COPYRIGHT.txt#L1

Personally, I think the requirements to share and attribute are impractical, and we are never going to be enforce it, a BSD/MIT license would make more sense. But I also think engineering data files are not covered by copyright anyway so the whole question is rather moot.

poeschlr, 2017-09-19:
We would leave the Library GPL in place. But add a clear statement that Projects created using the files here are not required to use the same license.

And yes i learned in the mean time that the Library GPL is a precoursor for the Lesser GPL. (It is called lesser since the 2.1 release of the lib.)

poeschlr, 2017-09-19:
An idea about license change:
We could do it similarly to what we did with the 3d models.
Make a new lib under a new license and ask new contributions to be transfered there. Old stuff needs to be transfered slowly which would mean for some time kicad would still ship the old lib under the current license but we can offer a reduced set of symbols/footprints under a better license.

I think a lot of footprints can be transfered quite fast because they are script generated. And the scripts are written by me, oliver and @pointhi. Which limits the amount of people needing to agree on a license change.

This way we would be safe from problems regarding re licensing of old stuff.

jkriege2, 2017-09-19:
I think that way we'll loose a lot of footprints, becaus in principle we would have to ask every contributor (of a single footprint) whether he's OK with changing the license ... that does not really seem viable ...

Best,
JAN

PS: Not sure how to do this properly or correctly without loosing contributions ... In general maybe we can simply ASSUME that most contributors didn't really think about licensing and just published, assuming that there is an open source license in place which "makes sense" for the typical KiCAD usecases (i.e. commercial + non-commercial) ... then we could just put the footprints under a new license without asking ... but legally that's for sure AT LEAST sketchy

poeschlr, 2017-09-21:
It looks like the footprints currently do not have any license assigned. (None of them have a license* or copyright* file) So i think we might get lucky here. Leaves only the symbols as a problematic area. (Here the lgpl normally would not permit re licensing without the consent of all contributors.)

SchrodingersGat, 2017-09-21:
See https://github.com/KiCad/kicad-library/issues/1645

Shackmeister, 2017-12-03:
@SchrodingersGat can this be closed now?

SchrodingersGat, 2017-12-03:
Yep this has now been resolved.

Closed 2017-12-03.

Thread 1287 (2017-06-05):

KLC-modifications for graphical symbols/power-symbols

jkriege2, 2017-06-05:
Dear all (and @SchrodingersGat ):

as discussed earlier, I'm proposing here some changes to KLC to allow for graphical and power-flag symbols. This PR is accompagniied by changes to the KLC-check-scripts: https://github.com/KiCad/kicad-library-utils/pull/126

## graphical symbols (no pins, hidden REF, not in BOM)
These require:
- hidden REFDES
- REFDES with leading '#'
- may have no FPFilter and footprint
- may have hidden VALUE field, which causes the symbol name to have a leading tilde '~' (this is not stated explicitly in KLC, as it is an internal "Hack" of KiCAD, but the scripts should know about this!)

## power-flag symbols (1 pin, hidden REF, not in BOM, visible value)
These require:
- hidden REFDES is always `#PWR`
- may have no FPFilter and footprint
- VALUE field is visible
- may have only one pin
- pin signal name is the same as the symbol name

## required changes:

KLC 4.9.i should be changed to:
> The Reference field contains the appropriate Reference Designator (REFDES) and is _visible_. For power-flag symbols (e.g. `+5V`, `GND`, ...), the reference designator is always `#PWR`. For graphical symbols (no pins, not part of the BOM) the REFDES is _invisible_ and arbitrary, but starts with a hash-character `#` (e.g. `#SYM` or `#LOGO`).

KLC 4.9.ii should be changed to:
> The Value field contains the name of the symbol and is _visible_. For graphical (no pins, not part of the BOM) and power-flag symbols the value field may also be _invisible_.

please add to KLC 4.11:
> 4.11.vi For power-flag and graphical symbols, no footprint filter is required and the footprint field should be empty

add KLC 4.13:
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

## PS: Some Images that may be used to illustrate the KLC:
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

Best,
JAN

SchrodingersGat, 2017-06-05:
Thanks Jan these are good changes. I have adjusted KLC accordingly.

poeschlr, 2017-06-05:
> Contain exactly one pin, which is invisible, and must be either Power Input or Power Output

Should we make it clear that only power input should be used for symbols that are intended to function as global labels? (I would even go so far to only allow invisible power input and make an exception for the power_flag. There is only one such symbol needed in the library.)

SchrodingersGat, 2017-06-05:
@poeschlr you are right, I have now corrected this.

jkriege2, 2017-06-06:
OK for me ... I adapted the scripts in my other PR to adapt to these rules.

JAN

Closed 2017-06-06.

Thread 1304 (2017-06-10):

Incorrect footprints for ATMEGA168-20AU and FT232RL

PhirePhly, 2017-06-10:
I'm working on laying out an Arduino board using a TQFP AVR, but it looks like neither component has the correct footprint assigned.

Steps to reproduce issue:
1. Create new project
2. Add FTDI library (Preferences -> Component Libraries -> Add -> /usr/share/kicad/library/ftdi.lib)
3. Place ATMEGA168-20AU (or any alias of it) & FT232RL
4. Annotate schematic
5. Tools -> Assign component footprints

KiCAD faults with the following messages instead of correctly assigning the expected footprints to these parts:
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

I believe the correct footprints for these components are:
TQFP-32_7x7mm_Pitch0.8mm
SSOP-28_5.3x10.2mm_Pitch0.65mm

poeschlr, 2017-06-10:
The ATMEGA168-20AU symbol is in the admel lib not in the ftdi lib. (At least in kicad 4.0.6 and in the current master branch.)

You are correct about the state of the symbol though. This symbol is in need of a major overhaul.
Or even worse: I think the complete atmel lib is in need of a major overhaul. (This is not the only symbol that has such a wrong footprint field.)

The footprint field is completely invalid.
  - no footprint library given. Correct syntax: "pretty_lib_name:footprint_name"
  - the footprint filter is empty as well.
  - If it is correct that this device supports more than one footprint, the footprint field should be removed and the footprint filters set accordingly.

Other problems
- The datasheet link is dead
- The vcc and gnd pins should move to top/bottom.
- maybe the pin names should be shortened (The detailed function description can be removed. The port name is enough to identify the pin.)

A good model of how such a symbol could look like are the newly fixed symbols in the nxp armcpu library.
Example of such a pull request: https://github.com/KiCad/kicad-library/pull/1288

@PhirePhly would you be prepared to fix this symbol and submit it via a pull request?
(Otherwise it might take some time till somebody will fix it.)

Closed 2017-06-11.

Thread 1328 (2017-06-21):

Footprint for PLCC4 is incorrect

CountMurphy, 2017-06-21:
The footprint for PLCC4 (a ~2mm square LED) is showing up in Kicad as a 5mm square (actual footprint 5050).  See these [pictures (imgur)](https://imgur.com/a/hpBEX) for details

jkriege2, 2017-06-21:
Hi @CountMurphy !

please have a look at the datasheet linked in that footprint: http://www.cree.com/~/media/Files/Cree/LED-Components-and-Modules/HB/Data-Sheets/CLMVBFKA.pdf ... The footprint matches the package described therein. Also this is NOT A GENERAL PLCC4 package, but one for CREE, who seem to define the package dimensions differently (that's why the manufacturer name CREE is in the footprint name!).

Maybe `LED_WS2812B-PLCC4` fits your needs better ... but also that one is manufacturer-speific (even part-specific, note the part number in the symbol name). To me it seems there is currently no general PLCC4 with the dimensions you need ... Maybe you could provide one?

Best,
JAN

CountMurphy, 2017-06-21:
I just read the data sheet and it proves my point. The datasheet says "Size (mm):2.0x 2.0 "  and "The compact 2mm x 2mm package allows for a very high resolution  screen." However the footprint itself in kicad is 5mm (this is incorrect). In fact every PLCC4 I screen captured from digikey was a cree LED, further proving the footprint should be 2mm, not 5.  To clarify I'm not looking for a 5mm PLCC4, I'm looking to actually use a real PLCC4 in my board.

jkriege2, 2017-06-21:
Oh ... mixed that up, sorry ... would you provide the correct FP?

Best,
JAN

suzizecat, 2017-06-21:
if @CountMurphy isn't working on it, i can provide it.

CountMurphy, 2017-06-21:
I can certainly try to make the correct footprint, though I wont be able to get started on it for few weeks (currently rushing to finish various hardware projects for a wedding near the 4th). If there is pressing need for it now, or if @suzizecat simply wants to work on it, I say go for it. If not, I can work on it once I get some free time again.

ppelleti, 2017-10-04:
I independently discovered and fixed this bug [a few days ago](https://github.com/KiCad/LEDs.pretty/pull/46).

SchrodingersGat, 2017-10-04:
@CountMurphy has this been fixed to your satisfaction?

CountMurphy, 2017-10-04:
@SchrodingersGat I'll take a look at it later tonight.

Shackmeister, 2017-12-03:
@countmurphy can you close this issue if the issue has been fixed?

CountMurphy, 2017-12-04:
confirmed fixed. Thanks everyone

Closed 2017-12-04.

Thread 1329 (2017-06-21):

Polarity indication silk on LED footprints trimmed by pad clearance

PhirePhly, 2017-06-21:
Looking at the LEDs:LED_0402 through LEDs:LED_1206 footprints, it appears the default KiCAD pad clearance (0.2mm?) is large enough that any indication of which side of these LEDs is the anode/cathode is lost when the board is exported, with the possible exception of LEDs:LED_0606.

Possible solutions include:
1. Changing the default global pad clearance to something less than 0.2mm
2. Changing the pad clearances on these LED footprints from "use global" to something specific which doesn't trim the silkscreen.
3. Somehow indicate which pad is the cathode with silk outside of the default pad clearance area.

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

Example board rendered using OSHpark and the default 0.2mm solder mask clearance:
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

SchrodingersGat, 2017-06-21:
@PhirePhly for the offending footprints, the silkscreen should be expanded such that it does not overlap the default soldermask clearance. Are you able to make this change?

PhirePhly, 2017-06-21:
How concerned are we about violating the courtyard? I think the mask clearance goes pretty much all the way out to the courtyard.

Do we know why the default clearance is so large? I'm used to using something like 3thou instead of the 8thou in KiCAD. Are the cheaper fabs just that bad at registration?

SchrodingersGat, 2017-06-22:
In that case you could just change the global mask clearance values for your project - that would fix this without any change to the library, correct?

PhirePhly, 2017-06-22:
Well yes, and I've certainly already done that so I could enjoy other advantages like solder mask between pads on my ICs, but if my concern was only fixing it on my projects I wouldn't have opened an issue ticket, I would have just made my own footprint.

SchrodingersGat, 2017-06-22:
> if my concern was only fixing it on my projects I wouldn't have opened an issue ticket, I would have just made my own footprint.

Appreciated!

I am not sure where the 0.2mm default was decided. It does seem very conservative.

Given that this is the default, however, the silkscreen for these should be expanded so it is at least a bit visible.

evanshultz, 2017-06-23:
@PhirePhly Would you mind updating the footprints and submitting a PR? If not, that's OK and we still appreciate you bringing this to our attention.

PhirePhly, 2017-06-28:
I'm researching the issue and industry standards to try and propose an informed solution, barring someone else jumping in and solving the immediate issue at hand here.

poeschlr, 2017-07-25:
For now we have decided to have a 0.2mm clearance between pads and silk screen. I think this should be ok for most manufacturers. If you can find some standard for this it would be great if you could give us this information.

Shackmeister, 2017-12-03:
This has been corrected in the new footprint repo

SchrodingersGat, 2017-12-03:
Thanks @Shackmeister

Closed 2017-12-03.

Thread 1355 (2017-06-26):

Footprint pad numbering

SchrodingersGat, 2017-06-26:
Many footprints require non-standard naming for certain pins, beyond 1,2,3,4,...,n.

Examples:

* Packages with thermal pads
* Connectors with shield pins
* Multi-throw switches with common terminals

Currently this is handled by adding an extra number to the pads.

e.g. A 48-pin housing with an E-PAD connection has pin `49` added.

Should we develop a standard nomenclature for these extra pads, as we can use more than just numerical identifiers for pads?

Examples:

1. E-Pad connections could be marked `EP`, `EP1`, `EP2` etc
1. Shield / GND pins could be labelled `SHLD`, `GND`, etc.
1. Common pins on switches could be labelled `C` or `COM`

This will bring a greater level of consistency to the library. However we would need to develop a scheme that is extensible.

a) Does anyone have any information on whether this level of naming is specified under IPC standards?
b) Comments? Objections?

@jkriege2 @poeschlr @pointhi  @easyw @evanshultz et al :)

SchrodingersGat, 2017-06-26:
Another key example is the `TAB` pin on many SMT devices

rivimey, 2017-07-06:
If I may comment, I would prefer that non-standard pins were obviously so; for an exposed pad it seems perfectly sensible to call it EP  and ditto for tabs, etc. The line, for me, would be for 'pins' that are more than a specialised ground/chassis... would you agree?

poeschlr, 2017-07-26:
I don't think it is a good idea to use ep as pin number for the exposed pad. A lot of datasheets use numbers. (And we currently use a number, changing it would require us to change all affected symbols and footprints in one go. We then have the added problem that a lot of people get up do date footprints via the github plugin but don't get the new symbols.)

I would only use non numerical pin numbers for specialized footprints that are used for only one symbol. (example are relays or switches) In short: non numerical pin numbers only for atomic parts.

Closed 2017-11-16.

Thread 1358 (2017-06-26):

More deprecated libraries to hide

evanshultz, 2017-06-26:
Along with https://github.com/KiCad/kicad-library/pull/1349...

I believe these can be safely hidden (removed from fp-lib-table):
https://github.com/KiCad/EuroBoard_Outline.pretty
https://github.com/KiCad/Filters_HF_Coils_NEOSID.pretty
https://github.com/KiCad/NF-Transformers_ETAL.pretty
https://github.com/KiCad/Transformers_CHK.pretty
https://github.com/KiCad/NF-Transformers_ETAL.pretty
https://github.com/KiCad/Transformers_SMPS_ThroughHole.pretty

https://github.com/KiCad/Sockets_MOLEX_KK-System.pretty has parts that appear to be the same as the KK 6410 parts at https://github.com/KiCad/Connectors_Molex.pretty. It seems that the same physical parts are covered in the KiCad library, but the deprecated library is an older footprint version. Can someone please check me on that?

https://github.com/KiCad/Oddities.pretty has a few footprints for net shorting that may be useful. Go ahead and hide this too if you want, but I'd like to submit a PR for matching schematic symbols and find a nice place for these footprints (after appropriate updating to meet KLC).

Lastly, the connectors/pin headers/terminals/etc. seem overly confusing. Perhaps there's a better way to organize all of those similar parts?

evanshultz, 2017-06-26:
@SchrodingersGat  @poeschlr @jkriege2
Forgot to alert you fine folks.

poeschlr, 2017-06-26:
I'm not sure deleting repos is a good idea.
Because of the current setup of the lib system cvpcb crashes for all users!
https://forum.kicad.info/t/cvpcb-crashes-on-deprecated-footprint-library-files/6872/2

It might be a better idea to just remove them from the fp-lib-tables and let them slowly die. (They can be removed a few releases in the future.)
I would even suggest to recreate the 3 libs that have already been deleted. (maybe only have one dummy footprint in them that is call this_lib_is_deprecated_and_will_be_deleted_soon)

evanshultz, 2017-06-26:
Uh oh. See the PR I linked above where Olivier only removed them from the fp-lib-tables. That was only my intent, to continue that work. Actually deleting the repo was not my intent, though I see my wording was confusing if one wasn't thinking about continuation from the linked PR.

poeschlr, 2017-06-26:
Yea but these 3 repos have already been deleted. (This is why i brought it up. Just wanted to make sure it will not happen again.)
I will open a second issue about that specific problem.

SchrodingersGat, 2017-06-27:
@evanshultz the `TerminalBlocks_xxx` libraries are actually new ones and shouldn't be removed

evanshultz, 2017-06-27:
Edit for clarify and removed the `TerminalBlocks_xxx` from the list.

evanshultz, 2017-06-27:
@SchrodingersGat The `TerminalBlocks_xxx` libraries have nothing in them, which was why I originally thought they should be removed. Is there a collection of footprints that are intended to go there so those libraries aren't empty?

SchrodingersGat, 2017-06-27:
@evanshultz they were created recently to reduce the library size of some of the connectors libraries. However there have been no additions yet.

evanshultz, 2017-08-24:
Only https://github.com/KiCad/EuroBoard_Outline.pretty still exists in the current fp-lib-table, and there are relatively recent commits there. (And talk of converting them into templates.)

Closed 2017-08-24.

Thread 1360 (2017-06-26):

Removal of the divers.pretty, discret.pretty and labels.pretty repo breakes kicad stable

poeschlr, 2017-06-26:
As mentioned in https://github.com/KiCad/kicad-library/issues/1358#issuecomment-311181098
it seems cvpcb gives an error message because of the missing repos. (I don't think it does crash completely but unexpirienced users might think it is broken.)

Forum entry:
https://forum.kicad.info/t/cvpcb-crashes-on-deprecated-footprint-library-files/6872

My suggestion would be to recreate these repos with one dummy footprint in them.
Can we disable forks and pull requests for specific repos?

SchrodingersGat, 2017-06-27:
Ah, that's very frustrating. Such a silly way of managing libraries. I'll recreate these for now as the path of least resistance.

Thanks for pointing this out.

SchrodingersGat, 2017-06-27:
Alright, fixed :)

tijuca, 2017-07-02:
Hi,

I was hitting by such renaming and reorder within a stable release too while working on the Debian packages of KiCad between 4.0.4 and 4.0.5. as seen in retrospective. Please don't do that within a stable release cycle as I and the users too don't expect such a behaviour within a stable release. Related to that we have a now a potentially broken 4.0.5 within the Debian Stretch release. 😞
Also some trees haven't a tagged version. By this we packaging the HEAD off the date we collect the libraries which isn't necessary the date a release is tagged or happen.

Taking care on such upstream changes takes much energy on the packaging side which cost at least a lot of time. I guess there is some more policy needed to avoid such issues. Classical libraries are expected to have a stable API between releases. I see not much difference to the footprint libraries.

Sometimes renaming is inevitable but please give it some attention in release notes in the future.

poeschlr, 2017-07-02:
Do i understand you correctly that we need to ensure that all 4.x releases stay compatible with the current lib?
Just give your users the option to update to the newest stable. Otherwise the lib comes to a standstill.

poeschlr, 2017-07-02:
To elaborate more: Yes we know a release cycle for the lib might be a good idea in future. But with the current state that footprint libs are downloaded directly from github, this is not really possible. (It doesn't help either that all footprint libs live in separate repos.)

For this reason, there will always be inconsistent libs as soon as we change anything in the footprint libs.
We can only hope that in kicad 5 this will change.

tijuca, 2017-07-02:
The problem is not really the dynamic of the libraries, it's more this it's happen "quietly" or at least not visible without a why this was done. The GitHub platform is not the best form for communicate of final information spreading. This should be done (also) on the mailing list in a collected form. KiCad is not the only project I'm involved and it's simply unfortunate to go through all the various GitHub issue trackers to collect the information. Email is for me the better medium to get all the information, simply because the information will be pushed to me and I don't have go over various websites.

I hope the fp-lib-table usability will be more flexible with KiCad 5 and later, the current solution could and should be improved. It's really annoying that I need to adjust my libraries by every new release, users don't want to fight with that within a release. KiCad is a really nice piece of software but useless without the libraries.

SchrodingersGat, 2017-07-02:
@tijuca it is very difficult at the moment as there are over 90 `.pretty` libraries. To prevent "errors" such as the one you have encountered, deprecated libraries must be retained.

This is quickly becoming untenable.

Ideally, all `.pretty` libs must be placed inside a single repository. This however goes against the concept of "live-loading" library content from GitHub. (Note: I do not know of anyone who uses KiCad in even a semi-professional capacity who uses live GitHub library data. IMO it's actually a drawback to the KiCad software to have such a feature).

In any case, this is the situation until we can convince the devs to drop this feature or work out a compromise.

pointhi, 2017-07-02:
I think kicad should go away from the "live-loading" principle as done yet. It slows down KiCad (and requires internet connection all the time).

My Idea would be to stitch the Github wizard, and replace it with native git support (means libraries are only updated via git, and stored on the harddrive with full history. Instead of fetching it every time from github when someone needs a footprint).
The same with the schematic library. @SchrodingersGat, I think you agree, splitting the schematic symbols into repos as done for the footprints is not an option. As you suggested, working towards merging all .pretty repos into one big repo, as done for 3d-models would be the prefered way. But that needs support of such a library structure inside KiCad first.

I proposed some idea going in that direction a few days ago: https://forum.kicad.info/t/idea-to-allow-nested-footprint-modules/6912

> In any case, this is the situation until we can convince the devs to drop this feature or work out a compromise.

I think, instead of working on compromises on the current system, we should develop in cooperation of the community, library maintainers and devs a new library system. With the new schematic symbol format there would be already some overhaul of the library management system. Such work could be placed into the Kicad 6 Road Map as well.

SchrodingersGat, 2017-07-02:
> My Idea would be to stitch the Github wizard, and replace it with native git support (means libraries are only updated via git, and stored on the harddrive with full history. Instead of fetching it every time from github when someone needs a footprint).

I have played around with this concept for a while, and sketched out some ideas of how it might work. In the end, I think that it adds a lot of unnecessary complication. If users want to have up-to-date libraries linked from GitHub, there's already a tool for that: git

If users want to use some other revision control tool, they can use that too. Including native git functionality seems to me to be a waste of (limited) dev resources. Would you agree?

I think that there should be "versioned" downloads of the libs (symbol lib, footprint lib, 3d lib) available on the [website](www.kicad-pcb.org/downloads), along with clear instructions on how to access the up-to-date libraries using git.

jkriege2, 2017-07-02:
Hi!

from the POV of a user, I would like to have something along these lines:
1. When I install, KiCAD comes with a current (or current at the time the version was built) set of symbols/footprints/3D models
2. When I work with KiCAD there should be no Internet connection required (also: yes it's very slow at the moment, when GIT is accessed every time) ... also think of a stick install, when going on travel ;-)
3. I would wish for a button somewhere in the menus, where I can say: Please update my libs. Ideally I then get a list with all changes, or at least which libs have changed and can possibly select only a subset (by default I think all changes should be accepted, so clicking OK will start the update process).

This way, installing KiCAD, I can start to work and later on I can also add new repos. Ideally it would also be possible to add other repos for libs (e.g. my private GIT repo) and the same download functionality is given. This way one can alsomanage ones lies somewhere (e.g. a local GIT repo that can be in any branch at any time) and I can get a current trunk-version from that at any time (into a second location). As an alternative it should be possible to add repos by path only, explicitly without the update option.

To implement such a system, one would need some type of downloader. I think there are several options there:
1. simply download a ZIP from Github, but this means that we have to change the software whenever Github decides to change its API, or even have real trouble, if Github should vanish at some point in the future.
2. The IMHO better option is to distribute a basic GIT with KiCAD (or require the user to provide a path to GIT, the Windows installer could e.g. then at the end point to a suitable installer for GIT). This way one could pull or export from ANY git repo (maybe the GIT could be encapsuled as plugin with a basic API, so other people could provide plugins for other version management systems). If the repos are then kept as full GIT-repos, the drawback is additional memory for the history, but the user can easily use them as repo also outside KiCAD, also deleted footpritns/symbols would not remain visible in the lib, as it is at the moment with KiCAD. If they are kept as export (i.e. without history), this saves memory, but makes update a bit harder, as one will have to pull the full repo and then delete the old and replace it with the new contents (to ensure old files do not exist any longer. This may also have another drawback, as possibly user-files are deleted, if the user puts them into the KiCAD main repos (which he shouldn't but I fear many will do).

What do you think? Did you thoughts go along a comparable line of thought?

Best,
JAN

poeschlr, 2017-07-02:
I agree with oliver here. The idea of easily downloadable "versioned" libs is compelling. Github allows for such [releases](https://help.github.com/articles/creating-releases/).

To get something like this we only need to get the developers on board to enable merging of all footprint libs into one repo.
We also would need support from the documentation team and the webside maintainers. (This does not mean they need to do all the work, but they have experience that could help with this effort.)

I think the lib should also have its own release cycle. that does not necessarily need to be tied to the software cycle. (Example: a new release after a major update like the recent updates to the 3d lib.)

Somehow the lib version should maybe also be stored in a project. So that if you share your work, other users can easily find out with which lib version it has been created.

jkriege2, 2017-07-02:
Hi @poeschlr !
I'm not so sure about the lib releases ... usually people will submit something to the libs and expect it to be available in KiCAD, as soon as the contribution is accepted, right? With a release-cycle, that would mean waiting for the next release .... also the parts are usually usable even as a single file, so no need to ensure a certain state of the full lib.

A way to overcome this would be: There are releases and and a hidden file on the GitHUB-Repo (or the KiCAD-website) lists all versions. then KiCAD could provide a method to download such a release (or parts thereof, as I think the full lib will be quite large and user might want to update only part of it to save download capacity). If then a user wants cutting edge, he COULD download by himself ...

But then we are back to handy-work if you want to have current libs ... which I think would be a big drawback.

Best,
JAN

pointhi, 2017-07-02:
@jkriege2, my idea about git integration would be by adding standalone git support into kicad: https://libgit2.github.com

github releases then can be managed using git tags (which would also work with private repositories). Users can also specifiy which release (or commit version) they want to use for their project, and therfore can work with a specfic version of the library on a project which does not change as long as there is no need for it.

SchrodingersGat, 2017-07-02:
+1 to libgit2, this is what I have been looking into.

The *best* way to tackle this would be to extend the current concept of a "library", enabling it to be tracked and updated. Legacy libraries obviously could not implement this.

However, there is still a problem that I haven't yet been able to work around:

Footprint libs (`.pretty`) are added individually to the lib-table file. However we want to merge all `.pretty` libs into a single GitHub repository. How does the user specify that they want to use only a single library from a github repository? Splitting the libraries into separate repos helps here, but that's obviously very messy.

Any thoughts? It seems like a tough problem to solve.

SchrodingersGat, 2017-07-02:
> simply download a ZIP from Github, but this means that we have to change the software whenever Github decides to change its API

It's already a problem - GitHub have changed their API such that the 3Dshapes downloader doesn't work for directories with more than ~500 files.

pointhi, 2017-07-02:
> How does the user specify that they want to use only a single library from a github repository?

Well, I could think about different solutions. But one thing is the same: the user is forced to clone the complete repo even he only needs one directory. That shouldn't be much of a problem, because footprints require way less memory than 3d-models.

* Support github url's with sub-directories (like ```git@github.com:KiCad/kicad-footprints.git:Capacitors_SMD.pretty```)
  **There is probably no standard for such url's, and it could be going to be messy**
* distinguish between the repository and it's included libraries (and allowing to enable/disable libraries inside that repo)
  **I think the better way to handle libraries. Also for distribution**

jkriege2, 2017-07-02:
@SchrodingersGat ... hhmmm ... I only see two options:
1. We keep separate repos + one repo that only contains the lib-tables ... but the we still have to manage all those separate repos. Having GIT-submodules in that major-repo will also not really help, as they are by default not meant to be edited INSIDE that major repo. The docu says you can change them so they can be edited from within the source-tree, but I doubt there is simple support in Github, so we might loose all non-GIT-experts from contributing ... and make it very hard for the rest ;-) Submodules are more meant to import a special tag/version of another lib into the own source-tree and have easy update of them... as far as I interpret them from a practical POV.
2. We put everything into a single repo and then somehow indicate that this repo has a split-structure (e.g. by a config-file on the repo-root), e.g.:
   ROOT
     |
     +-- SYMBOLS
     |       +-- SymbolLib1.sweet
     |              +-- SUBDIR1
     |                     +-- SymbolFile1
     |                     +-- SymbolFile2
     |              +-- SUBDIR2
     |                     +-- SymbolFile1
     |                     +-- SymbolFile2
     |              +-- SymbolFile1
     |              +-- SymbolFile2
     |       +-- SymbolLib2.sweet
     |              +-- ...
     |       +-- SymbolLib3.sweet
     |              +-- ...
     |
     +-- FOOTPRINTS
     |       +-- FootprintLib1.pretty
     |              +-- SUBDIR1
     |                     +-- FootprintFile1
     |                     +-- FootprintFile2
     |              +-- SUBDIR2
     |                     +-- FootprintFile1
     |                     +-- FootprintFile2
     |              +-- FootprintFile1
     |              +-- FootprintFile2
     |       +-- FootprintLib2.pretty
     |              +-- ...
     |
     +-- 3DSYMBOLS
     |       +-- ...
     |              +-- ...

Then a download COULD try and download only some subdirs ... This seems to be called "sparse checkout" in GIT (see https://git-scm.com/docs/git-read-tree#_sparse_checkout and https://lakehanne.github.io/git-sparse-checkout ), i.e. in GIT>1.7.0 there is support for a strategy like that, which could be used by the downloader in GIT ... but is this feature supported in libgit2 (I think no: https://github.com/libgit2/libgit2/issues/2263)? So this leaves us to haveing a downloader that does use libgit maybe only to get a directory listing and then downloads by itself ... not good, but might be a solution?
3. We leave repo-structure as it is now and somehow try work with it, which is also not really a good way, especially when that would mean to have separate repos also for 3D symbols and later symbol-libs ... (repo hell ;-)

Best,
JAN

jkriege2, 2017-07-02:
Some more URLs of interest:
- https://www.atlassian.com/blog/git/handle-big-repositories-git
-

poeschlr, 2017-07-02:
@jkriege2 wrote:
> I'm not so sure about the lib releases ... usually people will submit something to the libs and expect it to be available in KiCAD, as soon as the contribution is accepted, right?

This is currently only true for footprints. For everything else the user needs to wait for the next release or download the lib by hand.
I'm not against giving the users this option. But users should have the option for a version based release. (Or at least control over when their "local" libs update.) And i think for the vast majority of users, a version based release of the libs might be the better option.

SchrodingersGat, 2017-07-03:
> And i think for the vast majority of users, a version based release of the libs might be the better option.

I would imagine that it is also what most users expect. Newbie KiCad users only use the GitHub repo because it is what is presented to them by default. AFAIK other major EDA packages distribute library "blobs" (I suppose that's all they can do as they don't support user contribution).

suzizecat, 2017-07-04:
IMHO, the best way would be to have, as @SchrodingersGat said, have a repo per library kind. Then KiCAD should be able to download these libs and work with it.

The must would be to be able to choose between downloading a local version of theses libs then have a sweet button that will re-sync local version with the repos ones or always work with updated ones as for PCBNEW.

In example, right now, you have to clone the repo, have a git client and reconfigure KiCAD properly to have that in eeschema while you can have changes without notice in your footprint set in PCBNEW... Neither of these solution seems right to me...

bobc, 2017-07-05:
> Note that all these are file format differences and really it doesn't matter how they GET to your computer. (local storage, networked, USB drive, etc, etc).

Then, the GitHub library "format" is present as being equivalent to these, but it's not. It's a retrieval mechanism, one which handicaps the usefulness of the current library scheme.

I think that is a key point. The current github plugin has blurred the distinction, and tied us in to one particular implementation. Implementing over the Github API (instead of git api) was a bad idea, IMO. Perhaps at the time, the github plugin was seen as a "quick and simple" way to achieve a goal.

Unfortunately, that has led us down a blind alley, with no real good options for a simple improvement path. I think we have to take a step and look at all the things we would like to achieve, and the best way to do it, rather than further hacking what we have got.

Personally, I would like to see a more flexible approach to externals tools in KiCad. KiCad does not need to know how to download libraries, this could be handled by an external tool (e.g. python script). All KiCad needs to know is there is an external command to call, and after calling it, files on disk may have changed, so the internal caches need to be refreshed.

The framework of pre-actions / call hook / post-actions could be generally useful in other parts of KiCad, for better integration with third-party tools (there is quite an active and growing set of Python tools).

suzizecat, 2017-07-05:
> Personally, I would like to see a more flexible approach to externals tools in KiCad. KiCad does not need to know how to download libraries, this could be handled by an external tool (e.g. python script). All KiCad needs to know is there is an external command to call, and after calling it, files on disk may have changed, so the internal caches need to be refreshed.

Well, if you gonna use an external script to update the libs, it should simple enough to add this script into the main KiCAD distrib and add a button to call it.

I think that third party tools like python scripts are great and should be integrated into KiCAD, but for such "basic" function (perform an update of official libs),  there should be a (newbie-)user-friendly way to do it without hacking into KiCAD.

Don't forgot that KiCAD is an EDA Tool designed for electrical purpose, and shouldn't need any Python skills to run smoothly

bobc, 2017-07-05:
> I think that third party tools like python scripts are great and should be integrated into KiCAD, but for such "basic" function (perform an update of official libs), there should be a (newbie-)user-friendly way to do it without hacking into KiCAD.

Of course, I agree with that. But such a framework doesn't stop pre-configured scripts being bundled with KiCad. Indeed, there _already are_ python scripts pre-configured in KiCad, maybe you are not aware of them?

Don't get too hung up on external/third party/builtin, these are implementation details. I'm not suggesting for a second that users need to become Python authors. The point is that if there is an extensible framework, it can be used by offical devs or interested third-parties, and can be implemented much quicker than the current 2 year dev cycle.

In all cases, a smooth and seamless operation should be presented to the user. The "paddling under the water" can, and should, be hidden.

SchrodingersGat, 2017-07-05:
> ETA: Arduino were in a similar situation to KiCad, and they have implemented a neat framework for managing third-party components (cores, libraries, boards). A JSON file in a repo describes the contents. Arduino IDE only needs the link to the JSON file to handle installs, uninstalls and versioned updates. I think it would be a useful model for KiCad.

Can you provide some more info on this @bobc ?

tijuca, 2017-07-05:
I would appreciate if KiCad would first think about a policy for library releases and lifetime handling for those offline data with the release cycle of a KiCad version. That's in the end this bug report is about, or I'm wrong? There was written a lot of various things for handling dynamically downloading bleeding edge stuff from GitHub or elsewhere. This doesn't really helps the distributions and first time users at all. I'm sure that really experienced user know how to add some extra library to KiCad. Try to think like a typical user which will be happy with the libraries which are mostly already provided. Think about updates and fixes for the existing libraries and long waiting pull request for this. I'm quite demotivated by this situation.
It's like for all free and open projects, don't let patches and pull request wait to long. Talk to submitters so they feel integrated into the project.

What about one main git tree which includes all the approved stuff for the next release like done in the linux kernel? Some kind of submaintainers for various kind of library types are responsible for their libraries and the pull requests into the main release tree. Instead of tagging over 90 trees for a release it would only be needed in one repository. You could even pull daily zip archives of this tree for online updates.

Also keep in mind that not all users have directly and free access to the internet, they are depending on data provided by setups, no matter which OS they use.

I'm quite sure that it is not that difficult to handle some KICAD_FOO variable for pointing to the root directory of libraries. Also the download of data from the internet is not a real technical problem I think. But please first think about how handle the release of libraries together with KiCad releases. Thanks!

SchrodingersGat, 2017-07-05:
@tijuca thanks for the feedback:

Currently the libraries are released in parallel with the KiCad software. For example, [here](https://github.com/kicad/kicad-library/releases) are the releases for the symbol libraries. These get packaged into official software releases. If you want "stable" library data, download one of those release packs - they won't change.

If users wish to have the up-to-the-minute libraries, then they also have to accept that there is a risk that their symbols and footprint data will change. There is no getting around that.

However, a lot of users (especially new users) don't realize this disconnect. The forums are full of comments indicating that they think that the GitHub libs are the "only way" to access library content. I have tried using the GitHub integration once, just to see how bad it could be. Very bad, was the answer.

Personally I track the github libraries and manage them externally with available git tools. This way I can pick and choose when I update the libraries, and can also have my own library parts in there too.

tijuca, 2017-07-06:
@SchrodingersGat

> Currently the libraries are released in parallel with the KiCad software. For example, here are the releases for the symbol libraries. These get packaged into official software releases. If you want "stable" library data, download one of those release packs - they won't change.

This is no question, my point about stable release policy is simply about allowed name changes and transitions for existing libraries. Between KiCad 4.0.4 and 4.0.5 the following libraries got reordered, mostly renamed (maybe I haven't found all of them).
```
    Buttons_Switches_ThroughHole.pretty -> Buttons_Switches_THT.pretty
    Capacitors_ThroughHole.pretty       -> Capacitors_THT.pretty
    Connect.pretty                      -> Connectors.pretty
    Diodes_ThroughHole.pretty           -> Diodes_THT.pretty
    Display.pretty                      -> Displays.pretty
    Relays_ThroughHole.pretty           -> Relays_THT.pretty
    Resistors_ThroughHole.pretty        -> Resistors_THT.pretty
    Sockets_BNC.pretty                  -> Connectors_TE-Connectivity.pretty
    Sockets_Mini-Universal.pretty       -> Connectors_Mini-Universal.pretty
    Sockets_WAGO734.pretty              -> Connectors_WAGO.pretty
    Terminal_Blocks.pretty              -> Connectors_Terminal_Blocks.pretty
```
KiCad 4.0.5 got new libraries.

```
    Enclosures.pretty
    Housings_BGA.pretty
    Housings_LCC.pretty
    Housings_LGA.pretty
    Housings_PGA.pretty
    Inductors_SMD.pretty
    Inductors_THT.pretty
    Modules.pretty
    Transformers_SMD.pretty
    Transformers_THT.pretty
```
The latter is no real problem and I'm fully o.k. with that. But the former can be a problem if distribution don't know about such changes. Like said for classical libraries they never should break the API within a release cycle I see this need also for a KiCad version cycle.
I'm only a bit disappointed that all these changes are not really communicated on the KiCad website nor on the mailing list, I haven't found some usable information on kicad-lib-commiters. So it was a long puzzling for me to get the correct fixes into the packaging. Thanks to the possibility for real symlinks on Linux systems we have solved the moved libraries by symlinking the old name to the new name. But this is only a workaround. What if a new library with the old name will be created? The fp-lib-table file of the user are still using the old names and it's no real solution to say to the user "Hey, you need to delete that file and do the whole setup again!".

So what to do?
I suggest to think twice about renaming libraries! As written, we can mor e or less easily "fix" this by doing some symlinking but as a user I don't expect that libraries are renamed within a release cycle. I haven't seen anything similar in proprietary and professional software releases.

Adding new libraries is no problem, so for existing libraries it's better to copy them into the new library and mark the old library as deprecated and no longer maintained. Maybe a flag that KiCad can use to display the deprecated warning can integrated in the library that are affected. So users will be warned and they should use the new library instead. But they don't need to do a setup from scratch again.

Talk (not only) to the distributions and announce such changes on the mailing list, that's what ML are made for and typically used. Don't expect that packagers are following every new entry in the issue tracker, they are normally "only" packaging the stuff.
Also use the possibility to add a announcement about the changes in the libraries on the KiCad website. Distribution happily take a URL to guide users to the upstream information.

To make a clear statement, I really respect and appreciate the work you library developers are doing and I don't want to blame you. I just want to point out the problems distributions may have to package KiCad libraries.

Thank you!

SchrodingersGat, 2017-07-07:
@tijuca I can appreciate the problem.

If all footprints were in a single repository then this would not be an issue, I feel.

SchrodingersGat, 2017-11-21:
Marking this as solved, we are well on the way to the new footprints repository with integrated fp-lib-table file.

Closed 2017-11-21.

Thread 1362 (2017-06-27):

missing USB3-MicroB connector.

davygrvy, 2017-06-27:
The Micro-B has a different pinout with pin 4 being the OTG line.

davygrvy, 2017-06-27:
[usb3_microb.zip](https://github.com/KiCad/kicad-library/files/1106643/usb3_microb.zip)

evanshultz, 2017-06-27:
Hi @davygrvy!

I believe the libraries to have this covered. See the USB* symbols at https://github.com/KiCad/kicad-library/blob/master/library/conn.lib.

Unfortunately, symbol libraries aren't immediately updated (the footprint libraries are) and you need to wait for a new release of KiCad. Or you can individually update your symbol libraries.

Please take a look to see if the symbol you want is included in the latest library already.

davygrvy, 2017-06-27:
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

It's missing, sorry.  Thanks for the link

evanshultz, 2017-06-27:
Alright. Since it seems you've already whipped up a symbol, please fork the library and submit your symbol with a pull request. Then the librarians can review the symbol and, once ready, add to the KiCad library. Thanks again for bringing this up and helping to improve KiCad!

davygrvy, 2017-06-29:
My git chops are icky.  The connector graphic should be changed to represent the microB connector from the type B it currently is and I can't seem to get the library editor to do what I want for that.  Also, a 3.0 Micro AB is missing, too.  If someone could fix these, that'd be great.

davygrvy, 2017-06-29:
Both of these are missing 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

poeschlr, 2017-06-30:
If symbols are missing, create them and if you want create a pull request to share them with other users. (Be the change you want to see.)

>  The connector graphic should be changed to represent the microB connector from the type B it currently is and I can't seem to get the library editor to do what I want for that.

What do you mean by that? maybe provide screenshots to show what you want to do. (And what part of it does not work.)

suzizecat, 2017-06-30:
@davygrvy you will find out how to contribute with some explanations here : https://opensource.guide/how-to-contribute/

poeschlr, 2018-01-20:
As this is about not yet contributed stuff and we already transferred the lib over to the v5 repo https://github.com/KiCad/kicad-symbols/, i will close this. If anybody involved in this discussion feels this needs to be reopened, feel free to reopen it on the v5 repo

Closed 2018-01-20.

Thread 1364 (2017-06-29):

Socket strips and pin_header first pin in 2x version are inconsistent

suzizecat, 2017-06-29:
Hi,

I found out that the first pin of all `Socket_Strips` are made to have pin 1 in the top left corner when the footprint is horizontal when all `Pin_Headers` got it when the footprint is vertical.

So, as it's displayed, the `Socket_Strips` aren't KLC compliants but there is a problem for the user when you need a male header horizontally : The pin 1 isn't at the right corner (and vice-versa for a vertical female header)

But, since there is a ton of these connector, i don't want to fix that in a PR 😅  (and that's useful to have a component with pin 1 in top-left corner horizontally)

Shackmeister, 2017-06-29:
All of these are scripted and Im currently overhauling the male part https://github.com/KiCad/Pin_Headers.pretty/pull/24 and might have a look at these afterwards :) but since they are scripted you should never change them manually, would be a waste of time :)

jkriege2, 2017-06-29:
They are oriented this way so you can easily place pairs ... but as said: I scripted them, so a rotation could easily be fixed. Note thet the double-row-headers are made, so the pin-numbers match those of the male connectors, when connected to one of theose with pin1-pin1-match!

JAN

suzizecat, 2017-06-29:
I thought about the fact that is may be scripted, i wouldn't do it myself 😅
@jkriege2  Oh ! So that's why it's inverted that's a nice feature !

Closed 2017-07-04.

Thread 1378 (2017-07-03):

Repository for PCB antennas

aliteke79, 2017-07-03:
Hi guys, i have a PCB antenna footprint to share. Can you tell me the right repository name to contribute?

SchrodingersGat, 2017-07-03:
Hi @aliteke79 we currently have the [RF Modules](https://github.com/KiCad/RF_Modules.pretty) repository which is for RF front-end modules. However this is probably not appropriate for antennae.

Do you have a link to the particular datasheet for the antenna? This might influence our decision.

Perhaps a new repository named `RF_Antenna.pretty` would be acceptable? @jkriege2 @poeschlr any thoughts on this?

jkriege2, 2017-07-03:
I would vote for such a repo ...
JAN

pointhi, 2017-07-03:
I would also vote for such a repo.

Any thoughts about printed pcb-antennas, which would only consist of some copper? Would supporting such footprints in the library make sense? (they are to some extend dependent on pcb properties)

aliteke79, 2017-07-03:
yes, http://www.ti.com/lit/an/swra117d/swra117d.pdf

aliteke79, 2017-07-03:
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

suzizecat, 2017-07-03:
@pointhi Since it could be quite painful to make, i'll vote to support them as a standard footprint.
BTW i already have an antenna into RF_Modules but i vote for an antennae specific repo

SchrodingersGat, 2017-07-03:
Such items can be considered footprints, I'd support adding them.

SchrodingersGat, 2017-07-03:
https://github.com/KiCad/RF_Antenna.pretty

SchrodingersGat, 2017-07-03:
PR for lib-table entries here - https://github.com/KiCad/kicad-library/pull/1379

hackscribble, 2017-07-03:
Most (all?) of the other footprint repos have plural names (e.g. `Housings_xxx`, `Connectors_xxx`).  Maybe this new one should be `RF_Antennas` for consistency?

aliteke79, 2017-07-03:
Thank you all, i'm going to fork and add it

SchrodingersGat, 2017-07-03:
Thanks for raising the issue @aliteke79

Closed 2017-07-03.

Thread 1397 (2017-07-07):

How to make a "multi-part" footprint ?

suzizecat, 2017-07-07:
Hi all !

I need to make the footprint for a LoRA PCB antenna. I found the  [http://www.taoglas.com/wp-content/uploads/2016/07/ILA.09.pdf](Taoglass ILA.09 (datasheet)) but i run into a difficulty...

At the end, the antenna should be linked with two wires : one to the ground, the other to the transceiver.
The problem is that these two wires should link to the same pad, which isn't possible on KiCAD

Since the component seems to be polarized, should i make a "sneaky pad" with two different pads which would be side by side ? I'm pretty sure the DRC system won't like that at all...

Plus, there is some others components which positions looks pretty well-defined within the keepout area. Should i include pads for these components or left to the user the responsibility to add them later ? The problem is that i don't think its possible to make a copper wire properly within a footprint...

Thanks for your help !
Julien

SchrodingersGat, 2017-07-07:
I'm not quite sure what you mean, but can you draw directly onto the copper layer instead of making a pad?

To achieve this, you will have to:

1. Draw the shape on a different layer (e.g. F.SilkS)
1. Edit the file manually and change the layer of the drawing to F.Cu
1. Don't edit that shape again in the KiCad editor
1. Attach the two actual pads at the end of this "wire"

If you do it this way, I **think** that the DRC won't freak out. (But you will have to test this)

suzizecat, 2017-07-08:
Wow ! That's quite a trick 😅 I'll try that sunday or during the week

evanshultz, 2017-08-24:
@suzizecat Can this case be closed?

suzizecat, 2017-08-25:
It worked fine, thanks

Closed 2017-08-25.

Thread 1398 (2017-07-08):

RFC - Symbol Naming Guidelines

SchrodingersGat, 2017-07-08:
This issue follows on from https://github.com/KiCad/kicad-library/issues/1386

Some references:

* https://github.com/KiCad/kicad-library/pull/1081
* https://github.com/KiCad/kicad-library/issues/1082

SchrodingersGat, 2017-07-08:
> @evanshultz -  I proposed and pushed for the generic scheme that Jan is professing above for the same reasons. It has the fewest number of symbols and gives the greatest flexibility in matching a given symbol with a footprint.

Maybe I'm being dumb but I still fail to see how using the `MPN_SOIC` / `MPN_SOT-23` nomenclature actually reduces the number of symbols. The other option is using the full MPN e.g. `MPN-xxyy` to designate symbols, and you have to draw the same number of symbols anyway.

I think we are talking about different things. When I say `symbols` I am talking about the actual graphical drawings - which may have dozens of associated aliases.

SchrodingersGat, 2017-07-08:
> @evanshultz - Is there a desire by Wayne or someone else to make the KiCad library atomic? If there's a future plan then it might be good to get ready now. The references above don't talk about that and I did hear Wayne mentioning at FOSDEM that there could be plugins for Digi-Key or other vendors in the future. In that case, the KiCad library would only need to be (but wouldn't have to be) generic parts.

AFAIK there is no such push from above to have atomic libs. There is a push from all of us to have libs that are at least consistent and have a solid policy behind them.

To me, a fully atomic library part would have exact order codes, temperature rating, etc. This would quickly bloat the libraries.

Perhaps with the new library format we could support this using "VARIANT" functionality. i.e. we have a part say MCP2551_SOIC that has underneath it all the possible variants.

If we look at the basic requirements for a fully-defined library part, we need the following:

1. A schematic drawing for the part
1. A PCB footprint for the part
1. The pinout must match the footprint exactly
1. The symbol name must indicate the footprint type in some fashion, if options exist

There are some symbols that do not need to indicate the footprint style as there is only a single option. The [ADM3053](https://www.digikey.com/products/en/isolators/digital-isolators/901?k=ADM3053) only has one compatible footprint. This could be added to the library simply as **ADM3053**

Conversely, a symbol such as the [MAX232](https://www.digikey.com/products/en/integrated-circuits-ics/interface-drivers-receivers-transceivers/710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) is available in different footprints (and different manufacturers!) This presents a more tricky case.

It doesn't matter if a part is offered by different manufacturers _**if the pinout is the same**_. If we go with using standard package suffix, we could e.g. have

* MAX232_DIP
* MAX232_SOIC

However if the pinouts vary between manufacturers, you could prefix the manufacturer name:

* Texas_MAX232_DIP

I do agree (mostly) that such a format allows for greater generalisation and means that the library policy is _**much**_ easier to write and police.

e.g.

```
Each device must have a unique symbol for each possible package, where the package name is appended to the generic MPN
```

However, as @evanshultz notes:

> Where is broke down for me (unfortunately, I was happy until then) were when I was fixing up linear.lib and got to parts like MCP6566 where the same package can have different pinouts.

In the case of the [MCP6566](http://ww1.microchip.com/downloads/en/DeviceDoc/DS20002143E.pdf) (and there are many cases like this).

I would suggest:

* MCP6566 - with no default FP, filters for SOT-23-5 and SC-70-5
* MCP6566R - with SOT-23-5 footprint associated
* MCP6566U - with SOT-23-5 footprint associated

1. The R/U variants only have one package option. Job done.
1. The MCP6566 has two package options. We could use filters here to allow both as they are pin compatible

(This is specific to this particular case. In cases where there is ambiguity there would need to be some discussion by the librarians - that's why we're here!).

For devices that have truly incompatible footprints, then you would have to add the footprint suffix.

e.g.

* LTC2850_DFN
* LTC2850_MS8

I am coming around to the idea of having a standardized footprint name and then letting the user select the exact MPN when it comes to BOM selection.

What do ya'll think of this summary?

SchrodingersGat, 2017-07-08:
Looks like everyone is asleep - my turn again!

I much prefer to organise the libraries by function first (much as it is done currently). I think there should be more granularity in the libraries e.g. `adc-dac.lib` becomes `adc.lib` and `dac.lib`

We should map out a set of library files that we want, based on the current set which is mostly good.

When libs become too large, or start to specialize too much, we should break them off into (e.g.) manufacturer subsets.

e.g.
* `display.lib` <- general display symbols
* `display_7seg.lib` <- 7-segment displays

e.g.
* `linear-reg.lib` <- linear dc-dc regulators
* `linear-reg_Texas.lib` <- Texas Instruments linear regulators

i.e. function takes preference over manufacturer.

As part of this, the contents of each type of library needs to be identified. Currently there is no way of doing this natively in KiCad. I would like to see a description next to each library. That's one for the developers, I think.

TL;DR - libraries should be sorted by function

*Note: Currently we have a lot of libs such as `Microchip_pic18mcu.lib` - I would argue that this too is an example of sorting by function!*

SchrodingersGat, 2017-07-08:
### Variant Naming

It pays to consider a specific case when thinking about how footprint variants are handled. Let's look at the [LTC3621](http://cds.linear.com/docs/en/datasheet/3621fc.pdf).

This is a DC-DC switching converter with:

**Two package types**
* DCB (DFN)
* MS8 (MSOP)

**Three output voltages**
* 3.3V
* 5.0V
* Adjustable

**Two switching frequencies**
* 1.00MHz
* 2.25MHz

**Two temperature ranges**
* -40 to +125 (Automotive)
* -40 to +150 (Extended)

That's a lot of combinations. I don't think there exists a set of math equations to even solve for that.

If a user wanted to go ahead and add an alias for each of those options, that would be a great benefit to the libraries. But, I don't think that every contributor would want to do that. And, where do we draw the line?

Bare minimum, there needs to be two symbols in the library for the **LTC3621** part, one each for the **MSOP** and **DFN** versions.

We could either name them according to the manufacturer naming:

* LTC3621_DCB (DFN)
* LTC3621_MS8E (MSOP-8)

**Advantages**
1. Matches datasheet
1. Manufacturers often have unique packages anyway, and their naming does not match standard naming convention

Or

* LTC3621_DFN
* LTC3621_MSOP

**Advantages**
1. Consistency between manufacturers

Either choice requires the same number of library symbols.

I think it is easier to enforce that each symbol only gets a unique symbol for each footprint, not for the other options (e.g. frequency / temp / etc). There are millions of combinations and either we draw the line in the sand here, or we argue about it on each submitted PR.

SchrodingersGat, 2017-07-08:
If we want to make a concerted effort to improve the maintainability and documentation for the libraries, we could make a [kicad.github.io](https://pages.github.com/) page.

Why?

1. More flexible than the Wiki pages
1. Hosted from our github account
1. Presents a much more professional landing page for the libraries. Having a webpage would make them seem more legitimate, I feel.

### Versioned Library Releases

Each [library release](https://github.com/KiCad/kicad-library/releases) could be added to a "Downloads" page - for improved user visibility.

This means that users can download a snapshot of the libs at a stable release point.

### Library Browsing

We could (with the help of scripting) host a directory-tree-view of the available libraries. Github page are statically generated but we could rebuild them each time a PR is merged into the symbols or footprint libraries. Then we could generate example images of each footprint / symbol and present them as an overall snapshot of what is in the libraries at any time.

### Documentation

We need a lot more documentation on the following:

* What's in the libraries
* How the libraries are organized
* How to get the libraries
* How to keep the libraries up to date
* How to contribute to the libraries

Each of these could have its own page with in-depth examples.

Thoughts?

jkriege2, 2017-07-08:
Good morning around the globe @SchrodingersGat (i.e. yes I was asleep ;-)

I mostly agree with what you write above, but with a preference for not using the manufacturer package naming (so we achieve even better stdnardization over the whole lib). Still a few comments on some of the topics:

1. We should also discuss how to wrok with parts like LM317L (http://www.ti.com/lit/ds/symlink/lm317l.pdf), which is available in different 3-pin packages (TO-92, SOT89,...) all with the same pinout and also in different 8-pin-packages (SOIC,TSSOP,...) ... and even some more variants. Do we want one symbol per package (full package granularity), or do we summarize the packages as far as possible (fewer symbols, but possibly long names as e.g. `LM31L_TO92_SOT89` + `LM317L_SOIC_TSSOP`).
2. I like the idea of breaking down the libs ... ideally, if KiCAD would support a description per lib file, it should also support a tag-tree per lib-file. In that tree we could encode the tree structure, e.g. `ICs/Linear/OPAMP` or `ICs/Linear/Regulators/Positive` and KiCAD could use that info to populate the component tree with not only two layers (lib+devices), but several layers, built up from the tags, until then we should ensure the file-names are at least remotely human-readable, as the sorting of filenames in the tree already gives such a structure ... only flattened out.
3. We should try and come up with a list of features (maybe component category-dependent) for which we would like to see variants (e.g. voltages for VRegs) an a list for which we never want to see variants (e.g. temperature-ratings for VRegs, RoHS, ...).
4. About the microcontrollers. Somehow I have the feeling they should be see as some kind of special case: Usually one does not select them by function, but you already have a family + manufacturer to use in mind (e.g. PIC18 or AVR or ARM ... in the end you do not only need the component, but usually also their toolchain and tools). Therefore I think the libs for them should be sorted that way (+ a lib to catch all that do not fit anywhere), e.g.:
  - `Microcontrollers_Atmel_megaAVR`
  - `Microcontrollers_Atmel_tinyAVR`
  - `Microcontrollers_Atmel_classicAVR`
  - `Microcontrollers_Atmel_AVR32`
  - `Microcontrollers_Atmel_ARM_SAM3`
  - `Microcontrollers_Atmel_ARM_SAM4`
  - ...
  - `Microcontrollers_Microchip_PIC16`
  - `Microcontrollers_Microchip_PIC18`
  - `Microcontrollers_8051`
  - `Microcontrollers_8048`
  - `Processors_Z80`
  - `Processors_AMD_x86`
  - `Processors_Intel_x86`
  - ...
As you see I made two more special cases: We should distinguish between microcontrollers (incl. periphery) and bare Processors (Z80, 80186, ...) in the naming and there are some general variants that are made by several manufacturers (8051s, ...) for those we don't need to split by manufacturer, I think.

What do you all think?

JAN

suzizecat, 2017-07-08:
Hi all !

Since all these modifications implies changing libraries and parts names, i think that it should be a system to forward changes made in the libraries to schematics so, when a user load a new version of the libs he won't run into losing all his symbols in already existing schematic and keep pointing to a "real" symbol (not a cached one) but i think that it's for the dev team...

I agree with @jkriege2 with the MCUs libs, and i would suggest that those parts stay atomic since you'll often look for a specific MCU.

Plus, i also think that if we add the package whithin the component name, we should add the standard one if there is one. Therefore, i think that the manufacturer package name should be stated somewhere if needed to clear any misunderstanding, in the description maybe.

PS :
> That's a lot of combinations. I don't think there exists a set of math equations to even solve for that.

I believe that it's just about some good old multiplication here 😛

jkriege2, 2017-07-08:
Hi @suzizecat !

I don't think having such a forwarding will be possible ... the cached symbols are there exactly for that reason!

> Plus, i also think that if we add the package whithin the component name, we should add the standard one if there is one. Therefore, i think that the manufacturer package name should be stated somewhere if needed to clear any misunderstanding, in the description maybe.

Which should we choose as the "standard" package, e.g. for an LM317???
and: So we should keep a double-list of packages? Waht if a symbol stands in for several manufacturer packages? List all those MPNs in the description?

Best,
JAN

jkriege2, 2017-07-08:
PS: I will try and come up with an initial proposal for lib-names until tomorrow evening or early next week (or maybe even earlier ... I already started on that) ... maybe we can go on dicussing based on that?

poeschlr, 2017-07-08:
Sadly a lot of people to not archive the cache lib (We get a lot of questions regarding that over on the forum.)
I think such a major change should be done with the introduction of kicad 5.x. As a solution we can for example branch the lib and get a new 5.x branch (or branch away a 4.x branch and keep the master branch as the branch where PR are merged into.)

SchrodingersGat, 2017-07-08:
@jkriege2

> 1. We should also discuss how to wrok with parts like LM317L

I would vote for either full package granularity, where possible. It's a step towards atomic parts but without requiring each individual variant. From a design perspective, for bespoke ICs you generally pick the package first (or early in the design).

I would also rather have `LM317L_T092` and `LM317L_SOT89` rather than `LM317_TO92_SOT89` - it quickly becomes messy. What if it matched three footprints, or four?

> 2.  I like the idea of breaking down the libs ... ideally, if KiCAD would support a description per lib file,

This would be great but I fear it will not be possible at least not for a while. We should to the best with what we have, and plan for future advancements with the new library format.

> 3. We should try and come up with a list of features (maybe component category-dependent) for which we would like to see variants

This is a good idea, I think it will be hard to make a ruling on this (but I am happy to be proven wrong!). We *could* step back and say that one-symbol-per-package-variant is all that we will accept too

---------------------------------------

What we should work towards here is not a complete rework of the libs, but a migration path towards the new features of the improved libraries. If we implement a semi-atomic part strategy where each package variant has its own symbol, then when the new libraries come we can add each variant *then* - and we'll be well prepared for it.

---------------------------------------

> That's a lot of combinations. I don't think there exists a set of math equations to even solve for that.
> @suzizecat I believe that it's just about some good old multiplication here :stuck_out_tongue:

Ah, you got me!

SchrodingersGat, 2017-07-08:
### Renaming libraries

Any major change should be held off until the next stable release (5.0 would be perfect).

I would ideally like to see the new library files implemented at the same time as merging the footprints. Then we could have the following repos:

* /footprints
* /symbols
* /packages3d

/kicad-library repo would stay for a while (at least a year) marked as deprecated and not accepting PRs - for legacy requirements. Same with all the .pretty repos

SchrodingersGat, 2017-07-08:
### Standard Parameters

As part of the *new* library format (this is way in the future) we should also develop a set of standard parameter names to be attached (optionally) to each part. For e.g.

* Manufacturer
* MPN
* Rated voltage
* Min. Temperature
* Max. Temperature

etc

This is **not** something we will address for a while yet, but it bears thinking about. It would be awesome to be able to do a parametric search within the KiCad library browser :)

SchrodingersGat, 2017-07-08:
### Symbol Naming (Reprise)

I am looking again at the [LM317](http://www.ti.com/lit/ds/slvs044x/slvs044x.pdf) datasheet.

If we are to create a new naming scheme for package variants, I still think this introduces an unnecessary level of complication.

On p1 of the datasheet we see four unique part numbers:

* LM317DCY (SOT-223)
* LM317KCS (TO-220)
* LM317KCT (TO-220)
* LM317KTT (TO-263)

Here we notice a few things

1. The manufacturer has already specified a coding scheme for the package variants
1. There are two `TO-220` options available (how would we encode that?)

Further, a brief look at some other packages shows that **not all manufacturers conform to the same package naming**. What TI calls a TO-263, another may call something different. So we have to encode some scheme which can accommodate this. If the datasheet says one package but we use a different one, that's going to lead to confusion, at a minimum.

As a product engineer, how do I actually pick the package variant? I (personally) want to go into the selection window and see an option that directly matches the datasheet. I don't want to have to match up the datasheet with yet another naming scheme.

Yes, the manufacturer naming schemes are all different, and all terrible. But let's not add another layer of confusion!

-----------------------------

For 'generic' parts, I really agree that we should use a standardised suffix such as `_SOT-23-5` (etc). But where we are matching to a particular manufacturer datasheet, we should use their numbering.

keruseykaryu, 2017-07-08:
First of all you should answer a simple question: "If KiCad standard libraries are for hobbyists/one-time-users or (semi-)professionals?".
The hobbyist will be happy when you use for example: `LM317L_TO92`, `LM317L_SO8` (with correct pin association).
The professionals will be very angry, because they need a real, manufacturer part number for their BOM's. Even if they need a simple capacitor SMD 1206 100nF they need full manufacturer code, because using X5R type instead X7R may **collapse their project**.

Keeping in mind some words of Wayne (somewhere on dev mailing list), KiCad should acquire more attention of professionals.

SchrodingersGat, 2017-07-08:
> First of all you should answer a simple question: "If KiCad standard libraries are for hobbyists/one-time-users or (semi-)professionals?".

Professional use is what we are targeting. Hobby users will benefit from using quality libraries, whereas professional users will reject hobby-grade libraries out of hand.

> The professionals will be very angry, because they need a real, manufacturer part number for their BOM's. Even if they need a simple capacitor SMD 1206 100nF they need full manufacturer code, because using X5R type instead X7R may collapse their project.

We are *not* going to support all R/C variants for example. Maybe one day, but that would require a much larger library team.

I see the value of atomic parts, and know personally the calamity that can be caused by incorrect part specification. This is *always* the responsibility of the person designing the schematic.

The KiCad standard libraries should be a launching point for professional design with KiCad. The higher standard we hold the libraries to, the more people will make use of them and contribute back to them.

> KiCad should acquire more attention of professionals.

It does! I am of them - which is why I am pushing to have the libraries be improved upon greatly.

SchrodingersGat, 2017-07-08:
The major argument for not specifying every single part variant in our libraries is thus:

1. It's a **lot** of work and we have only limited resources. Also, we're not getting paid.
1. The more data we enter, the more data we are responsible for.
1. Mapping schematic symbols to compatible footprints is close-enough for most applications (especially hobby grade!)
1. "Power users" should 100% check each and every symbol / footprint / MPN / SKU in any case. So it makes just as much sense to specify a generic base part name and then the responsibility for BOM management is passed to the user
1. Many companies use internal part numbering systems anyhow.
1. Part numbers and variants can change - requiring a lot of data management

It's all a matter of effort to reward. I think the discussion on this issue thus far is trending towards a workable solution somewhere in the middle of "useless libraries" and "too much work".

jkriege2, 2017-07-08:
But we already broke those a lot, when reworking all sorts of libs (regul, linear, ...)

jkriege2, 2017-07-08:
The LM 317 also demonstrates a big problem with using the manufacturer suffixes (I copied this from one of the other discussions):

Here's an example: `LM317`
- http://www.ti.com/lit/ds/symlink/lm317.pdf
- https://www.onsemi.com/pub/Collateral/LM317-D.PDF
- http://www.st.com/content/ccc/resource/technical/document/datasheet/group1/a0/db/e6/9b/6f/9c/45/7b/CD00000455/files/CD00000455.pdf/jcr:content/translations/en.CD0000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

Naming scheme:
- ST in TO-220: LM317T/LM317BT/LM317T-DG  => we might use LM317T
- ST in D2PAK: LM317D2T  => we might use LM317D2T
- ON-Semi in TO-220: LM317TG/LM317BTG  => this might match ST-standard LM317T
- ON-Semi in D2PAK: LM317D2TG  => this might match ST-standard LM317D2T
- TI in TO-220: LM317KCS/LM317KCT **=> does not match the LM317T of ST!!!**
- TI in D2PAK: LM317KTT **=> does not match the LM317D2T of ST!!!**

So, how do we work with this? Is LM317 then a generic part, or do we add all variants? What happens if we have a part that is only later also produced by another manufacturer with other suffixes? Do we add those too?

If we say assigning the correct MPN is a task of the lib-user at BOM stage, then adding generalized suffixes `_TO92`... still seems to me to be the only managable variant unless we want a large set of rules on how to handle such components ...

Note: I'm more the hobbyist and software-developer ... and I clearly see the benefit in grouping stuff as good as possible (to minimize work and ensure manageability) ... but if that approach is totally unusable to a professional electronics engineer let me know. In that case I feel that also the way that KiCAD is taylored towards a certain process would need to change. Currently it is designed (as I understand it), so you first design the schematic from more or less general parts and only then select the packages, when designing the PCB ...

Best,
JAN

Best,
JAN

suzizecat, 2017-07-08:
Hi @jkriege2 ,

> Which should we choose as the "standard" package, e.g. for an LM317???

You misunderstood me when i was talking about "standard FP", i wasn't talking about a "most usual package" but about the stabdard denomination, reffering to the "Variant Naming" post of SchrodingerGat

For my part, i used KiCAD as hobbyist and now in a professional way, but in a pretty small structure.
I do love having atomic parts in KiCAD because you're _sure_ that your part got the right pin mapping and that you will have the right FP for it.

I got to say that i was stupidly caught in using an IRF9Z34N (a mosfet transistor), didn't found the right pin mapping in the datasheet and assumed it was GDS like other transistors i found when it was GSD (or something equivalent). That was my absolute first real design and it took me 2 mounth to find out where the problem was...
It was totally my fault, but what i'm thinking is that it's waymore conveignent when you can have your exact component in the lib since you wont do that kind of (pretty stupid and unprofessional since i was hobbyist) mistake.

For the LM317 problem, i would think to add the name of the manufacturer somewhere in the part name, but that wouldn't nice to maintain (at all) since it will be hard to have all manufacturers...

Best, Julien

PS :
I got a sneaky trick for ST datasheets, you should try right click the link pointing the DS and use "Copy the link address" (or equivalent) rather than going into the PDF and copying the address bar, then you got http://www.st.com/resource/en/datasheet/lm317.pdf for the LM317 which is way more convenient than their insanely long address...

SchrodingersGat, 2017-07-09:
@jkriege2 the **LM317** was a poor example choice (on my part) as this is a prime example of where the footprint suffix works really well.

The **LM317** (and similar common parts) *should* be used with a suffix like `_TO-220` (etc) as otherwise we need to maintain individual LM317 parts for each manufacturer. Your scheme makes the most sense in this example.

However any footprints where there are multiple pinouts in the same package cause issues. I *really do not want* to have naming conventions like `_TO-220_Variant-B` (or similar). Such names do not contain enough information to identify the correct footprint. We need a clear direction for these edge cases.

Let's consider another example - the [PIC18F2xkx0](http://ww1.microchip.com/downloads/en/DeviceDoc/39977c.pdf) series. Here the PIC18F2xK80 device is available in SSOP/DIPSOIC with the **same pinout**. This symbol is complicated enough that we don't want to have to duplicate it for each item.

But how do we name it? `PIC18F2xK80_SSOP_DIP_SOIC`? This looks very messy to me..

Perhaps this problem can be held off until we have the ability to have variants with different footprint association? It becomes a moot point at that stage!

-------------------------

With the knowledge that in the future we will have to port our libraries over, and that we will have much more powerful library features, I propose the following:

1. We mandate that new parts must be "atomic" (one symbol for each footprint type) but beyond that they are generic.

2. Part variants should be named in a fashion `MPN-BASE_PKG` e.g `LM317_SOIC` or `MAX232_DIP`

3. These base parts allow users to drop into the schematic and then insert any precise MPN (or internal part number) that they want.

3. When the new library format comes around, we can add variants with multiple parameters, etc, etc

------------------------

I will agree to the above if we can come up with a solution for a naming convention that handles the aforementioned issues:

a) How to deal with a part that has multiple pinout options for the same package?
b) How to deal with a part that matches multiple footprints with the same pinout?

jkriege2, 2017-07-09:
Hi! @SchrodingersGat

- a) Hhmmm ... You're thinking about something like MCP601 in SOT23-5 (http://ww1.microchip.com/downloads/en/DeviceDoc/21314g.pdf)? There I would stick to the manufacturer in distinguishing them. Here I would use `MCP601_SOT23` and `MCP601R_SOT23` ... They list them as MCP601 and MCP601R on the first page of their DS, i.e. the R can be interpreted as part of the base-MPN... But I don't know how other manufacturers do that ...
- b)/`PIC18F2xK80_SSOP_DIP_SOIC`: yes that's messy, I ran into the same problem, when rworking regul.lib. There are already some symbols there that use this nomenclature ... it's far from perfect, but does what I felt was intended by the KLCs that stood at that point.

As the push for atomic parts seems very strong to me (at least what I see from these discussions), you suggested some allowances above ... but I have no clue how we could formulate them in a concise way and prevent too much clutter ... Did you have a set of concrete rules in mind (especially when to use them exactly)?

Best,
JAN

bobc, 2017-07-09:
@SchrodingersGat

> The major argument for not specifying every single part variant in our libraries is thus:

There is one other practical issue, KiCad hangs when there are "too many" components in a library. I don't know what the upper limit is, but I tried adding 130,000 atomically defined resistors and that broke KiCad. I cut the number down to about 5,000 and that seemed ok.

That shouldn't stop us from organising the libraries the way we want, just bear in mind we may need some fixes in KiCad code to improve scalability if we start to create really large numbers of components.

gauravjuvekar, 2017-07-09:
Okay, slightly off topic here, but is there a reference on the actual file formats and capabilities of S-expression and SWEET fileformats for Kicad 5.x? The closest I could get to was https://forum.kicad.info/t/changes-to-eeschema-and-its-file-format-any-info-dates/3297/10 without actually going into the code.

SchrodingersGat, 2017-07-09:
@gauravjuvekar here's what I have:

* https://lists.launchpad.net/kicad-developers/msg23302.html
* https://lists.launchpad.net/kicad-developers/msg27071.html
* https://lists.launchpad.net/kicad-developers/msg06448.html

From the sounds of things there is a large amount of code that has been written but is hidden from the development branch for now.

poeschlr, 2017-07-09:
How should we handle part naming until this issue is decided?
(I have a few PR where the "new" style with MPN
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

Thread 1402 (2017-07-10):

RFC - Rearranging Symbol Libraries

SchrodingersGat, 2017-07-10:
Following on from the work by @jkriege2 [here](https://github.com/KiCad/kicad-library/issues/1398#issuecomment-313969813)

| Library Name | Description | Previous Name | Notes |
| ------------------ | --------------- | --------------------- | ------------ |
| **Basic Devices**
| device.lib | Symbols for simple devices e.g. Resistors / Capacitors / etc. | device.lib |
| elec-unifil.lib | ??? | | |
| led.lib | LED | device.lib |
| motor.lib | Electric motors | | |
| power.lib | Power symbols (global) | | special symbols library |
| pspice.lib | Spice symbols | | |
| relay.lib | relays |
| switch.lib | Buttons and switches | | |
| **Connectors** |
| connector.lib | Connectors, general purpose | conn.lib | Could be expanded in future e.g. *connector_usb.lib* / *connector_JST.lib* |
| **Virtual** |
| graphical_symbol.lib | | | |
| logo.lib | | |
| mechanical.lib | | |
| **Semiconductors (simple)** |
| diode.lib | Diodes | | |
| transistor.lib | Transistors | infineon.lib | |
| thyristor.lib | Triacs, thyristors, SCR, etc | | |
| valve.lib | Valves | | |
| **Displays** |
| display_character.lib | Character displays e.g. 16x2 text display | display.lib |
| display_dot-matrix.lib |
| display_graphic.lib | Pixel-based displays, etc | display.lib |
| display_segment.lib | 7-segment, LED bar displays, etc | display.lib | |
| **Transformers** |
| transformer.lib | General purpose transformer |
| transformer_power.lib | Power transformers |
| transformer_pulse.lib | Pulse transformers |
| transformer_signal.lib | Small signal transformers |
| **Sensors** |
| sensor.lib | Sensors that do not fit other categories | sensors.lib |
| sensor_audio.lib |
| sensor_current.lib | Current shunts / transducers / etc | sensors.lib / ir.lib / allegro.lib |
| sensor_gas.lib | Gas sensors, various | sensors.lib |
| sensor_humidity.lib | Humidity sensors | sensors.lib |
| sensor_magnetic.lib | Hall effect, etc | sensors.lib |
| sensor_motion.lib | Accelerometers / gyro | sensors.lib |
| sensor_multi-function.lib | Sensors that sense multiple things e.g. temperature / pressure | sensors.lib |
| sensor_photo.lib | Light sensors, RGB, photoresistors | sensors.lib |
| sensor_pressure.lib | | sensors.lib |
| sensor_temperature.lib | | sensors.lib |
| sensor_voltage.lib |
| sensor_touch.lib |
| **Audio / Video** |
| audio_adc_dac.lib | | digital_audio.lib |
| audio_codec.lib | Audio Codec IC |
| audio_misc.lib | Miscellaneous audio parts |
| video.lib | | gennum.lib |
| **Linear Devices** |
| amplifier_operational.lib | Amplifiers (general purpose) | linear.lib / analog_devices.lib ||
| amplifier_audio.lib | Audio amplifiers |
| amplifier_current_sense.lib | Current sense amplifiers (separate to e.g. hall-effect current sensors) |
| amplifier_difference.lib | Difference amplifiers | linear.lib |
| amplifier_instrumentation.lib | Instrumentation amplifiers | linear.lib |
| amplifier_rf.lib | RF amplifiers |
| amplifier_video.lib | Video amplifiers
| comparator.lib | Comparators | linear.lib |
| **References** |
| reference_current.lib | Precise current reference | references.lib |
| reference_voltage.lib | Precise voltage reference | references.lib |
| **Power Management** |
| battery_management.lib | Chargers, etc | texas.lib |
| power_distribution.lib | e.g. load switch, ideal diode controller, hot-swap controllers, etc | power_management.lib, texas.lib |
| power_supervisor.lib | Reset monitor ICs, etc | power_management.lib |
| power_monitor.lib | Power monitoring devices |
| power_protection | TVS, ESD protection, etc | |
| **Regulators** |
| regulator_module_ac-dc.lib | Modular ac-dc devices | ac-dc.lib |
| regulator_module_dc-dc.lib | Modular dc-dc devices | dc-dc.lib |
| regulator_linear.lib | Linear regulators |
| regulator_linear_controller.lib | Linear regulator controller |
| regulator_switching.lib | Switching regulators |
| regulator_switching_controller.lib | Switching regulator controller |
| regulator_switching_module.lib | Stand-alone switching modules |
| regulator_pwm_controller.lib | PWM ICs |
| regulator_pfc.lib | Power factor correction |
| **Mixed Signal** |
| analog_switch.lib | Analog switches |
| adc.lib | Analog -> Digital | adc-dac.lib |
| dac.lib | Digital -> Analog | adc-dac.lib |
| digital_pot.lib | Digital potentiometers | xicor.lib, texas.lib |
| adc_dac.lib | Devices with both ADC and DAC |
| **Drivers** |
| driver_led.lib | LED drivers | worldsemi.lib |
| driver_gate.lib | FET gate drivers, half / full bridge drivers | zetex.lib / ir.lib / power_management.lib |
| driver_motor.lib | Motor control ICs | texas.lib (?) |
| **Timers** |
| timer_oscillator.lib | Timers / oscillators / crystals | Oscillators.lib |
| timer.lib | | linear.lib | e.g. NE555 | linear.lib |
| timer_pll.lib | PLL ICs | linear.lib | e.g. NE567 | linear.lib |
| timer_rtc.lib | Real time clock | |
| **Logic** |
| logic.lib | Generic logic symbols for gates / inverters / etc |
| logic_cmos40xx.lib | 4000 series logic | cmos4000.lib / cmos_iee.lib | Previously split into IEC / IEEE variants. New library format could allow different graphical representation for each symbol, so users can choose which symbol they want |
| logic_74xx.lib | 74 series logic | |
| logic_translator.lib | Level converters, shifters, etc | texas.lib |
| isolator.lib | Optocouplers / capacitive isolation / etc | opto.lib, texas.lib |
| isolator_analog.lib | Analog isolators | | If needed |
| **CPLD / FPGA** |
| cpld_xilinx.lib | | xilinx.lib |
| cpld_altera_intel.lib | | Altera.lib |
| fpga_xilinx.lib | | xilinx.lib |
| fpga_altera_intel.lib | | Altera.lib |
| fpga_actel.lib | | actel.lib |
| fpga_atmel.lib | | atmel.lib |
| **Microcontrollers / Processors / DSP** |
| mcu_8048.lib | | |
| mcu_8051.lib | | |
| mcu_atmel_avr | Atmel AVR series | atmel.lib |
| mcu_atmel_avr32 | Atmel 32-bit AVR series | atmel.lib |
| mcu_atmel_arm.lib | Atmel ARM micro | atmel.lib |
| mcu_cypress.lib | | cypress.lib |
| mcu_cypress_arm.lib | | cypress.lib |
| mcu_microchip_pic10 | PIC10 series | microchip_pic10mcu.lib |
| mcu_microchip_pic12 | PIC12 series | microchip_pic12mcu.lib |
| mcu_microchip_pic16 | PIC16 series | microchip_pic16mcu.lib |
| mcu_microchip_pic18 | PIC18 series | microchip_pic18mcu.lib |
| mcu_microchip_pic24 | PIC24 series | microchip_pic24mcu.lib |
| mcu_microchip_pic32 | PIC32 series | microchip_pic32mcu.lib |
| mcu_freescale_hc.lib | Freescale HC series | |
| mcu_freescale_coldfire.lib | Freescale coldfire | motorola.lib |
| mcu_infineon_c166.lib | | |
| mcu_nxp_arm.lib | NXP microcontrollers | | nxp_armmcu.lib |
| mcu_parallax.lib | | |
| mcu_renesas.lib | |
| mcu_st_stm32.lib | STM32 micro | stm32.lib |
| mcu_st_stm8.lib | STM8 micro | stm8.lib |
| mcu_texas_msp340.lib | MSP340 micro | msp430.lib |
| cpu_intel_x86.lib | | |
| cpu_amd_x86.lib | | |
| cpu_motorola_68000.lib | | motorola.lib |
| cpu_motorola_powerpc.lib | | motorola.lib |
| cpu_zilog_z80.lib | | Zilog.lib |
| dsp_microchip_dspic33 | DSPIC33 series | microchip_dspic33dsc.lib |
| dsp_texas.lib | Texas DSP (digital signal processors) | dsp.lib |
| dsp_freescale.lib | Freescale DSP | dsp.lib |
| soc_texas_arm.lib | Texas ARM SOC (system on chip) | texas.lib |
| **Memory** |
| memory_card.lib | SD card, etc |
| memory_vram.lib | Volatile RAM (DRAM / SRAM) | memory.lib |
| memory_nvram.lib | Nonvolatile RAM (MRAM / FRAM) | memory.lib |
| memory_eeprom.lib | EPROM / EEPROM | memory.lib |
| memory_flash.lib | FLASH memory | memory.lib |
| memory_controller.lib | Memory controller ICs | memory.lib |
| **Interface (Comms)** |
| interface_can_lin.lib | CAN / LIN | interface.lib |
| interface_ethernet.lib | Ethernet | interface.lib / wiznet.lib |
| interface_i2c.lib | I2C interface - expanders, isolators, etc | nxp.lib, texas.lib |
| interface_lvds.lib | LVDS | interface.lib |
| interface_spi.lib | SPI interface |
| interface_telecom | Telecom interface | interface.lib, silabs.lib |
| interface_uart.lib | RS232/422/485 interface | interface.lib |
| interface_usb.lib | USB | silabs.lib,  texas.lib |
| interface_video.lib | Video interface | broktree.lib |
| **RF Interface** |
| rf_am_fm.lib | AM / FM transceivers | rfcom.lib |
| rf_bluetooth.lib | Bluetooth ICs etc | rfcom.lib |
| rf_antenna.lib | RF antenna |
| rf_misc.lib | Miscellaneous RF parts that don't fit elsewhere |
| rf_frontend.lib | RF front-end paraphenalia |
| rf_wifi.lib | WiFi |
| rf_zigbee.lib | Zigbee / XBee |

-----------------------------------------

- ~~allegro.lib~~ - `sensor_current.lib`
- ~~analog_devices.lib~~ (AD623/AD8236/AD42x to amplifier.lib [all int amps], ADE7758 to ic_misc.lib, ADuM6000 to regulator_switching.lib, ADuM7758 to interface???.lib)
- ~~bbd.lib~~ (all audio delay lines so audio_misc.lib)
- ~~bosch.lib~~ - move to `sensor_motion.lib`
- ~~brooktre.lib~~ - move to `interface_video.lib`
- ~~contrib.lib~~ move to an `interface_<x>.lib`
- ~~ftdi.lib~~ - mostly to `interface_usb`
- ~~gennum.lib~~ - (all to video.lib: gs9020 is video processor, gs9025 is cable driver, and gs9032 is video serializer)
- graphic.lib
- ~~infineon.lib~~ (all to transistors.lib since they're just FETs with some protection built in)
- ~~intel.lib~~ - moves to multiple libs, `mcu_intel.lib`, oscillator, interface
- ~~intersil.lib~~ - moves to `driver_gate`, `driver_motor`, etc
- ~~ir.lib~~ (AU* parts to sensors_current.lib and all others to gate_driver.lib)
- ~~LEM.lib~~ - move to `sensor_current.lib`
- ~~maxim.lib~~ - split into many libs. A lot of temperature sensor parts
- ~~microchip.lib~~ - mostly interface chips
- ~~nordicsemi.lib~~ - to `interface_bluetooth`
- ~~nxp.lib~~ (all to interface_i2c.lib)
- ~~onsemi.lib~~ - `esd_protection` / `transistor`
- ~~philips.lib~~ - mostly `interface_<x>`
- ~~powerint.lib~~ (CAP* parts to ic_misc.lib and all others to regulator_switching.lib)
- RFSolutions.lib
- ~~silabs.lib~~ (cp2xxx to interface_usb.lib, si3210 to interface_telecom.lib? [it's an analog phone interface], the rest to the newly created interface_am_fm.lib)
- ~~siliconi.lib~~ (actually Siliconix parts; driver_motor.lib and analog_switch.lib)
- ~~supertex.lib~~ (reference_current.lib, power_distribution.lib, regulator_switching_converter.lib, regulator_linear.lib; see below)
- ~~texas.lib~~ (too big to write out here; see post by @evanshultz on 22 Jul below)
- ~~wiznet.lib~~ (to interface_ethernet.lib)
- ~~Worldsemi.lib~~ (to driver_led.lib)
- ~~Xicor.lib~~ (all to digital_pot.lib)
- ~~zetex.lib~~ (move to gate_drivers.lib)

### Edits

1. @schrodingersgat changed library names to singular
1. @schrodingersgat changed `microcontroller_` to `mcu_`
1. @schrodingersgat renamed `audio_adc_adc.lib` -> `audio_adc_dac.lib`
1. @schrodingersgat renamed `processor_` to `cpu_`
1. @schrodingersgat split `amplifier.lib` into multiple libraries
1. @schrodingersgat added `power_distribution`, `power_conditioning`, `battery_management`
1. @schrodingersgat added more amplifier categories, added transformer categories, improved regulator categories
1. @schrodingersgat added suggestions by @poeschlr
1. @evanshultz divested modules.lib, gennum.lib, bbd.lib, silabs.lib, texas.lib, worldsemi.lib; noted reset ICs in power_management.lib; fixed a few typos
1. @schrodingersgat updated `power_` libraries
1. @schrodingersgat added `rf_` libraries

SchrodingersGat, 2017-07-10:
Some notes on the (currently unassigned) libs above

1. I don't like the word "periphery" - I don't think it is technical enough
1. The remaining unassigned libs are mostly manufacturer specific. We will have to go through them and decide what functions to assign.

SchrodingersGat, 2017-07-10:
Rather than making new tables below, please make any adjustments (after discussion) to the table in the comment at the top.

SchrodingersGat, 2017-07-10:
## Plurals

Plural naming does not work well for everything. However I think that non-plural naming can work in all cases. Should we enforce a non-plural naming scheme is anyone really passionate about plural names?

Examples of plurals that just sound wrong

* memories_flash.lib  _(memory_flash.lib)_
* interfaces_ethernet.lib _(interface_ethernet.lib)_
* dacs.lib _(dac.lib)_

I propose we name *function_extra_sub*, otherwise we get a weird combo of *function**s**_extra_sub*, _function_extra_sub**s**_

evanshultz, 2017-07-10:
powerint.lib has most parts that are internal FET regulators, and also a few line discharging parts that I think go into `ic_misc.lib`.

You need `audio_misc.lib` or something like that for SRCs, mic preamps, etc.

Where do CODECs go? I assume `audio_adc_dac.lib`, but what else would go there? Why not call it `audio_codec.lib`?

More libraries are needed for SMPSs more. Break out DC-DC internal FET (regulators) from DC-DC external FET (controllers). We already have a lot of each. And generic SMPS controllers like UC3842 and NCP1200 deserve their own library. They're a different ballgame than integrated DC-DC parts. Lastly, where do PFC controllers go? They're a totally different type of IC (unless you're talking about single-stage flyback or oddball topologies like the Clark converter of PFC buck) and I think they should be in their own library.

Lastly, transformers are a total wasteland. I'd like to find a paradigm that works. I've tried 3 categorization schemes and none of them worked well for me. Does anybody have anything that works? It may take multiple libraries to cover AC line frequency, SMPS, gate drive, ethernet, and all other kinds of magnetics. Additionally, do coupled inductors go here or elsewhere? What about common mode chokes? Do those have their own libraries?

jkriege2, 2017-07-10:
Some more  comments:
- singular is fine for me
- `audio_codec.lib` is fine with me
- if we split DC-DC, then we should also have a separate lib for switched-cpacitor voltage converters (e.g. LTC660) ... name could be `regulators_switching_capacitance.lib`
- For simple magnetics like coils we don't need a separate lib (the footprints should simply use the pin-numbers 1 and 2 and they match to the generic symbol L, ...).
- For common-mode chokes we should have a separate lib ... could we have something like `filters.lib` that could also contain other "filtering" components (most of them again fit the generic symbol, but some just might be different)??? Not sure about that
- For transformers also not sure: maybe `transformer_power.lib` (for larger ones, 220V->xyV) and `transformers_small_signal.lib` or `transformers_pulse.lib` (for audio, ethernet, ... is that the correct english name? I translated from the german "Überträger" using Wikipedia ;-)
- several libs were lost I feel (battery_management, relay_drivers.lib transistor_arrays.lib ...) I will try and add them this evening ...

Best,
JAN

hackscribble, 2017-07-10:
+1 for singular.

There were suggested libraries starting `quarz...` that I don't see in the table above.  Would these better as `piezo...` since the material used might be crystal or ceramic?  Whether it's a filter or a resonator, it is the piezoelectric effect that they have in common.  But if we stick with the suggested name, it should be `quartz...` (I'm being very picky :wink:)

What will be left in `device` if inductors move to a separate library as @jkriege2 suggests above?  Just resistors and capacitors?  If so, why not split into two libraries for clarity?

How about shortening `microcontroller_` to `mcu_`? Anyone using one ought to recognise the acronym.

`peripheral` instead of `periphery`?

SchrodingersGat, 2017-07-10:
1. Alright, singular names it is (I have updated the table accordingly).
1. I also prefer `mcu_` as a prefix (we already have `soc_` and `dsp_`
1. Regulators (switching). Agreed that we need to arrive at some categorizations here
1. Transformers - my knowledge here is lacking
1. `peripheral.lib` - the suggested contents of this library still seem very broad to me. Can we narrow this down?

hackscribble, 2017-07-10:
> piezo / quart / etc - what is the function of this library (not the material it is made of!) Is it oscillators? Resonators? Other?

OK, I see that there have been edits on the other thread that prompted my comment :smile: : https://github.com/KiCad/kicad-library/issues/1398#issuecomment-313926433

That now suggests two libraries:

> oscillators.lib (formerly: Oscillators.lib)
quarzes_filters.lib (formerly: Oscillators.lib)

If `oscillators.lib` is passive piezoelectric oscillating devices (i.e. standalone crystals, crystal resonators with built-in capacitors and ceramic resonators), that's good.  But it should not IMHO include oscillator ICs.

Piezoelectric filters can be made of quartz crystal or ceramic material.  So `quartz_filters.lib` does not sit well with me.

pointhi, 2017-07-10:
After a quick look
* ```audio_adc_adc.lib``` -> ```audio_adc_dac.lib```
* ```sensor_multiple.lib``` -> ```sensor_combined.lib``` is probably a better name. Probably someone has a even better one

@SchrodingersGat probably ```kicad-symbols``` would be a more appropiate name for the repo than ```symbols```

nbxmike, 2017-07-10:
You may as well combine the NXP and Freescale processors to NXP or you will need to do it later.

evanshultz, 2017-07-10:
@pointhi Can you please check you first bullet? It looks like the same lib name is repeated.

Unless someone objects, I volunteer to propose the divesting of the following libs:
- analog_devices
- infineon (which purchased IR)
- intersil
- on semi
-zetex

evanshultz, 2017-07-10:
@SchrodingersGat Is the above a "all edit" table? Or are we making suggestion with one person (you, I assume) as mediator and editor of the table?

evanshultz, 2017-07-10:
Finished with analog_devices.lib, infineon.lib, and zetex.lib.

I like the idea of separate diode libraries IF the symbols are different. For example, regular Si diodes, Schottky/SiC, zener/TVS, etc. This will result in the least amount of unique symbols so it's the easiest to maintain.

diggit, 2017-07-10:
In _my_ opinion, there is no need for symbols of specific symbols for such simple devices. Generic symbols are IMO enough. There is only several permutations with so few pins. Then splitting them does not make sense, they could all got to device.lib.
At least my workflow is:

1. find online which components suits the purpose and is available
2. choose correct generic symbol (it is fast, keywords like: gds, zener, tvs, diode, fet, npn, .... works well)
3. rename symbol to match selected device
4. assign correct FP

I have similar workflow for linear regulators, because in 70% cases, the one I choose to use is not in libs.

SchrodingersGat, 2017-07-10:
> @evanshultz - @pointhi Can you please check you first bullet? It looks like the same lib name is repeated.

Read it again ;) It's a very subtle mistake that I made in the original table, which I have now fixed.

SchrodingersGat, 2017-07-10:
> @SchrodingersGat Is the above a "all edit" table? Or are we making suggestion with one person (you, I assume) as mediator and editor of the table?

It's open to editing, but only after discussion here :) Please add edit comments at the end of the table as I have been doing, if you edit anything!

SchrodingersGat, 2017-07-10:
### Amplifiers

Currently the amplifier organization is pretty rough. What are some broad categorizations for amps?

* amplifier_instrumentation
* amplifier_current_sense
* amplifier_chopper
* amplifier (everything else)

gauravjuvekar, 2017-07-11:
@SchrodingersGat Er, I don't think others can edit the post. That's not how github works.

SchrodingersGat, 2017-07-11:
Sorry @gauravjuvekar you are completely correct - please ignore that.

Update : Make suggestions and I will add them to the table :)

jkriege2, 2017-07-11:
I think you need to be Member or Owner to edit a non-own post.
JAN

gauravjuvekar, 2017-07-11:
Can we create separate `rf_*` libs. I know that currently there aren't many rf components in the libs, but there are a large number of categories in rf out there.

Eg, see https://www.digikey.com/products/rf-wireless/en
I guess rf_{trasmitters, receivers, transceivers} could go in `interface_rf`, but there are a lot of non-interface components like amplifiers, mixers, couplers, active balun ICs, switches, etc.

SchrodingersGat, 2017-07-11:
@gauravjuvekar this is a good idea, I was only just thinking where antennae would go. I agree there is a place for `rf_` libs separate from RF ICs

gauravjuvekar, 2017-07-11:
I think antenna should also be a separate library. It also has a lot of subdivisions (type: patch, chip, wire)

jkriege2, 2017-07-11:
@SchrodingersGat: some comments about amplifiers:
- `amplifier_current_sense` shouldn't/couldn't that go to `sensor_current`?
- I'm missing `amplifier_difference` (for components like these: http://www.ti.com/lit/ds/symlink/ina157.pdf) ... basically OPAMPS, but with (calibrated) resistors inside
- Also maybe `amplifier_power` and/or `amplifier_highvoltage`? (not so sure about these ... but there we could put e.g. opamps that also work at 100V ...)

Just ideas ...

JAN

SchrodingersGat, 2017-07-11:
> amplifier_current_sense shouldn't/couldn't that go to sensor_current?
I think that's fair.

> I'm missing amplifier_difference (for components like these: http://www.ti.com/lit/ds/symlink/ina157.pdf) ... basically OPAMPS, but with (calibrated) resistors inside
> Also maybe amplifier_power and/or amplifier_highvoltage? (not so sure about these ... but there we could put e.g. opamps that also work at 100V ...)

I've added `_difference`, `_power`, and `_rf` but I don't think that `_highvoltage` is a category all on its own...

SchrodingersGat, 2017-07-11:
Added transformer categories.

jkriege2, 2017-07-11:
will people know that `amplifiers.lib` or `ic_amplifiers.lib` contains OPAMPS? ... i.e. are all amplifiers OPAMPS or one of the others ...

JAN

poeschlr, 2017-07-11:
What about (multi purpose) signal level translators and signal isolators? (currently they might go into the logic libs but i think giving them a separate lib might be a good idea.)

The symbols of the LEM lib could go into the sensor_current lib.

evanshultz, 2017-07-11:
> amplifier_current_sense shouldn't/couldn't that go to sensor_current?

I disagree. The sensor is the part that actually senses the current. ICs like we see in `linear.lib` now that are "current sense" parts are simply amplifying an external sensor, like a resistor or transformer/inductor winding. I do not think those ICs belong in `sensor_current.lib`.

I also do not like having so many sub-categories for opamps. Why would you break out chopper-based amps? Their benefit is low input offset voltage, but you can get non-chopper amps with excellent performance here as well. It seems that we'd be splitting up parts which are otherwise interchangeable, cutting users off from seeing all opamp possibilities they might want to choose.

poeschlr, 2017-07-11:
Gennum  is now semtech
the `gennum.lib` would need to be split up into multiple libs. (non of the symbols have a description which makes this a bit harder.)

`graphic.lib` does not exist in the current master branch. It has been renamed to `graphic_symbols.lib` (or has it been deleted and the graphic_symbols lib is a completely new lib?)

`intel.lib` mostly into a new `mcu_intel.lib` but also some into `oscillator`, `interface*`, ...

`intersil.lib` either `driver_gate` or `driver_motor`

`maxim.lib` split up in many parts. (many temp sensors but also a some other stuff.)

`microchip.lib` mostly interface chips. (some gate drivers)

`nordicsemi.lib` only one chip is in there. should go to `interface_bluetooth`

`nxp.lib` some i2c led controllers and i2c multplexers

`onsemi.lib` mostly `esd_protection` but also `transistor`

`philips.lib` mostly interfaces

---

Where should digital potis go?
Where should i2c, spi, ... io expander go?
should h-bridge drivers go into `diver_gate` or `driver_motor`?

nbxmike, 2017-07-11:
At the rate at which sub-categories are being proposed, the library revision better have some kind of search tool across ALL libraries.

I am no op-amp expert and rely on others to tell me that part of a design, so I would not necessarily know which of the categories to look in for a part number I've been provided.  I doubt I am alone in allowing other people with more specific expertise to dictate portions of my designs, I could see us getting very frustrated with so many finely sliced parts libraries.  Right now, grep is my go to solution for this but I think less command line experienced people would prefer a built in tool.

poeschlr, 2017-07-11:
When placing a part in eeschema the search field gives results in all libs.

poeschlr, 2017-07-11:
The note for connector lib:
> Could be expaned in future e.g. connector_usb.lib / connectos_JST.lib

I don't think generic connectors need a specialized symbol.
The only symbols we could add is for multi row connectors where each row has a separate connector on the wire side. Or for connectors that don't follow a pure numeric numbering scheme.

jkriege2, 2017-07-11:
@poeschlr
I would say:
- dig. potis in `ic_digpotentiometers` or `digital_potentiometers` ... there are so many that I think they deserve their own lib ... anotherpossibility (although not completely accurate would be `dac.lib`)
- h-bridges I would put into driver_motor?
- for IO-expanders, RTC, ... I proposed the periphery_-tree ... which was not accepted ... as RTCs are in `rtc.lib`, this would call for `io_expanders.lib` ...

@SchrodingersGat :
- what about timers like 8253, which are specifically designed as µC-periphery ... do they fit in `timer.lib`?

JAN

jkriege2, 2017-07-11:
About OPAMPs: I wouldn't separate out the chopper-amps ... as far as I know they are (to the outside) like OPAMPs (they have In+, In- and VoltageOut .. possibly+control pins) ... but OTA-amplifiers, or transconductance amplifiers have a current output, not a voltage output ... shouldn't they be separated out?

SchrodingersGat, 2017-07-12:
@poeschlr I have applied your suggestions to the table, thanks :)

@jkriege2  I have added `digital_potentiometer.lib` :) I think `driver_motor` contains standalone motor controller ICs, while `driver_gate` contains things like half/full-bridge drivers etc (they're used for more than just motors)

SchrodingersGat, 2017-07-12:
> @jkriege2 what about timers like 8253, which are specifically designed as µC-periphery ... do they fit in timer.lib?

Yes, I'd expect so.

jkriege2, 2017-07-12:
@SchrodingersGat about drivers: Just starting from the lib-name in `driver_gate` I would expect driver-ICs that are used to drive the gate of a MOSFET, not half or full bridge drivers (although both might share the same functioning principle ...) ...

I scanned a bit the webpages of semiconductor manufacturers:

- http://www.ti.com/lsds/ti/analog/motordrivers/overview.page
- https://www.infineon.com/cms/de/product/power/channel.html?channel=db3a304319c6f18c011a154646852706
- http://www.nxp.com/products/automotive-products/smart-power-drivers:SMART-POWER-DRIVERS
- http://www.onsemi.com/PowerSolutions/taxonomy.do?id=210
- http://www.st.com/en/motor-drivers.html

Most of them separate (at least) between:
1. MOSFET/IGBT drivers
2. Motor drivers/controllers (with sub-cats like stepper, bldc, DC, ...)
3. some also have load/relay drivers

I think we should use the same categories, e.g.
1. `driver_motor` (for all motor-related products)
2. `driver_gate` (for ICs that are supposed to drive high-power MOSFETs/IGBTs)
3. `driver_load_other` or `driver_load` for all others
4. maybe we could think about having `motor_controller` for motor-controll ICs like stepper-controllers or BLDC-controllers that do not necessarily contain drivers for the motor.

jkriege2, 2017-07-12:
Also I just stumbled about MCU-companion chips like RESET-ICs and voltage supervisors ... where to put those? `periphery`?

What about the IO-expanders and other periphery that does not fit in any existing lib (yet)?

JAN

SchrodingersGat, 2017-07-12:
Reset ICs should go in `power_supervisor.lib` - this lines up with how they are categorized on [digikey](https://www.digikey.com/products/en/integrated-circuits-ics/pmic-supervisors/691).

I/O expanders (etc) are yet to be allocated. As no better name has been suggested, perhaps a series of `peripheral_` libraries is needed.

jkriege2, 2017-07-12:
+1 on both ;-)

jkriege2, 2017-07-12:
- if IO-expanders are the only ones left ... maybe `interface_parallel.lib` would also be an option? + then we don't have to open up another "tree"
- We could still have a lib `periphery.lib` for everything that does not fit in any other category ...
- Also I think we don't have any place for I2C transceivers/drivers/hubs and SPI switches/transceivers/... maybe `interface_spi.lib` + `interface_i2c.lib`

gauravjuvekar, 2017-07-12:
most of `ftdi` will also go to `interface_usb` or `interface_rs232`

poeschlr, 2017-07-12:
`opto_isolator.lib` might not be the best name. (And opto maybe not the best category)
Opto is more the how is an isolator implemented than a functional description.

Maybe better would be `isolator_opto` and further categories for each type of isolator 'isolator_induction' 'isolator_capacitiv'.
But i don't like categorizing by internal technology. Yes inductive isolators tend to be used for signals with higher frequencies but there might be opto-isolators out there that can handle similar frequencies to cheap induction based isolators. (or there are specialized induction based isolators for low frequency/ low power
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

Thread 1406 (2017-07-10):

Hirose connectors

G33KatWork, 2017-07-10:
Hi,

Commit cf9ec51825a0a36b1d2495a3f25fd717bfe45081 added a bunch of Hirose connectors which I use all the time on my PCBs. And I just wondered where the 3d models that showed up by default in the past had gone.
I found that 13e8762dd361e8cb05795e032a171ca54e7a090c reverted a whole lot of stuff including the addition of the Hirose connectors in the earlier commit. Was this intended or by mistake? Because I'd really like to see these models to be readded so that I don't have to create my own library with all the models in them.

Thanks,
- Andy

evanshultz, 2017-07-10:
Hi Andy,

I think you will want connectors at https://github.com/KiCad/Connectors_Hirose.pretty. This library was added to break out the footprints since we had so many connections. Sorry for any confusion.

You'll need to update your fp-lib-table file (https://github.com/KiCad/kicad-library/tree/master/template) to see the new libraries in KiCad. I believe I've seen an automated utility to do it some time in the past, but I can't find it now. If you go to Preferences > Footprint Libraries Manager in Pcbnew you will see the path at the top of the dialog.

Please reply if you run into more trouble!

G33KatWork, 2017-07-10:
Thanks for your answer. I have the footprints, the 3d shapes are what is missing.
The footprints from https://github.com/KiCad/Connectors_Hirose.pretty even reference the old 3d shapes:

https://github.com/KiCad/Connectors_Hirose.pretty/blob/master/Hirose_DF13-02P-1.25DSA_02x1.25mm_Straight.kicad_mod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

evanshultz, 2017-07-10:
Andy, my mistake. I didn't catch that you meant the 3D models.

@SchrodingersGat It looks like you merged. Can you take a look?

SchrodingersGat, 2017-07-10:
@G33KatWork you have stumbled upon my shame.

I accidentally merged my personal libraries with the official KiCad libraries. I think perhaps you have been using the 3D models from those? The Hirose 3D models are not part of the official KiCad library dataset, due to licensing issues (all models must be submitted by the creator of the model).

If you are willing to develop these models for us? :) We have a powerful set of scripting tools for generating 3D models. Have a look at the examples in the [packages3d repo](https://github.com/kicad/packages3d)

G33KatWork, 2017-07-11:
Are you sure we are talking about the same commit? There is a pull-request which deliberately added them: https://github.com/KiCad/kicad-library/pull/249, so at least the addition of the Hirose connectors don't look like an accident to me.

No offense, I just want to be sure that we are really talking about the same thing before I maybe try (no real experience in MCAD) to model them by myself.

SchrodingersGat, 2017-07-11:
@G33KatWork you're right. It appears that the other commit erroneously removed these. Let me look into it.

SchrodingersGat, 2017-07-11:
I have just submitted a PR to re-add these shapes - https://github.com/KiCad/kicad-library/pull/1407

Closed 2017-10-23.

Thread 1411 (2017-07-12):

RFC - Legacy 3D models

SchrodingersGat, 2017-07-12:
I think we should mark the [current packages3d] directory as legacy, and stop accepting PRs here. We are duplicating efforts which could be better spent improving the quality of the new 3D models repository.

With the effort to refresh and reorganise the symbols repository, this will eventually be separated from the 3D models in any case.

Any objections?

poeschlr, 2017-07-12:
The main question is, what do we do with models that currently only exist in the legacy lib.
We have two options:
- reduce the number of available 3d models but keep the new repo clean. (only step/wrl pairs, correctly scaled)
- relocate the files missing files to the new repo. (the new repo would end up beeing not as clean as it currently is.)

I'm a bit uncomfortable reducing functionality for users.

Maybe we should check how much files are affected and make a call as soon as we know the scope.

Shackmeister, 2017-07-12:
I totally vote for option to,  I think the new repo is pretty solid by now.

poeschlr, 2017-07-12:
Another question: Do we overstretch ourselves by the large symbol lib reorg and the 3d files reorg?

SchrodingersGat, 2017-07-12:
We should firstly assess scope of changes. My thinking would be to leave the current (legacy) 3D models untouched - users who are using them "as is" can continue to do so but new models will not be added.

Any new models and improvements will only be made to the new improved repository.

> Another question: Do we overstretch ourselves by the large symbol lib reorg and the 3d files reorg?

No - one thing at a time. However locking the legacy 3D models at their current state requires no extra work - and reduces the work that 3D model contributors have to do.

poeschlr, 2017-07-13:
What if we add models here until the 4.0.7 release is out? (This way 4.0.7 still gets a few more models and we have a clear date where we stop adding stuff to the legacy lib)

Shackmeister, 2017-07-14:
If the new repo isnt gonna be used before 5.0 I think it makes perfect sense to keep both synced until then. Another thing I would like to discuss here before writing the devs,  (or perhaps someone a bit more recognised should write) is how the 3D file endings should be handled in 5.0 footprints,  since step and iges is now supported.. For most/all 3D models in the official repo,  the WRL model is generated from the step or same source as the step,  meaning the auracy should be as good as using steps which are internally converter. So the question is how the different file types,  should be handled in kicad/the libraries. They both have advantages so being able to seemlesly switch between them would be very much in favor. A few ideas so far on how it could work.
1. the Stepup approach: having KiCad mainly use the WRL models for the 3D viewer, but search for a .Step with the same name when exporting step. Models.

2. Removing file endings in the libraries: my idea here would be to have a setting in the viewer where you could set you prefered priority of file types ie. Wrl, step, iges. From here the viewer should try and find the file available.

3. Adding both a step model and a Wrl model to the footprint. Again from here have some filtering in the viewer/exporter to select the appropriate type.

I might be the only one considering this a potential Issue. But I've see n quite a few people trying to add step files to the library,  and it would be a shame to have fight a fight between Mcad and raytracing people since the library beautifully supports both :) maybe @easyw have something to add here

SchrodingersGat, 2017-07-14:
@Shackmeister this is a very good question and I have been giving this issue some thought. I think the way that the @easyw StepUp plugin has handled this issue for a long time was a very clever solution, and **maybe** it is the way to go for KiCad.

I imagine an option in the 3D model export e.g. "Substitute component models with STEP files". Then KiCad searches for step files in the same path. (Same as StepUp)

This would be a change that would need to happen to KiCad, and I imagine it would be well received (if it was very easy to use, and not "hacky").

easyw, 2017-07-14:
I wouldn't consider useful to add both STEP and WRL to a fp.
Footprints already accept more than one 3D model, letting the user to add i.e. mechanical parts or whatever...
Having configured both type of the same symbol would be a bit confusing and would need to have also an option to hide one of the two models... and wouldn't be
back compatibile.
The simplest solution is a search for same name but extension STEP (STP) in the same path. Still this solution can give some troubles to users if the library was not built in the correct way (i.e. some users own custom parts).
Anyway this solution is the simplest and can be adopted if clearly stated in the manual and menus.
Maurice

SchrodingersGat, 2017-07-14:
If only we knew the creator of the StepUp plugin - they would be the perfect candidate to implement this feature in KiCad itself!

Shackmeister, 2017-07-14:
Perhaps @poeschlr and @hackscribble has something to chime in with?
I agree the stepup approach is probably the easiest and cleanest to implement. Also I think the packages3d readme should be changed from "wrl or step models accepted" to "wrl and step pairs accepted"

easyw, 2017-07-14:
> Also I think the packages3d readme should be changed from "wrl or step models accepted" to "wrl and step pairs accepted"

it should be already stated that

> This repository contains 3D models for rendering and MCAD integration, for use with KiCAD EDA software. The model needs a mechanical model source (a manually-modelled or script-generated file); its WRL counterpart file must be obtained as a conversion from the MCAD model

I cannot find the phrase _"wrl or step models accepted"_ in the readme.md

Shackmeister, 2017-07-18:
@easyw my bad. that has already been changed :)

hackscribble, 2017-07-19:
About the first question - to freeze the legacy directory or not.

A few days ago, I compared the list of all `wrl` files in the legacy folder with the `wrl` files in the new repo.  There were about 1,600 models "missing" from the new repo.  There were some big clumps (as well as many individual items) - mainly THT resistors, capacitors, inductors and LEDs.

I would prefer to keep the new repo clean and not copy these old models over.  So maybe the mitigation is around documenting clearly (a) how to download and use the new models and (b) how to search for and "cherry pick" old models from the legacy folder?

Shackmeister, 2017-07-19:
@hackscribble I have picked up the work on the THT capacitors again so it can hopefully be added to the new repo. Could you perhaps modify the script to work the opposite way around, so checking if the WRL file is mentioned in any footprint. Im suspicius quite a few wrl models are not being used anymore

hackscribble, 2017-07-19:
@Shackmeister I've got a script that does that already.  I will clone fresh versions of the footprint repos and library and run it again.

Shackmeister, 2017-07-24:
@hackscribble could you please add the folder/library to the modelname in unused.txt? This way it's easier to find and manage the model

hackscribble, 2017-07-24:
Folder names added ...

[unused2.txt](https://github.com/KiCad/kicad-library/files/1169205/unused2.txt)

Shackmeister, 2017-07-24:
I was actually thinking the .3dshapes folder :)

hackscribble, 2017-07-24:
Doh :cry:

Those are the `.3dshapes` folders - I typed `.pretty` into the format string by mistake I'll fix the script.

poeschlr, 2017-07-26:
I don't think it is a good idea to not ship new models. Especially because there is no 3d shapes downloader in stable and the users get the footprints with 1:1 scaling via the github plugin. If the footprints would be installed locally i would agree but because a standard installation uses the github plugin we need to give users updated 3d models. (or we need to freeze the footprints as well)

Shackmeister, 2017-08-01:
@hackscribble can you please rerun the script to check differences in the repos?

hackscribble, 2017-08-01:
@Shackmeister you mean comparing the lists of wrl files in `kicad-library` and `packages3d`? That was command line stuff, not the script.  I'll try to recreate it and post the results.

hackscribble, 2017-08-01:
3,311 `wrl` files in `kicad-library`.  1,969 in `packages3D`.

Biggest groups of missing files are (in alphabetical order) crystals, THT diodes, DIP packages, THT inductors, THT LEDs, potentiometers, THT resistors, socket strips and certain TO packages.

Here is a patch file (`-` is missing in `packages3D`).

[comparison.txt](https://github.com/KiCad/kicad-library/files/1191921/comparison.txt)

SchrodingersGat, 2017-08-01:
All of those sound like good candidates for scripting!

@jkriege2 IIRC you scripted a lot of the existing .wrl models, yes? It would be worth reassessing these scripts to see if we can get MCAD models out of them.

Shackmeister, 2017-08-02:
@hackscribble thanks!
@SchrodingersGat thats pretty much what I have been working on for the last couple of weeks. most of the THT capacitors have been based on Jans models. I found it easier to port the models over to the CQ framework where all the export tools (WRL properties, scaling etc) has already been made by @easyw. Since all the footprint models was scripted I could also adapt Jans script to output the parameters for CQ which made everything soooo much faster and cleaner. once I finish the SMD LED's Ill probably make port the THT resistors and THT LED's

SchrodingersGat, 2017-08-02:
Fantastic :)

Shackmeister, 2017-11-01:
Hi guys a bug has been reported regarding the step substitute for WRL. Wayne says the release is coming quite soon so it should get started really soon to make it into V5.
https://bugs.launchpad.net/kicad/+bug/1710796
Would Cirilo be the main guy to ask if he could be willing to add this feature?
I think it's pretty important to get this in to avoid a war between wrl and step as the default type, since the current best way is to use a text editor to change it . (or use KSU, but the internal should be supported as well )

Closed 2017-12-03.

Thread 1415 (2017-07-13):

Questions about the process for migrating the symbol lib.

poeschlr, 2017-07-13:
This thread should manage the question of how the migration process should be handled.

We need to know how long we can discus, when we stop accepting new pull requests on the legacy lib and when we migrate what lib. (We also need someone responsible for each lib i think.)

0. )How long do we have until v5? Will the first release already be a stable release or is it more like a beta release? (can the testing phase be after the release or should it be before that?)

1. ) will the lib for v5 live in a separate repo or will it be a separate branch on the current repo?
(Or to we simply tag the lib as 4.0.7 and start the migration process?)

2. ) how much support do we give to 4.x series libs?
I would say we should allow bug fixes. (not klc fixes, Example: fix wrong pin number for a pin)

3. ) When do we stop accepting pull requests on this lib? When do we stop merging? What should happen to open pull requests?
I would say the latest when we stop merging is when the first lib gets migrated. (Would mean we have some time when no contributions are accepted aside from help by the migration process. I hope our contributors are understanding in this regard.)
I would guess we will try to merge as many of the currently open requests as possible but when the time comes we will close all pull requests on the legacy lib with a note that no new features are accepted in the legacy lib.

4. ) How do we communicate what libs are already migrated, who is responsible, ...
One option would be a google doc. Anything where multiple people have write access would do i think.
Another option would be to have a separate source branch where we delete symbols that have already been migrated. (libs are deleted once they are empty.)

5. ) Do we care that a lot of symbols break klc?
No i think we should move them as they are. Fixing klc errors should be done separately. (otherwise it gets confusing.)

6. ) When do we accept pull requests on the new lib?
I would suggest merging only as soon as all libs are migrated. Possibly when the most active libs are migrated. Or when target lib is not expected to get touched any more by the migration process. (The first option is the easiest for us.)
I would just tell everyone who opens a new pull request that we are in the middle of migrating and that their PR will be looked at once the migration has finished. (Again, hopefully our contributors are understanding in this regard.)

7. ) testing. how long?
No matter what we do there will be some errors. So we need some time after the last symbol is migrated until v5 comes out. I guess we could ask our contributors and the guys over at the forum to help us there.
I would reserve at least 3 weeks here.

gauravjuvekar, 2017-07-13:
Noob question. Will the new lib be "usable" in the current stable - i.e. if I want to add a new component, will there always be a path from the official libs by which that component can be used in the current stable release.

poeschlr, 2017-07-13:
As far as i know the library format does not change from 4.x to 5.x.
But the library structure will be vastly different.

In short: iff i am right that the lib format does not change, 4.x users can open 5.x libs. But they need to put in extra work because we will not publish this new lib structure for 4.x (too much change. People do not expect such a change in a minor release.)

gauravjuvekar, 2017-07-13:
Isn't the S-expr format new in v5? It's in the roadmap http://docs.kicad-pcb.org/doxygen/v5_road_map.html#v5_sch_sexpr

SchrodingersGat, 2017-07-14:
@gauravjuvekar I'm unsure as to how much of the new schematic format will make it into v5. AFAIK it is only the "symbol table" which improves library loading but not the new s-expr format (.sweet).

SchrodingersGat, 2017-07-14:
@poeschlr - nice zero-offset indexing for your points ;)

> 0. How long do we have until v5? Will the first release already be a stable release or is it more like a beta release? (can the testing phase be after the release or should it be before that?)

Wayne keeps saying "End of Summer" (by which he means northern hemisphere summer, I assume).

> 1. Will the lib for v5 live in a separate repo or will it be a separate branch on the current repo?
> (Or to we simply tag the lib as 4.0.7 and start the migration process?)

Good question. This is a question for the package maintainers, I will ask over on the developers mailing list. This is a great first step into the master plan for library management improvements. I would think we should mark `kicad-library` as legacy and start `kicad-symbols` (and remove the 3d-packages)

> 2. How much support do we give to 4.x series libs?
> I would say we should allow bug fixes. (not klc fixes, Example: fix wrong pin number for a pin)

We would continue support until release of v5, assuming points 0 and 1 above are covered.

> 3. When do we stop accepting pull requests on this lib? When do we stop merging? What should happen to open pull requests?
> I would say the latest when we stop merging is when the first lib gets migrated. (Would mean we have some time when no contributions are accepted aside from help by the migration process. I hope our contributors are understanding in this regard.)
> I would guess we will try to merge as many of the currently open requests as possible but when the time comes we will close all pull requests on the legacy lib with a note that no new features are accepted in the legacy lib.

There will have to be a period of side-by-side development, where 4.x improvements are also merged into the new libraries.
At the transition point where we discontinue support for old libraries, we will have to mark each outstanding PR as closed but redirect the contributor to the new libraries.

> 4.  How do we communicate what libs are already migrated, who is responsible, ...
> One option would be a google doc. Anything where multiple people have write access would do i think.
> Another option would be to have a separate source branch where we delete symbols that have already been migrated. (libs are deleted once they are empty.)

Either we have a new repo or a new branch. In either case, we could keep a spreadsheet in the repo itself, which librarians can update as the transitions are made.

> 5. Do we care that a lot of symbols break klc?
> No i think we should move them as they are. Fixing klc errors should be done separately. (otherwise it gets confusing.)

No, quality improvements are a separate issue.

> 6. When do we accept pull requests on the new lib?
> I would suggest merging only as soon as all libs are migrated. Possibly when the most active libs are migrated. Or when target lib is not expected to get touched any more by the migration process. (The first option is the easiest for us.)
> I would just tell everyone who opens a new pull request that we are in the middle of migrating and that their PR will be looked at once the migration has finished. (Again, hopefully our contributors are understanding in this regard.)

We will have to decide a "close enough is good enough" point after which it is open for business.

> 7. testing. how long?
> No matter what we do there will be some errors. So we need some time after the last symbol is migrated until v5 comes out. I guess we could ask our contributors and the guys over at the forum to help us there.
> I would reserve at least 3 weeks here.

The more help we can get the better. As most of this work is recategorization, *hopefully* there is not too much burden.

SchrodingersGat, 2017-07-14:
I think the point at which we stop accepting PRs for old symbols is also the point at which we discontinue support for old 3D models. This means we duplicate 3D model pull requests until then.

bobc, 2017-07-14:
> )How long do we have until v5? Will the first release already be a stable release or is it more like a beta release? (can the testing phase be after the release or should it be before that?)

The release process for v4 took from about March (code freeze) to 4.0.0 RC1 in September 2015 and final 4.0.0 released in December 2015, so I would expect similar for v5. Wayne mooted the idea of a v5 freeze around March 2017 I think, but that seems to have slipped indefinitely.

If v5 was frozen today, I would expect to see 5.0.0 RC1 in Jan 2018.

gauravjuvekar, 2017-07-14:
> The more help we can get the better. As most of this work is recategorization, hopefully there is not too much burden

Assuming that we can use https://github.com/KiCad/kicad-library-utils/blob/master/schlib/move_part.py for the actual work, is it possible to use it in a batch-process mode (or just a shell script that does the job). We can just create a google spreadsheet with `old_lib`, `part_name`, `new_lib` columns, and prefill the old columns.
Then we can just ask people to fill the `new_lib` column, and once everything looks good, run the `move_part.py` script on the columns. This way, we can get the help of even the most non-technical people - it's just filling a spreadsheet - anyone could help.

SchrodingersGat, 2017-07-15:
Here's an idea:

The kicad-library-utils scripts currently have a "move part" functionality, we can extend this to do most of the work for us.

Create a script which has a set of patterns, which define which parts need to move to which new libraries.

e.g.

````
{
'microchip_pic10mcu:*' : 'mcu_microchip_pic10',  # Move entire library
'sensors:mcp9700*' : 'sensor_temperature',  # Move all MCP9700 parts to the sensor_temperature library
}

The filters can be as loose or as tight as they need to be.

Any parts that are not matched by the filters are printed at the end of the script (so we know which ones we have missed) - these can be then added to the patterns.

The script can be updated in conjunction with any PRs to the current repository. This way, when it comes time to change, we can just run the script! We can to trial runs as we go but there's now no need to make continuous updates.

I have a barebones version of this underway, I'll post when It's workable (the patterns will still need to be filled out).

lorem-ipsum, 2017-08-17:
As someone who is just adding PRs to the repo: Please keep everything in the same repository. Moving to a new one will make all issues / PRs useless without any benefit.

A new branch should be perfectly fine. You can first do the migration in a separate branch and merge it into master when everything is done. Right before that you can also spit a new branch for maintenance of the 4.x series.

SchrodingersGat, 2017-12-11:
Closing this issue as the transfer is now under way

Closed 2017-12-11.

Thread 1422 (2017-07-19):

KLC - Pad-to-silk clearance isn't specified

evanshultz, 2017-07-19:
I was thinking about this on a recent PR of mine, and also saw this topic pop up at https://github.com/KiCad/RF_Modules.pretty/pull/22. It seems we don't specify this distance. KLC 7.3.ii only mentions silk can't overlap, but it doesn't give a minimum or recommended distance.

I typically do about what Rene wrote and use ~0.2mm since I didn't find a specific number in KLC.

I think this should be added to KLC. While I don't see it in any IPC docs I can find online, page 13 of https://www.cskl.de/fileadmin/downloads/PCBLIBRARIES/Documentation/What-is-New-in-IPC-7351C_.pdf mentions that the spacing should be equal to the line width. For KiCad, that would typically be 0.12mm but we do allow variation in silk line width for some special cases.

I think clause 7.3.ii of KLC could be amended to `Silkscreen to pad clearance is equal to the silkscreen line width and may not be placed over pads.`. Even though mentioning clearance should be clear that they cannot overlap, it's probably best to explicitly state that.

Agreed? Add this to KLC? Any other comments?

suzizecat, 2017-07-19:
` Silkscreen to pad clearance is equal to the silkscreen line width and may not be placed over pads.` I would rather write
` Silkscreen to pad clearance is at least equal to the silkscreen line width and may not be placed over pads.`

Since having a 1.2mm space could be bothersome (imperial-unit based FP, 1mm grid FP and so on)

evanshultz, 2017-07-20:
@SchrodingersGat
I assume you can take a look at this and update KLC?

If/when you do, two other things:
1. 3.3 and 3.7 are still there and we discussed they're redundant.
1. 1.8 uses bold and italic to describe the two different line endings.

Shackmeister, 2017-07-23:
@evanshultz shouldn't it be 0.2mm since that is the default pad clearance?

evanshultz, 2017-07-23:
@Shackmeister
You mean the pad-to-pad clearance? If so, then I haven't seen there's any correlation. Printing silk has a variety of methods that can give a variety of results, but I know it to be unrelated to the process of etching away copper.

Shackmeister, 2017-07-23:
@evanshultz it was the soldermask clearance I meant

SchrodingersGat, 2017-07-23:
@evanshultz thanks for pointing that out, I have fixed those KLC issues.

@Shackmeister KLC 7.3/ii

```
Silkscreen clearance:
a. Silkscreen must not be placed over pads
b. Silkscreen must have at least 0.2mm clearance around pads
```

poeschlr, 2017-08-23:
@evanshultz is this resolved to your satisfaction?

suzizecat, 2017-08-24:
> b. Silkscreen must have at least 0.2mm clearance around pads

Since this 0.2mm comes from the default pad to soldermask clearance, what should be done when the footprint specify a non-standard pad to mask clearance (like in KiCAD/Housings_LGA.pretty#6 )?

IMHO, this should be specified by also giving a silkscreen to soldermask clearance (or just manage specifically in those case since that's not very common)

poeschlr, 2017-08-24:
I use 0.2mm for silk to copper because this is what the fab i mostly use recommends. It can have solder mask. The minimum solder mask clearance is much smaller. (50µm)
I assume this is similar for other fabs. (Much larger clearance between copper and silk than for the soldermask.)

suzizecat, 2017-08-24:
@poeschlr If you are replying to me, I think there is a misunderstanding... AFAIK, you shouldn't have silkscreen on copper, so if a pad have an extended soldermask clearance, which may be over 0.2mm, you should put away the silkscreen to avoid overlapping.
In this case, how should it be handled ?

poeschlr, 2017-08-24:
Ok then how about:
Silkscreen has a minimum copper to silk clearance of 0.2mm. In addition it is not allowed to overlap with masked areas. (= areas that do not have solder resist on the final pcb)

suzizecat, 2017-08-24:
Well, it's seems fine, but this imply that there may be no clearance at  all between the silkscreen and the copper (without overlapping, just 0 mm). I don't know if this is fine, but if it is, i'm ok with it.
(Sorry to quibble about that but, hey, gotta be precise 😉 )

evanshultz, 2017-08-25:
@SchrodingersGat Can you update the [KLC page](https://github.com/KiCad/kicad-library/wiki/Kicad-Library-Convention) again? 3.3 has a typo. It says "Manufacturer Part Number (MPN) should be used given preference" but we need to remove either "used" or "given preference".

@suzizecat Are you only asking that silkscreen not be allowed in areas where there is no mask (or course exceptions may apply)? 7.3 clearly says silkscreen must avoid copper by 0.2mm, so that shouldn't be in question.

suzizecat, 2017-08-25:
@evanshultz The 7.3 don't say explicitly that silkscreen must avoid _copper_ (it's about _pad_ that is, for me, a little bit different...) so, when  you got an extended clearance on the pad. IMO, it may be confusing.

poeschlr, 2017-08-25:
I would make it in this way for your footprint. I can't think of a way to clearly specify this in the KLC. But i think some special cases will always need a bit of discussion.

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

suzizecat, 2017-08-25:
Ok but, do we agree that there is a 0mm clearance between the silkscreen (which i believe is the green line) and the masked area (so, potentially the copper) ?

In this case, the extended clearance specify 0.2mm but what could have happened if it was more than 0.2mm ?

poeschlr, 2017-08-25:
My thing is not drawn to scale! And 0.2 is the minimum clearance. You can increase it if you think it is necessary.

suzizecat, 2017-08-25:
The problem doesn't come from the scale, i'm writing about the fact that the silkscreen touch the mask limits.
But, since 0.2mm is specified as a minimum clearance and if it's clearly stated that the silkscreen must not overlap any copper, it  solves my concern.

SchrodingersGat, 2017-09-06:
I have updated 3.3 and 7.3 in the [KLC](https://github.com/KiCad/kicad-library/wiki/Kicad-Library-Convention)

Closed 2017-09-06.

Thread 1429 (2017-07-20):

Wrong pin numbering - *78M05_TO252

bumcyk, 2017-07-20:
Pin numbers are inproperly assigned for the following parts:
- KA78M05_TO252
- LM78M05_TO252
- MC78M05_TO252

Function - current pin number - correct pin number
Input - assigned pin 3 - should be pin 1
Ground - assigned pin 1 - should be pin 2
Output - assigned pin 2 - should be pin 3

The part is incorrectly bound with LM1117-x, where the pin numbering is correct.

Sources:
http://www.ti.com/lit/ds/symlink/lm341.pdf
http://www.farnell.com/datasheets/1855685.pdf

evanshultz, 2017-07-20:
@bumcyk
Thanks for pointing this out. Yes, indeed, this is an error. I'm quite familiar with both parts. Generic 78xx in DPAK have the same pinout as in TO220.

Are you up for making this change and generating a PR to merge it into the library?

bumcyk, 2017-07-20:
@evanshultz
Sure, here you go. I'm new to Github and I don't know yet how to publish changes, so I attach both modified library and the diff file.
[regul.txt](https://github.com/KiCad/kicad-library/files/1163034/regul.txt)
[regul.zip](https://github.com/KiCad/kicad-library/files/1163035/regul.zip)

evanshultz, 2017-07-20:
I had forgotten that the regulator library has been updated recently by @jkriege2. If you're looking at the library that came with KiCad 4.0.6 you may see something different than in the latest library hosted here.

Anyway... all the `*M05_TO252` parts are an ALIAS of `NCP1117-12_TO252`.

[NCP1117 datasheet](https://www.onsemi.com/pub/Collateral/NCP1117-D.PDF):
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

[MC78Mxx datasheet](https://www.onsemi.com/pub/Collateral/MC78M00-D.PDF):
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

So yep, definitely a different pinout.

Here's the schematic symbol:
```
# NCP1117-12_TO252
#
DEF NCP1117-12_TO252 U 0 10 Y Y 1 F N
F0 "U" -150 125 50 H V C CNN
F1 "NCP1117-12_TO252" 0 125 50 H V L CNN
F2 "TO_SOT_Packages_SMD:TO-252-2" 0 225 50 H I C CNN
F3 "" 0 0 50 H I C CNN
ALIAS NCP1117-1.5_TO252 NCP1117-1.8_TO252 NCP1117-1.9_TO252 NCP1117-2.0_TO252 NCP1117-2.5_TO252 NCP1117-2.85_TO252 NCP1117-3.3_TO252 NCP1117-5.0_TO252 LF15_TO252 LF18_TO252 LF25_TO252 LF33_TO252 LF50_TO252 LF60_TO252 LF80_TO252 LF85_TO252 LF120_TO252 LP2950-3.0_TO252 LP2950-3.3_TO252 LP2950-5.0_TO252 MC78M05_TO252 LM78M05_TO252 KA78M05_TO252 LF47_TO252 LF90_TO252
$FPLIST
 TO?252*
$ENDFPLIST
DRAW
S -200 75 200 -200 0 1 10 f
X GND 1 0 -300 100 U 50 50 1 1 W
X VO 2 300 0 100 L 50 50 1 1 w
X VI 3 -300 0 100 R 50 50 1 1 W
ENDDRAW
ENDDEF
#
```

The 78M05 parts should be an ALIAS of `LM7805_TO220`.

And lastly, here's the footprint (which is fine for both parts):
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

evanshultz, 2017-07-20:
Thanks @bumcyk. I've submitted a PR for this.

Git allows you to fork (copy) a repository (in this case, the schematic symbol library), make changes, and then submit a pull request to merge your changes into the original repository. That's the workflow we use rather than emailing libraries. If you're interested in making more fixes or submitting new parts please ask away. We depend a lot on community support.

At any rate, thanks again for catching this and letting us know!

evanshultz, 2017-07-25:
Closing since the PR to fix it was merged.

Closed 2017-08-05.

Thread 1438 (2017-07-23):

Pinhead 3D model not matching footprint

antoniovazquezblanco, 2017-07-23:
The 3D viewer is not placing my 1x6 pinhead properly.

I am currently using KiCAD 4.0.6

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

poeschlr, 2017-07-23:
3d models are not updated automatically. If you use the github plugin for your footprint libs, the footprint is updated everytime kicad needs a footprint.
This means if we update anything in the connection between 3d models and footprints, users get incompatible libs that require manual update. (updated footprints but the old 3d model)

Yes this is a bad situation. We library managers are not happy about it. We do not like that the default kicad installation uses the github plugin. This setup should only be used by users who know what the downsides of it are.
To get a local footprint lib either use the [footprint lib download script](https://github.com/KiCad/kicad-library-utils/blob/master/download_pretty_libs.py) found in the kicad-library-utils repo or use the library wizard as described in this [tutorial](https://github.com/bobc/kicad-doc/wiki/How-to-install-local-Footprint-libraries) by @bobc.
This will not solve your current problem, but it might be a good idea anyways. (If you use a local setup you are in control when you get new footprints.)

To solve your current problem, try to download the current 3d models from this repo. Or from or new [packages3d repo](https://github.com/KiCad/packages3D). (The later has fewer models because it only includes models for which we also have a step model)
I would suggest you clone the repo into your user directory and set the path variable KISYS3DMOD to point to the correct location. (setting path variables is done in the kicad main window->configure paths)
This way updating 3d libs can be done with a simple `git pull`

If the problem still exists after you download the newest 3d models then something is really wrong.

There could also be the opposite problem. You could have 3d models that are too new for what is stored in your pcb_new file. (footprints are stored in the header of the pcb_new file after importing the netlist.)
To check if this is the case, simply open the footprint with the footprint editor and check the 3d view there. (Do not open the footprint editor from within pcb_new right click menu. Open the editor from the main window and load the footprint via the footprint browser.)
If this is the case, you can solve it by updating the footprint on your board. For that open the footprint properties and press the change footprint button to open the change footprint dialog.
In this dialog you have radial boxes to select what to exchange. Either choose all footprints or footprints with the same footprint name.
Be aware that updating footprints resets the position of the reference and value text fields to what is defined in the library.

antoniovazquezblanco, 2017-07-23:
Using my local repositories for the 3D models solved the issue.

Thank you very much!

poeschlr, 2017-07-23:
@SchrodingersGat We really should make sure that 4.0.7 gets the new 3d models. Otherwise this problem will persist. (Or get even worse for future 4.x releases if more of them are planned until 5.x)

pointhi, 2017-07-23:
@SchrodingersGat does someone know the current state of the symbol schematic liibrary with 4.0.7? The last time I tried a new installation, half of them were not enabled by default. (for example switches.lib)

Shackmeister, 2017-07-23:
@poeschlr shouldn't we also make sure all footprints has KISYS3DMOD added so its possible to use another path?

SchrodingersGat, 2017-07-23:
4.0.7 has been marked as a 'minor update' that won't feature a new release of the libs. There's not enough time to switch to the new 3D models repo. We should certainly make this a priority for next release.

Shackmeister, 2017-07-23:
@SchrodingersGat kicad-library should be up to date?

poeschlr, 2017-07-24:
@SchrodingersGat  because a lot of 3d models got updated with the 1:1 scaling we should definetly supply the new 3d models. (I assume the footprints are still supplied with the github plugin.)
The easiest way to achieve this would be to tag the current master and ship not only the new 3d models but also th new libs.

poeschlr, 2017-07-24:
@Shackmeister the KISYS3DMOD requirement is already part of the KLC. So yes it would be nice to have all footprints use it.
Not sure if it is really a problem. Kicad might interpret it as a relative path. (relative to KISYS3DMOD)

Closed 2017-07-23.

Thread 1443 (2017-07-25):

How should keepout areas be shown in footprints

poeschlr, 2017-07-25:
Keepout zones can not be defined in footprints. How should we show that a footprint has an area where no copper should be placed.

I have seen the following options:
 1. dwgs.user layer for the zone outline plus text on cmts,user (Example: https://github.com/KiCad/RF_Modules.pretty/pull/16)
 1. everything on the fab layer. (Example: https://github.com/KiCad/Connectors_Hirose.pretty/pull/17)

We should fix it in the klc such that all footprints follow the same rule and the user of our libraries knows what to expect.

I vote for option 1. (Fab layer is for the documentation. If we put stuff like keepout areas on this layer, it gets very crowded.)

hackscribble, 2017-07-25:
+1 for option 1

Would we also want to specify the visual style of the keepout?  For example, one of the following ...

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

evanshultz, 2017-07-25:
I like option 1a: hatched lines on Dwgs.User.

poeschlr, 2017-07-25:
I would say a or b plus maybe a text on comments that specifies what the drawing means.
Some footprints say no copper, others might specify no vias (no bare copper), others might specify no tracks except ground, ...
Or should we define different styles for different meanings?

hackscribble, 2017-07-26:
My preference would be for just one style with the meaning explained in comments.

This example is hatched on Dwgs.User and text on Cmts.User ...

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

SchrodingersGat, 2017-07-26:
Option a) works best IMO, especially for irregular regions. Is there any reason that the explanatory text (on User.Comments) should not be overlaid on the same space? It makes it a bit harder to read but it's obvious in high-contrast layer mode

hackscribble, 2017-07-26:
This is with high-contrast button enabled (4.0.7 on Ubuntu in OpenGL).

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

SchrodingersGat, 2017-07-26:
Are they both on the same layer? Here's what I get, OpenGL on Ubuntu:

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

hackscribble, 2017-07-26:
Mine are definitely on Dwgs and Cmts.  Here is the view in OpenGL without the contrast button enabled.

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

hackscribble, 2017-07-26:
Also, can I check that it is not possible in footprint editor to write directly to either of these layers?  One needs to write onto another layer and then edit the properties (or edit the file) to move the lines and text to the .User layers?

poeschlr, 2017-07-26:
@hackscribble set the active layer different to either commends or drawings while in highcontrast.
@SchrodingersGat set the active layer equal to drawings in the first screenshot and equal to comments in the second.
That's why they look different.

poeschlr, 2017-07-26:
@hackscribble Yes one can not directly draw on these layers. (But this might be something we can request from the developers. Maybe we can even get a dedicated layer in v5?)

SchrodingersGat, 2017-07-26:
@poeschlr I would like to have a working keepout, rather than a layer dedicated to keepout.

This would require that keepouts can be assigned multiple layers, I think. I have a code branch where this is possible (spawned from this discussion) but it requires more work.. Hopefully I get time to work on this pre v5

suzizecat, 2017-07-26:
I would also point out that IMHO it'normal that FP designer can't write on these layers since it's "User" Comment and "User" drawings... There should be something dedicated

poeschlr, 2017-07-26:
If keepout zones can be used in the footprint that would be even better. But if this does not get finished in time, it might be a good idea to include a special graphical layer for keepouts on top and bottom. (Yes dirty workaround but better than nothing.)

suzizecat, 2017-07-26:
> it might be a good idea to include a special graphical layer for keepouts on top and bottom. (Yes dirty workaround but better than nothing.)
Well, in this case, you should add one keepout layer by copper layer...
In example, in RF design you often have to clear copper on all layers (or all layers except the last one)

poeschlr, 2017-07-26:
Lets hope oliver finishes the implementation of keepout support for footprints.

hackscribble, 2017-07-26:
> Lets hope oliver finishes the implementation of keepout support for footprints.

In the meantime, is there still value in adding something to KLC to specify a purely graphical and text note representation?  If we (improperly) use the .User layers, at least it would be easy to trawl all footprints later to identify those that need upgrading to the new implementation.

Or are there relatively few contributions with keep-out zones, so this is not a big issue?

poeschlr, 2017-07-29:
I would at least fix the style we want to use until v5 comes out.

If i read all your posts correctly i think we all agree with version 1a (cross hatched area on drawings layer plus text on comments layer.)

SchrodingersGat, 2017-07-29:
I will update the KLC with such a rule - I'm away until Tuesday so not until then.

SchrodingersGat, 2017-07-31:
I have added this to the KLC, new rule 7.8

poeschlr, 2017-08-04:
Thanks. I assume i can close this now. (If anyone disagrees simply reopen it.)

Closed 2017-08-04.

Thread 1447 (2017-07-26):

RFC Footprint naming convention (originally naming convention for EP size)

poeschlr, 2017-07-26:
It seems the exposed pad is not always the same size for the same package.

Something similar was discussed in an issue over at the dfn qfn repo: https://github.com/KiCad/Housings_DFN_QFN.pretty/issues/24
In the issue we discovered that different manufacturers use different pin and exposed pad sizes.
(I'm not sure we reached a conclusion over there of what the naming convention should be.)

Now there is also a pull request for qfp packages with different exposed pad sizes but same pin sizes. (All by the same manufacturer)
https://github.com/KiCad/Housings_QFP.pretty/pull/17

We should find a naming convention that lets us communicate these differences.

For the qfp pull request i would suggest to include the x and y dimension of the exposed pad.
Example: LQFP-144-1EP4x4mm_20x20mm_Pitch0.5mm

I think this should be fixed and added to the KLC. (This is why i opened the issue here.)

SchrodingersGat, 2017-07-26:
@poeschlr definitely a good idea, although I think the package dimensions should have a higher priority in the name.

[Here](https://www.cskl.de/fileadmin/downloads/PCBLIBRARIES/Documentation/IPC-7351C-Land-Pattern-Naming-Convention_.pdf) is a document that I have been referencing a lot for direction on naming.

Shackmeister, 2017-07-27:
+1 for both
Maybe we should also think about a naming scheme to seperate two similar footprints with different pad shapes (oval and ret)

poeschlr, 2017-08-09:
As far as i understand it oval pads are only used because rounded rect is not yet supported. (IPC specified oval because rounded rect was not supported by all major cad tools back then.)
The current recommendation is to use rounded rect (not sure if it is already in IPC.) It seems that rounded rectangles behave a bit better when reflow soldering. [Source](https://www.pcblibraries.com/forum/rounded-rectangle-pad-shape_topic1462.html) (I seem to remember that i found a better source when i looked for it last time. Can't find it today.)

How should the rounded rects look like?
- Corner Radius = 25% of Pad Width (pad width is the narrowest part of the SMD pad)
- Maximum Radius = 0.25 mm, so regardless of how wide the pad is the corner radius will never exceed 0.25 mm (10 mils)

So it might be a good idea to choose rounded rect for all our footprints as soon as it is available in a stable kicad release. (I don't think it is a good idea to mix oval/rectangular/rounded rect.)

poeschlr, 2017-08-14:
I would really like to get a decision here.
The pdf linked by @SchrodingersGat  might be a really good guide.

For QFN this would mean:
QFN + Pin Qty. + **P**Pitch_Body Length**X**Width**X**Height +**L**Lead Length**X**Width +**T**Thermal Pad Length **X** Width

We use a lot more '-' and '_' in our current naming scheme.
Pin Qty would be: Pin number + '-' + Number exposed pads + 'EP'
Currently we also do not include the height of a package (might be a good idea to add this in future. Only important for correct 3d models. Or is this also important for automatic assembly?)
And we have a different order between body size and pin pitch (We also write pitch instead of only 'p')
Currently we also use lower case x as delimiter for dimensions instead of upper case X

Might i propose:  [] field, {}... part only added if required
{[Manufacturer name]_}[package name]-[pin count]{-[number of ep]EP}_[Lenght]x[Width]x(Height)mm_Pitch[pin pitch]{_L[Lead Length = pin lenght for qfn]_EP[Lenght]x[Width]mm}{_other options like: Handsolder, ...}

I'm a bit unsure about the prefix for Lead Length. We could also use LeadLength and EPsize. Which would go well with the current scheme used for Pitch.

evanshultz, 2017-08-14:
Is package height required? Since it affects the 3D model and would affect constraints if KiCad has a robust constraint system, I agree it's important to support. But not required. Could it be optional (at least for now)?

I think `L` is fine for lead length. Makes sense to me, and that's what used in the doc Oliver linked. Did you find some place where it doesn't work, Rene?

We currently write out `Pitch`, but this doc uses just `P` which is intelligible enough for me. Also, should we make this change it this ought to be able to be scripted fairly easily.

How about combining the count of EP and the dimensions instead of having two separate sections for the exposed pad? Maybe the last section with EP dimensions is included if the part has an exposed pad?

My few comments above would change the format to: `{[Manufacturer name]_}[package name]-[pin count]_[Length]x[Width]{x(Height)}mm_P[pin pitch]{_L[Lead/Pad Length]}{_[EP qty]EP[Length]x[Width]mm}{_[other options like Handsoldering, ThermalVias, etc.]}`

When this is codified, this should be documented somewhere. A lot of discussion has happened in GH comments which isn't included in KLC or any reference.

poeschlr, 2017-08-14:
Renaming footprints will definitely break default footprint assignments. But if we are careful enough we can at least ensure that the footprint filters will still work.

For this reason i designed my syntax with as little changes to the current naming as possible. (The reason why i kept number of ep pins at the beginning and added the dimension to the back.)
I think this is also the reason why oliver requested to move the ep dimension towards the back. (I could be wrong here.)

@jkriege2 what do you think about this?

And i agree it should be documented somewhere. I think the KLC might be a good place for a short description plus more details in the FAQ.
If we have a good naming syntax creating footprint filters will be a lot easier.

poeschlr, 2017-08-21:
Another addition:
Differently sized mask cutouts. (Used for parts that have a smaller pad on the component than recommended copper pad size. This is mostly done for thermal conductivity. Example [TI bq76pl536](http://www.ti.com/lit/ds/symlink/bq76pl536a.pdf)

Suggestion by @evanshultz in pull request https://github.com/KiCad/Housings_QFP.pretty/pull/22#issuecomment-323745215: `_MaskXXxYYmm` Where XX and YY are the size of the resulting cutout.
`{[Manufacturer name]_}[package name]-[pin count]{-[number of ep]EP}_[Lenght]x[Width]x(Height)mm_Pitch[pin pitch]{_L[Lead Length]mm_EP[Lenght]x[Width]mm_Mask[Lenght]x[Width]mm}{_other options like: Handsolder, Thermal via, ...}`

We might also want to fix how other options are named and what each of this options mean.

---

I think for the KLC i would make it quite simple. (And add a section to the FAQ where we have more details)
Why do we currently have a "modification" ThermalPad if we already signal the existence of the Thermal pad in the number of pins section? Would it make more sense to designate an option for Thermal Vias?

---

1. Specific package type first, not separated by anything e.g `TSSOP`, `C`
1. Package name and number of pins are separated using a hyphen. e.g. `SOT-89`, `SOT-23-5`. Variation from standard package is included here e.g. Exposed pad under package: `QFP-48-1EP`
1. Package dimensions specified as `width`x`height` e.g. `3.5x2.0mm`
1. Pitch specified in `mm` e.g. `Pitch1.27mm`
1. **Pad Modifiers e.g. Size of the exposed pad `EP5x5mm` (More details see FAQ)**
1. Orientation e.g. `Horizontal`, `Angled`, etc
1. Any modification to the original footprint, indicated by appending the reason:
   1. e.g. Longer pads used to facilitate hand soldering of a QFN component: `QFN-52_HandSoldering`
   1. <s>e.g. Thermal pad designated with `ThermalPad`</s>
   e.g. Vias added to the thermal (exposed) pad designated with `ThermalVia`

poeschlr, 2017-08-21:
The FAQ section might be a bit more detailed. I would even suggest having separate sub sections for each type of package
I think new footprints that include an exposed pad should always contain the size of this pad. Otherwise we need to check for each new contribution if this is the "standard" size for the exposed pad.
I think the lead lenght needs to be given for all DFN/QFN devices. (I don't think we need it for QFP devices)

A first quick draft:
# Footprint naming guide
In the short notation we use curly brackets `{}` to mark optional parts of the name.
Everything between square brackets `[]` denotes a field that needs to be filled out.
## Standard IC packages
`{[Manufacturer name]_}[package name]-[pin count]{-[EP qty]EP}_[Size x]x[Size y]{x[Height]}mm_Pitch[pin pitch]mm{_[pad modifiers]}{_footprint options}`
- For these footprints the manufacturer prefix is only needed for manufacturer specific footprints. (Generally footprints of this type do not need this prefix.)
- The package name refers to the name most adapted by the industry (**Note: Should we enforce some sort of standard? I think JEDEC defines some standards.**)
- The pin count includes the number of pads with different pin numbers excluding any exposed pad.
- For the dimension of the package, the nominal size of the main body in mm is used. (**Note: Is this true for all packages? Some wide body packages might currently use the pad distance.**)
- The nominal pin pitch in mm is added to all footprints (Prefix `Pitch`)
- Pad modifiers are different for all types of ic footprints. (See details below)
- The following footprint options can be used for ic footprints:
  - `Handsoldering`: The footprints pads have been enlarged for easier hand soldering.
  - `ThermalVias`: There are vias included for a better thermal connection between the exposed pad and any other layer. (**Note: Should we use singular or plural?**)

### DFN, QFN
`{[Manufacturer name]_}[package name]-[pin count]{-[EP qty]EP}_[Lenght]x[Width]{x[Height]}mm_Pitch[pin pitch]mm_L[Lead Length]mm{_EP[Lenght]x[Width]mm{_Mask[Lenght]x[Width]mm}}{_footprint options}`
- The lead length is the nominal pin length for which the footprint is designed. This needs to be given for all footprints.
- If the footprint has an exposed pad it needs to include the following:
  - The `EP qty` field needs to exist
  - The size of the exposed pad needs to be given
  - If the soldermask cutout for the exposed pad is reduced, its size needs to be given.

jkriege2, 2017-08-21:
Could you also add `_Clearance[clearance between pins]mm`? We used that for several special footprints for opto-isolators ... which sometimes come in the same package, but use with different clearances.
JAN

poeschlr, 2017-08-22:
Renamed the issue to better reflect the new more general purpose of finding a new more detailed naming convention for footprints

evanshultz, 2017-08-22:
Too much to look at all together right now, but a couple quick thoughts:
1. Would it be best to have some required fields and then only show additions for each package type? Rather than writing down the entire footprint naming convention from the start? It may be easier for maintenance if we have smaller differences for each package type.
1. What about a modifier for pad size? For transformers, snap lead caps, and other big parts I often oversize the pads dramatically from what IPC recommends (at least on the bottom layer). I don't see a way to indicate if we had a part with standard and big pads. This might also help to put some better numbers on `BigPad`, `LargePad`, `LongPad`, Handsoldering`, and other suffixes which aren't intelligent.

poeschlr, 2017-08-22:
@evanshultz wrote:
> Would it be best to have some required fields and then only show additions for each package type? Rather than writing down the entire footprint naming convention from the start? It may be easier for maintenance if we have smaller differences for each package type.

If you read my suggestion closely you will find that i do that. Yes i repeat the complete detailed naming convention for each sub section but i only explain the fields that are special for this section. You are right this is harder to maintain but i feel it is easier to read. (I think in the FAQ easy understanding is more important than making it easy to maintain.)

> What about a modifier for pad size? For transformers, snap lead caps, and other big parts I often oversize the pads dramatically from what IPC recommends (at least on the bottom layer). I don't see a way to indicate if we had a part with standard and big pads. This might also help to put some better numbers on BigPad, LargePad, LongPad, Handsoldering`, and other suffixes which aren't intelligent.

How about an optional parameter `Pad[pad length]x[pad width]mm`?
This would be part of the pad modifiers. (I think it should be the last parameter in this section.)

SchrodingersGat, 2017-08-28:
Only just saw this message thread. I really like the suggestions here, this will make a great addition to the FAQ / KLC

evanshultz, 2017-08-28:
I'll suggest one category for consideration, with one open item about defining missing/removed pins.

### Transformers (at least those with bobbins)
`[core size]-[pin count]_[core orientation]_[Size x]x[Size y]{x[Height]}mm}_Row[row span]mm_Pitch[pin pitch]mm_Lead[lead diameter]mm{_Pad[pad length]{x[pad width]}{_footprint options}`

- `core orientation` is the core's relative position with respect to the PCB, so `Horizontal` means parallel to the PCB like https://3.imimg.com/data3/LG/SX/MY-2041587/smps-transformer-250x250.jpg.
- We need a mechanism to capture any missing bobbin pins *and* their location. `_Missing3` works, but what if pins 1 and 3 are missing? How do you know it's not pin 13? (Plus, this suffix looks ugly.)
- If there are flying windings (wire ends not connected to a bobbin pin but instead to a plated hole in the PCB), they should be included in the total number of pins.
- The optional parameter `lead diameter` describes the nominal drill hole dimension for which the footprint is designed, which will be diagonally across the lead for square leads.
- Example (using [this bobbin](http://www.pinshine.com/upload/product/20141110023557_link.pdf) which is similar to what's used by [ST AN2228](http://www.st.com/content/ccc/resource/technical/document/application_note/ad/f8/c9/1b/b0/19/49/ac/CD00066269.pdf/files/CD00066269.pdf/jcr:content/translations/en.CD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)): `EE1614-10_Vertical_12.8x16.2mm_Row9mm_Pitch3mm_Lead0.6mm`

poeschlr, 2017-08-28:
@evanshultz looks nice. I would move the core orientation towards the back though. (Such that it complies with other footprint types.)
But if it is currently used that way in a lot of footprints we might consider having an exception for this.
I would also suggest to prefix it with `transformer_` or `trafo_`

evanshultz, 2017-08-28:
To me, core orientation is fundamental. A bobbin is built around two things: which core does it fit and how the core is oriented. That's why my mind places it towards the front.

A prefix is fine and updated above, but not all transformers have bobbins. Many power toroid transformers typically solder directly to the PCB, for example. And some transformers are core that fit *ON* the PCB and do not use a bobbin. This prefix can still work, though.

poeschlr, 2017-08-28:
I added your suggestion to my main comment above.

I also thought about the missing pin dilemma for the BGA convention. I did not yet find a satisfactory way to describe it.

lorem-ipsum, 2017-08-29:
For the BGAs I should be enough to add an extra specification for inner pin islands. The only example in the library is the UFBGA-132_7x7mm_Pitch0.5mm. It has an 2x2 inner island. I would argue to name it  `UFBGA-132_12x12-2x2_7x7mm_Pitch0.5mm_Dia0.Xmm`, i.e. append the inner island to the pin count. (Maybe with underscore instead of hypen.)

This syntax results in unique names as the amount of missing pins is specified by the total pin count. In this case: 12x12 - 132 = 12 missing pins. As 2x2 is specified the missing pins start on the next ring which is already 12 pins. If two rings would be missing the total pin count would be 112. Due to the same reason there is no need to specify missing pins in the center (example: BGA-352_26x26) as they are specified by the reduced pin count. If a chip has multiple rings one could extend that to something like 12x12-8x8-2x2. I think this still should be unique, but I am not quite sure about that. But it should be rare and I don't think it is worth making the syntax even more complicated.

Full syntax would be (where the `*` is supposed to be 0+ times):
`{[Manufacturer name]_}[package name]-[pin count]_[num col]x[num rows]{{-[num inner rows]x[num inner cols]}*}_[Size x]x[Size y]{x[Height]}mm_Pitch[ball pitch x]{x[ball pitch y]}mm_Dia[Ball Diameter]mm_[NSMD/SMD]{_footprint options}`

lorem-ipsum, 2017-08-29:
Another thing I realized while looking at the existing BGA names. The number of digits should be specified for all lengths. For example the BGA-352 mentioned above has the sizes 35.0x35.0mm while other footprints would use 35x35 for this case. Same for the pitch. This should be specified, otherwise every item filter needs to be `*35*x35*mm*`.

SchrodingersGat, 2017-08-29:
A few thoughts:

## 1. Reducing Name Length

With all this extra detail comes an increased name length. The various elements that are called out within the footprint name could be abbreviated:

| Element | Abbreviation | Notes |
| ----------- | ----------------- | -------- |
| Body dimensions | B | |
| Lead span | W |
| Clearance | CL | Not required |
| Exposed Pad | EP | Only if there is one or more exposed pad. If more than one, prepend with the count e.g. `2EP` |
| Lead length | L | Only required if there are multiple lead length options |
| Pad dimensions | PAD | Only required if non-standard or multiple options available |
| Pitch | P |

Footprint Options:

| Option | Abbreviation |
| --------- | ----------------- |
| HandSoldering | HS |
| Reversed | REV |
| ThermalVias | TV |

This list of abbreviations would be clearly spelled out on the KLC Wiki.

So for example,

`LQFP-32_5x5mm_Pitch0.5mm_ThermalVias`

becomes

`LQFP-32_B5x5mm_P0.5mm_TV`

## 2. Dimension Units

If we specify that units are in mm unless otherwise specified, then we can also drop the `mm` that appear everywhere

`LQFP-32_B5x5_P0.5_TV`

## 3. Format Specification Field Abbreviations

In your list above ( @poeschlr ) the format strings can be very difficult to read. For example, the DIP format:

```
{[Manufacturer name]_}[package name]-[pin count]{_[Size x]x[Size y]{x[Height]}mm}_W[Lead Span]mm_Pitch[pin pitch]mm{_Lead[Lead Width]mm}{_Pad[pad length]{x[pad width]}}{_footprint options}
```
I propose that the various fields are abbreviated to make the formatting more readable

| Field | Abbreviation | Notes |
| ------ | ----------------- | -------- |
| Manufacturer name (e.g. Microchip) | MAN | Should be consistent, perhaps we add a list of manufacturer names for this purpose |
| Manufacturer pkg name | MPN |
| Pincount / number of pins per row | N |
| Row count | ROWS | Can be omitted if there is only a single row |
| Extra options | OPT |

Thus the example above becomes:

{[*MAN*]_[*MPN*]_}[*PKG*]-[*N*]{_**B**[*body length*]**x**[*width*]{**x**[*height*]}}_**W**[*Lead Span*]_**P**[*pitch*]{_**L**[*lead width*]}{_**PAD**[*pad length*]{**x**[*width*]}}{_OPT}

poeschlr, 2017-08-30:
If we remove units, the size needs a prefix. (otherwise it gets confusing.)
maybe `S`?

I'm not so sure about shortening the descriptors in the footprint name. Yes the name gets shorter, but it requires the users to learn what means what. (with longer names it is a bit easier for them. I hope most are obvious.)
I know ipc suggests shorter naming schemes, but i think they assume that the names are parsed by the pcb tool. (Or do they assume that people working in this field will learn their convention?)

---

About the suggestions for the description:
If we use appreciations we might want to show a tool-tip for what it stands for.
Here a test: `{[<span title="Manufacturer name">MAN</span>]_[<span title="Manufacturer Part Number">MPN</span>]_}[PKG]-[N]{_[body length]x[width]{x[height]}}_W[Lead Span]_P[pitch]{_L[lead width]}{_PAD[pad length]{x[width]}}{_OPT}`

Using a table is a great idea.

Remark on footprint options:
The hand soldering option is deprecated. I replaced it with the pad size option. (or should we keep the hand soldering modifier in addition to the pad size field?)
What is the reversed option used for?

SchrodingersGat, 2017-08-30:
### Name Shortening
There always has to be a balance between brevity and readability. We are trying to develop a coherent set of libraries that are *useful* to both the hobbyist and the professional. If the hobbyist learns a little about how things are supposed to work in a professional setting, then that's an added bonus for them ;)

We cannot come up with a naming scheme that encompasses every option in a generic way unless we allow for names that fully describe the part in a verbose manner.  At some stage we need to define shortcuts. I think that the ones outlined above are reasonable.

Further, we will have to fully document these various shortcuts so that users can easily understand them. Maybe some of the suggestions are a bridge too far but I am very wary of continuing to expand the naming length.

### Body Size
Regarding body size, I was thinking perhaps `B` (for body) as a prefix? The IPC naming omits a prefix here as it is the "primary" dimension.

### Hand Soldering
Regarding the `_HandSoldering` suffix, I'm ok with the idea of specifying the pad size instead.

### Manufacturer Specific Parts
Regarding manufacturer specific footprints. Often these are very hard to describe using a generic format, and the `MAN_MPN` combination is usually enough to fully define the footprint. I would not want to prefix with `MAN_MPN` and then *also* have a large amount of trailing text after this (that's what the MPN scheme is supposed to prevent!)

Perhaps we could strike a middle ground here, where a Manufacturer-specific footprint does not have any of the optional name elements.

For e.g. a (completely fictitious) QFN from Texas Instruments, the minimum requirement could be

`TI_PHQFN-14`

but as you say it does not include much useful information about the packge (but, then again, it does not need to. Users will not pick this footprint at random, but only after consultation of a datasheet). In any case, this could be expanded to:

`TI_PHQFN-14-2EP_B20x20x1.2_P1.25`

Any further information (pad size, etc, etc) can be found in the PHQFN-14 datasheet.

SchrodingersGat, 2017-08-30:
### Passive Components

As part of a library overhaul, I think that the passive components (R / C / L) should be reworked (at least the SMT variants)

1. FP name should use imperial size as default but then be followed by metric e.g. `R0805_2012M`
1. R / C / L chip footprints should be consistent!
1. There are some case sizes missing from these libraries
1. Handsoldering variant reworked to be denoted by pad size

poeschlr, 2017-08-30:
I agree with your idea about passive component naming convention.

For passive components, the standard pad size is currently a bit on the small side. We might want to check it against ipc if possible.
I think this should be discussed in a separate issue though. (Noting it here because you mentioned pad size. And i will forget about it if i do not write it down somewhere.)

---

Another thing about name shortening:
This might be another thing that should (could) wait for the v5 release. It could even be scripted.
How about we use the full names for now and use a script to shorten them when v5 comes along.

SchrodingersGat, 2017-08-30:
> How about we use the full names for now and use a script to shorten them when v5 comes along.

I agree it is too much of a change to implement now. However we should develop and test the script now, so that when the v5 release is here, the footprint libraries are up to date.

This script should be very similar to the one I am working on for symbol libraries.

SchrodingersGat, 2017-09-18:
Hi @poeschlr and others

I've been going through this discussion and trying to consolidate this to the new KLC. This is one of the toughest ones yet :)

This will have to be broken into various sections as there is so much information to convey.

I think I have got the prefix rules down:

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

I'm now trying to work on a KLC page that lists the naming contentions for different types of footprints / components as @poeschlr has done above. However I am having trouble getting them to render clearly and concisely in markdown.

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

I don't see many users being able to comprehend that very easily. Any great ideas on how we can make those patterns easier to understand??

poeschlr, 2017-09-18:
I think i am back now. (I now have a few hours a day for kicad again. Not as much as previously but one can not have everything.) Sorry for not notifying anybody about it beforehand but a lot of things did not go as planned lately.

---

Regarding Single entry versus a more detailed description:
They serve two different purposes. The single entry version is for a quick overview by someone who already has a grasp on what we want to achieve. A more detailed description will be necessary for someone reading this the first time.

Maybe have the single entry with all fields as an quick overview. Could even be in a separate list that holds all possible naming conventions with links to a more detailed description per section. (This list would be similar to the pdf you linked and the detailed description is then geared towards beginners who could not read the pdf.)

---

Also i think the exposed pad size should be added to all footprints that have one. (There is no standard size)

Lead dimensions are also not optional. At least not for qfn and similar packages.

For BGA i am missing something about ball size.

In DIL packages the W does not stand for body dimension but for Lead spacing. So either this is missing or your description is wrong.
I would not give the option of having multiple ways to write the body dimension. I would go with the B[X]x[Y]x[Z] (You also mix the use of L/X and W/Y in the body size description vs the short hand notation)

I'm missing a prefix for clearance (parameter requested by Jan)

And if we look at the transformer stuff there is another can of worms waiting.

---

What about orientation. Will this be written out? Should we fix the use of horizontal/vertical or angled/straight?
I'm for the former. It allows odd angled versions as well. (if you write straight and angled what does 45degree then stand for?)
Just to be clear we should still mention the angled/straight convention but tell the users this is a legacy naming convention, this is what it means, it is not excepted for new footprints.

I assume all this is for the v5 release so should we also require all connector footprints to include the number of rows? (Most single row connectors currently do not include this)

evanshultz, 2017-10-06:
How exactly to handle card connectors? They fall into the category of "Standardized connectors with manufacturer specific footprints (USB, HDMI, ...)", I believe, but perhaps examples and expansion of the idea will flesh out the concept for more component types.

That category's format is:
`[generic series name]_[manufacturer name]{_[manufacturer series name]}_[manufacturer part number]{_Pad[pad length]{x[pad width]}}_[orientation]{_footprint options}`

Does `[generic series name]` mean `USB`, `HDMI`, `Phono`, `microSD`, etc.?

I also think capitalization should be respected, so we would always write SD, SIM, etc. Just in case that isn't explicit.

This would change `Hirose_DM3BT-DSF-PEJS` to `microSD_Hirose_DM3BT-DSF-PEJS` and `MicroSd_Wurth_693072010801` to `microSD_Wuerth_693072010801`. Is that the desired scheme?

poeschlr, 2017-10-06:
Yes if i remember correctly generic series name is USB, HDIM, ...
I added it above such that i remember it when i help oliver to write this stuff up for the KLCv3
Yes we should fix the capitalization.
(I would suggest we add a table that holds these to the KLC)

poeschlr, 2017-10-07:
While looking at the PR https://github.com/KiCad/Connectors_TE-Connectivity.pretty/pull/6 i noticed that my naming convention for connectors is not compatible with the footprint filter i choose for the generic connector symbols. (The filter for the Conn_01x01 symbol might need tweaking as well because there it really does not make sense to speak about pin pitch.)

I also noticed that i do not have any mention of body size for connector footprints. (At least necessary for generic footprints. Might be a good idea to have it optional in all footprints.)

SchrodingersGat, 2017-10-07:
> I also noticed that i do not have any mention of body size for connector footprints. (At least necessary for generic footprints. Might be a good idea to have it optional in all footprints.)

While this makes sense for generic footprints (in some cases) we should **not** mandate this for all connectors. When you select a particular connector for an application, you do it very carefully and from the datasheet, or what crimp tools you have, or mating connector requirements, etc. You *know* the body size for a particular type / brand of connector.

Hopefully we can have KLC v3 up soon so that we can direct users to it. We can get it up and running before v5.

SchrodingersGat, 2017-10-07:
For connector styles that are specific to a particular manufacturer, we must retain the `Conn_Manufacturer` schema. There are so many connectors that are very specific in
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

Thread 1473 (2017-07-30):

Analog switch schematic symbols

evanshultz, 2017-07-30:
I would like to define how we will draw analog switch symbols in the official KiCad libary.

I see two different types of symbols for multi-gate switches:
- A single large gate with switches, logic/control, and power pins all together
- Multiple gates for each switch and logic/control, each having all power pins

There are also single gate switches with all pins together in one symbol. Like with single opamps, I suppose a single symbol is the way to go. Personally I still like having all power pins separate for grouping, but I'm more strongly of the belief that opamps and analog switches are similar in this respect.

Back to multi-gate switches. Here are images:
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

(It's obvious that this library needs additional help, as well, which I plan to address with a library overhaul.)

My understanding is that neither of the multi-gate symbols described above are OK. Like with multiple-gate opamps, we would want separate symbols for each switch, and then power pins are a separate gate. I'm not quite sure how to handle the logic/controls, though I've typically had one symbol for each switch and one symbol for logic/power and that worked out nicely.

Is that a wrong assumption? Has this been discussed before? Is there already a known best practice for analog switch symbols?

jkriege2, 2017-07-31:
I would propose to use symbols that look like the set of switch symbols that we already have ... maybe inside a box + extra subsymbols for the power-supply. I'm not sure whether generic symbols would work, as I'm not aware of a generic pinout-standard (same discussion as with single opamps), so I would be against such generics.

I would draw them like this:
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

Best,
JAN

jkriege2, 2017-07-31:
... or maybe like the ones in the overview there: https://www.eeweb.com/company-blog/nxp/nx3-high-performance-analog-switches

One could also think of integrating a trinagle for the input "driver", as e.g. there:
http://www.intersil.com/en/products/switches-muxs-crosspoints/medium-voltage-switches/switches-muxs-crosspoints/ISL43210.html

... Also the pin-location (input on the left) in the latter case would fit nicely with the existing KLC.

Best,
JAN

PS: In my drawing above, pins 1,2 should be passive (I think)!

SchrodingersGat, 2017-08-01:
The angled lines in the current symbols are pretty ugly IMO. The example that Jan has drawn above is good (at least for SPST switch).

I like the style of the first link than Jan posted, but I think adding a triangle (as per the second link) is a little too complicated.

jkriege2, 2017-10-22:
I'm doing a rework of analog_switches.lib with new symbols in the next few days.

Best,
JAN

jkriege2, 2017-10-26:
OK, PR is posted: https://github.com/KiCad/kicad-library/pull/1773

SchrodingersGat, 2017-10-26:
Thanks Jan. I'll close this issue now.

Closed 2017-10-26.

Thread 1532 (2017-08-13):

TMLM 3D models

antoniovazquezblanco, 2017-08-13:
I have found that TRACOPOWER provides 3D models for some of their components [in their webpage](http://www.tracopower.com/products/browse-by-category/show/ac-dc-power-supplies/encapsulated-modules/tmlm/1/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) under the documents tab.
I've asked if they could be used in this project and received a positive answer:

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

I understand that there is no legal/licensing issues in adding this 3D models to the repository. Also, I have never added a 3D model to the KiCad library and provided models are already in STP format which I believe it is a supported format. Could anyone please add them or point me to some documentation on how to do so?

Thank you very much!

poeschlr, 2017-08-24:
With the current licensing approach of the lib i think we need to go even further than what this letter allows for. Currently all our models are shipped under GPLv2 (with symbol exception).
Adding the models would mean they are not only shared but re licensed. (The current license holder needs to explicitly agree to this re licensing.)
We could add a separate repo for models like this and note it in the readme where to find them.
(I would not mix licenses in our current repo. It would be a nightmare to manage that.)

antoniovazquezblanco, 2017-09-20:
After a while I sent a third mail to TRACO POWER and they finally reached to me again:

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

Shackmeister, 2017-09-20:
That sounds really interesting! perhaps @easyw has something to pitch in
I guess the main thing is to send them the very exact licensing documentation (has it changed for 3D models since the new license decisions? @SchrodingersGat)
Im not sure if we have an official way of documenting the agreement with the manufacturer, would an email qoute do?.

SchrodingersGat, 2017-09-20:
@Shackmeister interesting question.

I am exploring currently the [GitHub CLA functionality](https://cla-assistant.io/) which looks pretty interesting. I'm not sure whether a company will be willing to sign off on such a thing!

Mixing licenses is going to be terrible. Asking users to sign a CLA (integrated easily into GitHub, I tested it [earlier today](https://github.com/KiCad/kicad-symbols/pull/3) - might be sufficient.

In this case, it would *probably* require that Traco (or a representive thereof) actually make the PR. Plus there would have to be a note in the library directory stating that a license transfer has taken place.

I'm not that interested in spending time and effort chasing contributions of third-party data that is already available from the manufacturer site. If it's not going to be easy and legally bulletproof, it's a non-starter.

I don't mean to be blunt, but I've had way more than enough of licensing dramas over the last week :)

antoniovazquezblanco, 2017-09-22:
> I don't mean to be blunt, but I've had way more than enough of licensing dramas over the last week :)

I've started to follow KiCad development more closely and for some reason I had not seen that discussion until now. It seems that the legal issue is bigger than what I had thought.

From my point of view there are companies that are interested in collaborating in the development of this program but it is not always clear as to what the legal consequences of doing so are. This legal issues help to clarify the situation.

I hope the issues of the last week have been useful in order to reorganize the licensing and the libraries despite the drama. I hope a new and easier way of contributing from the legal point of view is adopted so that this issues get solved.

Thank you for your work.

antoniovazquezblanco, 2017-11-02:
I have recently seen CLA enabled in some repos. How is it going? Have you decided on wether to enable it for every repo?

SchrodingersGat, 2017-11-02:
It will only be enabled for the new library repositories that accompany v5 release (i.e. not this one)

antoniovazquezblanco, 2017-11-03:
Does CLA support 3rd party signing a PR? i.e. I open a pull request with TRACOPOWER 3D models and a representant from that company also signs the CLA to comply with licensing.

Thank you @SchrodingersGat for providing a solution to the licensing issue.

SchrodingersGat, 2017-11-03:
I think for external libraries (e.g. manufacturer 3D data) it is best to have a page with links to these external libraries. There is little point in duplicating this data when it is readily available elsewhere. The licensing issues only complicate things further.

http://kicad-pcb.org/libraries/klc/M1.2/

easyw, 2017-11-03:
Only issue with manufacturers data is placement and orientation of the provided 3d model in respect to what kicad footprint would need...
Sometimes users get lost in trying to align models to footprint...
For this reason in some cases it would worth to have some commonly used parts replicated...

SchrodingersGat, 2017-11-03:
@easyw I feel that this is valid, and covered by the `The contributed files provide some advantage over the data supplied by the manufacturer` exception

SchrodingersGat, 2017-11-03:
Also, hopefully with your scripts and guidance, smaller size models can be generated :)

easyw, 2017-11-03:
@SchrodingersGat
size of STEP files is a big topic...
The main reason is the nature of STEP file format...
1. it is a text format
2. it describes the objects with geometries
3. it must be reliable to be the base for a industrial production
I did a lot of effort in improving FreeCAD STEP interoperability
you can see a recap at the FC forum
https://forum.freecadweb.org/viewtopic.php?t=23371
There **file size** is covered by a deep analysis... but not only file size, are also covered:
- file handling performance
- step import performance
- step export performance
- step hierarchy import and export
ATM FreeCAD 0.17 can handle huge STEP files or assembly with similar and in many cases better than commercial software and **it is the only open source or free package that can do it with this level of quality and compatibility**.
File size is just a small part of the all vision... and also size is much better know compared to situation of one year ago and with other commercial software.
MCAD world is comfortable with huge STEP assemblies (typically a MCAD hardware is very powerful and rich of resources)... but then a library of STEP accurate models can just be very heavy...
IMO the only way to manage this kind of data is a way to download only what is needed for the project that a user is developing...
here a sample test real world file of an open source project
https://github.com/sgrogan/FreeCAD/releases/download/STEP/steptest.7z
it is 20MB zipped and 200MB unzipped STEP file... before those enhancements that was just NOT hand-able at all in FC...
I already suggested that a python pcbnew macro or action script could create a list of needed STEP/WRL models containing also their respective folders...
Then the macro could download with a wget only what is missing to build what a user would really need ... Someone also suggested a way to check if the already present needed models would be up to date or not, and in case update the required ones.
I don't think that having an online HUGE library would be a problem if Kicad would download only what is needed for the project that a user is developing... Maybe a basic library containing most common parts could be offered with the basic installation, but other models would be just downloaded as requested.

Please consider that FreeCAD MCAD kernel is OCC and that is also the one used by well known and expensive commercial ECAD ...
ATM I think KiCAD is doing a great job for ECAD world and it has the right way to collaborate with the mechanical environment... Some commercial packages just followed what we have done in now more than two years of developing...
This is what I have learned in my MCAD experience since I started to need a mechanical collaboration for electronic designs.
Thank you again for your great effort in making the library really affordable and complete. I managed to develop almost all my internal use parts, but if I had started now in using Kicad, I don't think I would have to create nothing...
And thank you also for the rigid selection of the library that you @poeschlr @Shackmeister  @pointhi  and other librarians managed to have in Kicad...
I agree so much with Renè when he pointed out that a library quality is measured by its weakest part...
Maurice

antoniovazquezblanco, 2017-11-03:
Given the statements from @SchrodingersGat this issue can then be closed as the point was to clarify if there is a way for the manufacturer to collaborate into suplying their models with KiCad just by relicensing (knowing that there may be other people willing to prepare the files for them to sign).

The answer is no.

In my opinion I know it now is less hastle for maintainers but in the long run renouncing to good 3D models from manufacturers that may be willing to contribute to the open source software community is not the best choice. I know it is a lot of work and it may not seem worth it.

I see that this has been a trigger to licensing clarification and hope it was positive for everyone. I think that for anyone really willing to put some effort into collaboration there is a clearer extent to what the current legal/licensing situation is.

Thank you again everybody for the effort put into this.

Closed 2017-11-03.

Thread 1550 (2017-08-19):

Taging the lib for 4.0.7 release

poeschlr, 2017-08-19:
Is there a way to tag all repos at once in preparation for the 4.0.7 release?
https://lists.launchpad.net/kicad-developers/msg30330.html

poeschlr, 2017-08-19:
@jkriege2 or @SchrodingersGat could someone answer this question? I think we don't have a lot of time left.

jkriege2, 2017-08-19:
Hi!

unfortunately I don't know ... I think @SchrodingersGat made the tags (at least they exist in the few repos I checked randomly) ... I think he had a script for that ...
@SchrodingersGat are you back yet and could give a hint?
@CarlPoirierCould you comment on that?

Best,
JAN

poeschlr, 2017-08-19:
@jkriege2 forgot a space so the notification to @CarlPoirier might not have gone out correctly. (Made this comment to create the correct notification.)

SchrodingersGat, 2017-08-20:
I've only done it once, for 4.0.6 - I used a simple script that cloned each repo, added a tag, and pushed to master. I have since evolved this script into the kicad-library-utils one that downloads all the .pretty libs. However the version in master does not currently do the tag and push.

Has Wayne now indicated that he wants the libs tagged for 4.0.7? I'm still away on vacation for another week. If it needs to happen before then, it is simply a matter of someone with write access tagging each .pretty repo and pushing to master.

poeschlr, 2017-08-23:
I asked about it in the mailing list. (The answer was linked above.)
Wayne answered twice. Both answers where basically we should tag the libs.

I added a tagging functionality to the library utils script. (I also added a checkout function.)
This way the script can be used to download the libs, tag a specific state of the lib and checkout any tag (or branch)
I also enabled the possibility of pushing the tag to github. (And therefore gave the option to use the ssh url during cloning.)

I used this script to tag all footprint libs. (Wayne mentioned he wants an official release this weekend so it would be too late if we wait for your return.)
But it seems i have no write access for the following repos: (And could therefore not set the tag)
- Terminal_Blocks_Wago
- Terminal_Blocks_Phoenix
- Connector_Card
- RF_Antenna

I will also tag the kicad-library, packages3d and packages3d-source repos. (Within the next hour or so.)

evanshultz, 2017-08-23:
@poeschlr If you want to incorporate your new connector symbols I can do it in a few hours. If you want to tag a bit later, or tomorrow, then we can at least get those nice symbols in the library. Since the schematic symbols aren't connected to GitHub we won't have any way for most users to see the symbol updates until 5.0.

poeschlr, 2017-08-23:
In this case i will wait a few hours. I will also take a look at your audio lib cleanup but i fear that contribution is too large to rush in just before a release.

poeschlr, 2017-08-23:
The kicad-library repo, packages3d ans packages3d-source repo are now tagged. Which means every repo for which i have write access is tagged.

poeschlr, 2017-08-24:
All libs are now tagged.

Closed 2017-08-24.

Thread 1580 (2017-08-29):

Overhaul of valve.lib

Misca1234, 2017-08-29:
What about vavle.lib (and the corresponding footprints)?
I was thinking of starting to fix it up, if it will be done, which type of symbols do we prefer

Old symbol (of http://www.r-type.org/pdfs/ecl82.pdf)
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

New version 1
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

New version 2
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

The "issue" with version 1 is that the H pins, which is the power pins so to speak, can not really be placed ontop and beneth, it will look strange.
And therefore they must be of the type "input" and not "power input".
If they are of the type "power input" in version 1 then travis will complain.

jkriege2, 2017-08-29:
please also have a look at the IEC standard for electronic symbols ... as we try to follow that in other parts of the lib!

I think we can also stick to the old design, which does not have the problem of the strange hor. red lines inside the yellow backrgound + we also don't fill transistor-circles with yellow ...

Best,
JAN

bobc, 2017-08-31:
> we also don't fill transistor-circles with yellow ...

That might be our practice, but is not reflected by the KLC:

> 4.2 iii Fill style of symbol body is set to Fill background

There is no exemption for transistor or other symbols. Having to follow written rules (the KLC), as well as unwritten rules (common practice) which conflict with each other is highly frustrating for submitters!

In this case, it is not possible to fill the shape easily without the extra horizontal lines, so practically speaking it is better without the fill.

On the power pins, I would suggest keeping them horizontal, and request a 'legacy' waiver to the KLC rules on power pins.

jkriege2, 2017-09-01:
The rules in KLC are in my understanding mostly made for IC-style symbols (that should be written more explicitly there ;-) ... We mostly do exceptions for "small" symbols (R,L,C,D,transistors...) and I think that valves fit into this category. the same goes for the power-pins (whatever a power-pin is for a valve ... the electron source? ...).

Best,
JAN

bobc, 2017-09-03:
> whatever a power-pin is for a valve

For the heater... I guess not many people are familiar with valves nowadays!

SchrodingersGat, 2017-09-03:
> The rules in KLC are in my understanding mostly made for IC-style symbols (that should be written more explicitly there ;-)

It was my understanding that the "background fill" should only be for black-box symbols. The different color is used to indicate that there is something more going on inside the symbol than is readily apparent from the drawing. Discrete devices (R / L / C / Q / D) are completely described by their symbol (for the most part) and thus should not need extra highlighting.

I see now that this is not properly described in the KLC.

If y'all agree with my synopsis above, (or otherwise) please let me know and I will update the KLC to match this.

bobc, 2017-09-03:
I had no idea that certain parts of the KLC are only intended for ICs or black box symbols, I always assumed it should apply everywhere. I can't see how the average reader would know that. Anyway, clarification would be good...

> The different color is used to indicate that there is something more going on inside the symbol than is readily apparent from the drawing.

I agree with that in principle, although it's a bit subjective. There are some test cases:
1) some crystals have the body filled - should not be.
2) op-amps have a special shape, and are not really black box? However, we have filled those.
3) flip flops are represented with a box, but the function is well known . Should we fill those?
4) logic gates, AND OR etc are surely not black box in any sense, However in #1578  I was specifically asked to fill all the logic gates which is small challenge, but perhaps we should not fill those?

I wrote more about this in #1143 . Personally, I am not that bothered whether symbols are filled or not, although some people find it quite controversial. I can easily build rules into my script, but I just need to know what the rules are! :)

SchrodingersGat, 2017-09-03:
> I can easily build rules into my script, but I just need to know what the rules are! :)

Fair point - and they are still in a state of flux :)

> I agree with that in principle, although it's a bit subjective.

Are you aware of any standard here that is less subjective? (I do not mean this facetiously, it would be good to follow best practice if such a thing is available).

Our options are:

1. Mandate that *all* symbols should be filled
1. Require that *some* symbols are filled, based on a simple ruleset e.g. `only black-box symbols`.

@poeschlr @jkriege2 any input on this?

evanshultz, 2017-09-03:
I had no idea, either. From seeing the symbols, my interpretation was that filled was used everywhere except for discrete parts (diode, resistor, capacitor, FET, etc.). I also think it looks best that way, but that's subjective. Having logic gate unfilled looks ugly to me, and my HEF4093B was merged with filled symbols and a separate power symbol some time ago (https://github.com/KiCad/kicad-library/pull/1450).

bobc, 2017-09-03:
> Are you aware of any standard here that is less subjective? (I do not mean this facetiously, it would be good to follow best practice if such a thing is available).

I'm not aware of one. Existing practice seems to be quite _ad hoc_, e.g. MCUs and connectors might be filled but nothing else is. Possibly, connectors are important because they are an external interface? Really, it seems to be at the whim of the designer. It would be nice if users could set the colors in the schematic on a per symbol basis.

> only black-box symbols.

Right, but what is black-box? It's not a rigorous definition you can readily apply. From my point of view, most ICs are fully defined by the datasheet, there is nothing hidden. Programmable devices like FPGA or MCU I would regard as a black-box - ie. with functions not shown.

IEC symbols show the function in the symbol, which you can read if you know the symbology. So does that mean they are not black-box?

It may too difficult to define generic rules, we could have a defined list of component types. Anything not on the list would have to be discussed.

poeschlr, 2018-01-20:
@Misca1234 if this is still relevant in the new repo https://github.com/KiCad/kicad-symbols please reopen it. (provide a short summary of this discussion and point back to this issue.)

Closed 2018-01-20.

Thread 1599 (2017-09-07):

Arduino schematic symbols

giogziro95, 2017-09-07:
So, a couple of months ago, I've made a library that includes schematic symbols for Arduino Nano and Arduino Uno boards. They are also available as individual libraries. There are also the symbols for some other components as well. You can have a look at them [here](https://github.com/giogziro95/kicad-library/tree/master/eeschema).

I know, @jonathan-iap has [already provided](https://github.com/KiCad/kicad-library/issues/163) the templates and schematic symbols, and although they are nice, I wasn't fully happy with them, so I created my own.

A couple of advantages of the ones I've made are:

- More convenient pin placements;
- Better pin numbering;
- Aesthetically more pleasing;
- Overall, more KLC-compliant.

Here's the screenshot of Arduino Nano symbol:

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

Now, what should I do? I'd love to contribute.

Thanks. 🙂

jkriege2, 2017-09-07:
Hi!

please have a look at the library modules.lib in the current kicad-lib. This already contains some symbols for Arduino Nano (and some others). If you want, you can push additional Arduino symbol there. The footprints should then go to this repo: https://github.com/KiCad/Modules.pretty

Best,
JAN

jonathan-iap, 2017-09-07:
If you want before creating templates i have been this : [http://meta-blog.eklablog.com/kicad-librairie-arduino-pretty-p930786](http://meta-blog.eklablog.com/kicad-librairie-arduino-pretty-p930786)
Attention it contains errors...

giogziro95, 2017-09-09:
@jkriege2

> please have a look at the library modules.lib in the current kicad-lib. This already contains some symbols for Arduino Nano (and some others).

Great! I didn't know that. My install on Manjaro Linux doesn't include some of those libraries...

> If you want, you can push additional Arduino symbols there.

As I said, I have symbols for Uno and Nano, but the library already includes them, as you pointed out. Do you perhaps mean alternative symbols?

Also, I have symbols for 7405, 74141, a force-sensitive resistor, HX711 module, and some other things. The full list is [here](https://github.com/giogziro95/kicad-library#kicad-library). Shall I push all?

Thanks. 🙂

jonathan-iap Thank you too. 🙂

jkriege2, 2017-09-09:
Hi!

Arduino: if there is a good reason, you can always propose a changed symbol ... having two variants for one device does not really make sense.

About the other devices: Please go ahead pushing them, just as a sidenode: Before pushing the 74xx-variants, please have a look at the effort to rework those libs, currently undertaken there: https://github.com/KiCad/kicad-library/pull/1578
When pushing your symbols, please ensure they end up in the correct library to your best knowledge (if there is a better place, we will discuss that during the PR-discussion). Also: Please push them in several PRs that all only contain a few symbols that belong together thematically or by lib, this makes review easier.

Best and looking forward to your submissions,
JAN

jkriege2, 2017-09-09:
Can we close this issue?

giogziro95, 2017-09-09:
Got it, thanks.

Yeah, let's close this.

Closed 2017-09-09.

Thread 1627 (2017-09-17):

KLC: Connector schematic symbol conventions

matthijskooijman, 2017-09-17:
I was looking at some connector symbols today and noticed that there is quite some difference in styles. Looking at the KLC, I couldn't really figure out what the recommendation is for them.

In particular, I noticed this symbol (atmel:AVR-JTAG-10):

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

It violates some KLC constraints (origin is not in the middle, pin origin is on a 50mil grid, not 100). I'm not sure what KLC says about the visual style of connectors.

This particular symbol also has pin labels on the outside instead of on the inside (as is customary for filled blocks for ICs), probably because the visual style resembles the common (but not only) "shrouded header" footprint used for this connection. Because the labels are centered on the pins, any wires that you would connect go right through the labels, which doesn't really look good.

As for the visual style, it seems that there's quite some variation. The generic `CONN_*` symbols use a basic block with pins:

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

But more specific connectors use more graphical representations, with or without fill. Here's a fairly random selection from the `conn` library:

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

So, the question is: what policies do we (want to) have for connector symbols? I assume they should adhere to the regular policies (e.g. pin grid alignment) wherever possible (though a particular visual style might conflict with that), but are there more specific ideas for the visual style?

As for the AVR-JTAG connector, which I originally wanted to improve, I guess it would be good to keep the "shrouded header" visual style, but realign the pins and move the labels slightly out of the way to be more useful? Any other specific suggestions for this part?

bobc, 2017-09-17:
I don't like the overly graphic connector symbols, IMO the schematic should show logical connections, I don't need a picture of the connector in the schematic. Aesthetics are highly subjective, so these symbols tend to change every few months when someone decides they don't like the look of the current symbols.

The AVR-JTAG symbol is particularly horrible. A simple box with labels on inside would be much better.

Unless there are labelled pins like USB, I tend to use the generic CONN_xxyy symbols.

poeschlr, 2017-09-17:
You should update your libs before you make an issue. The dilxx connectors do no longer exist and the screw terminals now use the same pin spacing as other connectors.

And the conn_02x05 does not exist in this form any more. It now is called Conn_02x05_Odd_Even, it has background fill and it's pins are on 100 mil grid.

For the AVR symbol i would go the route suggested by @bobc and use a simple rectangle with the pin names inside and the pins outside the rectangle. The current placement of the "pin names" is particularly bad because you can not easily connect wires to the pins without them going right through the text.

SchrodingersGat, 2017-09-17:
I will add a new KLC rule with the AVR img as a reference of what *not* to do! Wire connection points should all be on the *outside* of the symbol.

jkriege2, 2017-09-18:
For the AVR-connector ... maybe you can dopt a style like for the USB-connectors (not as many logos here .... of course ;-)
That's reasonably close to connectors (small rects inside), but is basically a box and the logo says what you have here ...
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

matthijskooijman, 2017-09-18:
> You should update your libs before you make an issue. The dilxx connectors do no longer exist and the screw terminals now use the same pin spacing as other connectors.

W00ps, totally right. I thought I had recently updated, but seems I actually didn't. I've updated the screenshot in my first post with the current versions. The AVR-JTAG symbol didn't change.

> And the conn_02x05 does not exist in this form any more. It now is called Conn_02x05_Odd_Even, it has background fill and it's pins are on 100 mil grid.

I also updated that one above. This does show a new contradiction: To get the pins on the 100mil grid, the origin of the component is 50mil off-center horizontally. I also noticed this when fiddling with the AVR symbol, that satisfying both the centered and the 100mil-grid constraints, the symbol can get unreasonably big. Is this an exception to the centered-constraint that should be made explicit in the KCL?

> I don't like the overly graphic connector symbols, IMO the schematic should show logical connections, I don't need a picture of the connector in the schematic.

I guess in some cases it could be useful to convey the exact connection. For example, I think the pin numbers in a jack plug aren't well-defined, and I'm not sure if the pin that disconnects from another pin has a name that makes it clear how it works exactly, while the DC jack image conveys that information quite cleanly. Another advantage is that, e.g. when looking at the schematic for the DIN or DB9 connector, you can easily see which pins connect to what, without having to look up the pin mapping of the connector (which can be useful for testing or production, for connectors that do not have the pin numbers labeled on the actual connector).

Still, a clean box with just pins sticking out has advantages as well. Would it make sense to have both? So a graphical and plain version?

For connectors whose pins have no particular name, just a number, you can just use the `CONN_*` symbols instead of having a separate plain version of the connector, of course. For others, such as the AVR-JTAG or DB-9-used-as-serial, it might be useful to have a dedicated symbol that shows names in addition to numbers.

> For the AVR-connector ... maybe you can dopt a style like for the USB-connectors (not as many logos here .... of course ;-)

Yeah, I think a plain box with labels on the inside is probably best. That still leaves two choices:
 - Order the pins by number, mimicing the physical layout (e.g. like Conn_02x05_Odd_Even but wider to allow for names)
 - Order the pins logically, e.g. GND at the bottom, VCC at the top, etc.

I guess both of these might have merits, so would it also make sense to allow both versions to exist? Should we have a naming convention to distinguish between these variants? e.g. "Graphical", "Ordered by number", "Ordered by function" (or are the first two really the same?)?

jkriege2, 2017-09-18:
I would make only one version, where the pins are ordered by function (see USB) ... especially here, as the symbol is more a logical symbol and less one that stands for one specific connector type (e.g. you can use 2x5 pin-heads in different pin pitches, depending on the space that is available ...)

poeschlr, 2017-09-18:
Center is a bit of a strech. I think we defined it (somewhere in another pull request or issue) as meaning as close to the center as possible while having the pins on 100mil grid. In my case the even numbered connectors are moved down (and for dual row to the right) by 50 mil to satisfy the grid requirenment.

matthijskooijman, 2017-12-06:
It seems most of the things raised in this issue are now clarified in the KLC. Three things might still need clarification:

 1. A general recommendation of how to make connector symbols look (rectangle with filled background, or a graphical representation with or without filled background). It seems the preference here is for a plain rectangle, but the current KLC contains an image of correct pin placement that contains a lot of these graphical connectors, which can be seen as a recommendation for them. Even if there is no strong preference for either, it might be good to mention both options and say both are acceptable?
 2. For rectangular connector symbols, it is customary to use small rectangles on the inside of the pins (as suggested by @jkriege2 [here](https://github.com/KiCad/kicad-library/pull/1736#issuecomment-337332377)), but the KLC does not mention this. From the current symbols, only the generic connectors, USB connectors have these rectangles. What's the rationale for using these rectangles? I just noticed that the USB symbol (see above) does not have this box on the "Shield" pin, is this because it does not correspond to a regular pin, but a mechanical mount? Or is it just an oversight?
 3. This is not really related to connectors specifically, but the KLC does not seem to define the "Pin Name Position Offset".

For the pin name offset, it seems that most symbols use 40mil:

```
$ cat *.lib |grep ^DEF | cut -f 5 -d' '|sort -n |uniq -c
    580 0
     64 1
      7 5
    390 10
      1 15
    401 20
     27 25
    370 30
   3073 40
     41 50

```
I suspect that a lot of symbols that do not use 40, do not actually have pin names set, but I have not investigated closely. To figure out what symbols use different offsets:

    cat *.lib |grep ^DEF | cut -f 2,5 -d' '|grep -v 40$|less

For the small rectangles, as [I mentioned here](https://github.com/KiCad/kicad-library/pull/1736#issuecomment-337529247) there are various sizes in use. Generic connectors (e.g. Conn_02x03_Odd_Even) use 10x50 rectangles, which work because there are no pin names. The USB1 connectors use 10x30, which fits well with the 40 mil pin name offset used by pretty much all connectors. The USB3 connector uses 20x40, which only works because all pin names end in "-". If you replace that be a normal letter, the rectangles are too near the pin name.

It seems that recommending the use of 10x30 rectangles, or 10x50 when there are no pin names is consistent with current practice.

evanshultz, 2017-12-06:
40mil generally looks too big. 20mil looks better, and 0-10mil looks fine on other symbols. Symbols with shapes other than a rectangle often benefit from other pin offsets.

See https://github.com/KiCad/kicad-library/pull/1560. This has been discussed at least a couple other times before, with me making KLC propositions to add it, but I don't find the conversations right now. I do recall that 20mil should be nominal distance with smaller being allowed (but possibly with a warning).

matthijskooijman, 2017-12-06:
#1560 uses 20mil, but for non-connector symbols (so without the rectangle). Did you intend this 20mil also for connectors, or just for parts without the rectangles? If the former, I think there's only limited room for the rectangle, 10x20 is probably too big already.

poeschlr, 2017-12-06:
The grid is only important for pins. Graphical elements can be placed wherever you want. (You can use the smallest grid supported in eeschema.)

The reason for the grid requirement used for pins is that in eeschema you can not snap to pins, but only to the grid. Having symbols designed to the largest grid (100mil) means they can be connected in every grid.

matthijskooijman, 2017-12-07:
> Edit: disclaimer after again reading your stuff i am not sure any more that i understood the reason for your discussion. If you think what i wrote below is nonsense, it probably is.

Heh, I was about to ask what you were responding to exactly when I noticed this edit :-)

If I can clarify anything, let me know.

poeschlr, 2018-01-20:
@matthijskooijman we transferred over to a new lib located in https://github.com/KiCad/kicad-symbols in preparation for the v5 release. If this is still relevant please reopen this issue over at the new repo. (provide a short summary of this discussion and point back to this issue.)

Closed 2018-01-20.

Thread 1663 (2017-09-25):

NC pins in symbols

SchrodingersGat, 2017-09-25:
I think we need to readdress the NC pins rule. Currently we require that all NC pins are added to the schematic, but this makes for some really messy symbols:

https://user-images.githubusercontent.com/3242402/30396149-f8ee8b06-98c8-11e7-93a4-452812006358.png

If we drop this requirement then footprint filters may not work for some parts, (mostly generic parts as atomic ones already have their footprint associated).

When .sweet format arrives then that brings many-to-one pin association so that be good. Until then, I think we should drop the requirement that ALL NC pins must be added, and take the hit on footprint filtering (I don't think many users will find that an issue).

It makes the symbols a LOT cleaner, and it also reduces contribution complexity.

jkriege2, 2017-09-26:
Hi!

BTW: It's worse for TL431...

does the new format also bring many-to-none pin association? Basically we don't want all the NC-pins connected to each other.

For now I would propose 2 options, from which the contributor can choose:
1. add all NC and drop the pin-count from the FPFilter (prefered if there are few and there is enough space in the symbol for NC-pins)
2. add non or only few of the NC pins and ADD the pin-count to the FPFilter (at least where that makes sense, e.g. for DIP/SOIC/...-packages) (prefered if the symbol gets significantly less messy and if the NC-pin count is comparable to or larger than the actual pin-count, or for simple devices like reference diodes)

SchrodingersGat, 2017-09-26:
I think that is sensible.

bobc, 2017-09-26:
I also came to the conclusion that it would be better to omit NC pins, particularly as they can actually get connected to a net despite the "No Connect" property.

However, I think the footprint filter must then contain the pin count. There are parts with multiple NC pins, in general how can the user know whether to select SOIC-14 or SOIC-16 without reference to datasheet?

I've never liked leaving the pin count a wild card, we try to nail down every other parameter to avoid surprises for the user, but in this case we leave it open. If a part is available in different pin counts, then we need a separate symbol anyway? Otherwise, we can add multiple filters for each package/pin count.

SchrodingersGat, 2017-09-26:
> There are parts with multiple NC pins, in general how can the user know whether to select SOIC-14 or SOIC-16 without reference to datasheet?

To be honest, who's picking a footprint without reference to a datasheet? ;)

I think the advantages of dropping mandatory inclusion of NC pins far outweigh the downsides...

jkriege2, 2017-09-26:
@bobc @SchrodingersGat ... I don't really understand that discussion ... my proposal above should fullfill all requirements and the contributor may choose as he wishes ... so where's the problem?

Best,
JAN

SchrodingersGat, 2017-09-26:
There's no problem Jan, the two options you presented will work.

jkriege2, 2017-10-13:
Since this is done as my proposal now ... should we close this issue?

JAN

SchrodingersGat, 2017-10-13:
Yep thanks Jan

matthijskooijman, 2017-12-06:
I was still a bit confused a bit after reading the KLC. In particular, it now says "NC pins may be omitted", but also provides rules for hidden NC pins. Would it make sense to make the options more explicit? e.g. replace S4.5.1 by:

> Pins that are never to be connected under any circumstances, may be omitted or can be added as hidden NC pins (when this does not clutter the symbol too much).

And perhaps add a sentence to S4.6.1:

> These pins should be entirely placed within the symbol, to prevent accidental connections to them.

Closed 2017-10-13.

Thread 1665 (2017-09-26):

Parse error with net class

Ruffunaru, 2017-09-26:
Hello,

I want to see the Kicad project of the DIY Laptop by Olimex.
When I open the .kicad_pcb file with Pcbnew, I got an error :

"Error loading board.
KiCad was unable to open this file, as it was created with a more recent version than the one you are running. To open it, you'll need to upgrade KiCad to a more recent version.

Date of KiCad version required (or newer): 08/15/16

Full error text:
PARSE_ERROR: Expecting 'clearance, trace_width, via_dia, via_drill, uvia_dia, uvia_drill, or add_net' in input/source
'/home/Ruffunaru/KiCad_Project/DIY_Laptop_olimex/HARDWARE/A64-TERES/TERES-PCB1-A64-MAIN/TERES_PCB1-A64-MAIN_Rev.B.kicad_pcb'
line 580
offset 6
from dsnlexer.cpp : Expecting() : line 369"

My version of Kicad : 4.0.7-e2-6376~58~ubuntu16.04.1, release build

When I open the .kicad_pcb file with my text editor (gedit)
I find the keywords above (clearance, via_dia, add_net, etc) but there is also two others keywords : "diff_pair_gap" and "diff_pair_width"

I presume that there are net class from an older version and there are not here anymore. Am I right ?

I think that I have to open this file with an older version but I wanted to ask here if there is an easier solution.

Thanks in advance :)

poeschlr, 2017-09-26:
This is the wrong place to report such an issue.
I would suggest the [kicad forum](https://forum.kicad.info/) in this case.

It seems the project has been created with some newer version of kicad. Probably a nightly build version.

Closed 2017-09-26.

Thread 1668 (2017-09-26):

Maple Mini library symbol is for an obsolete device

rogerclarkmelbourne, 2017-09-26:
The library symbol for the Maple Mini (STM32 CPU board module) is for an obsolete device which can no longer be purchased as it was discontinued several years ago

https://www.sparkfun.com/products/retired/11280

Clones of this board are still widely available, e.g on eBay, AliExpress or Amazon etc, however their pinout is slighly different from the symbol add to the library

Specifically the AV- and AV+ pins are incorrect

https://github.com/KiCad/kicad-library/blob/master/library/modules.lib#L248
https://github.com/KiCad/kicad-library/blob/master/library/modules.lib#L275

The schematic for the clones appears to be this

http://wiki.stm32duino.com/images/2/26/Maple_mini_clone_schematic.JPG

Hence pin AV+ is now Vcc and AV- is now GND

I recommend, either the symbol name is changed to make it clear that this is for an obsolete product, or that name is changed to Maple mini (clone) and those pins changed to reflect the hardware which people can buy

bobc, 2017-10-24:
I propose to fix this by creating a new component "Maple_Mini_Clone". I am reluctant to change existing components and break back compatibility.
I have created a component, I just need to run KLC cleanup before submitting PR.

rogerclarkmelbourne, 2017-10-24:
@bobc

Sounds good to me.

Rantanen, 2018-01-06:
Good points. When I originally PR'd the Maple Mini, I knew about it having been discontinued, but thanks to the clones being available I justified the symbol anyway.

This of course resulted in the question of which pinout to implement in the symbol. My justification for the AV+/AV- pins were:

- They are documented. The current clones happen to have VCC/GND in their place, but that's not guaranteed to be the case with all the clones.
- Labeling them AV+/AV- isn't completely wrong for the clones, you can still use them as reference voltages for the analog circuitry - just a rather crappy one. The opposite of labeling them as VCC/GND and using them with the original Maple Mini would have been worse as this might have lead people to use them as "general purpose power output" when powering through USB for example.

That latter point is even worse, if labeling them VCC/GND makes KiCad insist on connecting them with the other VCC/GND pins on the PCB. As per the or iginal design, the board should be able to be powered through one pin.

In any case, if a new component is made, I'd propose it to be named "Maple_Mini_Baite", as that's [the board](https://www.robotshop.com/letsmakerobots/files/maplemini2.jpg) the proposed pinout is based on. As far as I know, that's the only clone there is for now, but there is always the possibility that might change.

Although now I'm curious. Can we add a second footprint that duplicates the VCC/GND pins and omits the AV+/AV-? Or would this need a new VCC/GND pair in the symbol?

Technically I guess this conversation belongs in the new repo, but I didn't feel like starting a new issue there.

rogerclarkmelbourne, 2018-01-07:
@Rantanen

No worries

I just thought I should let everyone know that this symbol is not correct for the clones.

I'm also not sure if all the clones are made by Baite, and even Baite now seems to have rebranded to another name (though I can't remember off the top of my head what they call themselves now)

So perhaps any new symbol should just possibly be named Maple Mini clone

poeschlr, 2018-01-20:
@rogerclarkmelbourne this repo will be archived shortly. If this particular problem still persists could you reopen this over at the new repo https://github.com/KiCad/kicad-symbols? (Add a short summary and point back to this issue)

Closed 2018-01-20.

Thread 1684 (2017-10-04):

VSOURCE symbol of pspice.lib is too huge

efferre79, 2017-10-04:
I have just installed kicad and kicad-libraries from the github repositories compiling from source. As a tutorial I am trying to draw a schematic and simulate it with ngspice. I have loaded the pspice.lib (/usr/share/kicad/library/pspice.lib) but the symbol for the VSOURCE is definitely too huge comparing to the other symbols, here is a snapshot:

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

Looking at the video tutorial https://www.youtube.com/watch?v=2WDPzW6DGzQ, it looks regular. Is it a problem of the library or kicad?

SchrodingersGat, 2017-10-04:
It does look like it needs to go on a diet. Are you able / willing to submit a pull request to address this?

efferre79, 2017-10-04:
I have just started using kicad so I don't have confidence at all with the software and the libraries, I don't think I am able right now to fix the issue by myself :-( But I am available to test the changes in the library.

SchrodingersGat, 2017-10-05:
I have submitted a change (see above).

SchrodingersGat, 2017-10-05:
This has been fixed now, thanks for bringing it to our attention.

efferre79, 2017-10-05:
I have tested the changes, now it looks better but I think it can be made smaller. I am attaching another attachment below where I put the voltmeter symbol (from device.lib) as a reference, in my opinion the circle of VSOURCE can be made as small as the one for the voltmeter.

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

What do you think?

Closed 2017-10-05.

Thread 1744 (2017-10-19):

I am creating a DC Power Supply in Kicad. I can't able to clear the error in Kicad EESCHEMA.

Nellairaja, 2017-10-19:
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
If you know how to clear a error. I need to create a footprint for this Dc power supply project. To create a DC POWER SUPPLY in PCB
Please reply me to this email id : rajatvl27@gmail.com

antoniovazquezblanco, 2017-10-19:
This is probably more suited to be posted in the forums and not library issues but anyways:

From your image you have not properly connected many components. Delete the wires with conflicts and try to wire things from the end of the pin. I've highlighted the conflicting points I could see in your image:
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

gauravjuvekar, 2017-10-19:
@Nellairaja  Please post this to https://forum.kicad.info/

Nellairaja, 2017-11-02:
In this project I am try to clear the error and reconnect the circuit with
wire... But the wire was not connected properly. I didn't know what is the
reason.... Take me how to connect the circuit with the wire tool

On Thu, Oct 19, 2017 at 1:21 AM, Jan W. Krieger <notifications@github.com>
wrote:

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

poeschlr, 2017-11-02:
Please post your question over at the user [forum](https://forum.kicad.info/). (You don't even need to create a new account. You can use single login with your github, facebook, google, ... account.)

Nellairaja, 2017-11-04:
please help me to clear the above error in this project.

poeschlr, 2017-11-04:
Again this is the wrong platform for this. Is there a reason why you think the forum is not for you?

The forum has more powerful tools for people who want to help you.

There is also a more diverse group of people available to help you.

This issue is mostly only seen by library maintainers. Which means you spam our wall instead of reaching the people who can help you.

sandhan26, 2017-11-05:
@Nellairaja you might have accidentally altered the grid size, while working with the wires. Thats why they are not connecting.

The best thing for you would be, start fresh, and be mindful of not changing the grid size, don't rush.
Trust me, i used to get a lot that.

Closed 2017-10-19.

Thread 1769 (2017-10-24):

problem with CvPcb particularly association of footprint with component through GITHUB/internet

rightwing, 2017-10-24:
I'm a novice in KiCAD so be patient. The issue is:
While following help guide of KiCAD I reached till creating netlist without error.
**When I tried to run CvPcb to associate component and footprints, it tried loading footprints from github. However this couldn't be completed** and after a very long "non-responding" session it told me so. I would like to clarify here that I sit behind a proxy network and I couldn't get to provide username or password option for this step of associating component and footprints. So, (that's what I think) it took a lot of time to give me the error list:

----
_Errors were encountered loading footprints:
IO_ERROR: http GET command failed
Cannot get/download Zip archive: 'https://codeload.github.com/KiCad/TO_SOT_Packages_SMD.pretty/zip/master'
for library path: 'https://github.com/KiCad/TO_SOT_Packages_SMD.pretty'.
Reason: 'IO_ERROR: curl_easy_perform()=7: Couldn't connect to server
from kicad_curl_easy.cpp : Perform() : line 92'
from github_plugin.cpp : remoteGetZip() : line 554_
----

Is there any way I would connect to internet for the same or a simpler way to store it locally.
I'm not sure though if I made myself clear, so please revert back in that case.

rightwing, 2017-10-24:
[Reported problem earlier](https://forum.kicad.info/t/cvpcb-does-not-see-footprints/1246/9)
is what I'm facing. I think.

bobc, 2017-10-24:
KiCad does not have any support for proxy servers, so unless you are able to setup a proxy, you can't use the online libraries in KiCad.
You will need to download the libraries and install them locally, there is a snapshot at http://downloads.kicad-pcb.org/libraries/ (download the latest footprints zip).
I recommend https://forum.kicad.info/ is generally a better place for this type of question.

rightwing, 2017-10-25:
Thanks @bobc for quick and positive reply.

rightwing, 2017-10-25:
I have a doubt though, there aint any .petty file for footprint.
And I'm quite new to KiCAD, can you suggest some link or way to add these library files to local destination and setup the environment for footprint and component association.

poeschlr, 2018-01-20:
@rightwing this is not the right place to ask for support on how to use kicad. I have written a tutorial for footprint lib installation over at the kicad forum https://forum.kicad.info/t/how-can-i-install-a-specific-version-of-the-footprint-library/9269. If you still have some questions please ask over at the forum

Closed 2018-01-20.

Thread 1771 (2017-10-25):

Why are the pinheaders 3d-shapes so extremely large?

TotalKrill, 2017-10-25:
Looking at the list in the modules/packages3d/Pin_Headers.3dshapes folder, I see that the folder on my computer is at 1.5GB. That is insane! And looking into it I see that a lot of the stepfiles are actually 3.1MB large in that folder.

I am guessing that there has been some auto-generation involved here. But maybe this should be fixed?

Shackmeister, 2017-10-25:
The biggest models are around 3 MB yes.. 1.5GB is alot indeed but so is 2200 models.
Im not sure if there is an easy way to make the models smaller, perhaps @easyw has an idea?

bobc, 2017-10-25:
STEP files are not compact, that is a well known feature. A 1 pin connector is about 40kB in STEP (versus 10kB in WRL), so 40 x 80 pins = 3.2MB, and 4 times size of WRL.

Both formats are readable ASCII, STEP is just more wordy. I don't think there is any fix that can be applied to the file size. Workarounds might be use a different file format (but STEP is the standard for mechanical design), or distribute as zip and do some "on demand" dezipping in Kicad, which requires some work at both ends.

In the race between more efficient software and faster hardware, faster hardware usually wins. I have a 2TB disk I bought several years ago, even with multiple copies of kicad repos, I have still only used 30%. I started out writing code on a computer with 1KB RAM, floppy disks stored 360KB, efficient coding was essential. Nowadays my incentive to write efficient code has reduced significantly!

tldr; buy a bigger disk, don't worry about it.

easyw, 2017-10-25:
Hi @TotalKrill
solution for your size issue:
1. you can avoid to download all 3D models

or

2. you can delete the models you don't need

**The STEP file size isn't 'insane' at all!** You can have a look at some manufacturer and if you check some similar model you will see that the size will be the very similar (in many cases it will be even bigger)
I worked closed to the FC community to improve the STEP importing/exporting and performance
you can search at FC forum
https://forum.freecadweb.org/viewtopic.php?f=9&t=23371
the file size of STEP files has been reduced up to 5 times in many cases and the KiCad library has been developed already with that feature... FreeCAD now is deploying STEP file of really small size compared to other proprietary and not sw.

Maurice

TotalKrill, 2017-10-25:
@easyw Wow, apparently the step size isnt insanely large compared to others, you are right. Its just step that is insanely large in general. And well since it is industry standard I guess it is reasonable to have it in step. I still think having 1.5GB or in my case 1% of my hard drive and 33% of my data plan for step files of pin headers is a bit overkill.

I also noticed that there is a packages3d library as well. Guessing this means that the 3d models are going to be removed from here entirely?

 I just find it a bit strange that half of the symbol library total size is step models of basically 3-4 different pin types in varying amounts. And that is without the  the 3 row versions of pin headers common in RC.

Why isnt having the different pin models just added multiple times to the footprint an option? This way we would have 3-4 different step models just iterated a few thousand times.

If I would apply a script to fix this, would that get rejected?

@bobc buying an ssd of that size to fit my laptop isnt really feasible. And I am mostly annoyed since I now have exactly no data left of my mobile data ( yes i know its my mistake ).  Luckily only for a few days.

SchrodingersGat, 2017-10-25:
> I also noticed that there is a packages3d library as well. Guessing this means that the 3d models are going to be removed from here entirely?

Yes the symbols and 3Dmodels are going to be split

> Why isnt having the different pin models just added multiple times to the footprint an option? This way we would have 3-4 different step models just iterated a few thousand times.

Arraying 3D models would be cool! Perhaps add the following parameters to a model association:

* array_x
* step_x
* array_y
* step_y

So e.g a 1x10 x 2.54mm pin header:

* array_x = 10
* step_x = 2.54

SchrodingersGat, 2017-10-25:
BTW downloading the `.tar.gz` compressed archive of the `kicad-library` repo is only ~550MB

TotalKrill, 2017-10-25:
@SchrodingersGat Yeah,  It would be cool! But I would be fine with just scripting the addition into the footprint files, since that would mean no changing of file formats etc etc.

And glad to hear they will be split! 👍

bobc, 2017-10-26:
> Why isnt having the different pin models just added multiple times to the footprint an option? This way we would have 3-4 different step models just iterated a few thousand times.

Interesting idea, I've used that method with WRL to create pin headers when I didn't have the right model available.

The primary purpose of STEP is for export to mechanical design package, not sure how having multiple pins instead of a single package will play there.

Shackmeister, 2017-10-26:
I suppose it could work, but would be kinda annoying for MCAD stuff. I can probably make the change but would like to hear other opinions, especially from @easyw

SchrodingersGat, 2017-10-26:
I would like to see if KiCad can merge the STEP files together and then export a single MCAD blob.

Then you could do some pretty cool things. Say you wanted a pin-header where only every second pin was fitted, just add two models:

1. Plastic piece
* repeat-x : 10
* spacing-x: 2.54

1. Metal pin
* repeat-x: 5
* spacing-x: 5.08

Shackmeister, 2017-10-26:
It does use OpenCascade...for stepup I suppose it would be quite easy to make it fuse all assigned models within a footprint. Same could probably be done for kicad. If arrays were supported

SchrodingersGat, 2017-10-26:
I might spend some time investigating whether such a feature would be possible

easyw, 2017-10-26:
what you need is a STEP hierarchy with external step models... I mean you build a 36pins header linking 1pin 36 times... so your STEP file contains only 1pin and the info for placement of the other 35pins...
but:
1) this is NOT supported by FreeCAD ATM for STEP files and I don't think it will be supported soon...
2) this is NOT the standard adopted by manufacturers for electronic parts nor by any other ECAD I know around ...
I wouldn't suggest to go in this direction

TotalKrill, 2017-10-27:
Do we know of any other software package that can to hierarchical step models the way you describe?

Is stepz an alternative? I also noticed there are no scripts for the pin-headers in the source version.

I also dont think git is the correct medium for finished 3d-models, a comparison would be to compile kicad beforehand, and then using git for version control of the binaries, I understand having the source files in git so they can be built locally. But anyway thats oftopic here at least.

TotalKrill, 2017-10-31:
@SchrodingersGat Did you investigate?

Even if the arrays is not supported, one could just use the component path to determine if it is the same component and then merge into a blob for exporting.

I would like this option at least.

Misca1234, 2017-11-05:
For common knowledge

If you use the "grid" utility in FreeCad, that is, have one single component and the "array it",
which is somewhat a natrual utility to use when you create one leg and then "array it" to get an easy way of setting distances

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

The step file size increase in size dramatically, much more than expected

SchrodingersGat, 2017-11-05:
I now have the "array" feature working well in KiCad. You can specify a "repeat" parameter and the offset in x/y/z axes.

* Displays properly in 3D renderer
* Displays properly in rayrtracing renderer
* Outputs VRML with multiple references to the same model
* Outputs STEP correctly

Surprisingly, the generated STEP file can be much much smaller.

e.g. export a PCB with a single footprint of a 2x33 pin header, one with the original model and one with PinHeader_1x01 model arrayed 33 times:

* Size with single model: 6.3MB
* Size with 33x individual models: 349kB

SchrodingersGat, 2017-12-11:
@TotalKrill I'm going to close this issue as we are now splitting the symbols and footprints into separate repositories.

Closed 2017-12-11.

Thread 1776 (2017-10-28):

The following libraries were not found in kicad

www2000, 2017-10-28:
Hi i wand to report that in the ubuntu build of kicald librart that is trlease on 2017-10-27 at 08:49(i beleave gmt) missing some libarys:
`
The following libraries were not found:
transistors.lib
conn.lib
74xx.lib
cmos4000.lib
display.lib
valves.lib`

poeschlr, 2017-10-28:
Is this a nightly build? If so than this is to be expected. We have already started to reorganize the lib in preparation for kicad v5. (And the nightly builds ship the libs of the same night. Your local symbol lib lists are now out of sync)

These libs have been renamed. the conn lib is now called Connector, the 74xx lib and cmos lib now have the prefix Logic_ and the transistor lib is now called Transistor.
Some other libs have also changed their name since then.
More details about the reorganization see: https://github.com/KiCad/kicad-library/issues/1402

www2000, 2017-10-28:
Thanks i have no problem with the that the symbol lib point to transistor.lib and in the my filesystem use Transistor.lib the the capital T in state of a lower case t

aurabindo, 2017-11-10:
In the git version of the libraries, some lib files mentioned in `templates/sym-lib-table` have not been updated to corresponding files in `Library/`, like stale references to `cmos_ieee.lib` instead of `Logic_CMOS_IEEE.lib`

evanshultz, 2017-11-10:
I just merged https://github.com/KiCad/kicad-library/pull/1818, which will hopefully get things aligned for now. We apologize for any potential and periodic breakage until v5 is released due to library reorganization. Thanks for reporting this issue and using KiCad!

SchrodingersGat, 2017-12-11:
@www2000 the new [kicad symbols library](https://github.com/kicad/kicad-symbols) will track the sym-lib-table file to make sure that it does not get out of step again

Closed 2017-12-11.

Thread 1787 (2017-11-01):

Incorrect pin electrical type on 74LS30.

117L7, 2017-11-01:
The 74LS30 from the 74xx library has the output pin (8) marked as an input pin. This causes ERC failures.

KiCad 4.0.7 for OS X.

SchrodingersGat, 2017-11-02:
@117L7 can you submit a PR to address this issue? This will be the quickest path to fixing :)

117L7, 2017-11-02:
Sure, how would I do that?

SchrodingersGat, 2017-11-02:
http://kicad-pcb.org/libraries/contribute/

If this all seems too much for you, perhaps someone will have time to make the fix for you.. But, if you are willing to learn, extra contributors are *always welcomed!*

bobc, 2017-11-02:
I think I already fixed this. Did you check the latest version of Logic_74xx ? It looks correct to me.

117L7, 2017-11-02:
I downloaded kicad-library-master, it looks like the libraries have been
reorganized compared to the 4.0.7 distribution.

I'll give Logic_74xx a try later today.

On Thu, Nov 2, 2017 at 3:42 AM, Bob Cousins <notifications@github.com>
wrote:

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

poeschlr, 2017-11-02:
Yes we have already started the preperation for the v5 release. You might want to use some older commit.
@jkriege2, @SchrodingersGat should we tag the last commit before we started with the reorganization?

117L7, 2017-11-02:
I tried Logic_74xx, but the problem now is the symbols are a smaller size (which is a good thing), and the shrinkage apparently caused all the devices to disconnect from the nets. I didn't expect this would happen.

I uploaded some screen shots before/after, from the original 2 to now 299 ERC errors, so the testing is inconclusive.

I was able to restore by removing the library and using the schematic redraw button.

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

poeschlr, 2018-01-09:
Not only the size did change. We also moved the power pins to a separate unit. (They where invisible pins placed at every unit in the old lib.)

This is why we will release this stuff only for the v5 release. Users will expect massive changes on a major release so the surprise will not be that bad.

poeschlr, 2018-01-20:
If the electrical types are still wrong please reopen this over at https://github.com/KiCad/kicad-symbols. Regarding recising: you will need to accept these changes as the new lib is intended for a new major release and we allow major changes there. We will try to keep the lib as stable as possible during the next stable release cycle.

Closed 2018-01-20.

Thread 1824 (2017-11-12):

Pin header wrong names by KLC?

hildogjr, 2017-11-12:
I was doing a schematic and linking the footprints. So was I quite annoying found the correct pin header.

Now reading the [KLC Conventions for Connectors](http://kicad-pcb.org/libraries/klc/) I realize that that name of the `Pin_Header` library is in the opposite order.

By this standardization I understood that, for example, the `Pin_Header_Straight_2x20_Pitch2.54mm`, `Pin_Header_Angled_2x20_Pitch2.54mm` and `Pin_Header_Straight_2x20_Pitch2.54mm_SMD` would be called `Pin_Header-2x20_Pitch2.54mm_Vertical` (or even without `_Vertical` because is the most common), `Pin_Header-2x20_Pitch2.54mm_Horizontal` and `Pin_Header-2x20_Pitch2.54mm_SMD`. Am I correctly?

Even in documentation, the example is `PinHeader_1x10_P2.54mm_Drill1.25mm_Horizontal`.

poeschlr, 2017-11-12:
The pin headers have already been renamed in the new repo. The old repo is declared a legacy repo and will be kept in its current state such that kicad v4 does not break.

New footprint repo: https://github.com/KiCad/kicad-footprints

Closed 2017-11-12.

Thread 1839 (2017-11-17):

KLC-modifications/additions

jkriege2, 2017-11-17:
Hi @SchrodingersGat @evanshultz @pointhi @poeschlr !

I would like to suggest two additions/modifications to KLC, in part inspired by the discussion https://github.com/KiCad/kicad-library/pull/1828:
1. On S3.8 (http://kicad-pcb.org/libraries/klc/S3.8/). For logic and OPAMPs that's a bit inconsistent. I would suggest to ALSO separate the Power-ports for two special cases, namely logic and OPAMPs (I think these are also the most common devices that come as multi-unit-symbols). My rationale would be: If I design a big logic-circuit, it's good to collect all the power-units at one location and connect them to the appropriate power-plabes (+caps and what not). This tidies up the schematic significantly. If we discourage extra power-symbols for single-unit logic-symbols, this will lead to a mixture, as some logic ICs have their power-pins inside the schematic (may be annoying if you change  power-suuply to them, as you have to do it for every device separately) and some are collected somewhere. Also this would allow us to make unify the single-gate-logic families. Maybe (maybe!) it is possible to design the power-symbols in a way that they can be positioned over the actual symbol (at least for gates), so they can (if wanted) be "combined" to a single device. I think @bobc has some examples of that as alternative symbol style.
2. In addition I would like to see the same exception for OPAMPs for the same reason and with the same style requirement of beeing combineable (I think that ios already common for many multi-unit OPAMPs.
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
3. I think we should encourage people to set pin-names for all pins, with only a few exceptions:
  - simple symbols like resistors, caps, ... IF non-polarized (i.e. not for diodes, elcos, ...)
  - logic-gates and output-pins of OPAMPs (there is simply no space)
  In a KLC-check these should light up as warnings, bt not as errors, as the exceptions above cannot really be caught by scripts.

What do you all think?
Best,
JAN

evanshultz, 2017-11-17:
For #1 and #2, I totally agree. I argued before for this and I can't remember why it wasn't accepted. I think separate units for power are all or nothing. And KiCad should be in the all camp.

For #3, I think it's a case-by-case basis. "Encourage" with warnings is a good compromise to me. We will want to incorporate the pin naming styles discussed at https://github.com/KiCad/kicad-library/pull/1611 to allow names and numbers on opamp pins. I like the first option but I can see both ways might be best for different parts. It's a bit annoying the offset can't be selected on a per-pin basis.

jkriege2, 2017-11-18:
@SchrodingersGat What do you think?

evanshultz, 2017-12-06:
@SchrodingersGat @poeschlr Ping!

SchrodingersGat, 2017-12-06:
I'm open to it - can you suggest a new wording for http://kicad-pcb.org/libraries/klc/S3.8/ ?

poeschlr, 2017-12-06:
I like the general idea of the suggestion in this issue. I am not sure how the current KLC would disagree with such symbols. (I think they are already accepted.)

I would not force this on all symbols. Single unit symbols should stay single unit symbols. (The handling of multi unit symbols in kicad is not that good. There is for example no ERC error if you don't place all units of a symbol.)

evanshultz, 2017-12-06:
@jkriege2 I don't see S3.8 discriminating between logic and opamps. It would seem to apply to them both. What is the wording that you dislike?

Perhaps this is a good time to discuss the power symbol design. Does it have a box? Just floating pins (my preference and it also works best if overlaying the gate and power pins as done above). If a box, how big is the box? Is the box filled? Where are pin numbers and names placed around the power pins?

Hmm... no ERC to catch missing units is a problem. Does anybody know if this is in v5 or coming later? Regardless, our multi-unit symbols are already suffering from this issue so why would that stop the single-gate symbols? It does increase the number of symbols that are broken in this way, but I support updating KLC for this and then doing the work when time allows after v5.

jkriege2, 2017-12-07:
This is already a few weeks old ... so maybe I don't remember every detail from then. I think it cooks down to this:

- For OPAMPP and Logic: ALWAYS separate power-pins, so these are consistent over the whole family even if there is only a single device in the package (single OPAMPs / single GATEs)
- I think then having an image showing logic+OPAMP would be great!

About the power-symbol design: I would prefer simply two lines (quite common in other ECAD-programs) + they can easily be combined with the actual symbol. Maybe we should play around a bit with the size to match all possible gates and OPAMPs ... do we need maybe different sizes for the two?

JAN

poeschlr, 2018-01-20:
@jkriege2 if this is still relevant please reopen it over at the new repo. Add a short summary and link back to this issue

Closed 2018-01-20.

Thread 1843 (2017-11-18):

Wrong transistor symbols

bbrandst, 2017-11-18:
The schematic symbols of some transistors in Transistor.lib are not correct.
For instance, both BF244 and BF245 are actually N-JFETs, but in current Git, BF244 is shown as a bipolar transistor while BF245 is presented as a MOSFET. Possibly other transistors are affected as well.
I'm not quite sure but I think this happened during commit 0b9d383.

poeschlr, 2017-11-18:
Mistakes are always possible. (We librarians are not all knowing.)

Car to fix it?

jkriege2, 2017-11-18:
Hi!

I'm already at it (+ some more fixes in that lib) ... might take 1-2 days, but a fix will be posted ;-)

cu
JAN

jkriege2, 2017-11-18:
fixed in here: https://github.com/KiCad/kicad-library/pull/1844

SchrodingersGat, 2017-11-18:
Fixed in #1844

Closed 2017-11-18.

Thread 1864 (2017-12-01):

INA138/INA168 Schematic symbol has incorrect pinout (again)

danwood76, 2017-12-01:
Hi,

This is a repeat of the previous issue I raised with the INA138/INA168 pinout (Issue: #1631). I recently re-opened the project that I used the INA138 in to find it wanted to change the pin out back to the original broken version.

I double checked and the fix that I proposed (and that was accepted) appears to have been reverted by commit c64c1d6.

The pinout of the device is clearly documented and hasn't changed, why was my change reverted?

Regards,
Danny

bobc, 2017-12-02:
I think that was just a screw up with someone's branch. Sometimes the history gets confused, and an accidental change gets confused with a good commit. People then incorrectly revert the good commit...

I guess the thing to is to recreate a pull request.

poeschlr, 2018-01-20:
@danger89 a better option than opening an issue is to fix it and open a pull request.

As we already transitioned over to the new repo i will close this here. I opened a new issue over at the new repo: https://github.com/KiCad/kicad-symbols/issues/181

Closed 2018-01-20.

Thread 1882 (2017-12-29):

Wrong footprint for TXB0108DQSR in library "texas"

troisiemetype, 2017-12-29:
As the title says, the footprint for this component is wrong. The left side (pins from 1 to 10) is for a DQS (USON) package, and the left side for a PWR (TSSOP) package.
The datasheet from TI, see page 3: http://www.ti.com/lit/ds/symlink/txb0108.pdf

I wish I had seen it before I order three prototypes of a PCBA using this part... :(

poeschlr, 2017-12-29:
The footprint is correct (for the component with that order number)

However you are right the pin numbers are wrong. This should be fixed in the new repo https://github.com/KiCad/kicad-symbols

(There will not be a further release using this legacy repo)

So please open a new issue over at the correct repo. And please make sure the title says something about wrong pin numbers not wrong footprint. (Again: the footprint field is correct for this part number)

troisiemetype, 2017-12-30:
Thank you for your answer.
I'm sorry for the wrong title. You're right, the footprint is ok, the pin numbers are not. Shall I Edit the title?
I don't see this chip in the repo you gave the link for; Is it intended to include it at some point? A new issue for a component not to be included would be superfluous...

poeschlr, 2017-12-30:
The texas lib should have been transferred already. (This was the pull request responsible: https://github.com/KiCad/kicad-symbols/pull/109)

poeschlr, 2018-01-20:
@troisiemetype if the problem persists in the new lib, please open a new issue

Closed 2018-01-20.
