KiCad/kicad-library/(commit log)

2015-10-27 Added 3D files for JST_XH_B02B connector
2015-10-27 Removed extraneous connector 3D shapes
2015-10-27 Added lots of 3D shapes for the JST series connectors Ignore .wings~ files in .gitignore
2015-10-27 Added 3D files for a lot of Molex connectors:
    Panelmate series
    Microlatch series
    Pico-EZMate series
2015-10-27 Added 3D models for the Hirose DF13 series of connectors
2015-10-28 Changes to the 3D models for the Pheonix PT series terminal blocks to match the footprint fixes
2015-10-28 Revert "Added 3D models for the Hirose DF13 series of connectors"
    This reverts commit 129736173cc4e6ecff96d7941a2b5f2cb50be475.
2015-10-28 Revert "Added 3D files for a lot of Molex connectors:"
    This reverts commit 109335d0e03b60d91b9e38a5277f7a0a12123278.
2015-10-28 Revert "Added lots of 3D shapes for the JST series connectors"
    This reverts commit de1ac0e02d7dde1f8cc9fb030cb40ca899d9639c.
2015-10-28 Renamed 3D files for the JST connectors to match the JST part naming convention
2015-10-28 Revert "Added 3D files for JST_XH_B02B connector"
    This reverts commit 5d9eb6b89b59ff2066dfe5e1f8a679fcc30ae3ba.
2015-10-28 Added symbols for the LTC4440 high-side gate driver IC
    http://cds.linear.com/docs/en/datasheet/4440fb.pdf
2015-10-29 Added 3D shapes for the JST B10B-PUDSS connector
2015-10-29 Shifted pins onto grid and adjusted text sizes in stm32.lib
2015-10-29 Added description to the LED symbol
2015-10-29 Added description for SMD crystal in device.lib
2015-11-02 Added MAX4081 high-side current sensor IC
    http://datasheets.maximintegrated.com/en/ds/MAX4080-MAX4081.pdf
2015-11-02 Renamed MAX4081 to MAX4081F (5V/V gain) Added aliases for 20V/V and 60V/V parts
2015-11-03 Added the LTC4359 ideal diode controller with reverse polarity protection
2015-11-03 Added the ADS1120 ADC with SPI interface and internal/external reg
2015-11-03 Fixed pin types of ADS1120
2015-11-03 Added MAX6100 voltage reference
2015-11-03 Added MAX610x series of precision voltage regulators
2015-11-03 Added smaller schematic symbol for the DPST switch
2015-11-03 Added FDS5680 FET (SOIC-8 package)
2015-11-04 Added 3D file(s) for Keyston MINI fuse holder 3568
    http://www.keyelco.com/product.cfm/Mini-Blade-Fuses/Vertical-Entry-Mini-Auto-Blade-Fuse-Holder/product_id/306
2015-11-04 Added the allegro-micro ACS722LLCTR series of hall-effect current sensors in SOIC-8 package
    http://www.allegromicro.com/~/media/Files/Datasheets/ACS722-Datasheet.ashx?la=en
2015-11-05 Added footprint filter values
2015-11-05 Pin type fixes for the BQ76940
2015-11-05 pin type fixes for the LTC3630
2015-11-05 pin type fix for the TCM809
2015-11-15 Fixed some repetition. Tagged as 1.0 for the KiCad 4.0.0 release.
2015-11-17 Remove the deprecated pretty libraries for the KiCad 4.0.0 release
    Pretty libraries removed:
    Capacitors_Elko_ThroughHole.pretty
    Housings_SOT.pretty
    Housings_SOT-23_SOT-143_TSOT-6.pretty
    Housings_SOT-89.pretty
    Housings_TO-12_TO-18_TO-42_TO-43.pretty
    Housings_TO-50.pretty
    Housings_TO-78.pretty
    Housings_TO-92.pretty
    Transistors_SMD.pretty
    Transistors_TO-220.pretty
    Transistors_TO-247.pretty
    Power_Packages_SMD.pretty
    Power_Packages_ThroughHole.pretty
    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
2015-11-17 Fixed pin grid issues (KLC Rule 3.1) for the PIC18F45K80-I/ML and PIC18F45K80-I/PT
2015-11-22 Fixed pin lengths and misc.
2015-11-28 Enforced a maximum pin text and num size of 50mils
2015-11-28 [fix] scale down diode bridge
2015-12-03 Transistors: fixed PN2222A
    Fixed pinout to match datasheet
    Changed keywords to words that are related to the part
    Removed default non-existant footprint. The filter is set correctly, so
    it should be easy to find a correct footprint.
2015-12-03 Added LED driver IS31LT3360
    Added the ISSI switching LED driver IS31LT3360,
2015-12-08 Add 3d model for PTS645 Series 6 mm Tact Switch 4.3mm height
2015-12-12 [enh] improve footprint for SSR made by Sharp
2015-12-15 updated CYBL10x6x-56LQ pin spacing
2015-12-20 [fix] typo Relais -> Relays
2015-12-20 updated pin lengths and descriptions for CYBL10x6x-56LQxx, CY8c4xx7LQI-4xx, CYBL10563-68FLNXIT and associated aliases.
2015-12-28 fixed wrong pin number
2016-01-02 Fixes for 2SA1016, 2SB631, 2SB817.
    a.)2SA1016 renamed to 2SA1015
    b.)Vce and Ic for 2SAxxxx and 2SBxxxx devices corrected.
2016-01-05 Added STM32F030F4 to STM32 Library
2016-01-09 fix pin numbers/types and description
    fix 74LS122, 74LS123, 74LS133, 74LS137, 74LS151, 74LS390, 74LS73 pins
2016-01-10 Changed electrical type of Vcc pin on the MCP16311 series chips
2016-01-12 Added LTC3630A (alias of LTC3630 with higher input voltage spec.)
2016-01-12 Integrating changes from kicad-library master branch
2016-01-14 3D model for Omnetics MCS-05-DD Connector
2016-01-14 Added 3D model for JST_B2PS-VH connector
2016-01-14 Added 3D model for Molex Pico-Lock 04x1.00mm connector
2016-01-14 Added 3D files for Molex Lite-Trap 02x4.00mm connector
2016-01-14 Added 3D model for the Hirose_DF61_02x2.20mm connector
2016-01-16 Add WS2812 LED family & their 3D models
2016-01-18 Added the LTC3886 dual-output 60V buck controller with I2C telemetry http://www.linear.com/product/LTC3886
2016-01-19 L200 regulator added
2016-01-21 Added MCP4728 quad 12-bit DAC with I2C interface Checked against KLC
2016-01-28 Removed duplicate pin on the MAX1161x
2016-01-28 Changed pinout of dual op-amp (e.g. LM7332) so that power pins are not duplicated across both units of the part
2016-01-29 Added STM32F303CC
2016-01-29 Updated pins for the STM32F303CC
2016-01-31 IRS2181 add to IR lib.
    IRS2181 symbol added.
    Symbol is created for clear schematic drawing.
2016-01-31 Renamed 3D models for the JST connectors
2016-02-01 Pin type changes to the ADP2108 Added TPS560200 switching regulator
2016-02-02 Added 3D files for the J2000 dual row connectors
2016-02-02 Added footprint to part description for the LTC3890
2016-02-02 File naming fixes for the EH series of JST connectors
2016-02-02 Renamed ZE series 3D files for the ZE JST connectors
2016-02-03 Added description for SPST switch in device.dcm
2016-02-03 Fixed KLC violatoins for LED_DUAL and Switch_DPST_Small
2016-02-03 Fixed text size for Switch DPST_Small
2016-02-03 Added 3D model for the PowerPAK SO-8
    e.g. http://www.vishay.com/docs/73988/si7852ad.pdf
2016-02-03 Corrections of l200 regulator
2016-02-03 [enh] add TPS793** Low Drop Voltage regulators
    datasheet: http://www.ti.com/lit/ds/symlink/tps793.pdf
2016-02-04 Create sanken.lib and add some motor drivers
2016-02-04 Add pcb footprint text to SLA7070MPRT and SLA7075MPRT
2016-02-04 Updated part descriptions for ACS712 series bidirectional hall-effect current sensors
2016-02-09 Add PT2399 to adc-dac.lib
    - Echo Processor IC
    - CMOS ADC DAC 44K Digital processing VCO
    - KLC Compliance
2016-02-09 Add LSM303D to sensors.lib
    LSM303D 3D Acc and Mag. LGA 3x3 mm16L pitch 0.5mm
2016-02-09 LGA 3x3mm 16L pitch0.5mm package
2016-02-10 Added 3D model for WE (Wurth) HCF inductor package http://katalog.we-online.de/pbs/datasheet/7443633300.pdf
2016-02-12 Changed references of ACSxxx current sensors from "IC?" to "U?"
2016-02-12 Renamed Inductor_IHLP6767 to Inductor_IHLP-6767 Added 3D models for the Vishay POWERDI-123 diode package
2016-02-14 Added 3D models for Wurth HCI-1890 inductor
    e.g. http://katalog.we-online.de/pbs/datasheet/74435574700.pdf
2016-02-15 Updated description for EMI filter / ferrite bead
2016-02-15 Changed some devices in sensors.lib to not show footprint labels by default
2016-02-15 Added 3D files for the JST J4200-BC02B connector
2016-02-15 Added 3D models for the JST_J320_B02B-F32SK_02x5.08mm_Straight_PTH connector
2016-02-16 Added 3D files for angled JST J2100 connector
2016-02-16 Added / fixed 3D files for the XH series of JST connectors
2016-02-16 Changes to PUD and SFH series connectors
2016-02-16 Added 3D models for PUD series connectors
2016-02-16 Renamed GH connector 3D models
2016-02-16 Added _PTH suffix to J2100 connector 3D files
2016-02-16 Pin length fixes to Q_NMOS_SSSGDDDD
2016-02-17 Added 3D model for the JST_J2100_S20B-J21DK_2x10x2.50mm connector
2016-02-17 Added 3D model files for the JST_PUD_S22B-PUDSS_2x11x2.00mm connector
2016-02-17 Added JST_J320_S02B-F32SK connector 3D models
2016-02-17 Fixed descriptions for MAX4081x series chips Fixed pin types for MAX4081x series chips
2016-02-19 Added PUD series 3D model Renamed a file from .wrl.wings to .wings (oops)
2016-02-21 Removed extraneous 3D models of 2mm pin headers
2016-02-21 Auto-generated STM32 library using https://github.com/ObKo/stm32-librarygen
2016-02-21 Removed (old) 3D models for 2.00mm pitch pin headers
2016-02-21 Added 3D models for 2.00mm pitch pin headers
    These models were originally downloaded from http://smisioto.no-ip.org/elettronica/kicad/kicad-en.htm
2016-02-21 Removed old 2.00mm socket-strip 3D models
2016-02-21 Added 3D models for the 2.00mm pitch series of Socket Strips
2016-02-22 STM32: Add obsolete STM32F050xx and STM32F313xx parts.
2016-02-22 Renamed EH series 3D footprints
2016-02-22 Renamed EH series connectors (slightly) to match datasheet naming schema
2016-02-22 Revert "LGA 3x3mm 16L pitch0.5mm package"
    This reverts commit 2fc831a436a1b0e9e25f2611b5d796ba2669e651.
2016-02-22 device: fix polarized capacitor footprint filter
2016-02-22 Fix small polarized capacitor footprint filter
2016-02-23 Big cleanup of 3D models for Hirose connectors
2016-02-23 Renumbering of DF13 connector 3D models
2016-02-23 device: simplify and fix led footprint filters
2016-02-23 device: fix inductor footprint filters
2016-02-23 Padded pin-numbers with zeros so that they appear in the library selector dialog in the right order
2016-02-23 Removed "Connector_" prefix for DF61 and DF63 3D models
2016-02-23 device: add "Coil" to inductors footprint filters
2016-02-26 Added 3D model for the LGA-16_3x3mm_Pitch0.5mm
2016-02-28 Renamed 3D files for Molex Pico-EZMate series connectors
2016-02-28 Added 3D models for Molex Pico-Lock 1.50mm connectors
2016-02-28 Renamed 3D models for Molex Panelmate connectors to match KLC naming
2016-02-29 Updated 3D model for the XT90 male connector
2016-02-29 Added 3D model for the Crystal_SMD_5032_2Pads footprint
2016-02-29 Added 4-pin version of crystal (some SMT crystal devices have two ground pins)
    e.g. http://www.abracon.com/Resonators/abm3b.pdf
2016-03-01 Pulled all changes from device into master
2016-03-02 add max1248/max1249 10-bit 4-channel adc
2016-03-03 rebuilt shematic and fix librairie
    [Arduino_As_Uno.kicad_pcb, Arduino_As_Uno.sch, Arduino_Fio.kicad_pcb, Arduino_Fio.sch, Arduino_Mega.kicad_pcb, Arduino_Mega.sch, Arduino_Micro.kicad_pcb, Arduino_Micro.sch]
2016-03-04 Added LTC6082 - precision quad opamp and LTC6362 - differential ADC driver.
2016-03-05 fix TPS560200 pin type
2016-03-06 Changed pin type of pin GND to power input of INA282
2016-03-06 Add Connectors_JST
2016-03-07 TUSB2036: double checked pins & some corrections
    changed the box width 10 mils and added the missing footprint fields
    (which I removed manually by mistake)
2016-03-07 Added Texas Instruments NexFET N-Channel MOSFETs in SON8_5x6mm package
2016-03-07 Added Infineon OptiMOS BSC** series MOSFETs
2016-03-08 Added manufacturer info to CSD* MOSFET series Also added footprint filter
2016-03-08 Added 3D model for USB_Mini_B connector
2016-03-09 Add LTC1044 to dc-dc.lib
    - add Switched Capacitor Voltage Converter LTC1044 to dc-dc.lib, alias MAX1044 and ICL7660
    - add Switched Capacitor Voltage Converter LT1054 to dc-dc.lib
    - KLC compliance
2016-03-09 Create bbd.lib
    - create new component library for Bucket Brigade Delay (BBD) chip
    - includes MN3005, MN3007, MN3101, MN3102, MN3207, RD5106A, SAD1024 and TDA1022
    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
2016-03-09 Removed power-management components from Currawong.lib (now in power-management.lib)
2016-03-09 Some components were in interface.lib that would be better suited to power_management.lib.
    The following components have been moved:
    Removed LM5060
    Removed LT1641-1
    Removed LT1641-2
    Removed MIC2587-1
    Removed MIC2587R-1
2016-03-10 Added description info to the (existing) LM5051 KLC fixes for the LM5051 (electrical pin types)
2016-03-10 Added LTC4364 ideal diode controller with UV/OV lockout and reverse polarity protection Refer to http://www.linear.com/product/LTC4364-1 Added symbols for 16-pin version (SOIC / MSOP)
2016-03-10 Added DFN-14 package version of LTC4364 ideal diode controller
2016-03-11 Added 3D model for the JST AUH_BM05B-AUHKS-GA-TB connector
2016-03-13 change MN3101 alias and fix TDA1022 pin setting in bbd.lib
    - made MN3102 alias to MN3101
    - unset check "Common to all units in component" for pin9,pin13,pin16 in TDA1022
2016-03-13 [enh] add Connectors_Multicomp.pretty to fp-lib-table
2016-03-14 Fixes for MAX777 - Added documentation - Fixed pin types - Improvements to schematic symbol
2016-03-14 Removed MCP141x series of MOSFET drivers (moved to power-management.lib)
2016-03-14 Added footprint filter for MAX3051
2016-03-14 Added footprint filters for LTC2875 chips Improved description for LTC2875 chips
2016-03-14 Added fp filter for ADM232A Improved description for ADM232A
2016-03-14 Removed MAX232 (now alias of ADM232A) Improved description for ADM232A Removed MAX222 and MAX242 alias (not aliases of the part) Removed footprint filter for ADM232A
2016-03-14 Added footprint filters and fixed description for MCP100 and MCP101
2016-03-14 Removed LTC4440* parts (to power-management.lib)
2016-03-14 Added LTC4440 series chips High-side, N-Channel MOSFET drivers
2016-03-15 Added 3D model for DFN-8-1EP_6x5mm_Pitch1.27mm
2016-03-16 Changed layout a bit. Renamed Ct to TC. Pin types changed according to their characteristics (open collectors and emitters).
2016-03-16 Pin types changed to passive
2016-03-17 Changed footprint filters.
2016-03-17 * removed wrong aliases * removed wrong footprint filters * set component's rectangle background color * set component's footprint PSOP-44
2016-03-18 Fixed naming of JST PUD connectors
2016-03-19 [enh] add Connectors_Hirose.pretty to fp-lib-table
2016-03-20 Removed old JST connectors 3D
2016-03-20 Modified LPC812M101JD20. * Fix position of fields * Add footprint filter * Fix description
2016-03-21 align pin-2 of the bottom
2016-03-24 Changed GND pin type Added NC pins
2016-03-25 Add 3d model for LED_PLCC_2835
2016-03-30 Modified LT1761 LDO regulators family.
    More compact design now. Changed names of particular devices to match
    pinouts and part numbers from the datasheet (page 2, section Pin
    configuration).
2016-03-30 Added LT6106 - low cost high side current sense amplifier.
2016-03-31 Added 3D models for 2.54mm Box Headers - STEP and (scaled) VRML pairs
2016-04-03 Add Microchip TC1262-33VDB voltage regulator
2016-04-04 Moved MIC2026 to power_management.lib
2016-04-04 Improved schematic symbols for MAX1647 and MAX1648
2016-04-04 Added MIC2026 high side power distribution switch(es)
2016-04-04 Changed shape of ADS1120-PW to match other ADC chips
2016-04-07 Added GND pad to STM32
2016-04-07 Replaced LGA model with proper STEP/WRL pair Generated using https://github.com/easyw/kicad-3d-models-in-freecad
2016-04-10 Merged ground pins of TC1262-33VDB. Fixed placement of footprint and reference. Fixed footprint filter.
2016-04-10 Added all voltage variants of TC1262-xxVDB
2016-04-10 Added full description for MCP9700/MCP9700A series of temperature sensors http://ww1.microchip.com/downloads/en/DeviceDoc/21942e.pdf
2016-04-11 Added MPXA6115A pressure sensor Added MPXAZ6115A alias Added MPXH6115A alias Added MPXHZ6115A alias
    Ref: http://www.nxp.com/files/sensors/doc/data_sheet/MPXA6115A.pdf
2016-04-11 Added 40PC pressure sensor range
    http://www.honeywellscportal.com//index.php?ci_id=138832
2016-04-11 Resaved sensors.lib with newer KiCAD version
2016-04-11 Resaved sensors.lib
2016-04-11 Resaved sensors.lib with new KiCAD version
2016-04-11 Fixed text size on 40PC sensor
2016-04-11 Added LIS2DH accelerometer
2016-04-11 Added long description. Saved with KiCad 4.0.2. Changed pin types.
2016-04-11 Added description for ZENERsmall Saved device.lib with new KiCAD version
2016-04-11 Added tags for small symbol diode
2016-04-11 Better description for EMI filter Rename EMI_FILTER2 to EMI_FILTER_Small
2016-04-11 Added description for Fuse KLC for fuse
2016-04-11 Added description for LED symbol
2016-04-11 Description for LED_Small and Dual LED
2016-04-11 Improved description and tags for switch simple
2016-04-11 Added SPST_Small switch symbol
2016-04-11 Renamed SWITCH_INV to Switch_SPDT
2016-04-11 Improved switch descriptions
2016-04-11 Renamed SWITCH_INV_MSM to Switch_SPDT_MSM Improved description for Switch_SPDT_MSM
2016-04-11 Separated MAX1343xx chips into proper footprint arrangement Added aliases Added datasheet Added footprint Fixed footprint filter(s)
2016-04-11 KiCAD update
2016-04-12 Added A110xxLHL series of hall-effect switches Ref: http://www.allegromicro.com/en/Products/Part_Numbers/1101/1101.pdf
2016-04-12 Changed visibility of NC pin on TPS62177 (needs to be visible to connect to GND)
2016-04-12 Fixed duplicate pin on TPS62170
2016-04-12 Added AP131-xx series of LDO linear regulators http://www.diodes.com/_files/datasheets/AP131.pdf
2016-04-12 Added LM1117 series of linear regulators http://www.ti.com/lit/ds/symlink/lm1117.pdf
2016-04-12 KLC for LED_Small
2016-04-12 KLC for switches
2016-04-12 KLC for speaker, zener diodes
2016-04-12 Pin fixes for LM3480 series
2016-04-12 KLC pin fixes for LM3480
2016-04-12 Fixed Vdd pin type
2016-04-12 Fixed pin positioning KLC
2016-04-13 STM32: Fixed missing power pads in some parts.
2016-04-13 Add 2N7002 N-MOSFET transistor
2016-04-13 Changed footprint spelling to SOT-23-6
2016-04-13 Harmonized DS3231 pin descriptions
2016-04-13 Moved DS3231 non connected pins at same place as ground. Moved labels at places required by extra checks.
2016-04-13 Removed internal symbol. Fixed footprint references.
2016-04-13 Added AMS magnetic rotation sensors AMS5048A AMS5048B AMS5050A AMS5055A
2016-04-13 Removed TCM809 (and misspelled part TMC809) Resaved with new KiCAD
2016-04-13 Added AD7171 16-bit ADC http://www.analog.com/media/en/technical-documentation/data-sheets/AD7171.pdf
2016-04-13 Pin fixes for: AD5280 AD5282
2016-04-13 Fixed footprint filter
2016-04-13 Moved GND/V+ to bottom/top edges. Changed switched pins to passive. Removed Texas Instruments from keywords.
2016-04-13 Fixed keywords for TPS62175/TPS62177 Removed explicit datasheet for TPS62175/7 Fixed pin naming for TPS62175/7
2016-04-13 Fixes for TPS62170 - Fixed footprint - Removed explicit datasheet - Pin alignment with TPS62177 symbol Better descriptions for TPS6217x parts
2016-04-13 Fixed MAX232 footprint to match LT1080 Better description for MAX232 Added MAX232I alias
2016-04-13 Fixed duplicate pin
2016-04-14 Added the MCP2562 series of CAN chips Ref http://ww1.microchip.com/downloads/en/DeviceDoc/25167A.pdf
2016-04-14 Added "5v supply" to MCP25xx chips
2016-04-14 Removed explicit footprint fields Added wildcard to fp filters
2016-04-14 Removed explicit fp Removed redundant "sensor" tag
2016-04-14 Fixed pin names and positions
2016-04-14 pin name fix
2016-04-14 Updated KiCAD
    [Arduino_As_Uno.kicad_pcb, Arduino_As_Uno.sch, Arduino_Fio.kicad_pcb, Arduino_Fio.sch, Arduino_Mega.kicad_pcb, Arduino_Mega.sch, Arduino_Micro.kicad_pcb, Arduino_Micro.sch]
2016-04-14 Improved description for ADS1120-PW Fixed fp-filter
2016-04-14 better description and pin fixes for ADS1120
2016-04-14 Reorganised pins. Fixed footprint filter. Added aliases for all Si473x series.
2016-04-15 Added Texas Instruments TLC555 timer
2016-04-16 Changed pin type and visibility.
2016-04-16 Improved shape. Blanked FP field. Added SOIC-16 to description. Added I2C to keywords, removed maxim and dallas. Added wildcard to FP filter. Changed type of pin for SDA and RST.
2016-04-16 Fixed FP filters and SPLIT pin for MCP25xx series of CAN transceivers
2016-04-16 Pin fixes for ADM3053
2016-04-16 FP filter fixes for LTC2875* FP filter fixes for MAX3051
2016-04-16 Footprints for LTC2875*
2016-04-16 Added default fp and fp-filter for: LIS2DH LIS2331HH Consolidated symbols for LIS2DH and LIS331HH
2016-04-17 Fixed references to footprint
2016-04-17 Fixed pins, foorprints, for AS50xx series hall effect sensors
2016-04-17 Flipped horizontal pin positions
2016-04-17 Fixed pin names to match datasheet
2016-04-17 Fixed FP field and wildcard added to FP filter
2016-04-17 Fixed keyword discrepancy Fixed FP filters
2016-04-17 Added TAB pin for AP1117 (invisible)
2016-04-17 Reorganised pins to keep RCLK and DCLK close. Made two grounds and pin numbers visible.
2016-04-17 Re-added LM1117 components as copy of AP1117 Invisible TAB pin sits over Vout pin Improved FP filters
2016-04-17 FP filter and association fixes
2016-04-17 Fix fp filter and association
2016-04-17 Better description Fixed FP filter and association
2016-04-17 Added better separation lines Fixed FP filter and association
2016-04-17 Fixed FP filter and association Fixed pin lengths
2016-04-17 Added 'uart' keyword to RS232 chips
2016-04-17 Fixed pin types
2016-04-17 Reorganised pin positions
2016-04-17 Revised FP field and filter. Updated pin type for RST and SDA.
2016-04-17 Fixed FP filter for DFN part
2016-04-17 improved fp filter for ADUM?160
2016-04-17 Fixed accelerometer descriptions Fixed accelerometer fp-filters
2016-04-18 Pin type change
2016-04-18 Unified symbols and fixed pin names
2016-04-19 Removed devices from interface.lib
2016-04-19 Improved symbol. Revised footprint field and filter.
2016-04-19 Revised documentation and footprint references
2016-04-19 Revised symbol, documentation and footprint references
2016-04-20 Added LMT8? temperature sensors in SC-70-7 package
2016-04-20 Fixed keywords; fixed FP field on *-BYP.
    Keywords:
    regul -> regulator;
    added positiv, adjustable where necessary.
    FP field position shoul know match other symbols from the family.
2016-04-21 Added SPI/I2C tags
2016-04-21 Pin name fixes for LT1080
2016-04-21 Deleted ON/OFF pin for MAX3226
2016-04-21 consolidated pin naming for RS232 chips
2016-04-23 Added MCP16301 / MCP16301H Footprint and pin fixes for MCP16311/2 Consolidated symbols
2016-04-23 Fixes
    LSM303D/DLHC C1 pin to passive and footprint filter fix
    IR Gate drivers description fix, pin type fix and footprint filter fix
2016-04-23 Revised current unit; added Vds and Id
2016-04-24 Centered symbols for MCP** parts Changed pin types for PAD and Vcc pins Added trailing * to FP filters
2016-04-24 Added 'connector' keyword to CONN_0?x?? symbols Fixed description of RJ45 connector Removed INV3 changed 'CONN' keyword to 'Connector' where applicable
2016-04-24 Added MCP2515
    MCP2515 is a CAN controller from Microchip.
    http://ww1.microchip.com/downloads/en/DeviceDoc/21801e.pdf
2016-04-24 Inverted pin location
2016-04-25 MAX3051: Changed "Vss" label to "GND"
2016-04-25 Changed pin types of Vref and Vio pins for MCP can chips
2016-04-25 Fixed FP filters and default associations for all MCP25?? chips
2016-04-25 Fixed FP filters for other CAN chips
2016-04-25 Reversed vertical order of TXD/RXD pins (placing TXD pin at the top of the symbol)
2016-04-25 Improved FP filters for DFN MCP163* parts
2016-04-25 linear/lm386: add missing pin and slightly redrawmage
2016-04-25 near/LM733CH: slightly redraw. Add footprint filter
2016-04-25 linear: minor grafical changes to numerous OpAmps
    Mostly outline of OpAmps fixes, but also added footprint filters,
    documentation links and some align fixes.
    Also added an alias to 555 timer.
2016-04-25 LTC3525 is fixed in "regul" library checked using checklib.py script. Alliases are added (with different output voltages and different datasheets).
2016-05-02 New components to regul.lib: LTC3429/LTC3429B
    LTC3429 and LTC3429B (as an allias) are added to regul.lib. Footprint filters are added according to comments in #455. They are created by modifying LTC3525.
2016-05-03 Added NXP LIN driver TJA1021 and TJA1029, added NXP CAN driver TJA1049
2016-05-07 Add symbols for Atmel ATmega328PB
    This parts is only available in TQFP and QFN packages. I didn't see
    any of examples of exposed-pad QFN in the symbol library, but I saw one
    footprint that used N+1 as the pin number for the pad so I went with
    that.
2016-05-07 Better footprints
2016-05-07 Improve centration, add FP filters
2016-05-08 Moved location of footprint field for multiple CAN chips
2016-05-08 split keyword "voltage-regulator" into "voltage regulator"
2016-05-10 Renamed batt to battery_management
2016-05-11 Added Diodes Inc. PAM8301
2016-05-13 Added Fairchild N-Channel mosfets in 5x6mm SON8 package
    https://www.fairchildsemi.com/products/discretes/fets/mosfets/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
2016-05-16 Fixed duplicate pin for IR2104
2016-05-16 Removed "dev" keywork Improved descriptions for schottky diodes
2016-05-16 increased pin-length of SW_PUSH_SMALL for KLC compliance
2016-05-16 Reverted pin-length increase
2016-05-16 Fixed default footprints and footprint filters for a number of RS485 ICs in interface.lib
2016-05-16 Reverted SW_PUSH_SMALL to kicad/master
2016-05-17 fix pin types Vin - power input STAT - open collector CTL - input GATE - output clear datasheet field set NC pins invisible fix link in documentation fix FP filters to MSOP-* only
2016-05-17 switch keyword improvements
2016-05-17 Changed SO-8 footprints to SOIC-8; modified footprint search pattern to match library footprints
2016-05-20 Added 3P and 4P crystal symbols Removed CRYSTAL_SMD Changed designator on existing crystal symbols from "Y?" to "X?" Resaved with new KiCad library version
2016-05-20 Pin placement fix
2016-05-20 Moved SPLIT pins between CANH and CANL pins for all CAN chips with a SPLIT pin
2016-05-21 Revert "Pin placement fix"
    This reverts commit cbd242ba8afab6c91d72f29f30b88145b229d761.
2016-05-22 Renamed 3D models according to the changes in footprint names
2016-05-22 * Added rotary encoder, dual output * Added rotary encoder, dual output, with integrated push-button switch
2016-05-23 * Added MAX610? series of voltage references * Re-saved references.lib with recent KiCad version
2016-05-24 Revert commit ca7e974
    [Arduino_As_Uno.kicad_pcb, Arduino_As_Uno.sch, Arduino_Fio.kicad_pcb, Arduino_Fio.sch, Arduino_Mega.kicad_pcb, Arduino_Mega.sch, Arduino_Micro.kicad_pcb, Arduino_Micro.sch]
2016-05-24 swapped SPI and CAN
    As of Shrodingersgat request, swapped the buses sides.
2016-05-24 Improvements to dc-dc parts
    **dc-dc.lib**
    * Added MCP16301 with MCP16301H alias
    * Added default footprints and filters for MCP16311* parts
    **dc-dc.dcm**
    * Added description for MCP16301/MCP16301H switchers
    * Improved tags for LTC3890 / LTC3890-1
    * Improved description/tags for MCP16311-* parts
2016-05-24 **Power_Management.lib** * Fixed package referenced for LM5051 * Fixed symbol for LM5051 * Added multiple power-management parts
    **Power_Management.dcm** *(new file)*
    * Added .dcm file
    * Added descriptions for already-existing parts
    * Added descriptions for all new parts
2016-05-24 This PR adds the MAX610x series of precision voltage references https://datasheets.maximintegrated.com/en/ds/MAX6100-MAX6107.pdf
    ##Files changed:
    **references.lib**
    * Added MAX6100 symbol with multiple aliases
    * File has been saved in new KiCad version so there are multiple small changes throughout the file
    **references.dcm**
    * Added description for each MAX610x ALIAS
2016-05-24 Added current sensor alias
    This PR adds the alias *ACS758LCB-100B* to the existing symbol *ACS754SCB-200*
    * Added alias
    * Added description to sensors.dcm for new part
2016-05-24 Added ADC and DAC chips
    This PR adds multiple ADC and DAC chips to the adc-dac library
    * ADS1118
    * ADS1120
    * MAX1161x
    * MCP4728 (DAC)
2016-05-24 Added MAX3221 RS232 transceiver
    This PR adds the MAX3221 RS232 transceiver
    It also fixes footprint associations for a number of RS485 transceivers:
    * SP3481??
    * LTC2861
2016-05-24 Improved description for symbols in device.dcm
    This PR improves documentation for a number of symbols in the device library:
    * Added description for CRYSTAL_SMD
    * Fixed spelling of potentiometer
    * fixed spelling and tags for a number of diodes
    * Added missing tags to a number of symbols
    * Fixed spelling of *filtre* to *filter*
    * Added missing description for fuses / inductors / jumpers / LEDs
    * Improved description for a number of switches
2016-05-25 Added TMP20 temperature sensors
    This PR adds the TMP20 temperature sensors from Texas Instruments
    **URL** http://www.ti.com/lit/ds/symlink/tmp20.pdf
2016-05-25 Corrected footprint. removed temp files.
2016-05-25 corrected CTL Pin type change footprint and filter
2016-05-26 Fixes to description for MCP9700/A series of temperature sensors
2016-05-26 Added LMR16006YQ? parts
    * Adjustable output version
    * 3.3V output version
    * 5.0 output version
    **Datasheet**
    http://www.ti.com/lit/ds/symlink/lmr16006y-q1.pdf
2016-05-26 Added default footprints
2016-05-26 [enh] add schematic symbol for one-part and two-part EMI RF shielding
2016-05-30 Added MAX15062 series of DC-DC converters
    * Master component MAX15062A (3.3V output)
    * Alias MAX15062B (5.0V output)
    * Alias MAX15062C (adjustable output)
2016-06-01 Updates
    Changed name and moved the housing text so that it is positioned like
    in examples.
2016-06-02 Put pin SPLIT between CANH and CANL; modified default housing reference, field position and visibility
2016-06-04 Fixes for LM35 temperature sensor
    * Removed old LM35 symbol
    * Added LM35 in TO-92 package
    * Added LM35 in TO-220 package
    * Added LM35 in SOIC-8 package
2016-06-07 update NCP1117 series regulators to KLC compliance, add DPAK parts
2016-06-08 added VDDA and VSSA power symbols
2016-06-08 Added NCS21x series of current-shunt monitors
    http://www.onsemi.com/pub_link/Collateral/NCS210-D.PDF
2016-06-08 correct footprint filter, add default footprints
2016-06-09 Added LM5165 dc-dc converter
    http://www.ti.com/lit/ds/symlink/lm5165.pdf
    * Adjustable voltage version
    * Fixed voltage version (3.3V and 5.0V)
2016-06-09 Added TLV493D 3D magnetic field sensor
2016-06-09 added description and keyword for small push button symbols
2016-06-09 Removed duplicate components, improved push-button descriptions
2016-06-09 Added diode keywords
2016-06-09 * Added description for battery symbol * Added keywords for C_Small * Added description for heatsink * Added keywords for inductor
2016-06-09 Consolidated all the switch symbols into a common format / naming convention Much improvement to the keywords / description for the switches
2016-06-09 add texas instruments TPS251* usb charge controllers
2016-06-09 Revert "add texas instruments TPS251* usb charge controllers"
    This reverts commit 2e01a0818f16ebe7823bd5aa0b3b65e5ea91c6b8.
2016-06-12 Added generic rotary encoder symbol to device.lib * Version without button * Version with button
2016-06-12 two simple modifications
    Changed descriptions to include temperature range and remove IC
    reference
    changed name prefix from IC tu U
2016-06-14 Add Traco Power TSR 1-2450 symbol
2016-06-15 New symbol for linear -> LTC6102 (current sense amplifier)
2016-06-15 adding Texas Instruments TCA9555 I2C io expander
2016-06-15 Added MAX4080 unidirectional current shunt monitor http://datasheets.maximintegrated.com/en/ds/MAX4080-MAX4081.pdf
2016-06-15 updated fp filter to match variants
2016-06-16 LTC6102: rework and split-up symbol
    - Generate different symbols for different packages
    - Generate different symbols for different pin-configurations (V-/EN)
    - Make Symbol smaller
    - add more tags to keyword field
2016-06-16 Add Traco Power TSR-1 3D models and corrected footprint name of TSR 1-xxxx symbols.
2016-06-17 added Analog Devices ADP5054 quad buck regulator
2016-06-18 Fixed small pin on CRYSTAL_SMD
2016-06-18 * Fixed graphic bug with Thermistor * Moved thermistor pins onto 0.1" grid
2016-06-18 * Consolidated EMI filters * Improved EMI filter symbols * Changed all filter / emi parts reference to "FL"
2016-06-20 added default footprint for TCA9555 symbols
2016-06-20 add mounting tab and _Notab variants
2016-06-20 label placement tweaked, allowed kicad to rearrange file contents
2016-06-21 correctly adding mounting tabs
2016-06-22 Added ST USB6B1 to ESD_Protection
    5V Data line protection
2016-06-22 Added 47054 Molex header
    Added Molex header for pc pwm fans
    [Sockets_MOLEX_KK-System.kicad_pcb]
2016-06-23 Added LTC4417 and variants into Power Management lib
2016-06-23 Bugfixes
    - Vcc and GND to input
    - fill to "background" and the width to 0.01"
    - default footprint
    - Moved reference and name
2016-06-25 Add minnowboard lowspeed lure template
    This is a lure template of the Minnowboard MAX/Turbot lowspeed expansion header.
    [minnowboard-ls-lure.kicad_pcb, minnowboard-ls-lure.sch]
2016-06-25 updated APD5054 footprint filter
2016-06-26 Added Harwin connectors pretty library to fp-lib tables
2016-06-29 added symbol for USBLC6-2SC6 ESD protection diode
2016-06-30 Update dc-dc.lib
    updated adp5054 fp filter
2016-07-04 LTC3429 and LTC3429B are moved to dc-dc.lib from regul.lib
    As stated in comments of PL #514 of kicad-library, proper library for these components is decided to be dc-dc.lib since they are switching regulators and regul.lib is dedicated to linear converters.
2016-07-05 changed ground pin type to 'Power Input', removed pin number from footprint filter
2016-07-05 Move switching regulators from regul to dc-dc List of moved regulators: IS31LT3360 ADP1108 LT1108 LTC1307 LTC1624 LM3578 LT1372 LT1373 LT3430 MC34063 MIC2177 TL497 TL497A LTC3442 LTC3525 LTC3525-3 LT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
2016-07-05 GND pin location, footprint name, footprint text location and its visibility of LTC3429 and LTC3429B are changed according to the https://github.com/KiCad/kicad-library/pull/514#issuecomment-230460525
2016-07-06 Add ADS1251 adc to adc-dac
2016-07-06 ADS1251 - add footprint filter
2016-07-06 Description of LTC3429B is modified according to https://github.com/KiCad/kicad-library/pull/514#issuecomment-230706189
    The fundamental difference between LTC3429 and LTC3429B is added to description of LTC3429B.
2016-07-06 Move MIC2026 from regul to Power_Management
2016-07-08 Updates for the Minnowboard LS Lure template
    - Switches to standard mounting holes.
    - Removes local footprint library.
    - Locks the mounting holes.
    - Locks base board connector.
    - Removes local library directory from project file.
    - Denotes bottom side keepouts with Dwgs.User.
    - Adds note in Cmts.User about keepouts.
    - Updates image and html text.
    [minnowboard-ls-lure.kicad_pcb]
2016-07-08 Moved symbols of sanken to motor_drivers
2016-07-08 Added references to Battery_Holders.pretty
2016-07-09 Added Amphenol connectors library
2016-07-09 Fixed FP filter for LM5060
2016-07-10 * Fixed FP filter * Fixed pin type of Vcc
2016-07-10 Improved part and alias description(s) Centered component Improved FP filter
2016-07-10 Fixing pin location for MAX4080 / MAX4081
2016-07-10 Moved NCS21x from sensors.lib to linear.lib
2016-07-10 Removed duplicate diode symbol
2016-07-10 Removed weird TEMPLATE symbol Consolidated FUSE names
2016-07-10 Diode_Bridge -> D_BRIDGE
2016-07-10 Consolidated EMI filters
2016-07-11 BatteryManagement: Add MAX1811 IC charger
2016-07-11 Memories: Fix 24xx I2C memories
2016-07-13 Change TSR1 footprint field to full format (Library:Footprint) and add a wildcard to the footprint filter.
2016-07-13 added micro sd card socket
2016-07-13 added microsd datasheet field for micro sd socket
2016-07-13 solved checklib violations for micro sd socket
2016-07-18 Moved Vfb pin to comply with 100 mils rule
2016-07-18 Battery management: Fix MAX1811 according to comments
2016-07-22 Added MAX1274, differential ADC
2016-07-25 Pin Vcc set to invisible
2016-07-31 library/motor_drivers: TI DRV8711 Stepper driver
2016-07-31 library/motor_drivers: DRV8711 cleaning
2016-08-01 Added footprint filter
2016-08-01 Renamed GND to PGND
    PGND matches datasheet
2016-08-02 Added fp-lib reference to JAE connectors
2016-08-02 Added reference(s) to Phoenix connectors
2016-08-04 [fix] remove Battery_Holders and Connectors_Amphenol from fp-lib table, and add Connectors_Samtec
2016-08-05 Added RFSolutions device library
    ZETA-433-SO RF Solutions
    ZETA-868-SO RF Solutions
    ZETA-915-SO RF Solutions
2016-08-06 Remove reference in cmakelists to footprints_doc
    ... which has been removed recently in:
    remove useless documentation files
    commit 9fdcdeb0f292017176fd4e090ef3053051cdb832
2016-08-06 Remove obsolete "example" files
    Used to generate the newly removed footprints_doc
    [7Segment_16Sep2013.kicad_pcb, BNC-Sockets_RevA.kicad_pcb, Buzzer_Beeper_RevA_25Oct2010.kicad_pcb, Capacitors_Elko_ThroughHole.kicad_pcb, Capacitors_ThroughHole_RevA.kicad_pcb, Choke_Axial_ThroughHole_RevB.kicad_pcb, Choke_Radial_ThroughHole_CD_Bobin_RevA.kicad_pcb, Choke_SMD_RevB_28Dez2012.kicad_pcb]
2016-08-13 stm32: fix pin duplication in some parts.
2016-08-15 Fixed pin name
2016-08-15 Fixed footprint associations for the ADS1120*
2016-08-15 Official KiCAD libraries
2016-08-16 Added LT6657 series of precision voltage references
    http://cds.linear.com/docs/en/datasheet/6657fb.pdf
    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
2016-08-16 Added STSPIN230 motor driver
    http://www.st.com/content/ccc/resource/technical/document/datasheet/group3/f5/79/9b/db/49/dd/4d/36/DM00293530/files/DM00293530.pdf/jcr:content/translations/en.DM0029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
2016-08-16 rfcom: cc2520: Footprint and datasheet fields.
2016-08-17 Added def fp, fixed fp filter, added datasheet to fields
2016-08-17 Changed SYNC pin, added DCN suffix, fixed fp filters
2016-08-18 Changed output pin types to "Power Output"
2016-08-20 Fixe pin positions as per KLC 3.1
2016-08-21 RF: Fix name of RF GND pins
2016-08-22 added MPU-6000, accelerometer&gyroscope combo
2016-08-22 added MPU-6050, I2C only variation of MPU-6000
2016-08-22 added MPU-9150 9-Axis motion sensor
2016-08-22 added MPU-9250 9-axis motion sensor combo
2016-08-22 corrected MPU-* motion sensor descriptions
2016-08-23 MODULES: Add new library 'MODULES' with CHIP board from NextThingCo
2016-08-23 Revert "MODULES: Add new library 'MODULES' with CHIP board from NextThingCo"
    This reverts commit 62dbc89672e38602ae1178c06b1b914831e5c4cf.
2016-08-27 Modifications according to PR comments: * Make F2 field blank. Ref: https://github.com/KiCad/kicad-library/pull/653#issuecomment-242368353 * Modify footprint filters. Ref: https://github.com/KiCad/ki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
2016-08-29 Added +3.3V (alias of +3V3) and +3.3VA Voltage symbols for 3.3V and 3.3V analog
2016-08-31 Created new library "allegro.lib" and moved all ACS* current sensor ICs to this library.
2016-08-31 Reordering of parts in sensors.dcm
2016-08-31 Added ACS758 series sensors
2016-08-31 Added supply voltage information
2016-08-31 fixed footprint information
2016-08-31 More footprint fixes
2016-08-31 Remove ZIP23 from default footprint of SLA707xMPRT in motor_drivers.lib
2016-08-31 Add footprint filter section to SLA707xMPRT
2016-09-04 sensors: add SHT1x symbol
2016-09-06 add bosch bmf055 9 axis motion sensor
2016-09-06 texas: add BQ24075
    USB LiPo battery charging and power management IC
2016-09-06 regul: add MCP1700TT
    250mA Low Quiscent Current LDO
2016-09-06 updated footprint filters and removed footprint assignment
2016-09-08 Reduced size Reduced pin size Fixed pin type of GND pin
2016-09-09 Removed KiCad_Library_Conventiontxt This is a duplicate of the information already on the wiki (https://github.com/KiCad/kicad-library/wiki/Kicad-Library-Convention) it is better to make any changes 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
2016-09-12 Removed KICAD_DATA dir which is redundant on OSX and changed the prefix to something more sane
2016-09-13 KLC fix
    Added footprint name to ACPL-P343 (footprint file in prepare),
    add pin descriptions to all symbols in PR
2016-09-14 battery_management: fixed EC03, EC04 for BQ24075
    moved component from texas lib to battery_management
2016-09-14 battery_mgmt: add QFN footprint filter for BQ24075
2016-09-16 battery_mgmt: add thermal pad for BQ24075
    rearranged pins
2016-09-16 battery_mgmt: move thermal pad in BQ24075
2016-09-17 Fix TSR-1
    - Change Vout to "Power Output"
    - Set footprint field invisible
    - Simplify description and keywords
2016-09-25 sensors: SHT1x - change VDD pin type to power input
2016-09-25 added 3D-model for JAN6418 valve
2016-09-25 added Tianbo-4102-L relay symbol (DIL-type package)
2016-09-25 added footprint filter
    footprint added here: https://github.com/KiCad/Relays_ThroughHole.pretty/pull/8
2016-09-25 added 3d model for HJR-4102 relay
2016-09-25 added KTYxx and PT100(0) temperature sensor symbols comments
2016-09-25 added KTYxx and PT100(0) temperature sensor symbols
2016-09-25 added screw terminal symbols to conn library
2016-09-25 added library with 110V/220V AC power connector symbols
2016-09-25 socket is smaller now, symbols no longer defined as power symbols (which may not have a footprint, as I found out)
2016-09-25 added library with motor symbols lib contains AC/DC motors, servos, stepper motors
2016-09-25 added FRT5 relays (2-switch DIL signal relays), as standard relay symbol and as symbol separated into coil+2switches
2016-09-25 added 3d model for FRT5 relay
2016-09-25 added 3d models for DO-35/SOD23 diode packages in vertical alignment with RM2.54
2016-09-26 fixed KLC violation, improved package filters
2016-09-27 improved 3D models (added plastic pin in 4-pin header, campher pin corners ...)
2016-09-27 improved symbols (two thin lines instead of one thick for screw slit + centering + ...)
2016-09-27 bugfixed some components (were erroneous marked as power sources) + improved filter lists
2016-09-28 added 3D sketches for DO-34/SOD68 (RM5,, + RM2.54mm) see http://www.nxp.com/documents/outline_drawing/SOD68.pdf
2016-09-28 added descriptions for nearly all other tubes
2016-09-29 Vref is now a power-input, as suggested by checklib.py --enable-extra
2016-09-29 added screw_terminal_7x01 ... screw_terminal_12x01 and fixed some extra-KLCs
2016-09-29 added MCP3004
    checklib.py ..\..\kicad-library\library\adc-dac.lib --enable-extra -vvv -c MCP3004
    Component: MCP3004
    No violations found
2016-09-29 added MCP3422, MCP3423, MCP3424
    checklib.py ..\..\kicad-library\library\adc-dac.lib --enable-extra -vvv -p MCP342
    Component: MCP3422
    Component: MCP3423
    Component: MCP3424
    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
2016-09-30 added several photo semiconductors (photodiodes, phototransistors, IR LEDs)
2016-09-30 added laser diode symbols
2016-09-30 added color sensor (RGB) KPS-5130
2016-09-30 made 3-pin photo-NPN KLC conformant
2016-10-01 added TSSL2550 ambient light sensor
2016-10-01 added 3D symbol for SW_PUSH_6mm (height=4.3mm) see http://nal.apem.com/pdf/phap33-series.pdf
2016-10-01 added 6mm push button models with different button height see http://nal.apem.com/pdf/phap33-series.pdf page 7
2016-10-03 added some general and some Osram laser diodes
2016-10-03 renamed 3D package to conform to footprint name (VALVE-MINI_PENTODE_LINEAR)
2016-10-03 added TO-18 3D models with window and lens (for opto-devices)
2016-10-04 added L272 power opamp
2016-10-04 changed materials to plastic/silver to improve rendering results
2016-10-04 button color back to black + button slightly rounded at the corner + all WRLs created from one parametrizable FCStd file (see spreadsheet therein!)
2016-10-04 added MAX3232 (and improved footprint filters for MAX232)
2016-10-04 added several meters (ampere AC/DV, voltage AC/DC, Ohm, general)
2016-10-04 added microphones, alternative speaker, buzzer, earphone, ultrasonic components (microphone&speaker)
2016-10-06 USB connectors: VCC renamed as VBUS
    The standard name for USB power rail is VBUS and not VCC.
2016-10-06 added IEC-60617 cnformant Fan symbol see http://www.tinline.ch/tinweb/download/category/31-autocad-ecscad.html?download=103%3Aiec-60617-katalog
2016-10-06 added antenna and antenna_with_shield symbols
2016-10-06 renamed shielded Antenna to Antenna_Shield
2016-10-06 added SIP 3D packages with 4...14 pins ... and naming conforms to PR https://github.com/KiCad/Resistors_ThroughHole.pretty/pull/13
2016-10-06 fixed label position of IEC fan symbol
2016-10-07 switched to standard LDR symbol + set missing default packages and package filters in LDRs
2016-10-07 improved switches and added mising switches (DIP switches in two types)
2016-10-08 made switch symbols more elegant + added Push-buttons with LEDs
2016-10-08 added rotary switches
2016-10-08 addes push buttons and switches with LED/Lamp
2016-10-08 improved antenna symbols
2016-10-08 added normally-on and SPDT reed switch
2016-10-08 added battery single-cell and edited multi-cell battery to look a bit nicer
2016-10-08 addes several symbols for resistor networks (different topologies, most common types) + improved R_PACK4+R_PACK8
2016-10-08 added several EMI filters
2016-10-08 added dual-color LED, 2-pin version
2016-10-08 added tunnel diode
2016-10-08 added NTC/PTC thermistors (2,3,4-wire) and thermocouples
2016-10-08 added differential trim capacitor
2016-10-08 added Hall Generator
2016-10-08 added radiation sensitive diode
2016-10-09 added small-symbols for R-networks (star topology R_NETX_Small) + corrected footprint filters for R-networks
2016-10-09 added several missing larger divider/parallel resistor networks + improved description/keywords + bugfixes
2016-10-09 removed some wrong ALIASES (those should be in the sensor.lib ;-)
2016-10-10 Updated LM5051 footprint
2016-10-10 LM5060 - fixed PGD pin
2016-10-10 Fixed LTC4440 pin type
2016-10-10 Fixed footprint filters
2016-10-12 added L5973D switching regulator
2016-10-12 L5973D: fixed footprint filter, pin types and outline
2016-10-12 package filters added
2016-10-13 Correct pin labels to datasheet.
2016-10-15 added dipole and loop antenna symbol + altered Antanne symbols a bit (thicker lines)
2016-10-15 improved/added/renamed fuses
2016-10-15 added Polyfuse(s) + adapt sizes of different resistor symbols (NTC, PTC, Hall_Generator, ...) to the size of R and R_Small
2016-10-15 improved/modified library of resistor networks
2016-10-15 added resistive Heater
2016-10-16 added several missing diodes + added diode bridges with different pinouts + added double-diode symbols + unified diode symbols
2016-10-16 switches have same/unified pin pitch now + added several missing switches
2016-10-16 made LEDs look all alike (modified arrows!)
2016-10-16 added dual suppressor diodes + added temperature dependent diodes
2016-10-16 added momentary switches SPDT
2016-10-16 added temperature dependent switches
2016-10-16 switches show pin numbers instead of pin names now everywhere
2016-10-16 all diode-like symbols use C now as pin name for the _C_athode
2016-10-16 added electromagnet (like relay coil)
2016-10-16 added laser diodes
2016-10-16 swap GND pins of A and B parts
2016-10-17 add speakers display pin-numbers instead of pin-names now
2016-10-17 reanmed CRYSTAL -> Crystal, added/reworked 3-pin and 4-pin crystal (not oscillator IC!!!) symbols
2016-10-17 OC* and OUT* pin names bug fix
2016-10-17 Add FAN7842 mosfet driver
2016-10-17 OUT pins type set as POWER_OUTPUT
2016-10-17 reworked multi-colored LEDs + bugfixes LED_Dual_2pin (too mayn arrows)
2016-10-17 fixed GC on common-C LEDs to C
2016-10-17 added Crystal variant with pin-number 1-3 and 1-4 (e.g. for such devices: http://www.abracon.com/Resonators/abs25.pdf)
2016-10-17 FP filters added to TPS20x4D
2016-10-18 updated footprint filter, again.
2016-10-18 Fixed location of GND pins
2016-10-18 Added NC pin
2016-10-18 Fixed pin type
2016-10-18 Fixed fp filters
2016-10-18 all extra pins in crystals are PASSIVE now, no longer POWER_INPUT GND
2016-10-18 added peltier element + heatsink with connection + replaced D_Suppressor... -> D_TVS...
2016-10-18 renamed Components in ALL-UPPERCASE to Normal-Case + removed old/unneeded components (e.g. RVAR as we now have RTRIM, like CTRIM, LTRIM ...) + reworked Varistor symbol
2016-10-18 REFDES of Varistor is now VR + fixed footprint filter for Varistor
2016-10-18 minor alterations to the STYLE of the crystals/resonators (the electrode lines are thicker now + the central crystal is a bit thinner and the electrodes moved towards the center, so there is more spa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
2016-10-19 ZXCT current sensors
    Fixed footprint association for ZXCT1009
    Added footprint filter for ZXCT1009
    Added ZXCT1107
    Added ZXCT1109
2016-10-19 Fixes for TLV71209DBV
    EN pin is NOT inverted
    Added pin 4 (NC, invisible)
    Fixed pin type of IN pin
    Fixed pin locations and shortened pins
    Fixed footprint reference
    Fixed footprint filter
2016-10-20 Updates for TPS560200
    * Fixed footprint association
    * Added footprint filter
    * Fixed pin type
2016-10-21 Added default footprint for MSOP version of LTC4364 Added default footprint for DFN version of LTC4364
2016-10-21 Added footprint fot MCP4728
2016-10-21 Added filters for ADS1118
2016-10-21 Adjusted FP filter for ADS1120-RVA
2016-10-21 added TL432 shunt regulators
2016-10-22 added ICL7667 Dual MOSFET driver
2016-10-22 COM pin of ULNxxxx darlington arrays is now passive
2016-10-22 fixed several footprint filters (modernized)
2016-10-22 added REF30xx devices
2016-10-22 remove thermocouple variants with blocks (they don't seem to be common in schematics ...)
2016-10-22 fixed C->K in LEDs
2016-10-22 moved L293 from interface.lib to motor_drivers.lib
2016-10-22 new import of RaspberryPi_2_3 and MCP7940N
2016-10-22 Changed V+/V- to PowerOutput
2016-10-23 NAME-Label of POT* now outside the devices
2016-10-23 fixed REFDES of Antennas to AE
2016-10-23 reworked switches (minor symbol fixes, e.g. too short pins) + replaced normal symbos with _Small variants + removed old _Small variants
2016-10-23 added MOSFET-symbols with substrate diode (were messing) + improved REFDES+NAME label positions for all transistors (left-aligned on the left of the device!
2016-10-24 Added Template for Raspberry Pi 40 Pin Models. Added Mounting Hole Schematic Symbol.
    [raspberrypi-gpio-40pin.kicad_pcb, raspberrypi-gpio-40pin.sch]
2016-10-24 memory: Correct M25PX32 description and footprint filter
2016-10-25 Added CP2104 USB to UART bridge
2016-10-25 Add symbols
    Add Isolation amplifier ACPL-C790 and aliases
    Add Isolation volatage sensor ACPL-C870 and aliases
2016-10-25 Fixed NC pin
2016-10-25 moved Heatsinks and added new Mounting_Hole symbols to a new lib mechanical.lib/dcm
2016-10-27 Added Hammond MFG 1593K Template
    [1593K_Enclosure.kicad_pcb, 1593K_Enclosure.sch]
2016-10-27 moved switches to switches.lib + renamed DIP-switches to SW_DIP_xNN
2016-10-27 added housings to mechanical.lib
2016-10-28 changed pin-appearance to GOLD + added STEP-files
2016-10-28 moved to Connect.3dshapes to match footprints (https://github.com/KiCad/Connectors.pretty/pull/43)
2016-10-28 replaced MOS-symbols without substrate diode with version with that diode
2016-10-28 moved origin to top-left-pin (seen from above)
2016-10-28 Fix pin types in Atmel components (#736)
    VCC, GND, AVCC, AGND and VBAT should be set as "Power input".
2016-10-28 fixed several issues (mixed-up datahseets, footprint filters, added missing NC-pins) + fixed several KLC issues in other symbols (missing NC-pins, footprint filters)
2016-10-28 don't use the inverted pin style for inverted pins, since they already have an overline
2016-10-28 set the footprint field to Housings_DIP:DIP-20_W7.62mm_LongPads and made it hidden
2016-10-28 Modified LPC822M101JDH20 assigned correct el. type to pins.
2016-10-29 Updated net names.
    [raspberrypi-gpio-40pin.kicad_pcb, raspberrypi-gpio-40pin.sch]
2016-10-30 Add ltc4001 charger (#778)
    * Add LTC4001 charger and alias LTC4001-1
2016-10-30 set the 8284 footprint field to Housings_DIP:DIP-18_W7.62mm_LongPads and made it hidden
2016-11-01 fixed several issues (mixed-up pins, wrong package options -> new symbols for DFN-8-1EP, pin-names differed from datasheet, keywords ...)
2016-11-01 #IM made diode symbols IEC-conformant (non-filled triangle) + replaced old SCHDPAK-sy,bol with proper D_Schottky_AKK,... variants
2016-11-01 made D_Capacitance IEC-conformant (see e.g. https://books.google.de/books?id=0ZWtUEOrpMcC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)
2016-11-01 bugfix: added missing plate-connections in flash lamp symbol
2016-11-01 remove symbols that will be duplicates after https://github.com/KiCad/kicad-library/pull/742 is merged + modified symbols to meet style of https://github.com/KiCad/kicad-library/pull/742 + added KTY1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
2016-11-01 added MCP950x temperature switches
2016-11-01 fixed several footprints and FPFilters
2016-11-01 memory: M25PX32xx - change pin style to inverted for appropriate pins
2016-11-01 memory: M25PX32xx - add set footprints
2016-11-01 regul: MCP1703Axx - set footprint
2016-11-01 Changed power pin length, updated footprint field, added datasheet field
2016-11-01 Added FP filter to the LF15ABDT-TR component in the regul library
2016-11-01 get rid of the double pin inversions of 8088_Max_Mode as well
2016-11-01 removed the _LongPads from the 8284 and 8288 footprints
2016-11-01 set footprint of 8088 and 8088_Max_Mode to Housings_DIP:DIP-40_W15.24mm and made it hidden
2016-11-02 fixed doubled PRETTY-lib in Footprint
2016-11-02 memory: M25PX32-VMP - add pin 9 - PAD/VSS
2016-11-02 regul: fix footprint filter of MCP1703Axx
2016-11-02 xilix: set footprint of XC9572XL-TQ100
2016-11-02 cmos4000: add footprint filters to 4056
2016-11-03 Assigned default FP and added FP filter to LPC822M101JDH20.
2016-11-03 #IM made new reference diodes more IEC conformant
2016-11-04 added the width to the footprint filters of 8088, 8284 and 8288
2016-11-04 Added NUP2105L CAN bus ESD protection diode
2016-11-06 Addded schematic symbol for LAN8720A
2016-11-06 motorola: add MC68000FN (PLCC)
2016-11-07 motorola: fix MC68000FN - background, footprint, not connected pins
2016-11-08 Made schematic symbol compilant to rules EC01 EC04
2016-11-09 added alternative symbols for basic diodes (with filled triangle, non-IEC conformant)
2016-11-09 Added BD1020HVF Analog Temperature Sensor
2016-11-09 Added systematic name for footprint
2016-11-09 xilinx: correct XC9572XL-TQ100 box, footprint, missing pins
2016-11-10 Added footprint filter to BD1020HFV
2016-11-11 Added footprint to BD1020HFV
2016-11-12 transistors: add IRLB8721PBF (N-Channel HEXFET Power MOSFET)
2016-11-13 Rearranged power pin
2016-11-13 transistors: fix footprint field of IRLB8721PBF
2016-11-14 set the 82C55A footprint filter to *PLCC?44*
2016-11-14 set 82C55A footprint to Sockets:PLCC44
2016-11-15 removed the device names from the description fields of all the 8255 variants
2016-11-19 Fix pin 8 type of 74LS132
2016-11-21 xilinx: add missing pin 15 to XC95144XL-TQ144
2016-11-22 Fixed datasheet links and footprints
2016-11-23 Fixed default footprints for INA19x series current sensors
2016-11-23 Added INA138/168 sensors
2016-11-23 update mechanical holes to newly commited schematic symbols.
    [raspberrypi-gpio-40pin.kicad_pcb, raspberrypi-gpio-40pin.sch]
2016-11-23 Add initial symbol library table to template folder.
    This is the initial table which contains all of the symbol libraries
    currently in the library folder.
2016-11-23 Added SW_Push_LCD
    Several manufacturers make these type of switches.
2016-11-23 relays: Add OMRON G5Q relays
2016-11-23 Fixed FP filter
2016-11-23 Added missing FP filter
2016-11-24 1. Make the line width of the outline 0.01" thick and filled it with the background color 2. Move the SW-pins to the switch symbol and all the inputs to the left 3. Rename the device to the actual na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
2016-11-24 relays: Fix OMRON G5Q relays
2016-11-24 Fixed pin location on grid
2016-11-25 bosch: update footprint list
2016-11-26 Changed pin name position offset in LPC822M101JDH20.
2016-11-30 added symbols for LED with PAD, several LEDs in series in a single package and several LEDs in series in a single package with pad
2016-11-30 added leds.lib for special LEDs
2016-12-01 Added DIP* filter
2016-12-01 Align grid with BeagleBone pins
    This change sets the grid origin to the first pin on P9. This allows
    us to easily place components with the same pin spacing and alignment.
    [BeagleBone-Black-Cape.kicad_pcb]
2016-12-04 Added ZXGD300XE6 gate drivers
2016-12-04 fixed footprints+filters and made LDRs conform to general style
2016-12-04 modules: Update CHIP footprint
2016-12-04 Added generic male and female connectors to the conn library
    There are generic male and femalse connectors that fit standards.
2016-12-05 added footprint filter to SW_E£_SA3216
2016-12-05 Reworked connectors to fit IEC-60617
    Sorry about that. I used the wrong standard
2016-12-05 Resized box on male connector
2016-12-08 update pins to fit on 100mm grid
2016-12-08 Update pin types
2016-12-10 Add IR2106 high and low side driver
2016-12-13 Add 4- and 5-unit ESD protection diodes
2016-12-13 Rename symbols using generic device "standards"
2016-12-13 Rename dual BJTs using generic devices "standard"
2016-12-14 relays: Fix links to the datasheets
2016-12-15 bosch: update bmf055 refdes & pin name offset
2016-12-16 Fix RB7 pin number on PIC18F45x and PIC18F45xx.
2016-12-17 Fixes for Tantalum Capacitor 3D models
    - Updated to match revised footprints
    - Added step / wrl file pairs
    - Fixed rotation to math IPC (pin 1 on left)
    - Removed .wings files
2016-12-17 fix template
    [Arduino_As_Uno.sch, Arduino_Fio.sch, Arduino_Mega.sch, Arduino_Micro.sch, boosterpack40.sch, boosterpack40_min.kicad_pcb, boosterpack40_min.sch, raspberrypi-gpio.kicad_pcb]
2016-12-18 fixed LT1054 footprint filter (and others in dc-dc.lib)
2016-12-20 made PWR_FLAG smaller (comparable to other power symbols)
2016-12-20 Fix pin types
2016-12-20 Add SC* footprints to FPLIST for dual transistors
2016-12-20 Update "V" footprint to correct footprint name
2016-12-20 Fix input voltages in dcm
2016-12-20 renamed 3D package lib to Relays_THT.3dshapes to conform to Relays_THT.pretty and this PR: https://github.com/KiCad/Relays_THT.pretty/pull/13/files
2016-12-21 Update UCC2892/4 VREF pin type and FPLIST
2016-12-22 fixed pin 40 being erroneously marked as pin 50 in PIC18(L)F4450, PIC18(L)F4455 and PIC18(L)F4458
2016-12-22 removed the leading "*" from the footprint filters of PIC18(L)F4458-I/PT and PIC18(L)F4458-I/ML
2016-12-22 Fp. Filter Fix
    Fp. Filter Fix for ADuM series and ADE7758
2016-12-24 memory: Fix keywords list and update FP filter in AS6C1616
2016-12-24 memory: Fix footprint name of AS6C1616
2016-12-26 Reverted 7805/MC78L05ACD; fixed MC79L05ACD footprint
2016-12-26 fixed the QFN and TQFP footprint filters
2016-12-26 made the PAD pin the same length as the other pins
2016-12-27 renamed DIP-switches
2016-12-27 Filter fix
2016-12-27 renamed 3D pin header to have explicit PITCH
2016-12-28 Add pin Numbers to the connectors
2016-12-28 Add new mounting hole symbols to schematic
    [minnowboard-ls-lure.kicad_pcb, minnowboard-ls-lure.sch]
2016-12-29 Clear rule 3.9 violation for PIC18(L)F2331-I/ML compatible parts. Note that schematic symbol doesn't define a pin for the exposed pad.
2016-12-29 Clear rule 3.9 violation, pin description and aliases for PIC18(L)F2450 parts.
2016-12-29 Fix pin 40 of PIC18(L)F4331-I/ML
2016-12-29 Fix PIC18(L)F442-I/P pin 40 number and pin RA5 description.
2016-12-29 Added default footprint to dual BJT parts
2016-12-29 Fix PIC18(L)F4450 pin numbers, descriptions and aliases.
2016-12-29 Fixed filters, keywords
2016-12-29 Fix footprint filters for PIC18(L)F4458 compatible parts.
2016-12-29 Fix pin description.
2016-12-29 Fix PIC18(L)F44J10-I/P pin 40 number.
2016-12-29 Fix PIC18(L)F45K80-I/PT pin 40 number.
2016-12-30 Fix schematic symbol for PIC18(L)F1220-SO.
2016-12-30 Fix schematic symbol for PIC18F66J60-I/PT and PIC18F96J60-I/PT.
2016-12-31 Updated mounting holes from circular edge cuts to actual mounting holes. Added mounting hole symbols to schematic.
    [1593K_Enclosure.kicad_pcb, 1593K_Enclosure.sch]
2017-01-01 added master for new resistors and removed old
2017-01-01 rename + master for rectangular resistors
2017-01-01 update pin length
2017-01-01 Marked footprint invisible.
2017-01-01 added diverse resistors
2017-01-01 added axial vertical resistors
2017-01-01 added axial power rect resistors
2017-01-01 Added LTC2508-32
    Linear Technology LTC2508-32
    32-Bit Oversampling ADC with Configurable Digital Filter
2017-01-01 moved one pin for better shematic design
2017-01-02 Updating pull-request
    * Moving the datasheet field to the documentation field
    * Removing DigiKey field
    * Moving PIC16(L)F1829 and PIC16F1829LIN to microchip_pic16mcu
    * Moving power supply symbols at top and bottom
    * Updating description for PIC16F1829LIN
2017-01-02 Updating MCP2050
    * Datasheet in documentation field
    * Power pins at top and bottom
2017-01-03 added 3d package of SW_SPST_FSMSM to Buttons_Switches_SMD.3dshapes
2017-01-03 Temperature notation, package
2017-01-04 Update the keepout regions
    The keepout notation in the user drawing layer is now more accurate.
    [minnowboard-ls-lure.kicad_pcb]
2017-01-04 updated board edge dimensions on RHS.
    [minnowboard-ls-lure.kicad_pcb]
2017-01-04 updated keepout areas to add 1mm margin, and to make it possible to easily convert to edge cuts.
    [minnowboard-ls-lure.kicad_pcb]
2017-01-04 reverted keeout boxes to dwg layer.
    [minnowboard-ls-lure.kicad_pcb]
2017-01-04 Moved ground to bottom on TI's power distribution switches
2017-01-05 KLC - EC01, EC04
    * Pin type mismatch;
    * Line width;
    * documentation removed from symbol definition
2017-01-05 Moved from trinamic.lib to motor_drivers.lib
2017-01-06 added more symbols for existing footprints
2017-01-08 PIC16F1829LIN update
    * Removing IC name from description
    * Renaming to include temperature range and package identification (-E/SS)
    * Updating keywords
2017-01-08 BL652 update
    * Fixing footprint filter list
2017-01-08 PIC16(L)F1829* update
    * adding description for aliases
    * using more accurate footprint filters
2017-01-09 Added Dual Complementary Pair MOSFET transistor from the FAIRCHILD SEMICONDUCTOR to transistors library.
2017-01-09 Modified schematic symbol of the FDS9934C according to MOSFET from the device library.
2017-01-09 updated existing symbols with footprint and in new style (non-filled diode triangles)
2017-01-09 added several new standard diodes
2017-01-10 MCP2050 update
    * adding missing NC pads
    * adding default footprint for the QFN version
2017-01-10 PIC16F1829 update
    * updating style of PIC16F1829LIN to match the other PIC16F1829
    * adding default footprints
    * updating footprint filters to remove the pin count
2017-01-10 added several more standard diodes
2017-01-10 added even more diodes (for switching regulators)
2017-01-10 renamed 3D packages to match footprints
2017-01-10 renamed footprints in library as required by footprints
2017-01-10 added more missing power resistor 3D models
2017-01-11 added all new models of capacitors
2017-01-11 update FPFilters in device.lib to match capacitors
2017-01-12 MCP2050 update
    * splitting the -E/P and -E/SL-versions of MCP2050 to assign an
    appropriate default footprint
    * updating footprint filter
2017-01-12 renamed capacitor 3D models
2017-01-12 renamed prefix "Resistor_" to "R_"
2017-01-12 renamed SMD diode 3D models
2017-01-12 extended/renamed THT-diodes 3d models
2017-01-13 added new 3D models for LEDs
2017-01-14 updated 3D models for LEDs
2017-01-14 added side emitter LED
2017-01-14 add 24bit ADC 8 channels ADS1243
2017-01-14 added horizontal LEDs
2017-01-15 Correct bug on gnd pin number 9->15, correct footprint filter and change footprint descriptor
2017-01-15 fixed typo in pcb comments
    [raspberrypi-gpio-40pin.kicad_pcb]
2017-01-15 Changed pin lengths for all diodes in diode.lib to 100 (down from 150)
2017-01-16 fixed housing description
2017-01-16 Remove pin count from UCC2897 FPLIST
2017-01-16 Fixes for MIC5219
    Added Aliases, corrected Footprint, added description
2017-01-17 Added footprint filters for inductor devices
2017-01-17 added vertically mounted axial inductors 3D models
2017-01-17 added toroid inductors footprint
2017-01-17 add ADS7828 12bits 8channels I2C ADC
2017-01-18 Global fixes for field text
    * Footprint and datasheet fields set to `Invisible`
    * Changed all field size to `50mils`
    * Changed any RefDes labeled `IC?` to `U?`
2017-01-18 Fixed footprint association for NRF24L01
2017-01-18 Template Arduino : Fix pin order SS, MOSI, MISO, SCK
    [Arduino_Fio.kicad_pcb, Arduino_Fio.sch, Arduino_Mini.kicad_pcb, Arduino_Mini.sch, Arduino_Nano.kicad_pcb, Arduino_Nano.sch]
2017-01-18 fixed KLC issues + footprint fields/filters
2017-01-18 adapt version and pin position
2017-01-18 renamed Connect.3dshapes to Connectors.3dshapes (corresponds to Connectors.pretty)
2017-01-18 Footprint filter
2017-01-19 change color of 3D housing of multi-color-LEDs to white
2017-01-19 renamed some special-form LEDs for better naming scheme
2017-01-19 replace/add models for horizontal LEDs
2017-01-19 Changed pins 61 & 62 to POWER_INPUT
2017-01-20 add LTC2309 8channels 12bits sar adc QFN and TSSOP version
2017-01-20 update pin position for QFN
2017-01-21 Added lib table entry for Enclosures.pretty
2017-01-21 Marked `Filters_HF_Coils_NEOSID` as deprecated
2017-01-21 Fixed description for Housings_SOIC
2017-01-21 Fixed descriptions for Valves and Varistors
2017-01-21 correct line width, comment comma separeted, componnent position and pin correction for QFN
2017-01-21 ac-dc: Add a voltage variants of MeanWell IRM-02 power supply
2017-01-21 fixed several issues in regul.lib and references.lib (and moved some regulators to dc-dc.lib)
2017-01-22 fix some pin-types from BIDI to PASSIVE (see https://github.com/KiCad/kicad-library/issues/946)
2017-01-22 reworked several connectors (JACKs, LEMOs, GS2, GS3, BUS, ...)
2017-01-22 reworked D-SUB connectors
2017-01-22 correct pin numbering and add NC pins, change the POT symbol, remove the - in the FPfilter
2017-01-22 added 3D models fot PT-6/10715 potentiometers, mounted vertically
2017-01-22 Fix ADUM4160 pin "PIN" location
    The "PIN" pin control the upstream pull-up, but is located on the
    downstream side, and is relative to the downstream "GND" pins. Therefore
    move it to the right side of the isolator.
2017-01-23 Add NXP lib and LED driver PCA9685
2017-01-24 GND pads to bottom edges
2017-01-24 update pin position
2017-01-25 Remove empty line in microchip_pic32mcu.dcm
    It was added in:
    c950402ffed68754612a4c4dbc91fd8aa9ea68d7
    It made eeschema error with:
    from sch_legacy_plugin.cpp : loadDocs() line:2271
    20:19:41: Part library '/usr/share/kicad/library/microchip_pic32mcu.lib'
    failed to load. Error:
    IO_ERROR: expected token in symbol definition in input/source
    '/usr/share/kicad/library/microchip_pic32mcu.dcm'
    line 5
    When KiCad was built with KICAD_USE_SCH_IO_MANAGER=ON
2017-01-26 Fixed pin 2/4, fixed description
2017-01-26 correction on TPS563200, LM5175, TUSB8041
    On LM5175, vcc is out (check on datasheet) The Power comes from Vin.
2017-01-27 added generic single and twin coaxial connector + removed old BNC
2017-01-28 PCA9536 and PCA9544: Update FP filters
2017-01-28 removed doubled laser-diodes (available in device.lib)
2017-01-29 renamed 3D packages for SocketStrips
2017-01-29 changed REFDES of all connector symbols to J
2017-01-29 NXP S08 + KINETIS: Modify Footprint Filters
2017-01-30 Modify footprint filters to comply with KLC.
2017-01-30 Fixed pin layout, fixed pin 7/9
2017-01-31 Removed space in footprint specification.
2017-01-31 Add Microchip MCP1826S LDO regulator in regul library
2017-01-31 adding +2V8 power symbol to power lib.
2017-01-31 adding BAT54A to diode lib
2017-01-31 adding LSM9DS1 to sensors lib.
    I plan to creat the LGA-24L footprint. But don't know in which library I
    should put it.
2017-01-31 Added +28V and AC symbols to power.lib
2017-02-01 change pin type to passive for BAT54A diode
2017-02-01 pin arrangement correction on 24AA02
2017-02-01 correction on texas lib.
    removing LM73
    pin length change on TLC5973
    corect datasheet link to TUSB4041I
2017-02-01 Fix footprint filter MCP1826S
2017-02-03 DS link & footprint name correction for TUSB4041I
2017-02-03 moved the 8086 minimum mode ~BHE~/S7 pin to the right
2017-02-05 Fixed power pins for USB_B
2017-02-06 Added Housings_LGA
2017-02-06 Added entry for Housings_PGA
2017-02-06 Added entry for Housings_LCC
2017-02-06 footprint reference for LSM9DS1
2017-02-06 add horizontal line through the diode triangle BAT54A
2017-02-06 Fixed shield pins for USB connectors
2017-02-07 Added LIS2HH12 3-axis accelerometer
2017-02-07 Add footprint fields TXB0102*
2017-02-08 Deleted NXP.dcm
    Ref: https://github.com/KiCad/kicad-library/issues/984
    Components to be merged into nxp.dcm
2017-02-08 Delete NXP.lib
    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
2017-02-08 Delete device.douille_4mm(black).wings
    Case sensitivity issues on Windows - https://github.com/KiCad/kicad-library/issues/984
2017-02-08 Delete device.douille_4mm(black).wrl
    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
2017-02-09 fix name footprint for USB2514B/Bi
2017-02-09 Added step as binary file filter
2017-02-10 Included most recent changes to motor_drivers
2017-02-11 Make the 'pin header' connectors easier to find for users who expect that name by adding that term to the description of the CONN_ components. For example, Open Parts Library, SparkFun, Seeed, Jameco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
2017-02-11 Add footprint filters for IDC headers.
2017-02-12 Renaming 3d shape in accordance with footprint
2017-02-13 Resolved conflicts, resaved files with kicad.
2017-02-15 16F1459 DIP/SOIC Pin correction
    Corrected Pin assignment for the DIP and SOIC variants of PIC16F1459,
    RB7/TX.
2017-02-15 Fix pin name typo, duplicate Z0.
2017-02-16 Correction of footprint name and coma in the keyword
2017-02-16 Removed Housings_ROHM 3d models
2017-02-17 added TRACO TEN20WIN dual supplies schematic symbols
2017-02-18 adding R_0201 STEP and WRL parametric model
    models are generated by parametric scripts
    https://github.com/easyw/kicad-3d-models-in-freecad/tree/master/cadquery/FCAD_script_generator
2017-02-18 updating all script generated Resistors_SMD
2017-02-19 Fixes for footprint references
2017-02-19 Added 3D model for 1W and 3W LED according to datasheet https://www.gme.cz/data/attachments/dsh.518-234.1.pdf Package name seems to be "1W 3W LED"
2017-02-19 fixed several footprint fields
2017-02-19 fixed more footprint links
2017-02-19 updating all script generated Capacitors_SMD adding STEP and WRL parametric model
    discussion related at
    https://forum.kicad.info/t/contributing-to-update-of-vrml-librarys-to-step/5049/
    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
2017-02-19 added Arduino Nano symbols
2017-02-19 added Arduino UNO R2/R3 + Leonardo symbols
2017-02-20 Updated description, thickness, pin positions&length, footprint and fpfilter.
2017-02-20 removed _HandSoldering 3d models (aligned to std footprint)
2017-02-20 TEN20 traco contains properly formatted footprint filter
2017-02-20 Fix Footprint name TXB0102DCT
2017-02-20 Changed pin 18 from inverted, input to line, bidirectional.
2017-02-20 updating all script generated Capacitors_SMD_Elec adding STEP and WRL parametric model
    models are generated by parametric scripts, WRL with KiCAD suggested
    materials
    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
2017-02-20 corrected FLT-pin of DRV8825 to OUTPUT (it's the FAULT active-low output)
2017-02-20 updating all script generated Capacitors_Tantalum adding STEP and WRL
    models are generated by parametric scripts,
    STEP file size optimized, WRL with KiCAD suggested
    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
2017-02-21 updating all script generated Housings_SOIC adding STEP and WRL
    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
2017-02-22 updating all script generated Housings_QFP adding STEP and WRL
    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
2017-02-22 [new] Added the script generated 3d shapes for Molex PicoBlade 53388 and 53261 series connectors
2017-02-23 [new] Adding 3dshapes (step and wrl) for JST XH Connectors.
2017-02-23 Show VCC and GND pins
2017-02-24 [new] Adding script generated 3d modules for phoenix contact mcv series connectors.
2017-02-24 [new] Adding script generated 3d modules for phoenix contact mc series connectors.
2017-02-25 fixed transistors.lib + fixed some additional footprint-links
2017-02-25 H11L1: Update FPFilter and move pin 3
2017-02-26 several additional KLC fixes (mostly pin-positions off-grid)
2017-02-26 start updating script generated Housings_QFN adding STEP and WRL
    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
2017-02-28 Fixes for power.lib
2017-03-01 silabs: Create CP2102N-A01-GQFN24 symbol
    CP2102N family are USB to UART bridges in various QFN packages.
2017-03-03 Removed old 3D models
    - Unused_3D.3dshapes
    - Relays_ThroughHole.3dshapes
2017-03-05 Updated pin offsets
2017-03-05 Updated footprint
2017-03-05 silabs: CP2112: fix KLC violations
    Switched VBUS to be an input pin, both suspend pins to be outputs, and
    all GND pins to be power inputs as per the CP2112 datasheet.
    Prior to fixing, KLC violations were:
    checking component: CP2112
    Violating Rule 3.9
    For components with a single default footprint, footprint field is filled with valid footprint
    filename
    Violating EC01 - Extra Checking
    Check pins names against pin types.
    Violating EC03 - Extra Checking
    Check part reference, name and footprint position and alignment
    Violating EC04 - Extra Checking
    Check line width and background for box outlines parts.
2017-03-05 silabs: Si4362: Fix KLC violations, add ground pad pin
    Add pin 21 ground pad.
    Prior to fixing, violations were:
    checking component: Si4362
    Violating Rule 3.8
    Description and keywords properties contains information about the component.
    Violating EC05 - Extra Checking
    Pin numbers should not be duplicated, and all pins should be present
    Pin 4 is missing
    Pin 5 is missing
    Pin 7 is missing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
2017-03-05 silabs: CP2102N-A01-CQFN24: fix KLC violations
    Before fixing, violations were:
    checking component: CP2102N-A01-GQFN24
    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
2017-03-05 silabs: CP2104: Fix KLC violations
    checking component: CP2104
    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
2017-03-05 silabs: Si4735-D60-GU: Move NC pins, fix KLC violations
    Move NC pins to not be at the same coordinates as GND pins.
    Before fixing violations, they were:
    checking component: Si4735-D60-GU
    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
2017-03-09 Add 20 pin legacy ARM JTAG+SWD header
    Reference design taken from
    http://infocenter.arm.com/help/topic/com.arm.doc.faqs/attached/13634/cortex_debug_connectors.pdf
2017-03-09 Move main jtag pins to left, and stack GND pins
2017-03-10 Added lib-table entry for Connectors_USB library
2017-03-10 Added lib-entry for Housings_SON
2017-03-13 differently fused 3D FCStd file
2017-03-17 Add generic BCV61/62 to device.dcm
2017-03-17 Add generic BCV61/62 to device.lib
2017-03-17 Removed footprint from generic BCV61/62
2017-03-17 [new] Symbols for lem ho-np series current transducers.
2017-03-17 [enh] Series symbol now has the nominal current removed from its name. Added aliases for different measuring ranges.
2017-03-19 [fix] Changed symbol body width to 0.01mm. (KLC issue)
2017-03-19 Add KCSC20-* devices and diode icon at symbol
2017-03-19 Split common pin
2017-03-19 Updated the positions of power and ground pins Hid NC pin 6 Moved device label
2017-03-19 Fix wrong pin number for EN.
2017-03-20 Added BQ29700 battery protection
2017-03-20 Fixed forgotten pin directions
2017-03-21 Add generic opamps to device.lib
2017-03-21 Add generic opamps to device.dcm
2017-03-21 Fix aligment, set power pins to correct type.
2017-03-22 Fix typo in footprint name.
2017-03-23 packages3d: ssop: Add QSOP-24 package
    Taken from [1]. Originally generated in [2].
    For now this package is only needed for MAX7325 chip.
    [1] https://github.com/KiCad/packages3D
    [2] https://github.com/easyw/kicad-3d-models-in-freecad
2017-03-23 updating all script generated Housings_QFN adding STEP and WRL
    Thx a lot to @Shackmeister for his great work!
    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
2017-03-23 added parametric generated models from Packages3D repo
    [BeagleBone-Black-Cape.sch]
2017-03-24 Add MIC442x Series MOSFET Drivers
    Adding reworked Microchip (formerly Micrel) MIC 4426, MIC4427 and
    MIC4428 Dual channel MOSFET Drivers.
2017-03-24 Alterations to MIC442x Series MOSFET Drivers
    Merged correct library entities for Microchip (formerly Micrel) MIC442
    Dual MOSFET Drivers
2017-03-25 Fixed all problems
    - Moved generic to devices
    - S13360-30XXCS in opto
2017-03-26 More fixes
    - Extended generic sipm description
    - Added SPAD Keyword to device and opto
    - Extended descripton of Hamamatsu SiPM's to highlight the difference
    (25µm, 50µm and 75µm pixel pitch)
    - Copied keyword and datasheet to alias
    - fixed footprint filter and name
    - removed S13360-30XXCS symbol
2017-03-28 fix LTC6362 - fix output pin types - split MSOP and DFN version (DFN has pad - +1pin) - fix FP filters - DFN had wrong pitch - assign default FPs
2017-03-30 Capitalize all MC1408 pin names
2017-03-30 Add Intersil 72x2 Series MOSFET Driver ICs
    Add Intersil 72x2 Series MOSFET Driver ICs
2017-03-31 Add Nucleo 144 board
    Add F429 and F746 microcontrolers boards
2017-03-31 fix some MOSFETs in transistors.lib
2017-04-03 Fix BSS138 (and aliased 2N7002 MMBF170) diagram from (incorrect) P-channel MOSFET to N-channel MOSFET
2017-04-04 Nucleo 144 Fix
    144 pin connector is Morpho Connector not Zio.
    Zio is Arduino compt. connector.
2017-04-04 Raspberry Pi HAT Template
    This is a template for the Raspberry Pi HAT including EEPROM and
    backpowering protection components per the Raspberry Pi Foundation spec
    at https://github.com/raspberrypi/hats/blob/master/designguide.md
    This has everything needed to create a fully compliant HAT module
    design.
    [raspberrrypi_hat.kicad_pcb, raspberrrypi_hat.sch]
2017-04-04 Fixed missing wildcard in footprint filter (KLC 4.12).
2017-04-05 Fixed KLC errors (apart from EC01 numeral required in TAB pin number).
2017-04-05 Started work on LPC1111FHN33/101. Shortened PIO pin names. Reduced size of symbol. Set symbol line width.
2017-04-05 Fixed default footprint and footprint filter. Passes KLC.
2017-04-05 Aliases added. Symbol passes KLC apart from (incorrect) warning about Vss pin at bottom of symbol.
2017-04-07 Fixed footprint filter error in CM1213A-01SO.
2017-04-07 Fixed footprint filter error in NPC45560.
2017-04-07 Fix pin position and symbol style errors in NPC45560.
2017-04-07 NPC45560: fixed KLC errors in pin position and type, symbol style and alias documentation.
    Remaining errors are pin type of multiple Vout. Need to resolve KLC vs ERC conflict.
2017-04-07 aligning 3D models to packages3D pull 31
    https://github.com/KiCad/packages3D/pull/31
2017-04-10 Add pin 2 as NC and remove DFN footprint
2017-04-10 Changed pin number from "TAB" to "6".
2017-04-15 Updated footprint details.
2017-04-15 TPL9201:Moved all pins to 100mils grid and added wildcard to footprint
2017-04-15 Updated some pin positions
2017-04-15 Added DRV8860 Relay driver
2017-04-17 + add footprint filters for i82C54_PLCC
2017-04-17 + set the footprint of i82C54_PLCC
2017-04-17 + added 8237 DMA controller
2017-04-17 Fixed footprint nickname.
2017-04-17 Fixed footprint name.
2017-04-19 creation of +3V8 Power symbol
2017-04-19 Correcting NMA (footprint field, 0V electrical type)
2017-04-20 Omron relays (#1)
    * Update OMRON Relays for KLC compliance
    Added description, datasheet, and keywords. Changed reference designator
    from "RL" to IEEE standard "K".
    * Revert "Update OMRON Relays for KLC compliance"
    This reverts commit 8c0d7bd6e5f117f39e956a25dc532cf3995bbab9.
    * Omron relays
    Added description, datasheet, and keywords. Changed reference designator
    from "RL" to IEEE standard "K".
2017-04-20 Omron relays (#2)
    * Cleaned out DOS line endings
    * Fixed out of place component definition
    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
2017-04-20 fixed several KLC issues in relays.lib + changed all remaining REFDES from RL to K (Standard!)
2017-04-21 Added lib-table entries for Relays_SMD lib
2017-04-21 Added STEP and WRL files for 54722 and 55560 series connectors.
2017-04-21 * rework relays.lib to match https://github.com/KiCad/Relays_THT.pretty/pull/16 (also rename of 3D symbols) * added some relays for which footprints existed, but no symbol
2017-04-21 aligning 3D models to packages3D pull #35
    https://github.com/KiCad/packages3D/commit/22450f81a67fb326286453fcf2f40e4ca9eb86db
2017-04-22 Added STEP and WRL for MPL115A1 sensor.
2017-04-22 Added pin 1 marker
2017-04-22 Upated footprint name.
2017-04-22 Fixed footprint filter.
2017-04-22 aligning library to packages3d pull #30
    https://github.com/KiCad/packages3D/pull/30
2017-04-22 added MINI-DIN-3...-8 connector symbols
2017-04-23 added series of DIN-connectors (+deleted old version)
2017-04-25 adding MCP73871 (battery management + load sharing) http://www.mouser.com/ds/2/268/22090a-52174.pdf
2017-04-25 add device STM8AF6223
2017-04-25 Fix Pin VSS grid, fix footprint format
2017-04-26 - pin-type of FAULT should be Open-Collector - footprint should be Housings_SSOP:TSSOP-16_4.4x5mm_Pitch0.65mm - FPFilter should be TSSOP*4.4x5mm*Pitch0.65mm* - added a variant of this symbol with an 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
2017-04-26 - Moved the GND-pins 100mil lower so the text does not intersect - Elongated all pins to 150mil or 200mil so the pin-numbers do not interesct with the negation-circles (e.g. pin 14) - Moved pin 18 "5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
2017-04-27 fixed Vss to Power Input, corrected footprint regex
2017-04-27 references.lib: Set Vout-pins types to POWER_OUT
2017-04-28 - unified LM317-like regulators in TO-220
2017-04-28 unified 7805-like regulators in TO-220 package
2017-04-28 unified 7905-like regulators in TO-220 package
2017-04-28 reworked symbols of LM317-like regulators (smaller now)
2017-04-28 modified style of several 3-terminal regulators to match each other (new smaller symbol)
2017-04-29 aligning library to packages3d pull #42
    https://github.com/KiCad/packages3D/pull/42
2017-04-29 Added LPC1112FHI33-102 and six aliases. Removed one alias from LPC1111FHN33-101 that had been incorrectly included in that device; it belongs in this one.
2017-04-30 added new MELF&MiniMELF&MicroMELF package 3D models for Resistors&Diodes
2017-04-30 Updating From master (#4)
    * Add TXB0102DCU and TXB0102YZP in library/texas
    * add alias TXB0102DCT to TXB0102DCU (library/texas.lib)
    * move TXB0102DCT alias to new component library/texas.lib
    * Fix FPFilter TXB0102*
    * Add USB2514B/Bi into library/microchip
    * Add footprint fields TXB0102*
    * fix name footprint for USB2514B/Bi
    * added Arduino UNO R2/R3 + Leonardo symbols
    * Fix Footprint name TXB0102DCT
    * Fix wrong pin number for EN.
    * Fix aligment, set power pins to correct type.
    * Add doc.
    * Fixed symbol line width (KLC 4.2).
    * Fixed missing wildcard in footprint filter (KLC 4.12).
    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
2017-05-01 schematic for TDA7292
2017-05-01 TPIC6595 - remove default footprint
2017-05-01 small changes to tda7292 device position
2017-05-01 Revert "small changes to tda7292 device position"
    This reverts commit fef220bce6e36765d488e4ccfe0054ebb9ba64a1.
    This commit should have been on a different branch
2017-05-01 Added NC pin.
2017-05-01 Added aliases. Updated footprint.
2017-05-02 Changed footprint name.
2017-05-02 Added footprint filters for USB Type-C connectors
2017-05-02 Set USB Type-C connector field visibility
2017-05-02 Changed USB Type-C connector shield pin numbers
    To be honest, I'm not happy with any pin number for the shield I can
    think of. The standard doesn't seem to give them one, and there's no
    straightforward way to extend the numbering in the standard to have one
    more pin. Calling it S1 as I do here doesn't seem horribly inconsistent
    with the standard, and doesn't make the automated KLC checker complain.
2017-05-03 added GBU Diode_Bridge_18_5x5_5 3D model
2017-05-06 fix pin length
2017-05-06 overworked more regulators (design, pin-length, stacked-pins, names with package designator, added missing, ...)
2017-05-06 reanmed MCPxxxx/YY-devices with package specifier + fixed pin pos of LM337L_SO8
2017-05-07 added LP2950 in TO-92/TO-252 as suggested in https://github.com/KiCad/kicad-library/pull/1169 + reworked LM317L_SO8
2017-05-09 Added ADA4807-1
    http://www.analog.com/en/products/amplifiers/operational-amplifiers/rail-to-rail-amplifiers/ada4807-1.html
2017-05-09 stacked Vbat (bidi) / Vss/Vout/Vin (passive hiden / power)
2017-05-10 Change DS, chenge footprint mapping
2017-05-10 remove pin nr
2017-05-13 removed old wings files and added new scripted step and WRML models
2017-05-13 added several L78/L79 devices + stacked pins on simple SO-8 devices
2017-05-14 fixed pin-stacks
2017-05-15 Fixed alignment of KA pin on dual colored LED
2017-05-15 Updated to remove FC assembly bug.
2017-05-17 Added two versions of MCP9804 temperature sensor for MSOP and DFN packages.
2017-05-17 Updating footprint filters.
2017-05-17 Added missing pin on DFN version. Fixed errors in footprint filters.
2017-05-18 Add Footprint Filter TUSB7340
2017-05-18 Rename Diodes_ThroughHole.3dshapes
    It seems that Diodes_ThroughHole.3dshapes was not renamed in
    fa12864fcbd29d90967553951be6359957fceab5 which renamed ThroughHole to
    THT. Also the pretties refer to THT, so this seems like an obvious
    mistake. (There are still some Choke libs with fullname)
2017-05-19 Fix FP filter
2017-05-22 fixed footprint text format, cleared the footprint field as the part has 2 footprint options in FPFilters.
2017-05-22 update FP filter and name for TUSB7340
2017-05-22 +4V power symbol
2017-05-24 Fixed footprint name and filter.
2017-05-24 Moved the LM4811 dual headphone amplifier from digital-audio.lib to audio.lib since it is not a digital device.
2017-05-25 using power-pad-stacks where appropriate
2017-05-25 added LT1083/1084/1085/1086 series of voltage regulators
2017-05-25 Updated footprint filter.
2017-05-25 cleaned up MIC5xyz-families: removed postfix indicating package+PBfree, added MIC5205.family (aliases) from https://github.com/KiCad/kicad-library/pull/316
2017-05-25 Updated footprint filter in LPC176x.
2017-05-28 added scripted DFN-14-1EP_3x3mm_Pitch0.4mm 3d model
2017-05-28 Changed Vout to power
2017-05-28 Removed package specific, removed housing
2017-05-28 Added VBUS power symbol
2017-05-30 fix pin grid
2017-05-30 fix footprint naming
2017-05-30 Fixed footprint filters in four symbols.
2017-06-01 Changed pin Vout to power output
2017-06-02 Added -2V5 and -3V3 for negative voltages
2017-06-03 [new] wrl and step files for CuK JS series switches
2017-06-04 fixed CP_Radial_D10.0mm_P3.50mm
2017-06-04 Shortened pin names.
2017-06-04 Added footprint name.
2017-06-04 created new lib "graphic_symbols.lib" which contains a set of graphic symbols (e.g. warning signs) for a schematic, includes symbols from logo.lib (MOVED!)
2017-06-04 Created TSSOP version. Updated footprint and footprint filter.
2017-06-04 Changed footprint and footprint filter.
2017-06-04 Changed footprint.
2017-06-04 using #SYM and #LOGO as REFDES, so symbols do not appear in the BOM
2017-06-05 added magnetic field warning symbols
2017-06-05 Changed pin types on MAX9814 to be more consistent
2017-06-05 reworked power.lib, fixed KLC-issues (mainly docu), added some missing symbols
2017-06-05 minor pin-type fix
2017-06-05 [new] Fuseholder Schruter FUP for 6.3x32mm or 5x20mm fuses.
2017-06-05 updated all Rect capacitors to Cadquery generated ones
2017-06-05 Started work on 3D models for Housings_SON. Built a couple of devices to check understanding of existing QFN script.
2017-06-07 Added LP3647
    Battery Charger IC up to 1A in LDO mode USB compliant
2017-06-07 added LDK130-family of regulators (based on this PR: https://github.com/KiCad/kicad-library/pull/1297)
2017-06-07 Added devices.
2017-06-07 renamed AP1117 -> AP1117-ADJ + regrouped several devices (in TO-252) as ALIAS to a single source version
2017-06-07 fixed DS-links of TI TLX7XXYY-devices
2017-06-07 Added USON devices.
2017-06-07 split several TPS-devices between fixed and adjustable versions
2017-06-07 changed some pin-types in MAX5092AATE
2017-06-07 Added remaining devices
2017-06-08 RXM-GPS fixes (pin lenght and stacking)
    Downsized pins to 150mil
    Unstacked NC pins
    Placed refs at top-left corner
2017-06-08 Fix GND hidden passives pins
    Reverted all unwanted changes
2017-06-08 Checked and fixed RXM-GPS-RM/FM
    Pin stacking, ref positionning, line width, pin lenght
2017-06-08 Readability changes
    Pin mapping and component size modification to improve readability and esthetic
2017-06-08 rfcom: Change power pins placement
2017-06-08 rfcom: Add footprint filters to MOD-nRF8001
2017-06-10 [new] Script generated 3d models for JST PH THT connectors.
2017-06-10 Remove MAX31855 from sensors.lib
2017-06-10 Move footprint label. Remove duplicate inversions on pin to fix KLC.
2017-06-11 Corrected FT232RL and ATMEGA168A-AU footprints
    Closes #1304
2017-06-11 rfcom: Update footprint filter of MOD-nRF8001
2017-06-12 Filled footprint field and filters
2017-06-12 Moved GPS and added footprint informations
    Deleted linx.lib
2017-06-13 Edited footprint fields, set NC pin into visibles
2017-06-13 Renamed LPC11U12FBD48 to LPC11U12FBD48-201. Simplified symbol. Fixed footprint filter KLC error. Updated metadata. Removed existing aliases prior to adding new set of correct aliases.
2017-06-14 Enlarged component and made NC more clear
    Also switched pin places
2017-06-15 Create adc-dac.dcm
    Correcting AD739/AD7391 descriptions
2017-06-15 Fix footprint label.
2017-06-16 Swaped SPI pins
2017-06-17 Added Texas foot print https://github.com/KiCad/Housings_DFN_QFN.pretty/pull/43
2017-06-18 Added centre line in the diodes for the TLP27XX devices
2017-06-18 Swapped pin 24 and 25, moved out the description tag, changed pin to bi directional
2017-06-18 Added the exact foot print path to the foot print field
2017-06-18 Moved the foot print field to beneth the symbol
2017-06-20 Add AP2204R/RA/RB LDO voltage regulators
    https://www.diodes.com/assets/Datasheets/AP2204.pdf
2017-06-20 Add AP2204K LDO voltage regulators
    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
2017-06-20 Changed footprint filters
2017-06-22 changed footprint filter
2017-06-22 Changed the width of symbol body to 0.254 mm
2017-06-22 Added the ADS7830 schematic
2017-06-22 Removed specific footprint field
2017-06-22 Fixed the double pin 2 issue
2017-06-22 Removed '/' in the device name
2017-06-23 Removed long pin descriptions
2017-06-23 Centered it along the X-axis
2017-06-23 Removed the -P in the device name
2017-06-23 Models matching https://github.com/KiCad/Housings_BGA.pretty/pull/11
2017-06-23 Rotated modules/packages3d/Housings_BGA.3dshapes/DSBGA-12_3x4_1.36x1.86mm_Pitch0.5mm 90 degree
2017-06-24 Splitted them into 4 seperate schematic, fixed RC6
2017-06-24 Made Pin 10 bidirectionel
2017-06-24 Fixed the foot prints
2017-06-25 Centered the symbol along the Y-axis
2017-06-26 Moved MAX5813WLP, MAX5814WLP and MAX5815WLP from ac-dc library to adc-dac library
2017-06-28 Set the default footprint to a fixed value
2017-06-28 Specified specificly the foot print, added aliases
2017-06-28 Removed the pin description on some of the layouts
2017-06-29 Fixed SW_DPDT_x2 pin numbering and filter
    Unit B had incorrect numbering, preventing the symbol from being usable
    with real DPDT switch footprints. This gives the symbol the correct pin
    numbering so that no pins are shared between units.
    Additionally, I added an footprint filter to the same symbol.
2017-06-30 Added A, NC and K names to pin 1, 2 and 3 , made all lines 0.0254 mm wide
2017-06-30 Added LTC4002 symbols
    Standalone Li-Ion Switch Mode Battery Charger
    http://www.linear.com/product/LTC4002
2017-06-30 Removed footprint names from AP2204 symbol names
    Since KLC 2.0.4, the footprint name shouldn't be part of the symbol
    name. As such, I renamed the AP2204 symbols to match the new (lack of)
    rule.
2017-07-02 Removed LCD-016N002L.wings
2017-07-02 [new] Symbols for CPC1017N and ASSR-1218 solid state relays
2017-07-03 Fixed pin labels on DRV8825 breakout
2017-07-03 added default footprint, fixed footprint filters
2017-07-05 Edited pin side
2017-07-05 Fixed pin numbering of 2N7000/TP0610L/VP0610L
    All datasheets I could find for these parts showed SGD pin ordering,
    while the part had GSD ordering. The related SMD 2N7002 part does have
    GSD ordering, which is possibly why this was wrong.
    2N700:
    http://www.microchip.com/mymicrochip/filehandler.aspx?ddocname=en571380
    https://www.fairchildsemi.com/datasheets/2N/2N7000.pdf
    http://www.taiwansemi.com/products/datasheet/TSM2N7000K_C15.pdf
    https://media.digikey.com/pdf/Data%20Sheets/ST%20Microelectronics%20PDFS/2N7000,%202N7002.pdf
    https://media.digikey.com/pdf/Data%20Sheets/NXP%20PDFs/2N7000.pdf
    TP0610L/VP0610L:
    http://www.vishay.com/docs/70209/70209.pdf
2017-07-05 Fixed 2N700 pin length
    The gate pin was 210mil in length, this was reduced to 200mil and a
    short line was added to preserve the same looks. This fixes all KCL
    warnings for this component.
2017-07-06 SX1272/73 Added RESET Pin
    And changed RF_MOD/NC pin from Input to output according DS
2017-07-07 corrected INT pin on TCA9555 from output to open collector
    and removed some windows line endings
2017-07-07 trying again with the footprint filters
2017-07-07 cmos4000: update 4056 to satisfy current KLC
2017-07-09 Added ZXGD3006E6
    - 40V gate driver
2017-07-09 Add linear technologie libbs and LT3555 Led Driver componant
2017-07-09 Added ADS7830 and fixed specific footprint
2017-07-10 fixed new footprint
2017-07-10 cmos4000: Correct 4056
    1. Resize symbol
    2. Reorder pins
    3. Correct STROBE direction
    4. Update description and keywords
    5. Set more verbose footprint filters
2017-07-11 addded Footprint
2017-07-12 Moved the MCP141x gate drivers to the driver_gate library
2017-07-12 updated Pin Header models to scripted parametric Models
2017-07-12 Fized footprint filter
2017-07-12 cmos4000: 4543 - update footprint filters
2017-07-12 cmos4000: Update pin types of 4047
2017-07-12 cmos4000: Update footprint filters of 4047
2017-07-16 relays: add Panasonic JW2 relay
    based on AZ850-x
2017-07-17 added 3d model for USB_Micro-B_Molex_47346-0001
    Model is drawn by Obijuan (who gave the permission to use it)
    Models is adjusted for Kicad by Shack
2017-07-18 [fix] corrected footprint library for CPC 1017N symbol.
2017-07-18 ams: add CCS811 indoor air qualtiy sensor
2017-07-18 ams: fix pin type of SDA pin
2017-07-19 Pin 7 on 4029 (Cout) should be marked output instead of input.
2017-07-21 Added ADC/DAC pins
2017-07-21 added SOP-4_3.8x4.1mm_Pitch2.54mm as promised
2017-07-22 added CQ scripted C_Axial models correctly scaled and with materials
2017-07-23 Corrected the footprint path
2017-07-23 Add all the functions to pin names in PIC16F18325-I/SL
2017-07-23 Add footprint filters to PIC16F18325-I/SL
2017-07-23 Fixed pin order
2017-07-23 remove number of positions from terminal block footprint filter
    According to rule 4.12.iii, "Filters should not match the pin count."
    Also, filtering for 2pol, 3pol, etc. causes the filter to miss the
    newly added footprints that use a different naming convention:
    https://github.com/KiCad/Connectors_Terminal_Blocks.pretty/pull/11
    (e. g. TerminalBlock_Philmore_TB132_02x5mm_Straight)
2017-07-24 Add EuroCard 160mm x 100mm outlines with and without holes.
    [EuroCard160mmX100mm.kicad_pcb, EuroCard160mmX100mm.sch, EuroCard160mmX100mm_holes.kicad_pcb, EuroCard160mmX100mm_holes.sch]
2017-07-24 Added aditional x to footprint name
2017-07-24 Changed footprint list
2017-07-24 relays: center JW2 relay around origin
2017-07-25 added New CadQuery scripted Axial THT Caps with Material Properties
2017-07-26 Updated MANXXX with new 3D models and changed the footprint line distances
2017-07-26 CCS811: moved ams CCS811 to sensors
    fixed footprint field/fielter
2017-07-26 sensors: add ams ENS210 sensor
    relative humidity + temperature sensor
2017-07-26 sensors: add ams AS726X Spectral Sensing Engine
2017-07-26 Rename generic dual/quad opamps, remove singles, add pin numbers
2017-07-27 Moved holes to comply with EuroCard specs. Added keep-out lines. https://www.elma.com/-/media/general-web-content-files/resources/pdfs/us-corporate-dimensions-of-pcbs-d.ashx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
    [EuroCard160mmX100mm_holes.kicad_pcb]
2017-07-27 sensors: reorder pins of ens210
2017-07-27 sensors: relocate non connected pins for AS726X
2017-07-27 Added Texas PECL Driver/Reciever
2017-07-28 Added EA_T123A-I2C
2017-07-28 Added 7330 & Changed Footprint List
2017-07-29 Correct footprint for TLV320AIC23BxQE
2017-07-29 Update LM311 symbol, add LT311, LM319 Gnd pins to E type
2017-07-29 Fix LM4250 pin placement
2017-07-29 Added footprint to CR2013-MI2120
2017-07-29 Add SPX3819M5 regulator symbols
    Add all SPX3819M5 regulators in SOT-23-5 packages.
2017-07-29 Fix LTC6362xDD pin 9 type, shrink pin text offset
2017-07-29 Trimmed edges by .075mm to achieve +0.0/-0.3mm tolerance.
    [EuroCard160mmX100mm.kicad_pcb, EuroCard160mmX100mm_holes.kicad_pcb]
2017-07-31 added new scripted models for Tantal THT capacitors
2017-08-01 Added lib-table-entry for HDMI connectors
2017-08-01 change pin-types of all switches to passive
2017-08-01 Update SRV05 symbol and footprint
2017-08-03 Renamed Mechanical_Sockets to Connectors_IEC_DIN
2017-08-03 add CUI PD-30 connector
2017-08-04 removed old wings picoblade connector models
    have been replaced with the CQ based models from @poeschlr
2017-08-04 PD-30: add "power" and "DIN" keywords, to match footprint's keywords
2017-08-05 Cleanup of conn.lib: - moved PAL-symbols to new pld_pal.lib (these will need overhaul in a separate PR) - renamed PCI&ISA-bus "connectors" in a common style, updated descriptions - unified connector-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
2017-08-06 Changed pin 40 of DE 114
2017-08-06 Chnaged IOVDD type to power input
2017-08-06 Added pin 17
2017-08-06 Fixed foot print filter
2017-08-06 Maded VCC pin longer
2017-08-06 Fixed UC3525 DISCH pin type
2017-08-07 MCP45HVx1, Change I2C SCL pin to input and rename potentiometer pins.
2017-08-07 Add AD9852xSV EP pin, add AD9854
2017-08-08 Nudged left edge holes over 0.03mm to the right.
    [EuroCard160mmX100mm_holes.kicad_pcb]
2017-08-11 Overhaul ir.lib
    Changes
    - Updated all datasheet links to Infineon website
    - Added package type to all descriptions
    - Standardized all descriptions to '<description>, <voltage>, <drive current>, <package>
    - Set pin name offset to 20mil
    - Replaced '-' in FPfilter with '?'
    - Added other packages/pinouts for existing parts (IRS2186/IRS21864, IR2181/IRS21814, etc.)
    - Split IR2110/IR2113 into DIP and SOIC packages since the pinout is different (they were together!)
    - Figured out a standard pinout and symbol for the standard/generic (non-class D) drivers
    - Moved power pins to top and bottom of AUIPS* symbols
    - Stacked pins where possible
    - Used ALIAS instead of discrete symbols where pos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
2017-08-12 Renamed GDN to GND
2017-08-13 Update TL7705ACPSR footprint
2017-08-13 Moved to battery_management
2017-08-13 Fixed footprint
2017-08-13 Added socket to description
2017-08-13 Added socket description ot description
2017-08-13 Fixed GND
2017-08-13 Fixed VCC pin
2017-08-14 Fixes to footprint filter for KLC
2017-08-14 Improved descriptions for working temperature and voltage ranges
2017-08-14 Fix wrong voltage
2017-08-14 Remove temperature range from symbol names, use a wildcard instead
2017-08-15 make all files non-executable
    the only file permission git trackes is the execute bit. Some files in
    this library are marked as executable, but none should be.
    [raspberrypi-gpio.kicad_pcb, raspberrypi-gpio.sch]
2017-08-16 Modified SOIC filter
2017-08-16 Align with KiCad master, I hope
2017-08-16 Add KL0x, KL2x, some K20 devices
    Added all Kinetis KL0x and KL2x as well as 50-MHz, QFN-packed K20 devices.
2017-08-17 Make AD9910 EP pin visible
2017-08-17 Update IRS25751L pin positions and types
2017-08-17 Several Changes to LM25119
    Removed alias
    Split schematic into 3 Units
    Changed WQFN-32 Package name
2017-08-18 Correct KL26 pin placement
    Re-aligned KL26 pins for KL27 compatibility (added 100 mils vertical offset).
2017-08-18 Fixed Pin 1 marker
2017-08-19 Improvements to LM25119
    Switched pins betwene units to improve usability
    Moved reference and value outside of the symbol
2017-08-19 Revert "removed old wings picoblade connector models"
    This reverts commit 78ee284417d32f3428a596bbb01160e82e3efea3.
2017-08-19 fixed pin 1
2017-08-19 Foot print filter
2017-08-19 Fixed footprint filer
2017-08-19 Update battery_management.dcm
    Added $ENDCMP
2017-08-19 Update battery_management.lib
    Added ENDDRAW
    ENDDEF
2017-08-20 Updated foot print filter
2017-08-20 Fixed filter
2017-08-20 Added specific foot print
2017-08-20 TPIC6595 - Updated pin lengths and type, updated description and changed pin name offset
2017-08-20 TPIC6595 - Fixed stacked PGND pin
2017-08-21 added pin-count to description, replaced PDF-links with links to manufacturer
2017-08-21 Add KL4x, modify several descriptions
    - Added KL43 and KL46 subfamilies
    - Added Flex I/O and TSI to descriptions
    - Made USB features clearer ("Device")
2017-08-21 Hide pin names
2017-08-21 Removed old single row connectors
2017-08-21 Adding new script generated single row connectors
2017-08-21 Removing old dual row connector symbols with odd even pin numbering
2017-08-21 Adding the new dual row connectors.
2017-08-21 Removed old DIL and SIL connector footprints. (Dil footprints are replaced with conn_02x*_counter_clockwise connectors. SIL connectors are duplicates of conn_01x* connectors)
2017-08-21 Removed old screw terminal symbols.
2017-08-21 Adding the new scripted symbol for screw terminals.
2017-08-22 add Traco Power TMR 1 series
2017-08-22 Add MC34673
    Added NXP MC34673 Li-ion battery charger
2017-08-22 Removed duplicate 02x01 connector symbols.
2017-08-22 Removed outline from male/female connectors and removed unnecessary fill background flags from single row connectors.
2017-08-22 Removed unnecessary background fill from screw terminals
2017-08-22 Add MC34673, fix library
    - Added MC34673 Li-Ion battery charger
    - Fixed several symbols
2017-08-22 Added TCA9535 and TCA9555 in SSOP-24 and aliases; corrected Datasheet-Links in TCC9535 devices
2017-08-23 add PCF8883 and PCA8886
    PCA8886 is two PCF8883 in one housing. Schematic is a two part, each
    based on the PCF8883
2017-08-23 Fix several pin types, names
    - Changed SDA pins from OC to BIDI
    - Changed BQ78350's SCL pin from OC to BIDI according to datasheet (device can also act as master)
    - Changed names of MCP73871's VIN/VOUT pins according to datasheet
2017-08-23 Resaving with current kicad version to correct the line ordering of the file.
2017-08-23 Better footprint filter
2017-08-23 Update USB3300 component
    Fixed footprint filter to only match the correct package
    (1EP, 0.5mm pitch)
    Changed the component outline width to 10mil to pass KLC
2017-08-24 Stack VDD/VSS pins
    - Created pin stacks for VDD, VSS pins
    - Re-aligned supply pins
2017-08-27 Modified the FP filter
2017-08-28 74xx rework
    - remove all hidden power pins
    - power pins on unit for single units
    - power pins in separate block if multiple units
    - uniform width where possible (600 mil)
    - smaller logic symbols (300x300)
    - shorter pin length (150 mil)
    - fixed several errors in pinouts
    - compliance with KLC
    - background color and line width
    - no double inversions
    - footprint spec added
    - datasheet added
    - removed single gate ICs
    - clean up descriptions, keywords
2017-08-29 Add footprint and FPfilter for Lundahl LL1587
2017-08-31 Schematic symbol for RECOM R-78E-0.5 buck converters.
    https://www.recom-power.com/pdf/Innoline/R-78Exx-0.5.pdf
    checklib.py complains:
    Checking symbol 'R-78E5.0-0.5':
    Violating Rule 4.5 - Pin orientation
    Wherever possible, pins should be arranged by function
    Positive power pins should be placed at top of symbol
    But, this seems to be the same pin arrangement used by the other DC-DC
    converters.
2017-08-31 Add schematic symbol for OMRON G5LE-1 relays.
    http://www.omron.com/ecb/products/pdf/en-g5le.pdf
    Running "checklib.py -v -c G5LE-1 library/relays.lib" results in:
    Checking symbol 'G5LE-1':
    Violating Rule 4.10 - Part metadata
    Part meta-data is filled in as appropriate
    Component G5LE-1 has metadata errors:
    Unfortunately, it doesn't give any clue what the metadata error is.
2017-08-31 Add library symbol for through-hole WS2812 LEDs.
    There isn't a real datasheet for this device, although the product
    page is here:
    https://www.adafruit.com/product/1938
    This symbol is meant to be used with the existing footprint
    "LEDs:LED_D5.0mm-4", and the pinout is chosen accordingly. I don't
    think this symbol can be used for SMT WS2812 LEDs, because I believe
    the pinout is different.
2017-09-01 G5LE-1: use * as wildcard in footprint filter
2017-09-01 Change polyline to use less points, and draw outline with arc (OR gates); increase size of 4-input AND (74LS13); reduce pin length on 74LS107 and other flip-flops; center output pins (51,55,122); fix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
2017-09-02 Schematic symbol for Adafruit HUZZAH ESP8266 breakout.
    https://www.adafruit.com/product/2471
2017-09-03 Adafruit HUZZAH ESP8266 breakout: implement PR suggestions.
    - put a line over RST and made it non-inverted
    - decreased pin length to 150 mils (3.810 mm)
2017-09-04 Incorporated feedback. 1. Updated socket strip footprint. 2. Moved socket strip to bottom of board, pin 1 inward. 3. Corrected pinout. 4. 5. removed unused libraries.
    [raspberrypi-gpio-40pin.kicad_pcb, raspberrypi-gpio-40pin.sch]
2017-09-04 Update LL1587 to use the existing footprint
2017-09-04 added mechanical.lib association to schematic.
2017-09-05 Neopixel_THT: footprint field should be empty
2017-09-05 Fix footprint filter for Inversense sensors
2017-09-05 Update footprints and FPfilters
2017-09-05 Import improved version of MAX31820 plus four aliases into sensors.lib.
2017-09-05 Import improved version of MAX31820PAR plus three aliases into sensors.lib.
2017-09-05 Import improved version of MAX31826 into sensors.lib.
2017-09-05 Add footprint to MAX31820 and MAX31820PAR.
2017-09-05 Add missing NC pin to MAX31820PAR.
2017-09-05 Fix TSIC206/306 symbols.
    - Split symbol in two variants (different pinouts)
    - Fix footprint filters
    - Add NC pins
2017-09-05 Add missing NC pin to MAX31826 in sensors.lib.
2017-09-05 Add DS1825 as alias of MAX31826 in sensors.lib.
2017-09-05 Add DS18B20U to sensors.lib.
2017-09-05 Fix pin positions in DS18B20U.
2017-09-05 Add DS1822Z to sensors.lib.
2017-09-05 Add DS1621S to sensors.lib.
2017-09-05 Add DS1621 to sensors.lib.
2017-09-05 Add DS1621V to sensors.lib.
2017-09-05 Import old version of DS28EA00 into sensors.lib.
2017-09-06 Fix default footprint for TPA5050
2017-09-07 - remove all hidden power pins - power pins on unit for single units - power pins in separate block if multiple units - uniform width where possible (600 mil) - smaller logic symbols (300x300) - shor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
2017-09-07 microchip_dspic33dsc: Fix DSPIC33FJ64GP306A-IMR footprint issues
2017-09-08 Add Microchip MCP2200 USB-to-UART serial converter
2017-09-08 All change
    Shorten pin
    Move REFDES and NAME
    Rename #MSOP => #xMSE && #QFN => #xUD
    Space separated keyword
    Improve Description
2017-09-09 Add UDA1334ATS
    Schematic library for the low power audio DAC by NXP
2017-09-09 added series of solder pins (3D models)
2017-09-09 Added DRV8833, L297 and TB6612FNG to motor_drivers
2017-09-10 added smaller 1.3mm hole pin
2017-09-10 added testloop 3D model (connecting 2 holes)
2017-09-10 added 1mm pinheader 3D models
2017-09-11 devices.lib: opened and saved with kicad, no changes
2017-09-11 showing pin numbers for POT and POT_TRIM
2017-09-11 POT_Dual_Separate: changed pin numbers so they match to POT_Dual
2017-09-11 POT_Dual_Separate: set pin names the same as pin numbers
2017-09-11 Fixed pin numbering
2017-09-12 bq25504 first cut
2017-09-12 updated description, added ground pins
2017-09-12 library/opto.lib
    Fixed a FP filter for SFH617A-2X009T
2017-09-12 Fix SN65HVD230/231 Rs pin type
2017-09-13 Schematic symbols for TLC5947 LED controller.
    http://www.ti.com/lit/ds/symlink/tlc5947.pdf
2017-09-13 Added specific housing for TB6612FNG and improved layout
2017-09-13 Change pin lengths to 150 mil
2017-09-13 Capitalize pin names
2017-09-13 Change VCC to power input
2017-09-13 microchip_dspic33dsc: Change pin placement to comply with KLC 4.1
2017-09-13 Fixed ground pad pin number Specified missing footprint and housing
2017-09-13 HTSSOP-56-1EP_6.1x14mm_Pitch0.5mm scripted 3D model
2017-09-14 Improved new footprint names
2017-09-14 Add schematic symbol for AD-121F2 RGB 7-segment display.
    http://usasyck.com/products/AD-121F2_cat_e.pdf
    One thing that the datasheet doesn't make obvious is that the
    no-connect pins (7, 8, and 12) are not physically present. For this
    reason, I am leaving those pins out of the schematic symbol and
    footprint, rather than modeling them as no-connect pins.
2017-09-15 AD-121F2: add footprint field
2017-09-15 TLC5947: add footprint field
2017-09-16 Let KiCad sort the library... Nothing done yet!
2017-09-16 fixed missing pins and pin length
2017-09-17 Clean up for OPA330xxD Renamed LM6171 to LM6171xxN (DIP-8) Added standard footprint for MCP601-xP Added standard footprint for OPA333xxD Cleaned footprint filter of MCP601-xP to filter only DIP-8 Cle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
2017-09-17 Changes for OPA330xxDBV Renamed MCP6001 to MCP6001-OT (SOT-23-5) Renamed MCP6561 to MCP6561-OT (SOT-23-5) and changed tags to single comparator Renamed TS881 to TS881xLx (SOT-23-5) Renamed TSV911ILT 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
2017-09-17 Added entry for Connectors_TestPoints
2017-09-18 Renamed after review of foot print
2017-09-19 Fixed pin numbering on the INA138/INA168 schematic symbol
2017-09-19 modified hf3-0x default footprint
2017-09-19 Added AP2127K fixed-output LDO regulators in SOT-23-5 package.
    https://www.diodes.com/assets/Datasheets/AP2127.pdf
    This is failing the KLC script, but I don't think any of the other
    regulators have their power input pin on the top, either.
    Checking symbol 'AP2127K-3.3':
    - Pin VIN (1) @ (-300,100)
    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
2017-09-19 Add footprint filters for the Barrel_Jack symbol.
    This adds two filters:
    Barrel*Jack*
    BARREL*JACK*
    So that it will match:
    BARREL_JACK
    Barrel_Jack_CUI_PJ-036AH-SMT
    Barrel_Jack_CUI_PJ-102AH
2017-09-20 Adjusted symbol size, removed pin names
2017-09-20 Add aliases for AP2127N3-1.2 and AP2127N3-1.5.
    We're using the same footprint for both the SOT-23 package and the
    SOT-23-3 package. See discussion in the PR:
    https://github.com/KiCad/kicad-library/pull/1634
2017-09-20 Several adjustable regulators had "fixed" as a keyword, or vice-versa.
    This commit corrects that.
2017-09-20 AP2127N3: Use TSOT-23 footprint for "SOT-23-3" variants.
    It was determined in the discussion that this was a better fit.
2017-09-21 fixed wrong footprint-names: SOT89-3_Housing has been renamed to SOT-89-3
2017-09-21 Let KiCad sort the library, nothing done yet.
2017-09-21 Add LM2937 to regul.lib LM2937xMP, SOT-223 as alias for SPX2920M3-3.3_SOT223 LM2937xS, TO-263 as alias for SPX2920T-3.3_TO263 LM2937xT, TO-220 as alias for LM7805_TO220
    Changed standard footprint of SPX2920T-3.3_TO263 from "TO_SOT_Packages_SMD:TO-263-3Lead" to "TO_SOT_Packages_SMD:TO-263-3_TabPin2".
    Yes, GND is at pin 2, see last page of https://www.exar.com/files/ApplicationNotes/LDOThermal.pdf
2017-09-21 Add the Nidec Copal SH-70x0 series of rotary coded switches.
    https://www.nidec-copal-electronics.com/e/catalog/switch/sh-7000.pdf
    This is failing KLC:
    Checking symbol 'SW_Coded_SH-7010':
    Violating EC01 - Extra checking
    General pin number checking
    pin: C number C is not valid, should contain at least 1 number
    However, the datasheet does not give any other pin numbering scheme.
2017-09-21 Add BQ24012 Single-Chip Li-Ion Charge Management IC
2017-09-21 Back to large symbal size, smaller pin label distance
2017-09-22 Add K20/K26 devices - Added MK20FN1M0VMD12 - Added MK20FX512VMD12 - Added MK26FN2M0VMD18 - Slight visual modifications to other symbols
2017-09-23 fixed SOT-89-5 footprint naming
2017-09-23 Added entry for IDC connectors
2017-09-24 Add Silicon Labs Si7020-A20 Temperature & Humidity Sensor
2017-09-24 Changes as requested; matching footprint to follow
2017-09-25 Removed wire_connections_bridges entry
2017-09-25 microchip_dspic33dsc: Add a hidden pin for the exposed pad
2017-09-26 library:regul.lib:fix some footprint name
2017-09-26 - removed NC-pins from references (especially when 2/3-pin reference is in 8-pin package) - used pin-stacking where it makes sense - split REF200U into 3 units - reworked REF3212AMDBVREP - moved NC-p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
2017-09-26 made footprint/datasheet fields invisible
2017-09-28 Changed ZPDxx Footprint field from "Diodes_THT:D_DO-35_SOD27_Horizontal_RM10" to "Diodes_THT:D_DO-35_SOD27_P10.16mm_Horizontal" in diode.lib
2017-09-28 Added pin number in FP
2017-09-29 reworked ADP2108-family (added voltage-variants fixed footprint+FPFilter)
2017-10-01 Removed pin specific information from FP
2017-10-01 modified the footprint filters for esp8266EX
2017-10-01 corrected errors in footprint filters for esp8266EX
2017-10-01 added a bar over EXT_RSTB at pin 32and changed CHIP_EN to CHIP_PU at pin 7
2017-10-02 move Kinetis devices from LPC lib to Kinetis lib (except KL0x)
2017-10-02 move Kinetis KL0x devices from MCU_NXP_LPC.* to MCU_NXP_Kinetis.*
2017-10-02 ac-dc: Add TMLM04103 power supply
2017-10-02 Update SiLabs "Busy Bee" microcontrollers, based on feedback from PR.
    I received some feedback from @evanshultz in my original PR for the
    EFM8BB1 after it had already been merged.
    I have made the following changes:
    * Use the full manufacturer part number (and therefore, make an alias
    for each part number).
    * Moved NC pins inside the symbol.
    * Put VDD pin in the middle of the top edge.
    * Put reference designator to the left of VDD, and value to the right
    of VDD.
    I did not stack the GND pins. Unless that is absolutely required, I
    would prefer not to do it, because I like being explicit about what
    I'm connecting.
2017-10-04 Rework BQ76940
    - Corrected capitalization (pin VC10X)
    - Rearranged pins to better accommodate KLC (ctrl/'input' pins on left side, 'outputs' on right side)
2017-10-04 Add LTC3555(-x) and LTC3553
    - added LTC3555, LTC3555-1, LTC3555-3
    - added LTC3553
    - changed BQ76940 SDA pin to BIDI
2017-10-04 Correct pin types, add FP
    - changed GND to power input
    - add default FP and improve FP filter for LTC3553
2017-10-04 Add GV5-2 Omron relay series symbol
2017-10-04 Rename lib
    - applied KLC capitalization rule to `battery_management.*`
2017-10-04 opto: Fix pin numbering in QSE159
2017-10-04 reworked ADP5054 (internal "schematic", stacked pins, footprint/FPFilter, ...)
2017-10-04 EFM8BB10F8G-A-QFN20: Prepend "SiliconLabs_" to footprint name.
    In the footprint PR, it was determined that "SiliconLabs_" should be
    prepended to the footprint name for the QFN-20 package, due to the
    unusual corner pads. This updates the schematic symbol to use the new
    footprint name.
2017-10-04 removing th "+" sign nearby pin 1 of G5V-2 relay
2017-10-05 FInal renaming before bed
    I promise
2017-10-05 adding omron G5V-2 relay 3d model
2017-10-05 Update TO-220 and HSOP-20 footprint names
2017-10-05 Update MLPQ/PQFN footprint names
2017-10-06 Add Cortex Debug Connector
    Added ARM's standard Cortex-M Debug Header (http://infocenter.arm.com/help/topic/com.arm.doc.faqs/attached/13634/cortex_debug_connectors.pdf)
2017-10-06 Fix FP filters
    Fixed FP filters: Replaced underscore and minus with question marks
2017-10-06 Fix pin types, FP filters
    - Changed pin types to reflect debugger
    - Changed FP filters to match all kinds of IDC and pin headers
2017-10-06 Fix FP filters, change pin type
    - Reduced specific filters to more generic ones
    - Changed nRESET to open-collector
2017-10-06 Fixed pin spacing
2017-10-07 added Bosch sensors library, with BME680 and BME280
2017-10-07 Added SO-20_12.8x7.5mm_Pitch1.27mm
2017-10-07 Add Q_DUAL_PNP_PNP_C1B1B2C2E2E1
    The specific device I have in mind is DMMT5401, but this should work
    for any dual PNP transistor with the pinout C1B1B2C2E2E1.
    https://www.diodes.com/assets/Datasheets/ds30437.pdf
2017-10-07 Aligned a pin to 100 grid
2017-10-09 fixed pin-label-offset of ADP1108
2017-10-09 added NC pin to BD9001F
2017-10-09 fixed up BD9xxx-series of devices from Rohm (package, pin-label-offset,...)
2017-10-09 fixed CRE1xxxx3C (added internal drawing of isolation barrier, corrected footprint link/FPFilter)
2017-10-09 fixed CRE1xxxxxx-devices (footprints, FPFilters, new footprints, missing variants, ...)
2017-10-09 fixed MAX1044/ICL7660/LMC7660/LTC7660 (footprints/FPFilters/symbol/...)
2017-10-10 Fixed missing pin, datasheet, pin lenghts, pin properties
2017-10-10 Fixed duplicated pin. Whoops
2017-10-10 reworked BD9G341EFJ (package/..., package from https://github.com/KiCad/Housings_SOIC.pretty/pull/34)
2017-10-10 removed pin numbers from FP filter
2017-10-10 reworked ISL8117 (footprint, added QFN-variant, ...)
2017-10-10 reworked L5973D (symbol size, footprint)
2017-10-10 Add Analog Devices ADP7142AUJZ LDO regulator
2017-10-10 Add Analog Devices ADP7182AUJZ LDO regulator
2017-10-11 Change Vbat_sense line of MCP72871 to input instead of bidirectional. The datasheet claims it is an I/O, but the block diagram shows it as input only. ERC complains if you use it as intended (bidi ca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
2017-10-11 Updated filter per realization there is no thermal pad
2017-10-11 reworked LM2575/LM2576 (footprint, text location, pin-label-offset, descripton/tags...)
2017-10-11 reworked LMR10510XMF, LMR10510YSD, LM2731XMF LM2731YMF LM27313XMF LM2733XMF LM2733YMF LM2735XMF LMR10510YMF LMR62014XMF LMR62421XMF LMR64010XMF (symbol, package, description, ...) corrected LMR62421X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
2017-10-11 reworked LM3407MY (symbol, PAD, footprint, description)
2017-10-11 reworked LM3578 series (symbol, footprints, description, datasheet)
2017-10-11 reworked LM3670MF (footprint, description, symbol)
2017-10-11 reworked LM5006MM (footprint, description, symbol)
2017-10-11 reworked LM5007/LM5008/LM5009 (symbol, footprint, description, datasheet, ...)
2017-10-11 rworked LM5017 (footprints, symbol, datasheet, description)
2017-10-11 reworked LM5165 (split by adjustable/fixed due to pin-names, package, description)
2017-10-12 added default footprint LGA-8_2.5x2.5mm_Pitch0.65mm
2017-10-12 corrected the FP filters, LGA-8_2.5x2.5mm_Pitch0.65 for both
2017-10-12 Added a number of obselete motorola parts
2017-10-12 Fix decription for Q_Photo_NPN_EC.
    Q_Photo_NPN_EC had the description "Phototransistor NPN, 2-pin (C=1, E=2)".
    I think it should be the other way around.
2017-10-13 removed DIP from FP filter, updated keywords, fixed typos in description
2017-10-13 replaced '?' with '*' in FP Filter.
2017-10-13 Add symbol for MCP3021 10-Bit A/D Converter with I2C Interface.
    http://www.microchip.com/mymicrochip/filehandler.aspx?ddocname=en011709
2017-10-13 reworked LT1108-family (split by package+voltage, pin-names, symbol, description) changed ADP1108-family to be ALIAS of LT1108
2017-10-14 reworked LT137x-family (symbol, footprint, variants, datasheets, ...)
2017-10-14 fixed LT1945 (pin-stacking, footprint, description)
2017-10-14 reworked LT3430 (missing variant, footprint https://github.com/KiCad/Housings_SSOP.pretty/pull/46, symbol, description)
2017-10-14 reworked LT3755-family (description, pin-label-offset)
2017-10-14 reworked LT3757 (Symbol, missing variants, footprints, description, ...)
2017-10-14 renamed LTC1307->LT1307 (correction, reworked, sybol, missing variant, footprint-filters, ...)
2017-10-14 reworked LTC1878EMS8 (symbol, footprint, description, datasheet, ...)
2017-10-14 reworked LTC3429 (footprint, description, ...)
2017-10-14 reworked LTC3442 (symbol, footprint, description, ...)
2017-10-14 reworked LTC3525 (pin-location/symbol, footprint, FPFilter)
2017-10-14 reworked LTC3630 (symbol, footprint, missing variants, ... see https://github.com/KiCad/Housings_SSOP.pretty/pull/47 for footprint)
2017-10-14 reworked LTC3886 (footprint, removed fields, ... footprint available from: https://github.com/KiCad/Housings_DFN_QFN.pretty/pull/71)
2017-10-14 reworked LTC3890 (footprint, removed fields, description)
2017-10-14 reworked LTC3890-1 (removed fields, footprint available from https://github.com/KiCad/Housings_SSOP.pretty/pull/48)
2017-10-14 Add USB_B_Micro and USB_B_Mini schematic symbols.
    Strangely, there are already some footprints for USB micro connectors
    in the Connectors_USB library:
    https://github.com/KiCad/Connectors_USB.pretty
    but I couldn't find any schematic symbols for a micro USB connector.
    (USB micro B and mini B connectors have an additional pin, the ID pin,
    which is not present in the traditional USB B connector, so the
    existing USB_B symbol can't be used.)
    So, I have added a symbol USB_B_Micro, based on the existing USB_B
    symbol. I've also added USB_B_Mini as an alias for USB_B_Micro,
    because the micro and mini connectors have the same pinout.
    The pinout is here:
    http://pinouts.ru/PortableDevices/micro_usb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
2017-10-14 Add LTR-303ALS-01 ambient light sensor.
    http://optoelectronics.liteon.com/upload/download/DS86-2013-0004/LTR-303ALS-01_DS_V1.pdf
2017-10-15 implemented footprint renames
2017-10-15 fixed several footprint and FPFilter naming problems (SC-70*->SC?70*..., TO_SOT_Packages_SMD:SC-70->TO_SOT_Packages_SMD:SOT-323_SC-70..., TO_SOT_Packages_SMD:TO-252-2Lead->TO_SOT_Packages_SMD:TO-252-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
2017-10-16 pspice: Revert diode pins to match the Spice node order
2017-10-16 Rename footprint for LTR-303ALS-01 symbol.
2017-10-16 MCU_ST_STM32: Correct descriptions of STM32F446Zxx
2017-10-16 Updated RFM69HW with new footprint name
2017-10-16 Fix RFM69HW footprint filter hyphen
2017-10-17 MCU_ST_STM32: Add STM32F722/732 MCU in LQFP64 package
2017-10-18 Add symbol for Broadcom APDS-9301 ambient light sensor.
    https://docs.broadcom.com/docs/AV02-2315EN
2017-10-18 AVR-ISP-6: Replace symbol
    The original symbol was a graphical representation of an IDC shrouded
    header, with the pin connection points inside the shroud and pin labels
    outside (aligned so that wires would go through the text).
    This replaces the symbol with a more standard filled box, with pin names
    on the inside and pins on the outside. It uses logical grouping of the
    pins (VCC at the top, GND at the bottom) instead of following the
    physical layout and adds filters for the most commonly used footprints
    (IDC header and generic pin header).
2017-10-18 memory: Reduce pin lenght in M95256-WMN6P
2017-10-18 sensors: Add LM75CIM temperature sensor
2017-10-18 Added VSSOP-8_3.0x3.0mm_Pitch0.65mm
2017-10-19 sensors: Rename LM75CIM to LM75C
2017-10-19 sensors: LM75C update description
2017-10-19 sensors: LM75C update footprint filters
2017-10-19 sensors: Add LM75B as an alias
2017-10-19 Update description and footprint filter as requested
    Description changed to "Precision Thermocouple to Digital Converter with
    Linearization, TSSOP-14"
    Forrprint filter to "TSSOP*14*4.4x5mm*Pitch0.65mm*"
2017-10-21 Add symbols for Parallax Propeller microcontroller.
    https://www.parallax.com/sites/default/files/downloads/P8X32A-Propeller-Datasheet-v1.4.0_0.pdf
2017-10-21 Added SW_MEC_5G and LED variants
2017-10-21 reworked MAX5035 family (wrong pin-type LX, removed high-temp variants, description, symbol)
2017-10-21 reworked MC33063-family (symbol, missing variants, footprints, description, ...)
2017-10-21 reworked MCP16301 (symbol, pin-type, description)
2017-10-21 reworked MCP16331 (symbol, pin-type, naming without -...)
2017-10-21 reworked MIC2177 (datasheet, symbol, pin-stacks, description...)
2017-10-21 reworked NID60-series (symbol, stacked-pins, footprint, FPFilter, description) added NID30-series (footprint available from https://github.com/KiCad/Converters_DCDC_ACDC.pretty/pull/25)
2017-10-21 reworked NXE2-series (NC-pin location, description, ...)
2017-10-21 removed very obsolete PT6100 (no footprint, no description available anymore ...)
2017-10-21 Added Foot print name
2017-10-21 reworked R78-Zxx-yy series from RECOM (symbol, added missing variants, footprints from https://github.com/KiCad/Converters_DCDC_ACDC.pretty/pull/26)
2017-10-21 Add Johansen chip antenna
2017-10-21 Add symbol for MAX6971 LED driver.
    http://datasheets.maximintegrated.com/en/ds/MAX6971.pdf
2017-10-22 Move Parallax Propeller to its own library.
2017-10-22 The DIP version of the Propeller has two VDD pins and two VSS pins.
2017-10-22 reworked ST1S10 family (footprints, description, symbols...)
2017-10-22 reworked ST1S14PHR (symbol, missing PAD-pin, footprint, description, ...)
2017-10-22 reworked Traco TEN20-series (symbol, isolation barrier, pin-position, description, ...)
2017-10-22 reworked TL497 family (symbol, pin-types, description, FPFilters, ...)
2017-10-22 reworked TPS5431 (missing NCs, pin-types, description, footprint from https://github.com/KiCad/Housings_SOIC.pretty/pull/35...)
2017-10-22 reworked TPS54340/TPS54360 (footprint, pin-types, description...)
2017-10-22 reworked TPS6050xDGS (pin-types, description, FPFilter, ...)
2017-10-22 reworked TPS6120x (symbol, pin-location, description, footpritns, see https://github.com/KiCad/Housings_SON.pretty/pull/19)
2017-10-22 Removed Antenna.lib, added Antenna_Chip to device.lib
2017-10-22 reworked TPS62xyz (missing variants, footprints, FPFilters, split by package, symbol, pin-types, description, ...)
2017-10-22 reworked TPS6217xDQC (description, footprint from https://github.com/KiCad/Housings_SON.pretty/pull/20 ...)
2017-10-22 Changed Antenna_Chip to use a resonator symbol
2017-10-22 Reduce pin length, text offset and body width of MCP45HVx1.
2017-10-23 rfcom: Update footprint of ESP-12E
2017-10-23 Copy connector shape from USB_OTG to USB_B_Micro.
    I recently added the USB_B_Micro symbol (and an alias, USB_B_Mini). I
    hadn't noticed that there was already a similar USB_OTG symbol.
    However, the two need to remain separate, because USB_OTG has VBUS and
    GND marked as power inputs, while USB_B_Micro has them as power
    outputs.
    This commit makes USB_B_Micro identical to USB_OTG, except for the
    direction of the power pins. Specifically, it copies the connector
    shape from USB_OTG to USB_B_Micro. (I had been too lazy to draw the
    connector shape when I created USB_B_Micro.)
2017-10-24 LED: Add CLV1L-FKB
2017-10-24 LED: CLV1L-FKB remove trademark symbol from description
2017-10-24 fixed several swicthes (wrong normally settings) + added DG41x-variants from Maxim and other companies, as Maxim does not have the separate Vlogic pin!
2017-10-24 added/reworked DG9421/DG9422 (package posted as https://github.com/KiCad/Housings_SSOP.pretty/pull/51)
2017-10-25 reworked FSA3157/NC7SB3157 (symbol, ...footprint from https://github.com/KiCad/Housings_SON.pretty/pull/21)
2017-10-25 reworked TS5A3159/TS5A3160 (split by footprint, added missing variants, description, symbol, footprint from https://github.com/KiCad/Housings_BGA.pretty/pull/26)
2017-10-25 rework HI524 (symbol, description, datasheet, footprint)
2017-10-25 moved LCC110 to opto.lib and reworked symbol (footprint, symbol, ...)
2017-10-26 #IM fixed power-pin stack
2017-10-27 update LTC2309
    stack GND and VDD pins allowing for same schematic on both chips.
    Minor changes to adhere to KLC.
2017-10-28 Added 3D models for dip switches
2017-10-29 Add TDA1308
    Schematic library for the class-AB stereo headphone driver by NXP
2017-10-29 Rename Cortex Debug Connector, add FP filter
    - Renamed Cortex Debug Connector from `Conn_ARM_Cortex-Debug` to `CMP Conn_ARM_JTAG_SWD_10`
    - Added FP filter `Conn*:*_2x*` for KiCad v5
2017-10-30 Updated leg and pad size
2017-10-30 pspice: Add MOSFET symbols
2017-10-31 Add symbol LED_BGRA.
    This is the pinout used by "Piranha" RGB LEDs. See that pull request
    for more information.
2017-11-01 Add "LED*" footprint filter to LED symbols in "device" library.
    Also:
    * Added "~" datasheet to LED symbols to suppress KLC errors.
    * Corrected cases where fields 2 and 3 were not invisible.
    Did not attempt to correct other pre-existing KLC errors. (Pin placement.)
2017-11-02 Move footprint name more to the right.
2017-11-02 Oscillators: Fix pin offset in SG-3030CM
2017-11-02 Separate power pins on generic opamps
2017-11-03 Oscillators: Rename SG3030CM footprint to comply with KLC
2017-11-04 Add TI OPA356 and OPA2356 operational amplifiers
    They use the same pinout as existing devices, so they are just new
    aliases.
2017-11-04 Added 3d part for Bosch LGA-8_2.5x2.5mm_Pitch0.65mm package, BME280 and BME680
2017-11-04 Corrected vent hole position, corrected marker pad position, pad numbering starts clockwise from right side
2017-11-05 fixed D-SUB FPFilters for new footprints
2017-11-06 Added the Analog Devices ADP2302ARDZ
2017-11-07 Added the Microchip MCP1825S 500mA LDO Regulator
2017-11-07 Fixed keywords, modified pin name offset, fixed pin type (FAN3268).
2017-11-07 Clearing an error in STM32L071/STM32L072 loading libs
2017-11-08 Add "T" 3-pin net tie
2017-11-09 Add Allegro current sensors
2017-11-10 Added Alias
    Alias for different isolation voltages
2017-11-11 Fix footprint filter
2017-11-12 MCU_Texas_MSP430: update description
    - do not duplicate part name (KLC 3.0.2 S6.3)
    - append simplified footprint name (KLC 3.0.2 S6.3)
2017-11-12 MCU_Texas_MSP430: update documentation file
    Always use a symlink based on the actual part number, even if multiple
    devices share the same data sheet.
2017-11-12 Add TPS2592xx
    Schematic library for the 5V/12V eFuse protection switch by TI
2017-11-14 Add TPS22929D power distribution switch
2017-11-16 Fixed ground pin alignment
2017-11-17 Microchip: SY89312V
    3.3/5V, ECL/PECL 4GHz x2 clock divider
    Documentation:
    http://ww1.microchip.com/downloads/en/DeviceDoc/sy89312v.pdf
2017-11-17 fixed library version to make these workable with KiCAD 4.0.7 (see https://github.com/KiCad/kicad-library/issues/1838)
2017-11-18 changed model name as per footprint, rotated 90 degree CCW, ofset 0,0,0
2017-11-18 Add Analog Devices ADP5070/5071 switching regulators
2017-11-18 Changed pin order
2017-11-18 fixed several issues in transistors.lib/dcm: - unified naming/description - fixed some packages (e.g. TO-220-variants had wrong names) - fixed wrong BF245/244 symbols (https://github.com/KiCad/kicad-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
2017-11-19 - removed non-existent device from DCM (that device really is not produced!) - fixed one description (package type)
2017-11-20 fix STM32F334 MCU family descriptions
2017-11-21 Merging from Master (#7)
    * reworked MAX77x (datasheet, symbol, missing variants, description ..)
    * reworked MC33063-family (symbol, missing variants, footprints, description, ...)
    * reworked MC34063 family as alias to MC33063 family
    * reworked MCP16301 (symbol, pin-type, description)
    * reworked MCP16311/2 (symbol, description, name without -, ...)
    * reworked MCP16331 (symbol, pin-type, naming without -...)
    * reworked MCP1640 family (symbol, naming wiothout -, ...)
    * corrected some descriptions
    * reworked MCP165x family (symbol, description)
    * reworked MIC2177 (datasheet, symbol, pin-stacks, description...)
    * added fixed-output variants of MIC2177
    * added MIC2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
    [EuroCard160mmX100mm.kicad_pcb, EuroCard160mmX100mm.sch, EuroCard160mmX100mm_holes.kicad_pcb, EuroCard160mmX100mm_holes.sch, raspberrrypi_hat.kicad_pcb, raspberrrypi_hat.sch, raspberrypi-gpio-40pin.kicad_pcb, raspberrypi-gpio-40pin.sch]
2017-11-21 Addit the Decawave DWM1000 schematics in Decawave.lib
2017-11-21 stm32f334: fix KLC
2017-11-22 Add a +10V power symbol to match the existing -10V one
2017-11-22 Add a -9V power symbol to match the existing +9V one
2017-11-23 Add simple internal schematics
2017-11-23 Added HDC1080 humidity sensor
2017-11-23 Addressing S5.2 updating filter
2017-11-23 Addressing S5.2 updated filter
2017-11-23 Updated filter to use *
2017-11-23 Updated filter
2017-11-23 Updated filter to end in *
2017-11-23 Updated footprint filter
2017-11-25 Fix Pin Alignment
2017-11-27 Add new symbol libraries to default symbol library table.
    Missing libraries:
    - Decawave.lib
    - RF_Bluetooth.lib
    - Sensor_Humidity.lib
2017-12-03 regul: update MIC550x
    - move EN pin to left side
    - update description / keywords / datasheet
    - update footprint and footprint filter
    - add new alias MIC5501-3.0YM5
2017-12-14 Fix "KiCad Website" link in README
2017-12-18 Added fourth pin to MCP1825S
2017-12-19 Revert "Added fourth pin to MCP1825S"
2018-01-20 Declare kicad-library as legacy
